danhcln/AIOT-BLACK-BOX/Hình ảnh minh họa.png

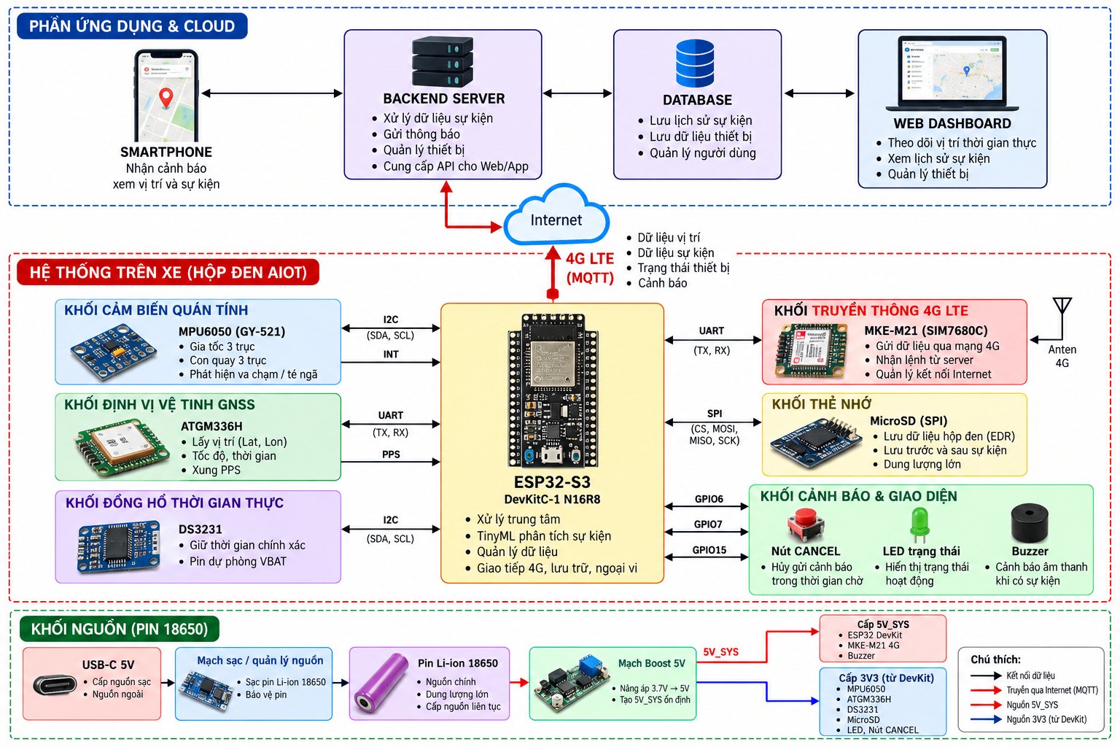
Hình ảnh minh họa.png
