danhcln/AIOT-BLACK-BOX/Hình ảnh linh kiện/Micro SD/1794204268884_198069978360956581_1780654779979847084_3c29c5070fa32b94e95acbb08c00777d.jpg

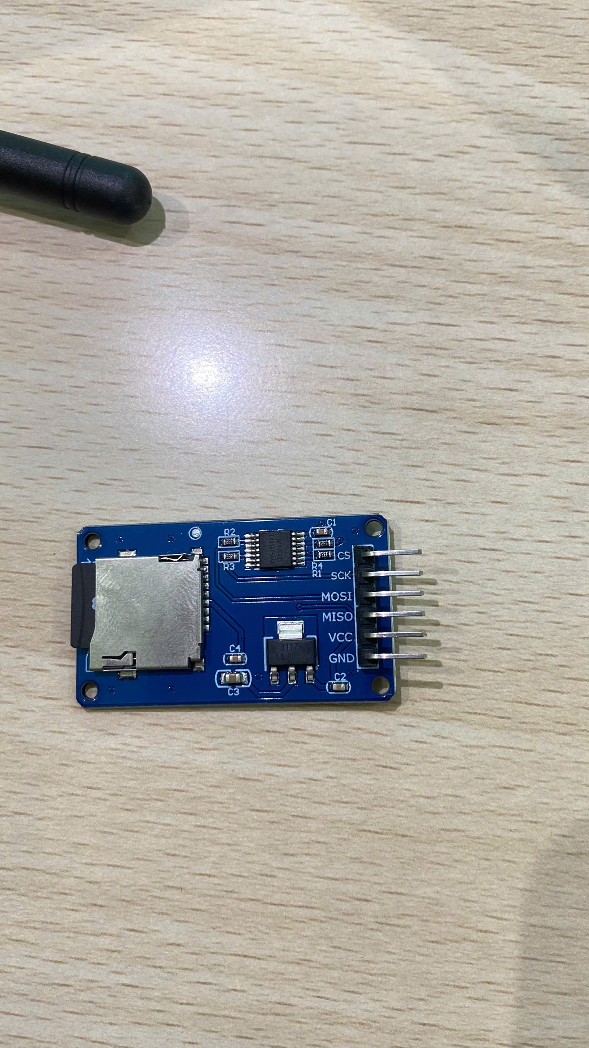
Hình ảnh linh kiện/Micro SD/1794204268884_198069978360956581_1780654779979847084_3c29c5070fa32b94e95acbb08c00777d.jpg
