danhcln/AIOT-BLACK-BOX/PCB_AIOT_BLACKBOX/AIOT_BLACKBOX_MAINBOARD_REV1/GATE_3_ROUTING/DRC_ROUTING_REPORT.txt

** Drc report for AIOT_BLACKBOX_MAINBOARD_REV1.kicad_pcb **
** Created on 2026-11-10T17:07:30 **
** Report includes: Errors, Warnings, Exclusions **

** Found 5 DRC violations **
[silk_overlap]: Silkscreen clearance
    Rule: board setup constraints silk; warning
    @(124.0000 mm, 48.4000 mm): Segment of JMP5 on F.Silkscreen
    @(124.0000 mm, 46.0000 mm): Reference field of JMP5
[silk_over_copper]: Silkscreen clipped by solder mask
    Local override; warning
    @(126.0000 mm, 102.2000 mm): Rectangle on F.Silkscreen
    @(151.0000 mm, 111.6700 mm): PTH pad 1 [Net-(J1-MOSI)] of JMP1
[silk_over_copper]: Silkscreen clipped by solder mask
    Local override; warning
    @(146.5000 mm, 63.0000 mm): Reference field of R5
    @(145.0000 mm, 61.7300 mm): PTH pad 1 [Net-(U1-GPIO6)] of JMP3
[silk_over_copper]: Silkscreen clipped by solder mask
    Local override; warning
    @(96.0000 mm, 88.5000 mm): PCB text '[ZONE 4: IMU CENTER (MPU6050) +X UP / +Y LEFT]' on F.Silkscreen
    @(112.0000 mm, 88.4200 mm): PTH pad 2 [/I2C_SDA_GPIO8] of JMP4
[silk_over_copper]: Silkscreen clipped by solder mask
    Local override; warning
    @(104.0000 mm, 42.0000 mm): PCB text 'AIOT SMART BLACKBOX - MAINBOARD REV1 (1-LAYER B.Cu)' on F.Silkscreen
    @(124.0000 mm, 42.1900 mm): PTH pad 2 [Net-(U1-GPIO6)] of JMP5

** Found 18 unconnected pads **
[unconnected_items]: Missing connection between items
    Local override; error
    @(50.0000 mm, 40.0000 mm): Zone 'GND_COPPER_POUR_BCU' [GND] on B.Cu, priority 0
    @(50.0000 mm, 40.0000 mm): Zone 'GND_COPPER_POUR_BCU' [GND] on B.Cu, priority 0
[unconnected_items]: Missing connection between items
    Local override; error
    @(144.3500 mm, 104.0000 mm): PTH pad 6 [GND] of J1
    @(50.0000 mm, 40.0000 mm): Zone 'GND_COPPER_POUR_BCU' [GND] on B.Cu, priority 0
[unconnected_items]: Missing connection between items
    Local override; error
    @(50.0000 mm, 40.0000 mm): Zone 'GND_COPPER_POUR_BCU' [GND] on B.Cu, priority 0
    @(50.0000 mm, 40.0000 mm): Zone 'GND_COPPER_POUR_BCU' [GND] on B.Cu, priority 0
[unconnected_items]: Missing connection between items
    Local override; error
    @(151.0000 mm, 98.9700 mm): Track [Net-(J1-MOSI)] on B.Cu, length 6.3000 mm
    @(136.7300 mm, 111.6700 mm): Track [Net-(J1-MOSI)] on B.Cu, length 14.2700 mm
[unconnected_items]: Missing connection between items
    Local override; error
    @(139.2700 mm, 104.0000 mm): PTH pad 4 [Net-(J1-MISO)] of J1
    @(157.3000 mm, 104.0500 mm): PTH pad 19 [Net-(J1-MISO)] of U1
[unconnected_items]: Missing connection between items
    Local override; error
    @(94.7300 mm, 96.0000 mm): PTH pad 4 [/I2C_SDA_GPIO8] of U2
    @(112.0000 mm, 98.5800 mm): PTH pad 1 [/I2C_SDA_GPIO8] of JMP4
[unconnected_items]: Missing connection between items
    Local override; error
    @(94.7300 mm, 96.0000 mm): PTH pad 4 [/I2C_SDA_GPIO8] of U2
    @(69.2700 mm, 100.0000 mm): PTH pad 4 [/I2C_SDA_GPIO8] of U3
[unconnected_items]: Missing connection between items
    Local override; error
    @(105.8100 mm, 116.5000 mm): PTH pad 4 [/I2C_SDA_GPIO8] of U7
    @(112.0000 mm, 98.5800 mm): PTH pad 1 [/I2C_SDA_GPIO8] of JMP4
[unconnected_items]: Missing connection between items
    Local override; error
    @(112.0000 mm, 88.5000 mm): Track [/I2C_SDA_GPIO8] on B.Cu, length 33.0800 mm
    @(112.0000 mm, 98.5800 mm): PTH pad 1 [/I2C_SDA_GPIO8] of JMP4
[unconnected_items]: Missing connection between items
    Local override; error
    @(75.4600 mm, 78.5000 mm): Track [3V3_SYS] on B.Cu, length 6.0000 mm
    @(71.8100 mm, 100.0000 mm): PTH pad 5 [3V3_SYS] of U3
[unconnected_items]: Missing connection between items
    Local override; error
    @(81.0000 mm, 70.0000 mm): Track [3V3_SYS] on B.Cu, length 8.1900 mm
    @(81.0000 mm, 54.1900 mm): Track [3V3_SYS] on B.Cu, length 6.6900 mm
[unconnected_items]: Missing connection between items
    Local override; error
    @(87.1100 mm, 96.0000 mm): PTH pad 1 [3V3_SYS] of U2
    @(102.3500 mm, 96.0000 mm): PTH pad 7 [3V3_SYS] of U2
[unconnected_items]: Missing connection between items
    Local override; error
    @(87.1100 mm, 96.0000 mm): PTH pad 1 [3V3_SYS] of U2
    @(71.8100 mm, 100.0000 mm): PTH pad 5 [3V3_SYS] of U3
[unconnected_items]: Missing connection between items
    Local override; error
    @(134.9200 mm, 93.5000 mm): PTH pad 1 [3V3_SYS] of R_PU2
    @(134.9200 mm, 84.5000 mm): Track [3V3_SYS] on B.Cu, length 2.0000 mm
[unconnected_items]: Missing connection between items
    Local override; error
    @(92.1900 mm, 96.0000 mm): Track [/I2C_SCL_GPIO9] on B.Cu, length 4.5000 mm
    @(66.7300 mm, 100.0000 mm): PTH pad 3 [/I2C_SCL_GPIO9] of U3
[unconnected_items]: Missing connection between items
    Local override; error
    @(103.2700 mm, 116.5000 mm): PTH pad 3 [/I2C_SCL_GPIO9] of U7
    @(92.1900 mm, 96.0000 mm): Track [/I2C_SCL_GPIO9] on B.Cu, length 4.5000 mm
[unconnected_items]: Missing connection between items
    Local override; error
    @(124.0000 mm, 42.1900 mm): Track [Net-(U1-GPIO6)] on B.Cu, length 21.0000 mm
    @(121.0800 mm, 49.8100 mm): Track [Net-(U1-GPIO6)] on B.Cu, length 2.9200 mm
[unconnected_items]: Missing connection between items
    Local override; error
    @(145.0000 mm, 42.1900 mm): Track [Net-(U1-GPIO6)] on B.Cu, length 11.9200 mm
    @(145.0000 mm, 61.7300 mm): Track [Net-(U1-GPIO6)] on B.Cu, length 9.3000 mm

** Found 0 Footprint errors **

** Ignored checks **
    - Footprint has no courtyard defined
    - Track endpoint not centered on via
    - Tuning profile track geometries
    - Footprint doesn't match symbol's footprint filters
    - Footprint component type doesn't match footprint pads

** End of Report **
