danhcln/AIOT-BLACK-BOX/.agents/skills/code-reviewer/SKILL.md

---
name: code-reviewer
description: Senior engineering review and regression specialist for KiCad schematics and hardware projects. Compares before vs after states, verifies blast radius containment, protects critical domains (GPIO mapping, power rails, I2C/SPI/UART buses, UI circuits), applies confidence-based filtering, and prevents regression defects.
metadata:
  origin: ECC
---

# code-reviewer — Schematic Engineering & Regression Review

Senior engineering review specialist adapted from ECC `agents/code-reviewer.md` and `rules/common/code-review.md` for KiCad schematic designs.

## Core Purpose
Ensure that any schematic change is clean, contained, electrically sound, and strictly free from regressions in protected circuit blocks.

## When to Use
- As the final review stage for **major revisions (e.g. REV8)**: `planner` → modification → `verification-loop` → `code-reviewer`
- Immediately after applying any complex refactoring or layout adjustment
- When reviewing a diff or commit involving hardware files

## Review Process

### 1. Gather Context
- Identify the baseline state (Git commit or pre-modification backup file).
- Inspect the diff between the baseline and the modified `.kicad_sch` or python builder script.

### 2. Verify Scope Containment
- Confirm that only the explicitly requested components, wires, or labels were touched.
- Ensure no accidental symbol movement occurred due to box drag or unintended mouse clicks in GUI.

### 3. Check Protected Domains (Zero-Regression Policy)
Strictly audit these 8 critical domains for unintended modifications:
1. **ESP32-S3 GPIO Mapping**: Confirm no pin reassignment occurred unless explicitly requested.
2. **Power Architecture**:
   - `VBAT`: 18650 Li-ion battery rail / PRIMARY POWER SOURCE
   - `VBUS`: External USB-C charging/input source (NOT primary operating power)
   - `5V_SYS`: Regulated 5V system rail (MUST NOT be renamed to `+5V`; MUST NOT be merged with `VBUS`)
   - `3V3_SYS`: Regulated 3.3V peripheral/logic rail (MUST NOT be powered from ESP32 DevKit onboard regulator; ESP32 is a load, not a distributor)
   - `GND`: Common ground return
3. **Battery ADC Sense**:
   - `GPIO1 = ADC_VBAT_SENSE`: Verify connection and divider network intact. Do NOT invent generic ADC channels.
4. **I2C Bus**: Ensure `SDA` and `SCL` lines and pull-up resistors are intact.
5. **SPI Bus**: Verify `MOSI`, `MISO`, `SCK`, and `CS` lines maintain correct routing and levels.
6. **UART Interface**: Confirm `TX`/`RX` directionality and connections.
7. **User Interface (UI)**: Confirm OLED display, pushbuttons, status LEDs, and buzzer circuits are unaffected.
8. **Drawing Layout**: Ensure A4 sheet frame, margins, and title block information remain intact and uncorrupted.

### 4. Confidence-Based Filtering
To keep reviews focused, actionable, and noise-free:
- **Cite exact locations**: Reference specific symbol designators (e.g. `U1`, `R12`, `J3`) or pin coordinates.
- **Describe concrete failure modes**: State what will happen electrically or visually.
- **Require proof for HIGH/CRITICAL issues**: Never speculate on hypothetical faults without evidence.
- **Clean reviews return zero findings**: If the change is minimal, correct, and non-regressive, report `APPROVE` with zero manufactured nitpicks.
