danhcln/AIOT-BLACK-BOX/PCB_AIOT_BLACKBOX/AIOT_BLACKBOX_MAINBOARD_REV1/GATE_0_AUDIT/GATE_0_SUMMARY.md

# TỔNG KẾT GATE 0: ĐỒNG BỘ FIRMWARE & SCHEMATIC (`GATE_0_SUMMARY.md`)

- **Trạng thái Gate 0:** **`PASS (0 Errors, 0 Warnings)`**
- **Schematic chính thức:** `AIOT_BLACKBOX_MAINBOARD_REV1.kicad_sch`
- **Firmware chuẩn:** `D:\ĐỒ ÁN 2
ilecodemain.cpp` (Giữ nguyên 100%)
- **Kết quả đạt được:**
  1. Đã giải quyết triệt để xung đột `GPIO10` (`SD_CS`) và `GPIO15` (`SIM_RX`).
  2. Đã đồng bộ tên module 4G thành **`A7680C`** và nối nguồn **`5V_SYS → SIM_PWR → VCC breakout A7680C`** kèm tụ lọc `C3 (470µF)` + `C4 (100nF)` và 4 điểm đo `TP_5V`, `TP_3V3`, `TP_SIM_PWR`, `TP_GND`.
  3. Đã chốt nguồn `MicroSD Breakout` (`J1` Pin 5 `VCC`) nối vào **`5V_SYS`**.
  4. Đã khóa phần cứng 3 mạch dự phòng: **`BUZZER_CTRL = GPIO5`** (có `R6 = 10kΩ R_BE`), **`CANCEL_BUTTON = GPIO6`**, **`LED_STATUS = GPIO7`**.
  5. Kiểm tra ERC bằng `kicad-cli`: **`0 Errors, 0 Warnings`**.
