danhcln/AIOT-BLACK-BOX/PCB_AIOT_BLACKBOX/AIOT_BLACKBOX_MAINBOARD_REV1/GATE_1_FOOTPRINT/GATE_1_FINAL_REVIEW.md

# BÁO CÁO TỔNG KẾT GATE 1 & GATE 1.5 SAU KHI CHỐT PHẦN CỨNG (`GATE_1_FINAL_REVIEW.md`)

**Trạng thái:** **`PASS 100% — ĐỦ ĐIỀU KIỆN BƯỚC SANG GATE 2 (PLACEMENT PCB 1 LỚP B.Cu)`**

---

## 1. KẾT QUẢ XÁC MINH & KHÓA TOÀN BỘ FOOTPRINT
1. **`ESP32-S3 N16R8` (`U1`):**
   - Đã khóa chính thức footprint **`AIOT_Blackbox_Local:ESP32_S3_N16R8_Socket_2x22_P2.54mm_Row25.40mm_SingleLayer`** với khoảng cách hai hàng chân **`25.40 mm` (`1000 mil`)**, pitch dọc **`2.54 mm`**, gồm `44` pad xuyên lỗ (`2.20 × 1.60 mm`, lỗ khoan `1.00 mm`).
   - Đánh số pad **Top-to-Bottom** (`1..22` hàng trái, `23..44` hàng phải) khớp tuyệt đối với Symbol `U1` và silkscreen bo thực tế.
   - Đã xóa bỏ hoàn toàn footprint `22.86 mm` khỏi thư viện `AIOT_Blackbox_Local.pretty`.
   - Đã cập nhật bản in thử tỷ lệ 1:1 tại `GATE_1_FOOTPRINT\ESP32_S3_FOOTPRINT_1TO1_CHECK.pdf`.
2. **Nguồn `MicroSD Breakout` (`J1`):**
   - Đã chốt cấp **`5V_SYS → Pin 5 (VCC)`**, `GND → Pin 6 (GND)`.
3. **Module 4G LTE `A7680C` (`U5`):**
   - Đã đồng bộ tên **`A7680C`** trên toàn bộ Schematic, Symbol, Footprint, BOM và báo cáo.
   - Đã chốt cấp nguồn **`5V_SYS → J3 (SIM_PWR_BRANCH) → SIM_PWR → U5 Pin 1 (VCC)`** kèm tụ bù dòng đỉnh **`C3 = 470µF` (Low-ESR)** + **`C4 = 100nF`** và điểm đo **`TP3 (TP_SIM_PWR)`**.
4. **Mạch dự phòng `BUZZER`, `CANCEL`, `LED_STATUS`:**
   - Đã khóa trên schematic và netlist: **`GPIO5 = BUZZER_CTRL`** (qua `R5 = 1kΩ`, `Q1 = 2SC1815`, bổ sung điện trở kéo xuống **`R6 = 10kΩ` (`R_BE`)** từ Base xuống `GND`), **`GPIO6 = CANCEL_BUTTON`**, **`GPIO7 = LED_STATUS`**.
   - Giữ nguyên `filecodemain.cpp` không sửa đổi.
5. **Kiểm tra ERC & Netlist (`kicad-cli`):**
   - **ERC:** **`0 Errors, 0 Warnings`**.
   - **Netlist:** **`Exit Code = 0, 0 Warnings`**, toàn bộ linh kiện đã gán đầy đủ footprint thuộc `AIOT_Blackbox_Local.pretty`.
