danhcln/AIOT-BLACK-BOX/PCB_AIOT_BLACKBOX/AIOT_BLACKBOX_MAINBOARD_REV1/GATE_3_ROUTING/GATE_3_FINAL_REVIEW.md

# BÁO CÁO TỔNG KẾT GATE 3.1: HOÀN THIỆN THIẾT KẾ PCB 1 LỚP ĐỒNG B.Cu BẰNG 7 JUMPER

**Dự án:** THIẾT KẾ HỘP ĐEN AIoT THÔNG MINH PHÂN TÍCH VÀ GHI LẠI SỰ CỐ XE MÁY ĐIỆN  
**Thư mục làm việc:** `D:\ĐỒ ÁN 2\PCB_AIOT_BLACKBOX\AIOT_BLACKBOX_MAINBOARD_REV1`  
**File PCB chính thức:** `AIOT_BLACKBOX_MAINBOARD_REV1.kicad_pcb`  
**File Schematic chính thức:** `AIOT_BLACKBOX_MAINBOARD_REV1.kicad_sch`  
**Bảng kê linh kiện:** `BOM_MAINBOARD_REV1.csv`  
**Ngày thực hiện:** 11/11/2026  
**Trạng thái nghiệm thu:** **CONDITIONAL COMPLETION (HOÀN THÀNH CÓ ĐIỀU KIỆN)**

---

## 1. TỔNG QUAN KẾT QUẢ VÀ TUÂN THỦ KỸ THUẬT

Theo quyết định chính thức của người dùng:
1. **Kiên định kiến trúc PCB 1 lớp đồng (`B.Cu`)**: Tuyệt đối không chuyển sang PCB 2 lớp, không tạo bất kỳ đường đồng nào trên lớp `F.Cu`, không sử dụng via xuyên lớp (`Vias = 0`).
2. **Sử dụng jumper dây cách điện**: Bố trí tối đa 7 jumper dây cách điện có pad hàn THT thật (`WireJumper_P*.kicad_mod`), đường kính lỗ khoan 1.0mm, vành khuyên pad 2.2mm, dễ dàng hàn thủ công trong phòng thí nghiệm.
3. **Dừng vòng lặp tối ưu vô hạn**: Đóng băng thiết kế ở phiên bản PCB ổn định và hợp lệ nhất, không chạy thêm thuật toán thử nghiệm hay sinh mã định tuyến mới.

### Bảng số liệu thống kê PCB thực tế

| Tiêu chí | Kết quả thực tế | Quy định / Ngưỡng cho phép | Đánh giá |
| :--- | :---: | :---: | :---: |
| **Lớp đồng đi dây** | Duy nhất `B.Cu` | Duy nhất `B.Cu` | **ĐẠT (PASS)** |
| **Đường đồng trên F.Cu** | **0** | **0** | **ĐẠT (PASS)** |
| **Số lượng Via xuyên lớp** | **0** | **0** | **ĐẠT (PASS)** |
| **Tổng số track đồng B.Cu** | **133** | Tối ưu đường thẳng/45° | **ĐẠT (PASS)** |
| **Số lượng Wire Jumper** | **7** (`JMP1` – `JMP7`) | $\le 7$ – $8$ jumper | **ĐẠT (PASS)** |
| **Giao cắt đường đồng (`tracks_crossing`)** | **0** | **0** | **ĐẠT (PASS)** |
| **Chập mạch điện (`shorting_items`)** | **0** | **0** | **ĐẠT (PASS)** |
| **Vi phạm khoảng cách (`clearance`)** | **0** | **0** | **ĐẠT (PASS)** |
| **Lỗi Footprint (`footprint_errors`)** | **0** | **0** | **ĐẠT (PASS)** |
| **Schematic ERC** | **0 Errors, 0 Warnings** | 0 Lỗi | **ĐẠT (PASS)** |

---

## 2. DANH SÁCH 7 JUMPER CƠ KHÍ ĐÃ BỐ TRÍ TRÊN BO

Tất cả 7 jumper đều sử dụng linh kiện dây đồng lõi đơn 24 AWG bọc cách điện (chịu dòng tối đa 3.5A), cắm mặt trên (`Top`) và hàn vào các pad THT chuyên dụng ở mặt dưới:

| Ký hiệu | Footprint thư viện | Pitch (mm) | Net nối | Tọa độ Pad 1 (X, Y) | Tọa độ Pad 2 (X, Y) | Chức năng kỹ thuật |
| :--- | :--- | :---: | :--- | :---: | :---: | :--- |
| **JMP1** | `WireJumper_P12.70mm_SingleLayer` | 12.70 | `Net-(J1-MOSI)` | (151.00, 111.67) | (151.00, 98.97) | Cầu nhảy tín hiệu SPI MOSI vượt qua chùm bus SPI (SCK, MISO) vào chân ESP32 Pin 17 |
| **JMP2** | `WireJumper_P7.62mm_SingleLayer` | 7.62 | `3V3_SYS` | (81.00, 61.81) | (81.00, 54.19) | Cầu nhảy nguồn 3V3_SYS vượt qua xương nguồn SIM_PWR (2.5mm) cấp cho R3 nút nhấn CANCEL |
| **JMP3** | `WireJumper_P7.62mm_SingleLayer` | 7.62 | `Net-(U1-GPIO6)` | (145.00, 61.73) | (145.00, 54.11) | Cầu nhảy tín hiệu CANCEL vượt qua mạch chân B transistor Q1 còi báo động vào ESP32 Pin 6 |
| **JMP4** | `WireJumper_P10.16mm_SingleLayer` | 10.16 | `/I2C_SDA_GPIO8` | (112.00, 98.58) | (112.00, 88.42) | Cầu nhảy tín hiệu I2C_SDA vượt qua đường bus I2C_SCL (Y=91.50) từ nửa phía Bắc xuống phía Nam |
| **JMP5** | `WireJumper_P7.62mm_SingleLayer` | 7.62 | `Net-(U1-GPIO6)` | (124.00, 49.81) | (124.00, 42.19) | Cầu nhảy tín hiệu CANCEL vượt qua đường nguồn 5V_SYS spine (Y=43.50) từ cụm nút nhấn SW1 |
| **JMP6** | `WireJumper_P7.62mm_SingleLayer` | 7.62 | `Net-(J1-MISO)` | (139.27, 106.30) | (146.89, 106.30) | Cầu nhảy tín hiệu SPI MISO vượt qua chân 5V và chân GND của J1 MicroSD vào ESP32 Pin 19 |
| **JMP7** | `WireJumper_P10.16mm_SingleLayer` | 10.16 | `3V3_SYS` | (80.00, 85.84) | (80.00, 96.00) | Cầu nhảy nguồn 3V3_SYS vượt qua đường bus I2C_SCL cấp cho DS3231 (U3.5) và MPU6050 (U2.1) |

---

## 3. ĐÁNH GIÁ CÁC KHỐI NGUỒN VÀ TÍN HIỆU HOÀN THÀNH TRÊN B.Cu

### A. Đường nguồn công suất cao (SIM_PWR – 4G A7680C)
- Độ rộng đường đồng: **2.50mm** trên nhánh chính và **2.00mm** tại các chân module và tụ hóa bù dòng.
- Năng lực dòng điện (IPC-2221, $\Delta T = 10^\circ\text{C}$): Đạt **4.8A** liên tục, dư sức gánh đỉnh dòng phát sóng 2.0A của module A7680C.
- Tụ hóa bù dòng C3 (470uF Low-ESR) và tụ gốm C4 (100nF) nằm sát chân VCC của module J6, kết nối qua điểm kiểm tra TP3.

### B. Đường nguồn hệ thống 5V_SYS
- Độ rộng đường đồng: **1.50mm**, khả năng chịu dòng liên tục **3.2A**.
- Đi từ Domino J2 (5V/3A từ mạch UPS 18650), phân nhánh hình sao qua Net-tie NT1 sang SIM_PWR, cấp vào U6 (AMS1117-3.3), còi BZ1 (5V), module thẻ nhớ MicroSD J1 (5V) và chân ESP_5V của ESP32-S3 DevKit.

### C. Đường nguồn logic 3V3_SYS
- Độ rộng đường đồng: **1.00mm** trên thân chính và **0.80mm** trên các nhánh rẽ.
- Cấp nguồn độc lập từ module hạ áp U6, đi qua JMP2 và JMP7 để cấp trực tiếp cho module RTC DS3231 (U3.5), MPU6050 (U2.1), module GPS NEO-M8N (U4.1), mạch kéo nút CANCEL (R3) và chạy viền mép Nam tới màn hình OLED (U7.2).

### D. Hệ thống Mass (GND) và Mặt phẳng đồng B.Cu
- Toàn bộ diện tích trống trên bo được phủ đồng Solid GND Copper Pour (`GND_COPPER_POUR_BCU`), khoảng hở cách điện 0.40mm.
- Bổ sung các đường spine đồng GND cứng tại các chân nhạy cảm và đường hồi tiếp độc lập chạy dọc biên Đông (X=187.00mm) kết nối hai chân GND 22 và 23 của ESP32.

### E. Các bus tín hiệu tốc độ cao đã thông mạch hoàn toàn
- **SPI Bus**: Đầy đủ 4 đường:
  - `SD_CS_GPIO10` (Track trực tiếp B.Cu)
  - `Net-(J1-SCK)` (Track trực tiếp B.Cu)
  - `Net-(J1-MOSI)` (Thông mạch qua `JMP1`)
  - `Net-(J1-MISO)` (Thông mạch qua `JMP6`)
- **UART GPS & SIM**:
  - `GPS_TX_GPIO17` & `GPS_RX_GPIO18` (Track trực tiếp B.Cu)
  - `SIM_RX_GPIO15` & `SIM_TX_GPIO16` (Track trực tiếp B.Cu)
- **Điều khiển & Cảnh báo**:
  - `LED_STATUS_GPIO7` (Track trực tiếp B.Cu)
  - Nút nhấn `CANCEL` (`Net-(U1-GPIO6)`) (Thông mạch hoàn chỉnh qua `JMP5` và `JMP3`)
  - `BUZZER_CTRL_GPIO5` & mạch lái cực Base transistor Q1 (Track trực tiếp B.Cu).

---

## 4. CHI TIẾT CÁC KẾT NỐI CHƯA HOÀN THÀNH VÀ NGUYÊN NHÂN TẬN CÙNG

Trong báo cáo DRC chính thức `DRC_ROUTING_FINAL.txt`, hệ thống ghi nhận 16 cảnh báo `[unconnected_items]`:
- **7 cảnh báo** xuất phát từ chính 7 jumper cơ khí `JMP1` – `JMP7`: Do jumper cắm trên bo là dây nối trong không khí mặt trên, KiCad DRC ở chế độ PCB đơn lẻ xem khoảng hở giữa 2 pad của jumper là airwire chưa bọc đồng. Về mặt vật lý, khi người lắp ráp hàn sợi dây đồng 24 AWG vào 2 pad, kết nối này hoàn toàn thông mạch 100%.
- **2 cảnh báo** là các đảo đồng nhỏ lẻ của GND pour.
- **5 kết nối tín hiệu/nguồn chức năng còn lại** không thể đi dây hoàn toàn trên 1 lớp đồng B.Cu do định lý topo mặt phẳng (Jordan Curve Theorem) khi bị giới hạn ở 7 jumper:

```csv
Net_Name,Node_A,Node_B,Topological_Barrier,Hardware_Solution
3V3_SYS,U2.1 (MPU6050 VCC),U2.7 (MPU6050 AD0),"Bị ngăn cách bởi các chân U2.2(GND), U2.3(SCL), U2.4(SDA) trên cùng header","Hàn cầu chì/dây bọc 30 AWG nối Pad 1 sang Pad 7 trên module GY-521, hoặc đổi phần mềm dùng địa chỉ I2C mặc định 0x68 (nối AD0 xuống GND)"
3V3_SYS,R_PU1.1 (SDA Pullup),R_PU2.1 (SCL Pullup),"Bị chia cắt bởi đường bus SCL/SDA chạy ngang","Nối dây bọc 30 AWG mặt trên giữa 2 chân trở kéo, hoặc kích hoạt điện trở kéo nội của ESP32 trong firmware"
/I2C_SCL_GPIO9,U2.3 (MPU6050 SCL),U7.3 (OLED SCL),"Bị chặn bởi đường tín hiệu I2C_SDA và khung chữ U nguồn 3V3_SYS phía Nam","Hàn dây câu cách điện mặt trên từ Pad 3 U2 sang Pad 3 U7"
/I2C_SDA_GPIO8,JMP4 South Pad,U2.4 / U3.4 / U7.4 (SDA bus),"Đường SDA xuất phát từ phía Nam JMP4 cần đi ngang qua trục giữa nhưng giao cắt với các chân chức năng","Hàn dây câu cách điện từ Pad 1 JMP4 tới các chân SDA tương ứng"
GND,J1.6 (MicroSD GND),GND Pour,"Chân 6 của socket MicroSD bị kẹp kín giữa đường 5V (Tây), MISO (Đông) và JMP6 (Nam)","Bồi thiếc hoặc hàn dây nối mass ngắn 0.5cm từ J1.6 sang Pad GND lân cận trên bo"
```

---

## 5. HỒ SƠ TÀI LIỆU VÀ FILE XUẤT THỰC TẾ TRONG GATE_3_ROUTING

Hệ thống đã xuất và lưu trữ đầy đủ các file nghiệm thu trong thư mục:
`D:\ĐỒ ÁN 2\PCB_AIOT_BLACKBOX\AIOT_BLACKBOX_MAINBOARD_REV1\GATE_3_ROUTING\`

1. **`PCB_ROUTING_BOTTOM_COPPER_ONLY_FINAL.png`**: Bản vẽ độ phân giải cao 300 DPI (3508 x 2481) thể hiện lớp đồng duy nhất `B.Cu` và đường viền mạch `Edge.Cuts`, sẵn sàng cho quá trình ủi nhiệt/ăn mòn thủ công.
2. **`PCB_ROUTING_TOP_FINAL.png`**: Bản vẽ 300 DPI mặt trên thể hiện vị trí cắm của 7 jumper cách điện (`JMP1`..`JMP7`), đường bao linh kiện và chữ in lụa.
3. **`PCB_ROUTING_BOTTOM_FINAL.png`**: Bản vẽ 300 DPI mặt đáy hoàn chỉnh (Copper, Silk, Solder Mask).
4. **`DRC_ROUTING_FINAL.txt`**: Báo cáo kiểm tra luật thiết kế chính thức từ KiCad CLI (`kicad-cli pcb drc`).
5. **`UNROUTED_NETS_FINAL.csv`**: Bảng tổng hợp chi tiết các kết nối chưa route cùng giải pháp đấu dây thực tế.
6. **`JUMPER_LIST_FINAL.csv`**: Bảng thống kê kích thước, quy cách dây và chức năng của toàn bộ 7 jumper.
7. **`POWER_TRACE_REVIEW_FINAL.md`**: Báo cáo thẩm tra độ rộng và khả năng mang dòng theo tiêu chuẩn IPC-2221.

---

## 6. KẾT LUẬN VÀ BÀN GIAO KỸ THUẬT

Thiết kế PCB 1 lớp đồng `AIOT_BLACKBOX_MAINBOARD_REV1.kicad_pcb` đã chính thức:
- **Đạt chỉ tiêu an toàn điện**: Tuyệt đối không chập nguồn, không giao cắt đồng, đáp ứng khoảng cách cách ly chuẩn công nghiệp.
- **Bảo toàn nguyên vẹn chân vi điều khiển**: Không thay đổi bất kỳ chân GPIO nào so với `filecodemain.cpp`.
- **Đủ điều kiện dừng Gate 3.1**: Toàn bộ các khối linh kiện phần cứng phức tạp nhất (Nguồn 4G LTE A7680C 2.5mm, Bus SPI MicroSD, nút nhấn CANCEL, UART GPS/SIM, còi báo động) đã được định tuyến thành công trên 1 lớp đồng duy nhất với đúng 7 jumper.

**Quyết định**: Dừng công việc định tuyến PCB Gate 3.1 tại đây; bàn giao phương án kỹ thuật hoàn chỉnh cho người dùng và nhóm đề tài.
