danhcln/AIOT-BLACK-BOX/Dinh_Huong_Nghien_Cuu.docx

BÁO CÁO ĐỊNH HƯỚNG NGHIÊN CỨU & ĐỀ XUẤT ĐỀ TÀI ĐỒ ÁN 2
THIẾT KẾ HỘP ĐEN AIoT THÔNG MINH PHÂN TÍCH VÀ TÁI HIỆN HIỆN TRƯỜNG TAI NẠN XE MÁY (EVENT DATA RECORDER)
AIoT Smart Black Box for Motorcycle Accident Analysis and Event Data Recording

Ngành đào tạo: | Công nghệ Kỹ thuật Máy tính / Điện tử - Viễn thông
Học phần: | Đồ án 2
Đơn vị: | Bộ môn Kỹ thuật Máy tính - Viễn thông, Khoa Điện - Điện tử
Định hướng công nghệ: | AIoT / TinyML / Edge AI & Internet of Things (Smart Mobility)

# 1. Bối cảnh và Tính cấp thiết của Đề tài

Hiện nay tại Việt Nam, xe máy là phương tiện giao thông cá nhân chủ đạo. Tuy nhiên, sau mỗi vụ tai nạn giao thông liên quan đến xe máy, công tác điều tra nguyên nhân, phân định trách nhiệm bảo hiểm cũng như truy xét các trường hợp va chạm rồi bỏ trốn (Hit-and-Run) gặp nhiều thách thức. Hiện trường tai nạn xe máy thường bị xáo trộn ngay lập tức, vết phanh mờ nhạt nhanh chóng và lời khai của các bên thường thiếu tính khách quan.

Các giải pháp cảnh báo tai nạn IoT truyền thống thường gặp hai hạn chế lớn:
• Phụ thuộc vào ngưỡng cơ học đơn thuần (if a > threshold): Dễ dẫn đến hàng ngàn báo động giả do rung lắc mặt đường, phanh gấp hoặc dừng đỗ xe.
• Không có khả năng lưu trữ viễn trắc trước va chạm: Không cung cấp được bằng chứng pháp y về hành vi người lái (tốc độ, lực phanh, góc nghiêng) trong khoảng thời gian then chốt ngay trước khi vụ tai nạn xảy ra.

Mục tiêu Đề tài: Chế tạo thiết bị Hộp đen AIoT thông minh (Event Data Recorder - EDR) cho xe máy, tuân thủ tiêu chuẩn IEEE 1616. Hệ thống duy trì bộ đệm tròn 30 giây dữ liệu viễn trắc (10s Trước, 5s Trong, 15s Sau va chạm), tính toán mã băm SHA-256 bảo vệ dữ liệu pháp lý và gửi cảnh báo khẩn cấp qua 4G LTE.

# 2. Mục tiêu và Phạm vi Nghiên cứu

## 2.1. Mục tiêu Tổng quát

Xây dựng thành công hệ thống Hộp đen EDR nhỏ gọn lắp đặt trên xe máy, có khả năng thu thập dữ liệu quán tính 6 trục (200Hz) và GPS (10Hz), thực thi thuật toán phát hiện va chạm thông minh tại biên (TinyML Trigger), tự động đóng băng bộ nhớ đệm PSRAM, lưu file log chống chỉnh sửa xuống thẻ MicroSD và phục dựng hiện trường trên Web App.

## 2.2. Phạm vi Thực hiện Đồ án 2

Hạng mục Nội dung | Yêu cầu Mức độ Hoàn thành
Thu thập Dữ liệu & PSRAM | Thiết lập thành công bộ đệm tròn (Circular FIFO) 30s trong 8MB PSRAM của ESP32-S3, thu thập IMU 200Hz, GPS 10Hz, RTC DS3231.
Thuật toán Kích hoạt (Trigger) | Xây dựng cơ chế phát hiện bất thường / va chạm (TinyML/G-Force Interrupt) để đóng băng bộ đệm (10s Pre, 5s Crash, 15s Post).
Lưu trữ & Bảo mật Chứng cứ | Ghi dữ liệu ra thẻ MicroSD (CSV/BIN), tính mã băm SHA-256 Checksum gắn vào file để bảo đảm tính toàn vẹn chứng cứ số.
Truyền tin Viễn thông 4G | Tích hợp module SIM7680C 4G LTE, phát tin nhắn SMS SOS chứa tọa độ GPS và vận tốc tức thời trong vòng 3 giây; upload file log lên Cloud.
Phần mềm Phục dựng Hiện trường | Xây dựng Web Dashboard tiếp nhận file log, vẽ biểu đồ viễn trắc (vận tốc, phanh, góc lật) và mô phỏng 3D hiện trường vụ tai nạn (WebGL/Three.js).

# 3. Kiến trúc Hệ thống và Giải pháp Kỹ thuật

## 3.1. Sơ đồ Luồng Dữ liệu (Data Flow Pipeline)

Cảm biến IMU 6-axis (200Hz) + GPS NEO-M8N (10Hz) + RTC DS3231
↓ (I2C / UART / SPI)
Bộ quản lý Bộ đệm tròn (Circular FIFO Buffer 30s trong 8MB PSRAM)
↓ (Cơ chế Đánh giá Rủi ro / Edge Inference)
Phân hệ Kích hoạt Sự kiện (TinyML Anomaly Trigger / Impact Interrupt)
↓ (Khóa Dữ liệu & Đóng băng 10s Trước - 5s Trong - 15s Sau)
Ghi File Pháp y xuống Thẻ MicroSD + Mã hóa SHA-256 Checksum
↓ (UART AT-Commands)
Module 4G LTE SIM7680C (Gửi SMS SOS khẩn cấp + Upload Cloud)
↓ (REST API / MQTT / WebGL)
Web App Phục dựng Hiện trường (Hiển thị Đồ thị Viễn trắc & Mô phỏng 3D)

## 3.2. Linh kiện Phần cứng Cốt lõi

Khối Chức năng | Linh kiện Đề xuất | Vai trò Kỹ thuật
Vi xử lý Biên | ESP32-S3-WROOM-1 (8MB PSRAM) | Quản trị mảng bộ đệm tròn, chạy AIoT Trigger, tính mã băm SHA-256.
Cảm biến Quán tính | ICM-42688-P / ADXL375 | Đo gia tốc & vận tốc góc tần số cao 200Hz, dải đo rộng ±16g/±30g.
Định vị Vệ tinh | NEO-M8N GPS | Đo vị trí (kinh/vĩ độ), tốc độ di chuyển thực tế với tần số 10Hz.
Thời gian Thực | DS3231 RTC | Đảm bảo mốc thời gian (Timestamp) chính xác mili-giây cho dữ liệu pháp y.
Lưu trữ Bền vững | MicroSD (SD_MMC / SPI) | Lưu trữ file log sự kiện tai nạn (.CSV/.BIN) lâu dài.
Truyền thông 4G | SIM7680C 4G LTE Cat-1 | Phát tín hiệu cảnh báo khẩn cấp SMS và đẩy file log lên Cloud.
Nguồn Dự phòng | Mạch Siêu tụ / Pin LiPo Backup | Cấp nguồn duy trì 5s cuối để hoàn tất đóng file khi xe mất điện chính.

# 4. Kế hoạch và Lộ trình Triển khai Đồ án 2

Giai đoạn | Thời gian | Nhiệm vụ Cụ thể & Sản phẩm Đạt được
Giai đoạn 1 | Tuần 1 - 3 | Nghiên cứu tổng quan, mua sắm linh kiện, thiết kế sơ đồ nguyên lý và vẽ PCB phần cứng.
Giai đoạn 2 | Tuần 4 - 6 | Lập trình driver đọc IMU (200Hz), GPS (10Hz), thiết lập bộ đệm tròn Circular Buffer trong PSRAM.
Giai đoạn 3 | Tuần 7 - 8 | Phát triển thuật toán TinyML Anomaly Trigger, đóng băng bộ đệm và ghi file mã hóa SHA-256.
Giai đoạn 4 | Tuần 9 - 10 | Tích hợp module 4G SIM7680C, lập trình gửi SMS SOS và upload file log lên Server Firebase/Cloud.
Giai đoạn 5 | Tuần 11 - 12 | Xây dựng Web App phục dựng 3D, thử nghiệm thực tế trên phương tiện, hoàn thiện báo cáo Đồ án 2.

# 5. Định hướng Mở rộng cho Khóa luận Tốt nghiệp

Sau khi hoàn thiện phiên bản Hộp đen EDR cơ bản trong Đồ án 2, đề tài được định hướng phát triển chuyên sâu thành Khóa luận Tốt nghiệp với 02 phân hệ nâng cao:

1. Tích hợp Ghi hình Video Đồng bộ (Video Black Box): Gắn camera kép OV2640/OV5640 trước và sau xe, ghi đè luồng video H.264 đồng bộ chính xác từng khung hình với chuỗi dữ liệu quán tính IMU và vị trí GPS.

2. Kết nối Cổng Chẩn đoán Xe máy OBD-II: Giao tiếp trực tiếp với bộ điều khiển động cơ (ECU) của xe máy để trích xuất các thông số vận hành chuyên sâu như vị trí bướm ga (TPS), tốc độ vòng tua máy (RPM), áp suất phanh dầu ABS và trạng thái đèn xi-nhan.

Báo cáo Định hướng Nghiên cứu - Đồ án 2 | Trang 1
