danhcln/AIOT-BLACK-BOX/THIET_KE_KHOI_NGUON/BAO_CAO_THIET_KE_KHOI_NGUON_AIOT.docx

BÁO CÁO PHƯƠNG ÁN THIẾT KẾ KHỐI NGUỒN CHO HỆ THỐNG HỘP ĐEN AIOT XE MÁY ĐIỆN

ĐỀ TÀI: THIẾT KẾ HỘP ĐEN AIOT THÔNG MINH PHÂN TÍCH VÀ GHI LẠI SỰ CỐ XE MÁY ĐIỆN

Sinh viên thực hiện: 1. NGUYỄN LÊ CÔNG DANH – 23161240 2. PHẠM TRẦN HUY – 21161131 | Giảng viên hướng dẫn: THS. NGUYỄN NGÔ LÂM

Dự án phần cứng KiCad: AIOT_BLACKBOX_POWER_SUPPLY | Ngày lập: 19/10/2026

1. YÊU CẦU THIẾT KẾ KHỐI NGUỒN

Hệ thống Hộp đen AIoT trên xe máy điện là thiết bị an toàn chủ động, đảm nhiệm chức năng thu thập dữ liệu cảm biến đa chiều (quán tính 6-DoF, tọa độ GPS, thời gian thực RTC), ghi liên tục vào thẻ nhớ MicroSD và gửi cảnh báo khẩn cấp kèm vị trí qua mạng di động 4G LTE khi xảy ra sự cố va chạm hoặc đổ ngã xe. Hệ thống bao gồm nhiều khối phần cứng có nhu cầu điện áp và đặc tính dòng điện rất khác nhau: vi điều khiển ESP32-S3 DevKitC-1 N16R8 (nguồn 5V, dòng đỉnh 500mA khi kích hoạt Wi-Fi/BLE), module 4G LTE A7682S (tải xung dòng cực đại 2.0A khi phát sóng RF), module GPS NEO-M8N (3.3V, 65mA), cảm biến quán tính MPU6050 (3.3V, 5mA), mạch thời gian thực DS3231 (3.3V, 1.5mA), màn hình OLED 0.96 inch (3.3V, 30mA), thẻ nhớ MicroSD SPI (3.3V/5V, dòng đỉnh 100mA khi ghi flash) và còi báo buzzer 5V (40mA).

Để đảm bảo hộp đen ghi lại trọn vẹn dữ liệu sự cố ngay cả khi tai nạn làm đứt dây hoặc mất nguồn điện chính từ xe, khối nguồn bắt buộc phải đáp ứng 4 yêu cầu cốt lõi: (1) Duy trì nguồn không gián đoạn (UPS): Tự động kích hoạt pin Li-ion 18650 dự phòng khi mất điện xe, ngăn sụt áp gây Brownout reset vi điều khiển hoặc lỗi file thẻ nhớ; (2) Đa nguồn đầu vào linh hoạt: Nhận nguồn sơ cấp từ ắc quy xe (48V-72V DC qua bộ hạ áp 5V) và hỗ trợ cổng sạc USB-C 5V; (3) Quản lý sạc & bảo vệ pin an toàn: Tích hợp thuật toán sạc CC/CV, quản lý Power-Path/NVDC và bảo vệ quá sạc, quá xả, ngắn mạch; (4) Đáp ứng tải xung dòng 4G: Cung cấp đủ năng lượng cho xung phát RF 2.0A mà không làm sụt áp lan truyền sang ESP32 và cảm biến.

Bảng 1. Nhu cầu điện áp, dòng điện và đường nguồn của các tải trong hệ thống

STT | Thiết bị / Module tải | Điện áp cấp | Dòng điện ước tính | Đường nguồn | Tình trạng dữ liệu
1 | ESP32-S3 DevKitC-1 N16R8 | 5.0V (chân 5V) | 500mA (Peak Wi-Fi/RF) | 5V_SYS | Đã xác minh datasheet
2 | Module 4G LTE A7682S | Chờ đo chân VCC | 2.0A (Pulse burst 577µs) | SIM_PWR | Chưa xác minh áp VCC
3 | GPS NEO-M8N Breakout | 3.3V (chân VCC) | 65mA (Tracking liên tục) | 3V3_SYS | Đã xác minh datasheet
4 | Cảm biến 6-DoF MPU6050 | 3.3V (chân VCC) | 5mA (Đo gia tốc & góc) | 3V3_SYS | Đã xác minh datasheet
5 | Mạch thời gian thực DS3231 | 3.3V (chân VCC) | 1.5mA (Giao tiếp I2C) | 3V3_SYS | Đã xác minh datasheet
6 | Màn hình OLED 0.96 inch | 3.3V (chân VCC) | 30mA (Hiển thị pixel) | 3V3_SYS | Đã xác minh thực tế
7 | Module thẻ nhớ MicroSD SPI | 3.3V hoặc 5.0V | 100mA (Flash write surge) | 5V_SYS / 3V3_SYS | Ước tính dòng ghi thẻ
8 | Còi Buzzer 5V & LED báo | 5.0V (chân VCC) | 40mA (Báo động sự cố) | 5V_SYS | Đã xác minh thực tế

2. PHƯƠNG ÁN THIẾT KẾ VÀ SƠ ĐỒ KHỐI NGUỒN

2.1. Kiến trúc cấp nguồn hệ thống

Khối nguồn được phân tầng mạch lạc thành 5 miền nguồn độc lập: VBUS_MUX (sau mạch chọn nguồn tự động), VBAT (3.0V - 4.2V cell pin 18650), SYS (3.5V - 4.4V sau quản lý NVDC), 5V_SYS (5.00V / 3.5A cấp cho vi điều khiển và tải động lực) và 3V3_SYS (3.30V / 1.0A cấp cho cảm biến nhạy cảm). Tuyệt đối không nhập chung các đường nguồn này.

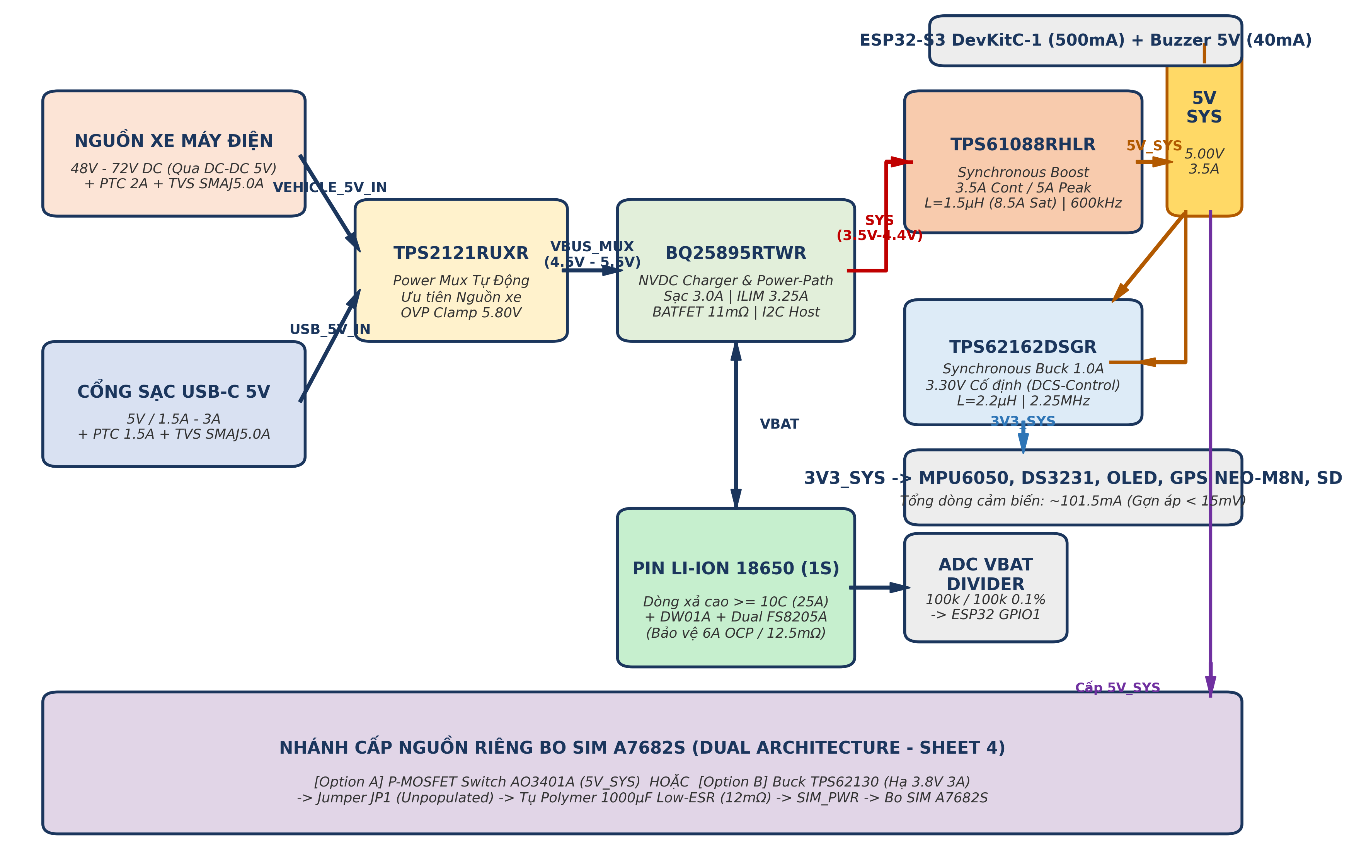
[picture p87: figure]

Hình 1. Sơ đồ khối kiến trúc phân phối nguồn toàn hệ thống AIoT Black Box

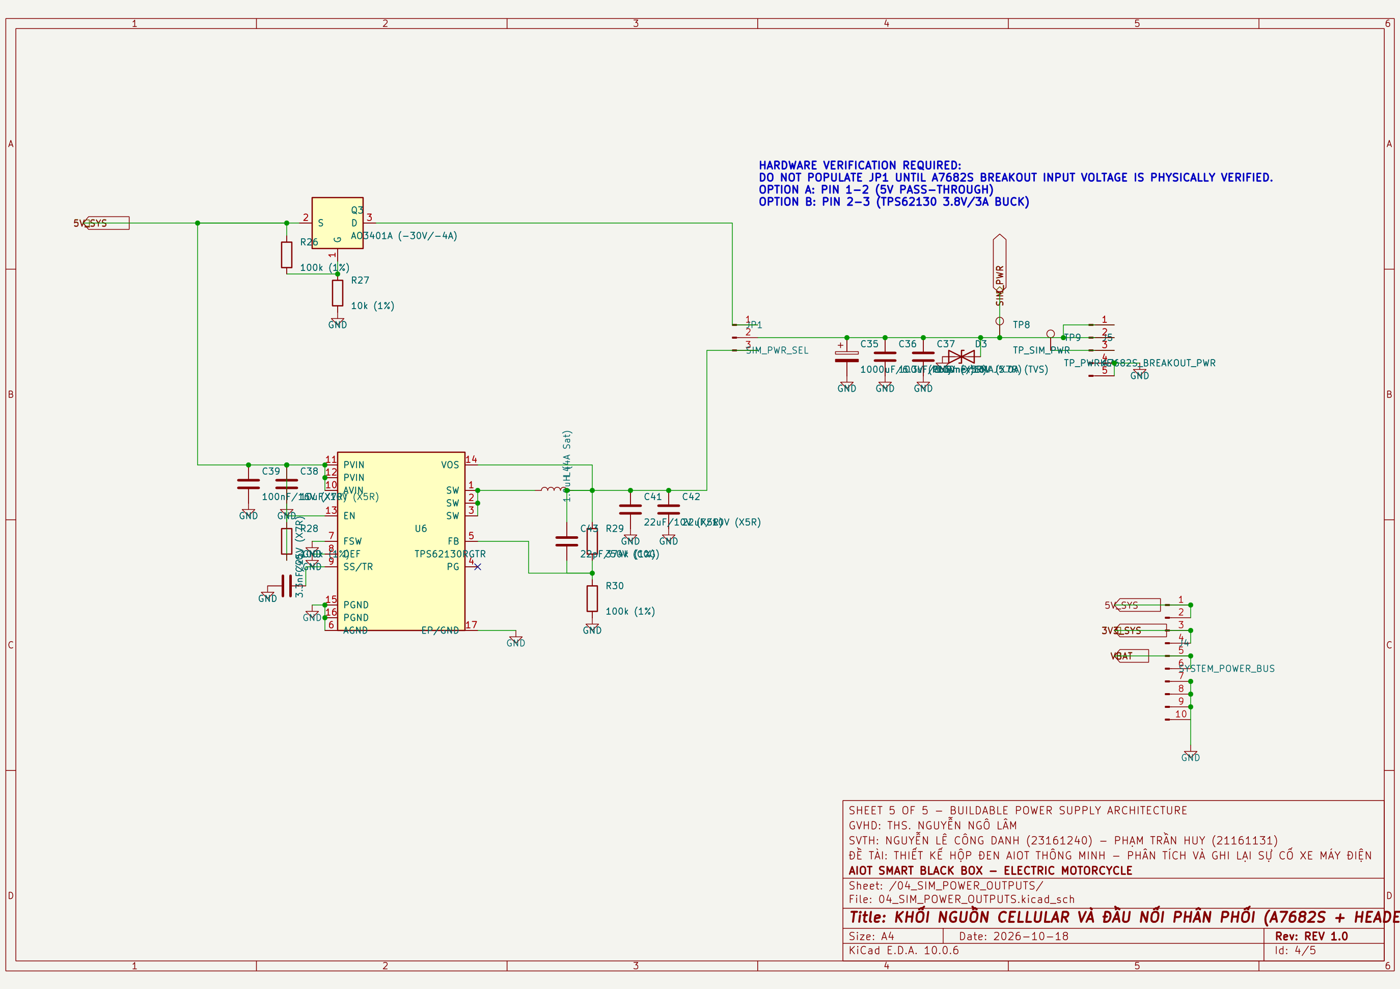
[picture p88: figure]

Hình 2. Sơ đồ nguyên lý mạch tạo nguồn 5V_SYS (TPS61088) và 3V3_SYS (TPS62162) trong KiCad

2.2. Chức năng các bộ phận chính

Bảng 2. Chức năng kỹ thuật và lý do lựa chọn các linh kiện nguồn chính

Thành phần / IC | Thông số điện áp & dòng | Chức năng trong khối nguồn | Lý do lựa chọn kỹ thuật
TPS2121RUXR (TI) | VIN: 2.7V - 22V IOUT: 4.5A continuous RDS(on): 56mΩ | Power Mux 2 ngõ vào: Ưu tiên nguồn xe (VEHICLE_5V_IN) so với USB_5V_IN. | Chuyển mạch <5µs chống sụt áp; chống dẫn ngược và bảo vệ OVP 5.80V.
BQ25895RTWR (TI) | VIN: 3.9V - 14V (22V max) Isạc: 3.0A | ILIM: 3.25A BATFET: 11mΩ | Sạc 1S Li-ion và quản lý NVDC Power-Path; cấp nguồn ra đường SYS nuôi hệ thống. | Cấu trúc NVDC ưu tiên tải SYS trước sạc; tự xả pin bù tải khi quá dòng; chạy tự chủ.
Pin 18650 & BMS (DW01A + Dual FS8205A) | Cell 1S: 3.7V, ≥2500mAh Xả liên tục: ≥10C (25A) OCP: 6.0A cont / 12A peak | Lưu trữ dự phòng khi mất điện xe; bảo vệ quá sạc (4.3V), quá xả (2.4V), quá dòng. | Mắc song song 2 IC FS8205A giảm trở dẫn còn 12.5mΩ, sụt áp <63mV ở tải đỉnh 5.04A.
TPS61088RHLR (TI) | VIN: 2.7V - 12V VOUT: 5.00V / 3.5A cont Khóa FET: 19mΩ / 12mΩ | Tăng áp đồng bộ từ đường SYS (3.0V - 4.2V) lên 5V_SYS cấp ESP32 và tải 5V. | Dòng công tắc cực đại 11.9A; hiệu suất >91%, đủ tải 2.74A khi pin cạn 3.0V.
TPS62162DSGR (TI) | VIN: 3.0V - 17V VOUT: 3.30V cố định IOUT: 1.0A continuous | Hạ áp đồng bộ từ 5V_SYS xuống 3V3_SYS cấp cho toàn bộ logic cảm biến. | Ngõ ra 3.3V cố định triệt tiêu sai số trở; DCS-Control giảm gợn áp (<15mV).
Nhánh nguồn SIM (Option A / B) | Opt A: 5V (AO3401A) Opt B: 3.8V (TPS62130) IOUT: 3.0A | Tụ: 1000µF | Cấp nguồn riêng module 4G A7682S; đệm năng lượng hấp thụ xung phát RF 2.0A. | Thiết kế lưỡng phân qua Jumper JP1: Chưa hàn nối khi chưa đo kiểm VCC bo SIM.
Bảo vệ & Lọc nguồn (PTC, TVS, Tụ) | PTC: 2.0A & 1.5A TVS: SMAJ5.0A (400W) Tụ: 1000µF/6.3V (12mΩ) | Triệt tiêu xung điện xe máy; chống quá dòng ngõ vào và đệm xung RF bo SIM. | Bảo vệ đa tầng: Cầu chì tự phục hồi PTC ngắt chập; TVS kẹp cao áp; tụ polymer đệm xung.

2.3. Nguyên lý hoạt động và chuyển mạch nguồn

Khối nguồn vận hành linh hoạt theo ba trạng thái cấp nguồn chính: (1) Nguồn xe: Điện áp xe qua DC-DC hạ xuống 5V cấp vào VEHICLE_5V_IN, TPS2121 tự động ưu tiên đóng mạch vào VBUS_MUX. BQ25895 sạc pin 18650 đồng thời cấp đường SYS (4.4V). TPS61088 tạo 5V_SYS và TPS62162 tạo 3V3_SYS nuôi hệ thống; (2) Nguồn USB-C: Khi cắm cáp USB-C, TPS2121 chọn ngõ USB_5V_IN, BQ25895 giới hạn dòng vào nạp pin và nuôi mạch; (3) Mất nguồn xe đột ngột: Khóa BATFET (11mΩ) trong BQ25895 tự động dẫn, pin 18650 cấp trực tiếp lên SYS. TPS61088 tiếp tục giữ ổn định 5.00V để ESP32 ghi dữ liệu tai nạn và phát cảnh báo 4G liên tục 30-60 phút.

Lưu ý kỹ thuật: Thời gian trễ chuyển mạch thực tế và độ sụt áp tại thời điểm mất nguồn xe bắt buộc phải được đo đạc, kiểm chứng bằng máy hiện sóng trên phần cứng thực nghiệm để xác nhận ESP32 không bị brownout reset trước khi đóng gói sản phẩm.

3. TÍNH TOÁN VÀ LỰA CHỌN LINH KIỆN NGUỒN

3.1. Phân bổ công suất hệ thống

Công suất tiêu thụ được tính toán theo định luật bảo toàn $P = U \times I$, có xét đến hiệu suất chuyển đổi DC-DC. Tuyệt đối không cộng gộp trực tiếp dòng điện của tải 3.3V hoặc tải 3.8V vào dòng điện đường 5V.

Bảng 3. Phân bổ điện áp, dòng tải ước tính và công suất trên các đường nguồn

Đường nguồn | Điện áp | Dòng liên tục | Dòng đỉnh (Peak) | Công suất đỉnh | Thiết bị và khối tải phục vụ
5V_SYS | 5.00V | 0.713 A | 2.713 A (≈ 2.74 A) | 13.70 W | ESP32-S3 (0.5A), Còi buzzer & LED (0.04A), MicroSD (0.1A), Cấp đầu vào cho Buck 3.3V và Nhánh SIM 4G.
3V3_SYS | 3.30V | 0.102 A | 0.102 A (≈ 102 mA) | 0.337 W | MPU6050 (5mA), DS3231 (1.5mA), OLED (30mA), GPS NEO-M8N (65mA). (Dòng kéo từ 5V: 72.8 mA @ η=92.4%).
SIM_PWR | 3.8V / 5V | 0.050 A | 2.000 A (Burst RF) | 7.60 W (ở 3.8V) 10.0 W (ở 5.0V) | Module 4G LTE A7682S. Tải xung dòng xuất hiện gián đoạn trong các khe thời gian truyền dữ liệu lên trạm BTS.

3.2. Tính toán thiết kế bộ tăng áp 5V_SYS (TPS61088)

Trường hợp tải nặng nhất xảy ra khi pin cạn chạm ngưỡng cắt ($V_{\text{IN(min)}} = 3.00\text{ V}$) đồng thời module SIM 4G phát sóng đỉnh dẫn đến dòng tải cực đại $I_{\text{OUT(peak)}} = 2.74\text{ A}$ ($P_{\text{OUT}} = 13.70\text{ W}$). Với hiệu suất tăng áp $\eta = 90.5\%$, dòng điện trung bình kéo từ pin qua cuộn cảm:

I_IN(avg) = (V_OUT × I_OUT) / (η × V_IN(min)) = (5.00 V × 2.74 A) / (0.905 × 3.00 V) = 5.044 A

Chọn $f_{\text{SW}} = 600\text{ kHz}$ ($R_{\text{FREQ}} = 130\text{ k}\Omega$), độ rộng xung $D = 1 - (3.00 \times 0.905 / 5.00) = 0.457$. Với cuộn cảm bọc kim $L = 1.5\mu\text{H}$ (Coilcraft XAL5030-152MEB, $R_{\text{DC}} = 8.5\text{ m}\Omega$, $I_{\text{SAT}} = 8.5\text{ A}$), độ gợn dòng cuộn cảm là:

ΔI_L = (V_IN × D) / (L × f_SW) = (3.00 V × 0.457) / (1.5 µH × 600 kHz) = 1.523 A

Dòng đỉnh qua van khóa MOSFET bên trong chip TPS61088:

I_SW(peak) = I_IN(avg) + (ΔI_L / 2) = 5.044 A + (1.523 A / 2) = 5.805 A

Đánh giá an toàn: Dòng đỉnh tính toán $5.805\text{ A}$ hoàn toàn nằm trong giới hạn an toàn của TPS61088 (ngưỡng ngắt dòng công tắc tối thiểu của chip là $11.9\text{ A}$, hệ số an toàn $SF = 11.9 / 5.805 = 2.05$). Dòng bão hòa cuộn cảm $I_{\text{SAT}} = 8.5\text{ A} > 5.805\text{ A}$ đảm bảo an toàn tuyệt đối không bị bão hòa từ tính.

3.3. Tính toán thiết kế bộ hạ áp 3V3_SYS (TPS62162)

Tổng dòng điện tải 3.3V: $I_{\text{3V3}} = 5\text{mA (MPU)} + 1.5\text{mA (DS3231)} + 30\text{mA (OLED)} + 65\text{mA (GPS)} = \mathbf{101.5\text{ mA}}$ ($P_{\text{3V3}} = 0.335\text{ W}$). Dòng kéo từ 5V_SYS qua bộ hạ áp xung TPS62162 ($\eta = 92.4\%$): $I_{\text{IN\_5V}} = 0.335\text{ W} / (0.924 \times 5.00\text{ V}) = \mathbf{72.5\text{ mA}}$. IC TPS62162 cấp tối đa 1.0A (dư tải gần 10 lần), tần số $2.25\text{ MHz}$ kết hợp cuộn cảm $2.2\mu\text{H}$ và tụ $44\mu\text{F}$ duy trì độ gợn áp ngõ ra $<15\text{ mV}$.

3.4. Tính toán lựa chọn pin 18650 và mạch bảo vệ
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
