danhcln/AIOT-BLACK-BOX/THIET_KE_KHOI_NGUON/BAO_CAO_THIET_KE_KHOI_NGUON_AIOT_CHINH_SUA.docx

BÁO CÁO PHƯƠNG ÁN THIẾT KẾ KHỐI NGUỒN CHO HỆ THỐNG HỘP ĐEN AIOT XE MÁY ĐIỆN

ĐỀ TÀI: THIẾT KẾ HỘP ĐEN AIOT THÔNG MINH PHÂN TÍCH VÀ GHI LẠI SỰ CỐ XE MÁY ĐIỆN

Sinh viên thực hiện: 1. NGUYỄN LÊ CÔNG DANH – MSSV: 23161240 2. PHẠM TRẦN HUY – MSSV: 21161131 | Giảng viên hướng dẫn: THS. NGUYỄN NGÔ LÂM
Tài liệu thiết kế: Báo cáo kỹ thuật phương án cấp nguồn (Phiên bản hiệu chỉnh) | Trạng thái: Đã chuẩn hóa công thức Unicode & Sơ đồ khối B&W chuẩn kỹ thuật
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
