danhcln/AIOT-BLACK-BOX/Bao_Cao/preview_pages/page_1.png

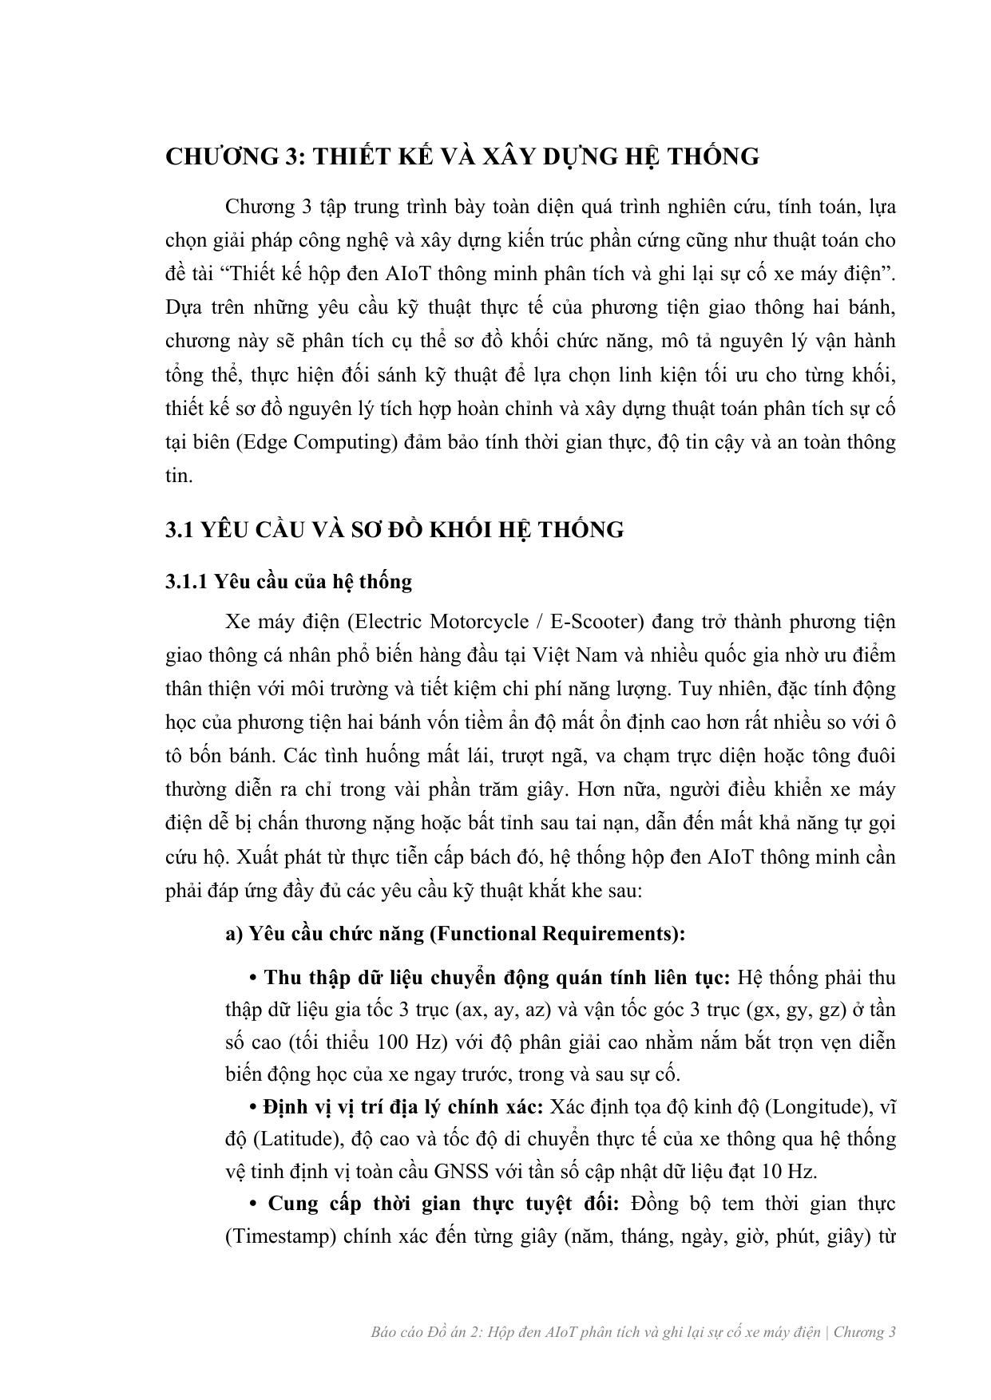
Bao_Cao/preview_pages/page_1.png
