danhcln/AIOT-BLACK-BOX/Bao_Cao/preview_pages/page_3.png

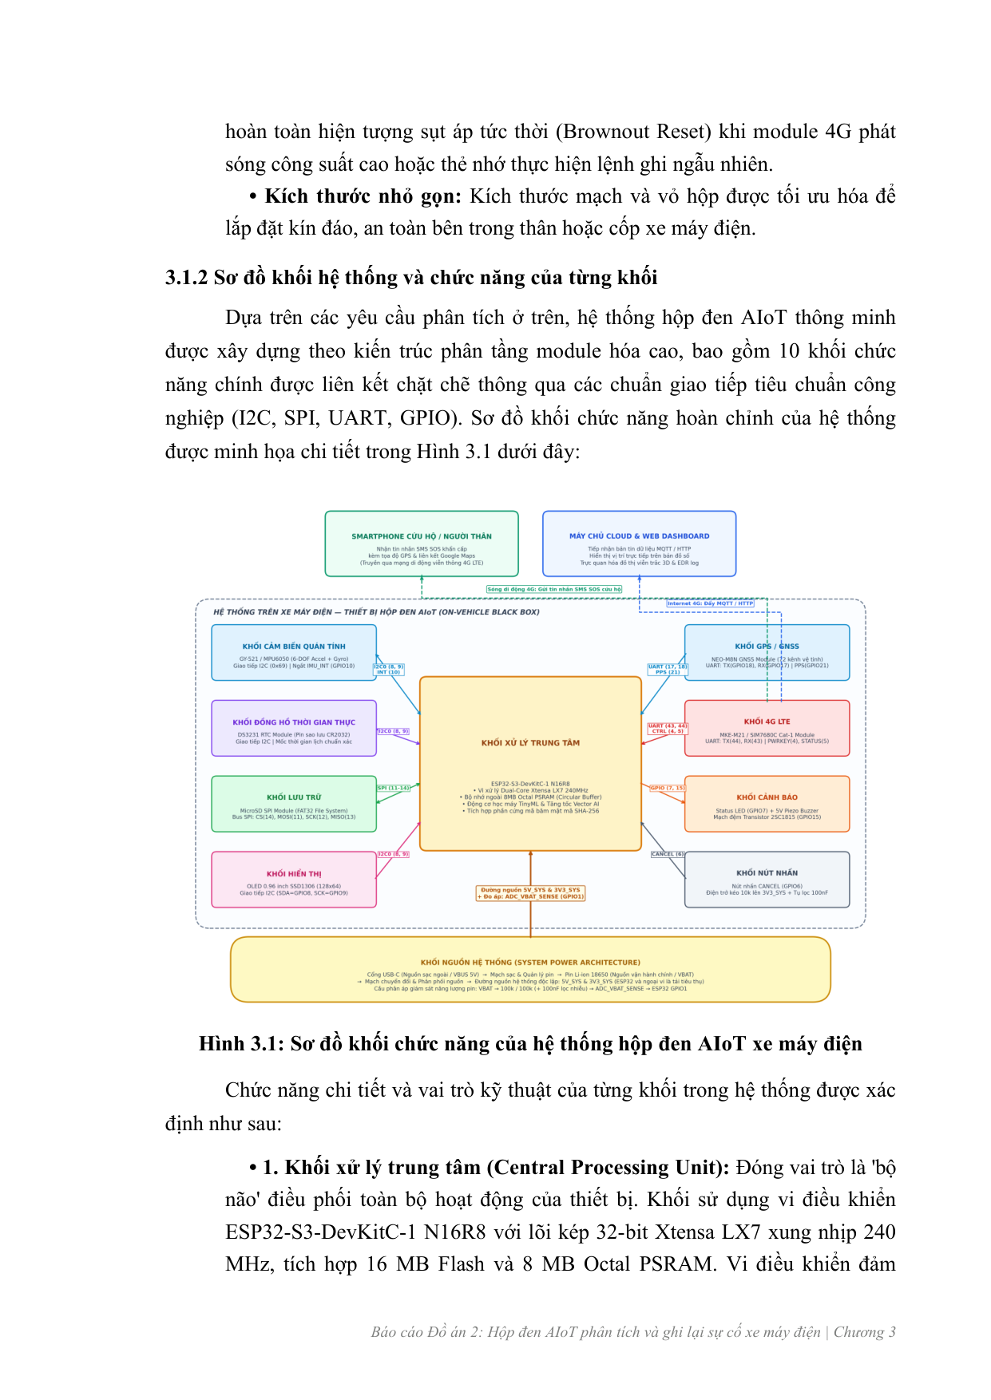
Bao_Cao/preview_pages/page_3.png
