danhcln/AIOT-BLACK-BOX/Bao_Cao/preview_pages/page_10.png

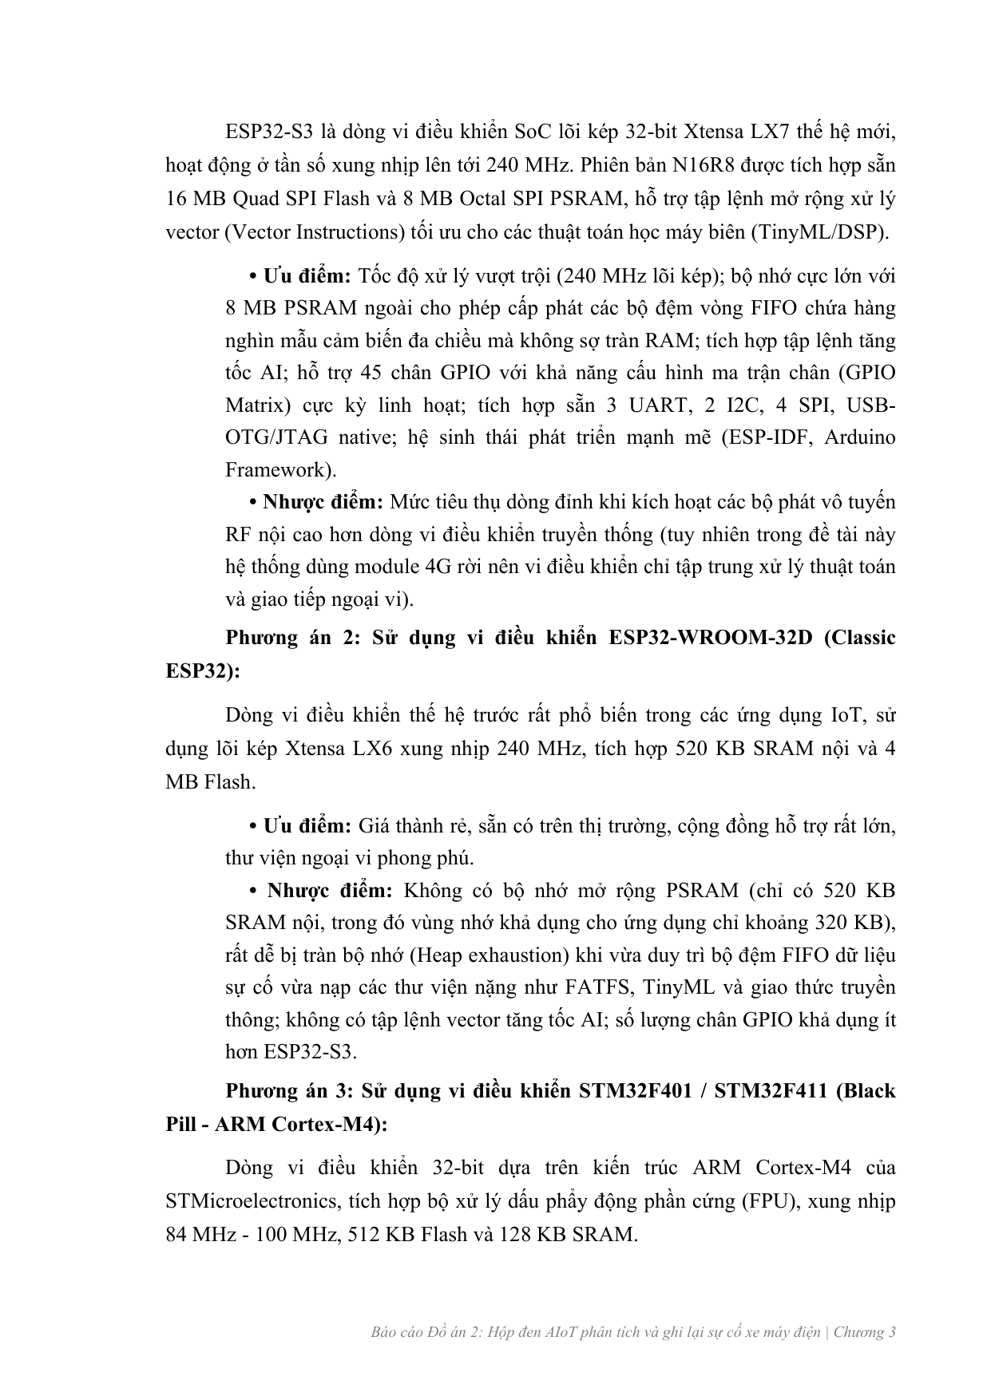
Bao_Cao/preview_pages/page_10.png
