danhcln/AIOT-BLACK-BOX/Bao_Cao/preview_pages/page_25.png

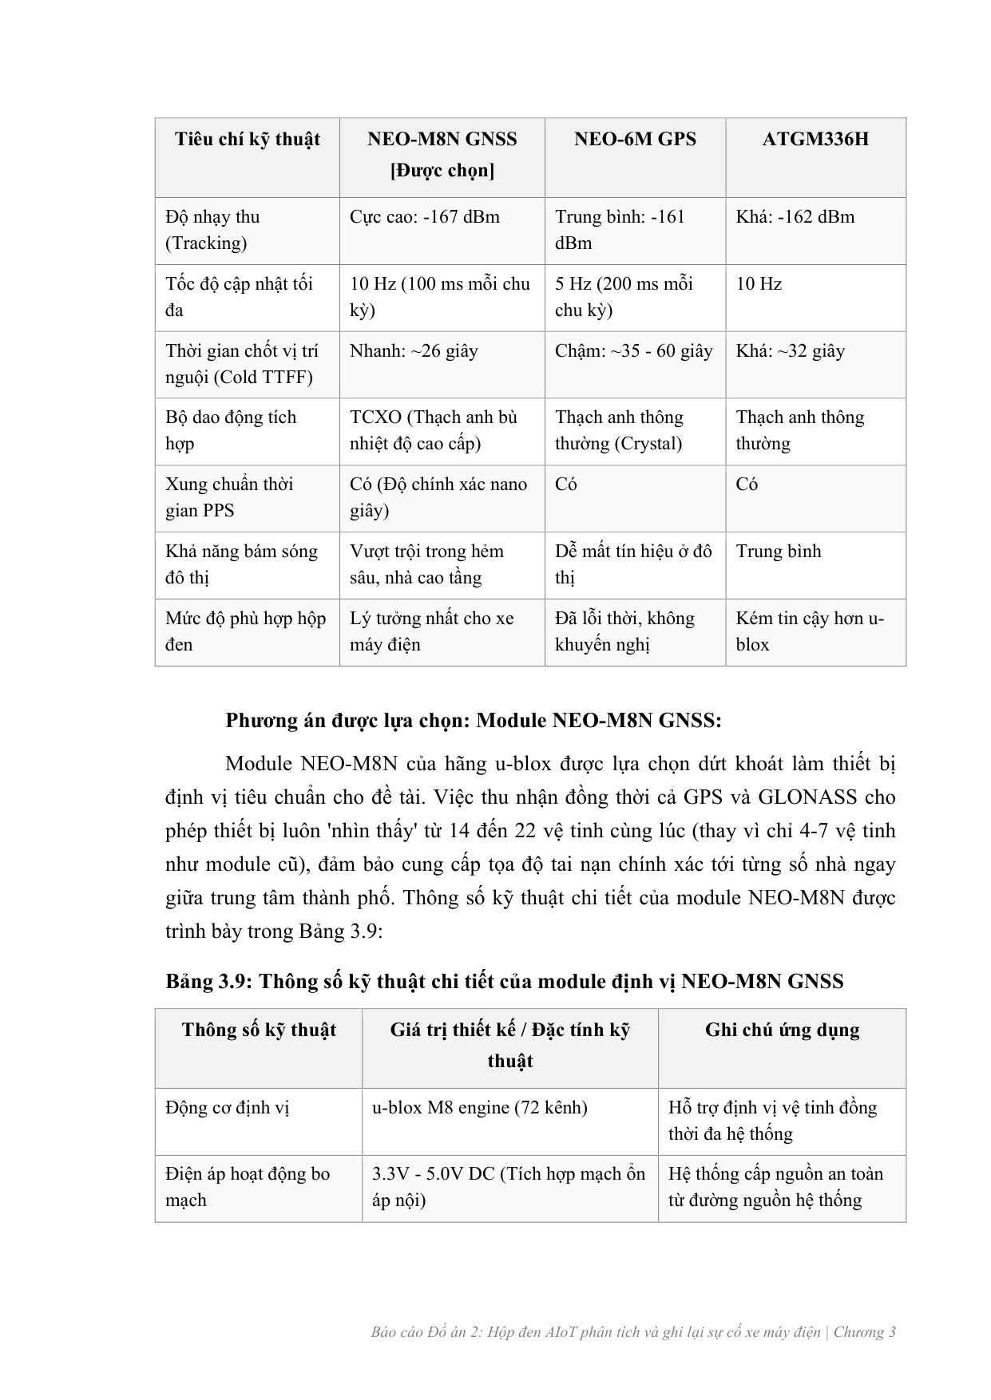
Bao_Cao/preview_pages/page_25.png
