danhcln/AIOT-BLACK-BOX/Bao_Cao/preview_pages/page_47.png

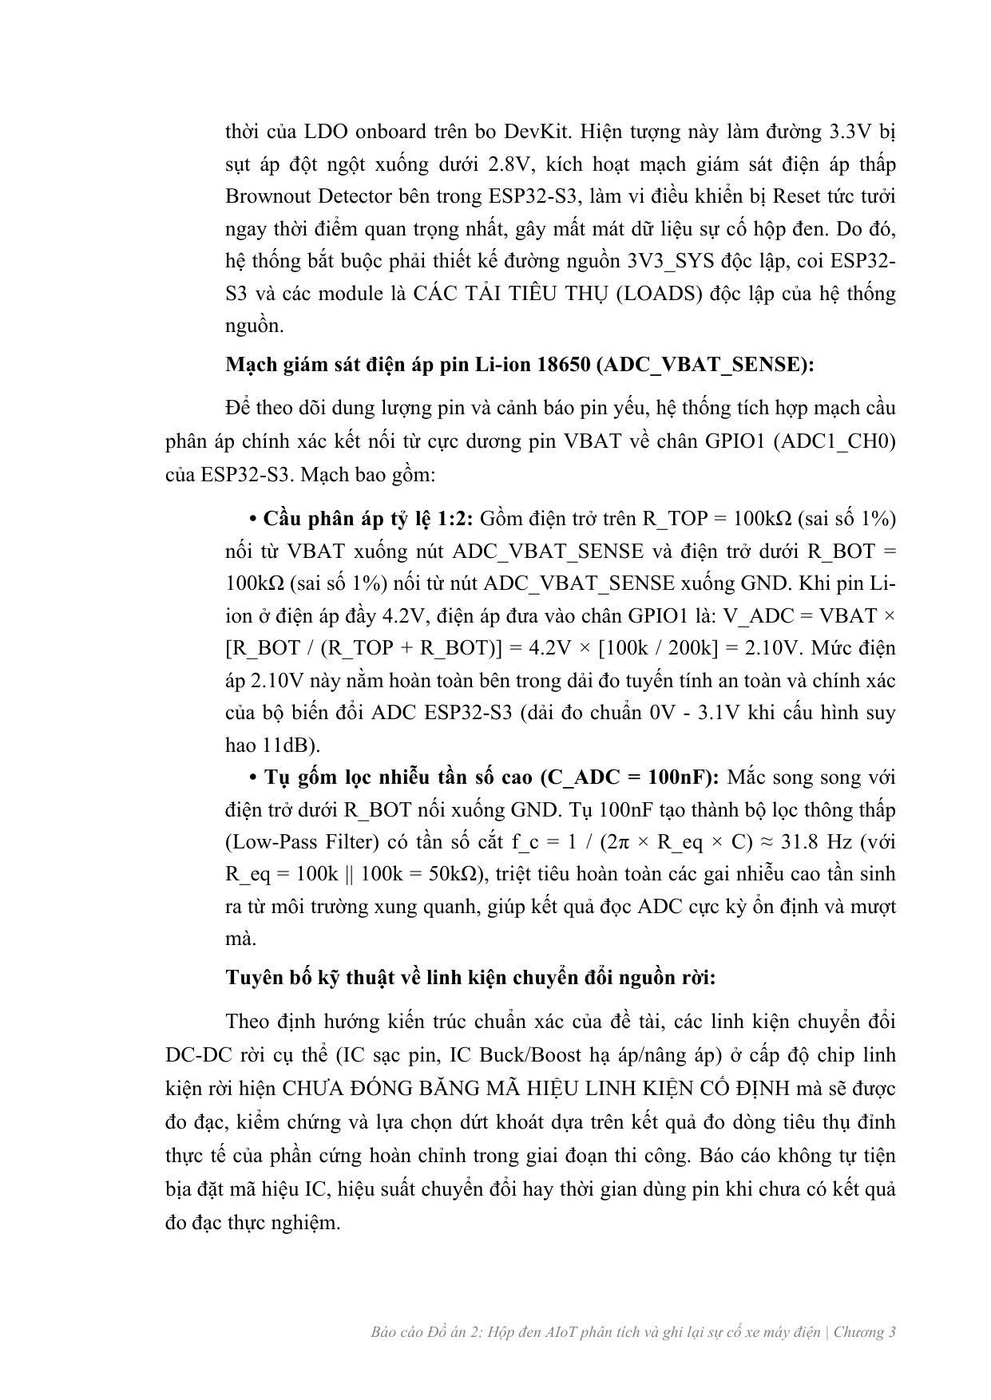
Bao_Cao/preview_pages/page_47.png
