danhcln/AIOT-BLACK-BOX/Bao_Cao/preview_pages/page_50.png

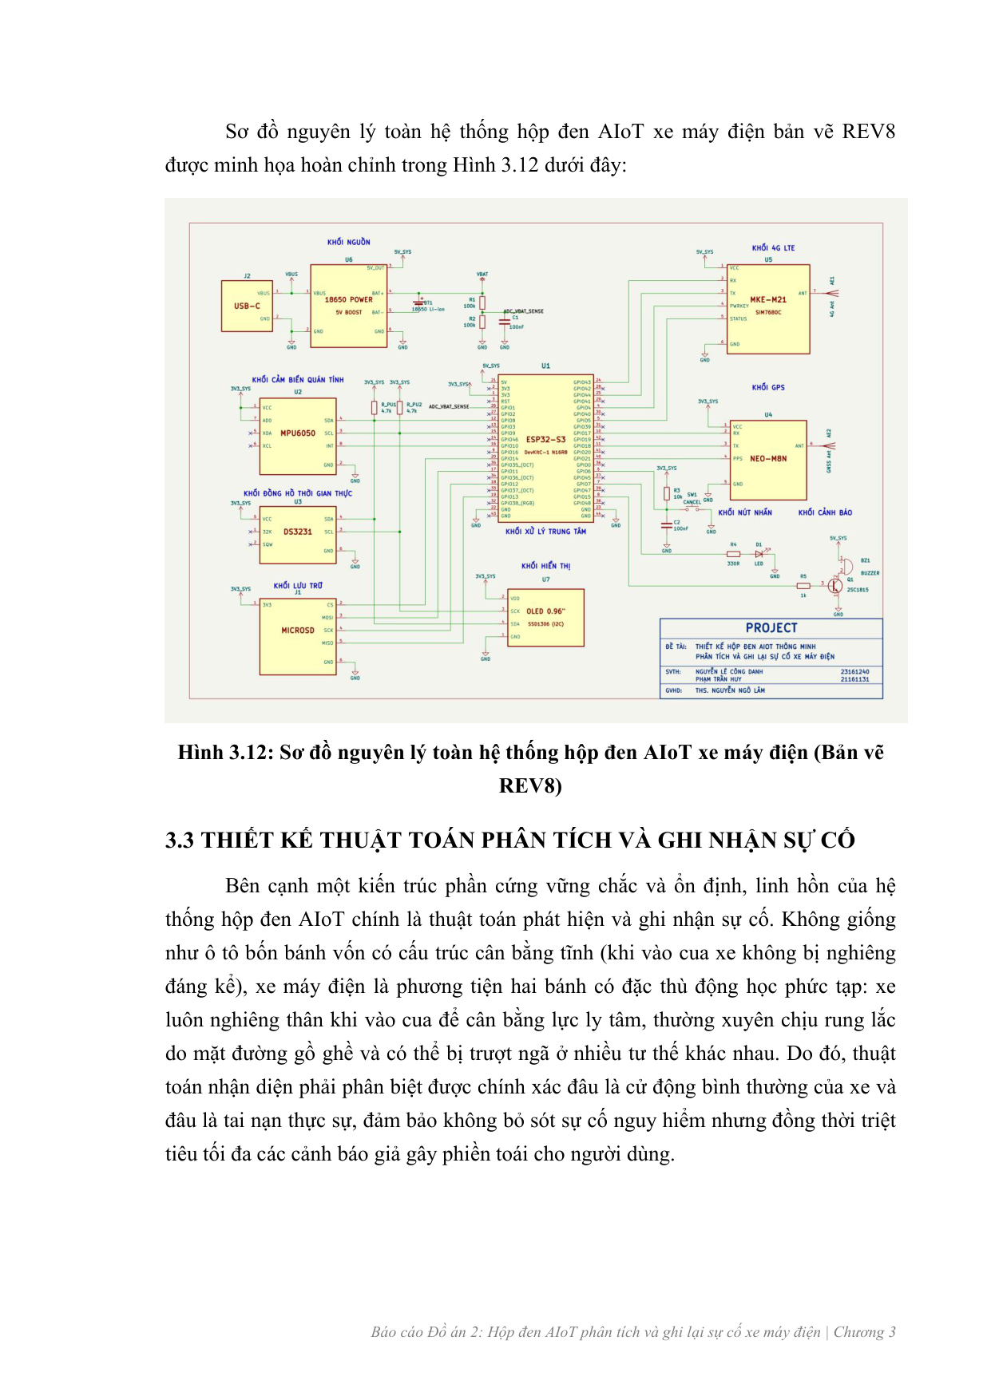
Bao_Cao/preview_pages/page_50.png
