danhcln/AIOT-BLACK-BOX/Bao_Cao/preview_pages/page_57.png

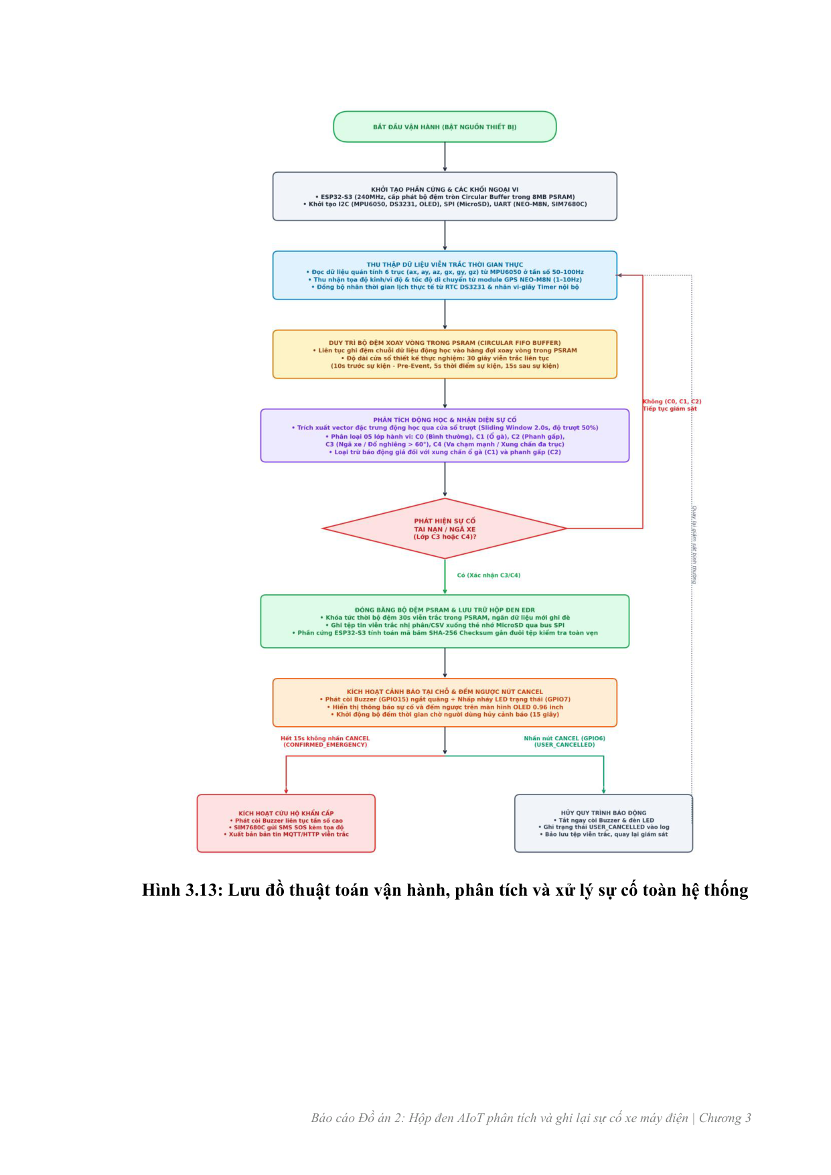
Bao_Cao/preview_pages/page_57.png
