danhcln/AIOT-BLACK-BOX/Hình ảnh linh kiện/ESP32 N16R8/1794204039475_198069978360956581_1780654779979847084_84491fa379081b485b62d44112a8bbd7.jpg

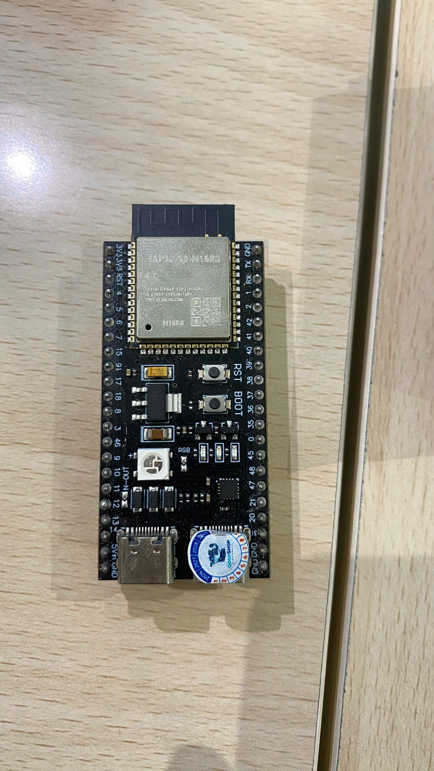
Hình ảnh linh kiện/ESP32 N16R8/1794204039475_198069978360956581_1780654779979847084_84491fa379081b485b62d44112a8bbd7.jpg
