danhcln/AIOT-BLACK-BOX/Hình ảnh linh kiện/ESP32 N16R8/1794204039506_198069978360956581_1780654779979847084_2dad8255752d7c0230db6d0f5b913e92.jpg

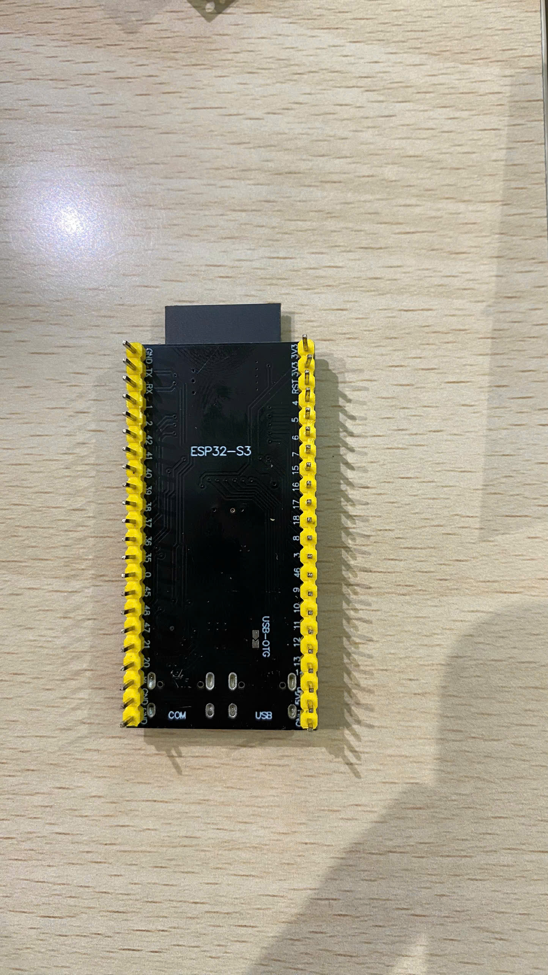
Hình ảnh linh kiện/ESP32 N16R8/1794204039506_198069978360956581_1780654779979847084_2dad8255752d7c0230db6d0f5b913e92.jpg
