danhcln/AIOT-BLACK-BOX/Hình ảnh linh kiện/GPS NEO M8N/1794204268827_198069978360956581_1780654779979847084_13499ca1a093d5e4344c19664af661a5.jpg

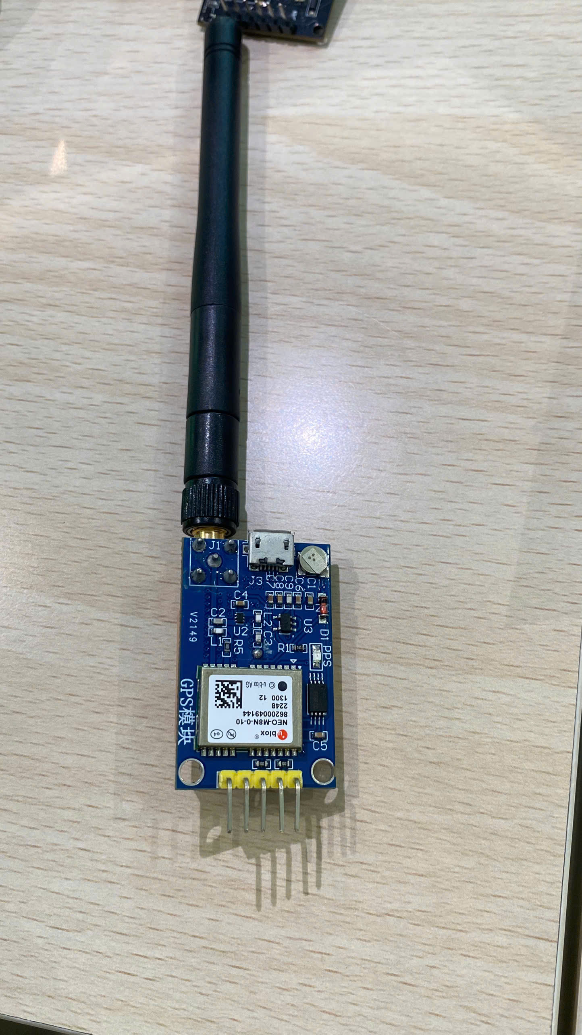
Hình ảnh linh kiện/GPS NEO M8N/1794204268827_198069978360956581_1780654779979847084_13499ca1a093d5e4344c19664af661a5.jpg
