danhcln/AIOT-BLACK-BOX/Hình ảnh linh kiện/GPS NEO M8N/1794204268849_198069978360956581_1780654779979847084_8fe2db746e8583bb0eceebefd6db6e5f.jpg

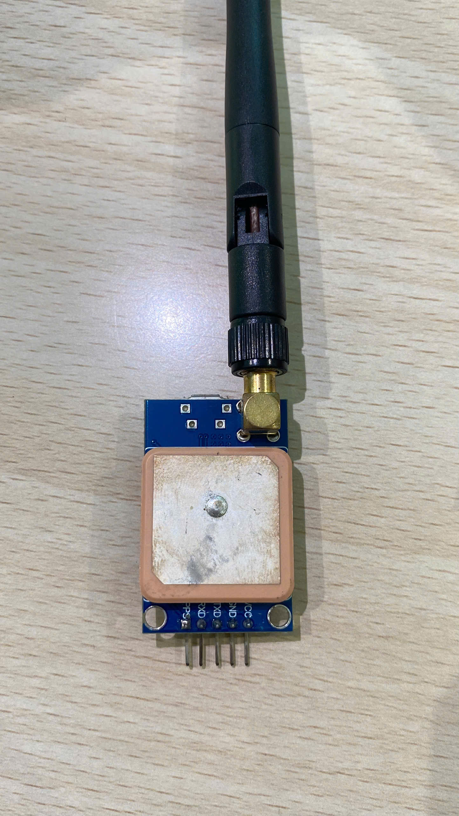
Hình ảnh linh kiện/GPS NEO M8N/1794204268849_198069978360956581_1780654779979847084_8fe2db746e8583bb0eceebefd6db6e5f.jpg
