danhcln/AIOT-BLACK-BOX/Hình ảnh linh kiện/Micro SD/1794204268869_198069978360956581_1780654779979847084_d16ec021c362c70c68833202e3bf4670.jpg

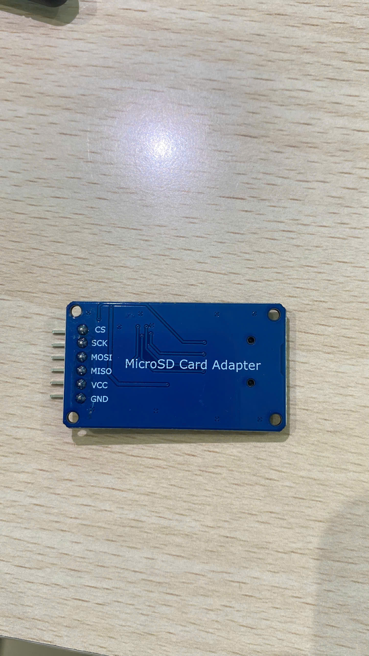
Hình ảnh linh kiện/Micro SD/1794204268869_198069978360956581_1780654779979847084_d16ec021c362c70c68833202e3bf4670.jpg
