danhcln/AIOT-BLACK-BOX/Hình ảnh linh kiện/Module Sim A7680C/1794204134409_198069978360956581_1780654779979847084_e48892d98332388c5f711227cc6e4e73.jpg

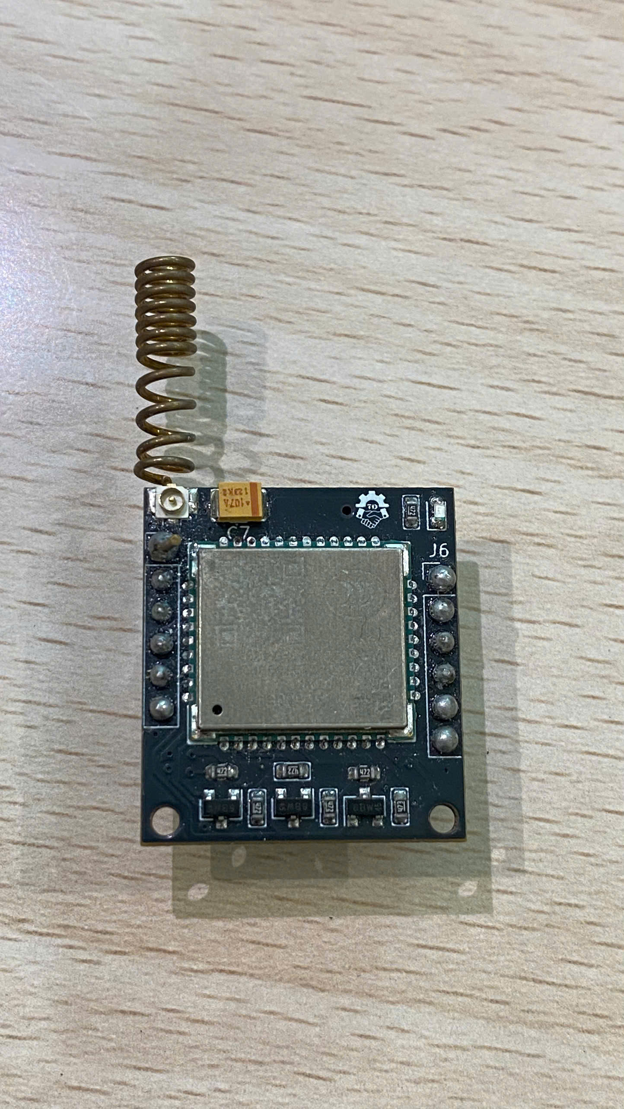
Hình ảnh linh kiện/Module Sim A7680C/1794204134409_198069978360956581_1780654779979847084_e48892d98332388c5f711227cc6e4e73.jpg
