danhcln/AIOT-BLACK-BOX/Hình ảnh linh kiện/Module Sim A7680C/1794204134494_198069978360956581_1780654779979847084_fdb304df868a2ad6c707d7a224855f0c.jpg

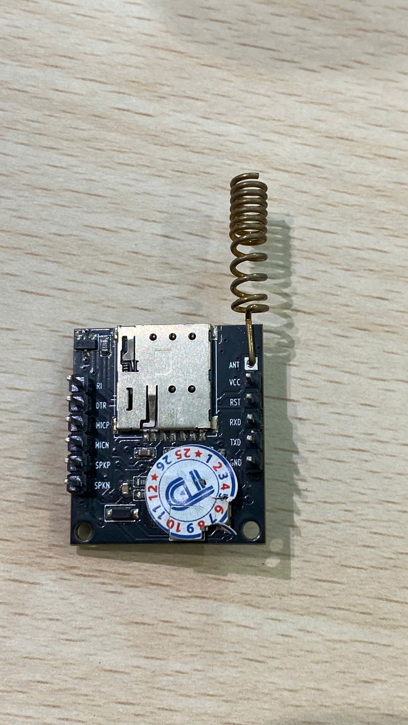
Hình ảnh linh kiện/Module Sim A7680C/1794204134494_198069978360956581_1780654779979847084_fdb304df868a2ad6c707d7a224855f0c.jpg
