danhcln/AIOT-BLACK-BOX/Hình ảnh linh kiện/MPU6050/1794204268975_198069978360956581_1780654779979847084_6830228556ea5344f5f55aee9fc06483.jpg

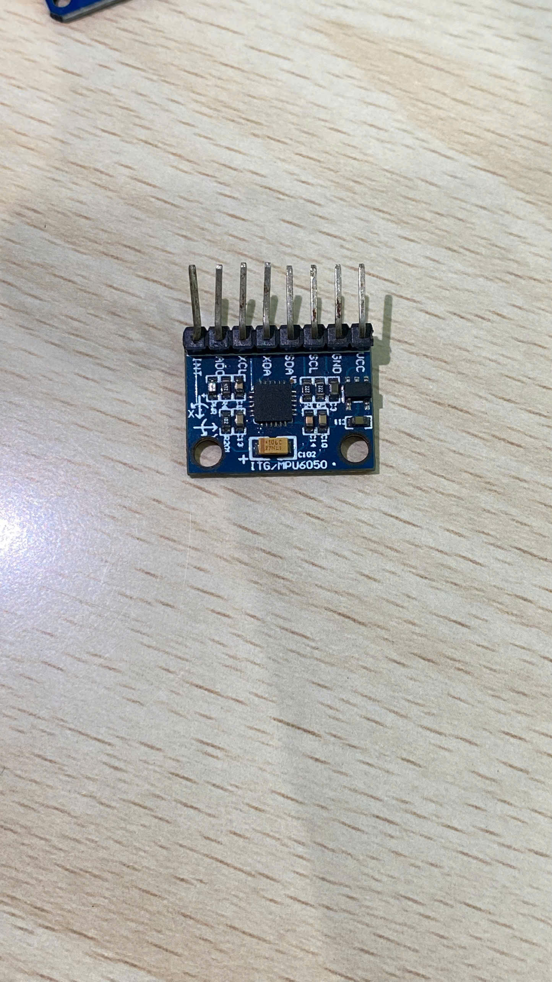
Hình ảnh linh kiện/MPU6050/1794204268975_198069978360956581_1780654779979847084_6830228556ea5344f5f55aee9fc06483.jpg
