danhcln/AIOT-BLACK-BOX/Hình ảnh linh kiện/MPU6050/1794204268990_198069978360956581_1780654779979847084_6488ca57a043a4d16110cabf69387bfb.jpg

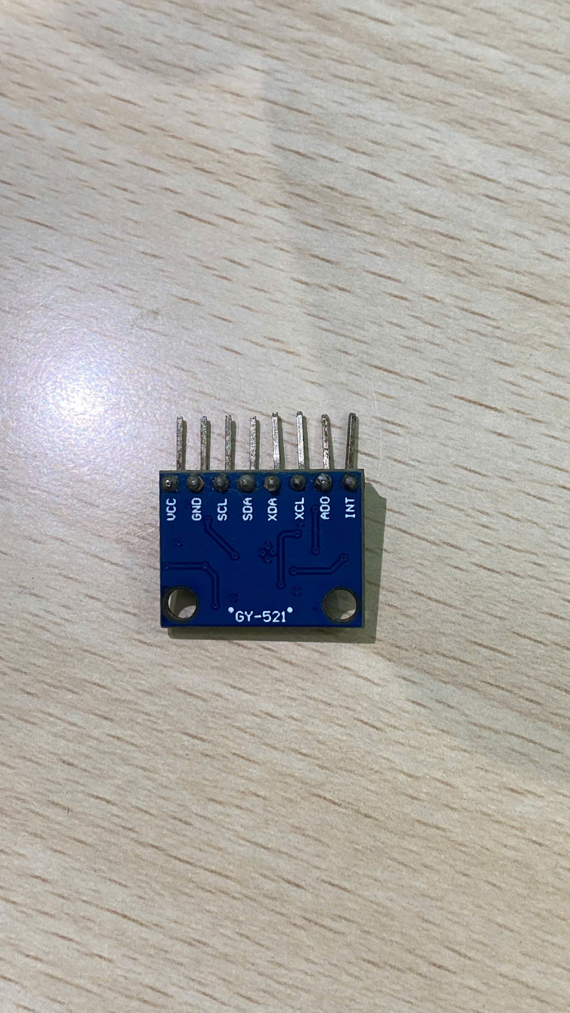
Hình ảnh linh kiện/MPU6050/1794204268990_198069978360956581_1780654779979847084_6488ca57a043a4d16110cabf69387bfb.jpg
