danhcln/AIOT-BLACK-BOX/Hình ảnh linh kiện/OLED 0.96'inch/1794204268899_198069978360956581_1780654779979847084_a4cbb1a4889d772097392fc372944adc.jpg

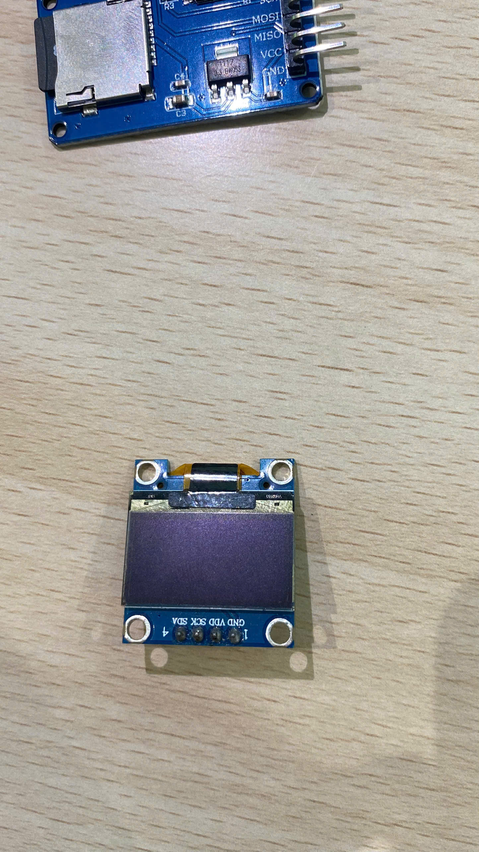
Hình ảnh linh kiện/OLED 0.96'inch/1794204268899_198069978360956581_1780654779979847084_a4cbb1a4889d772097392fc372944adc.jpg
