danhcln/AIOT-BLACK-BOX/Hình ảnh linh kiện/OLED 0.96'inch/1794204268914_198069978360956581_1780654779979847084_6ea5164c1a8d3554c625e8bc03efef54.jpg

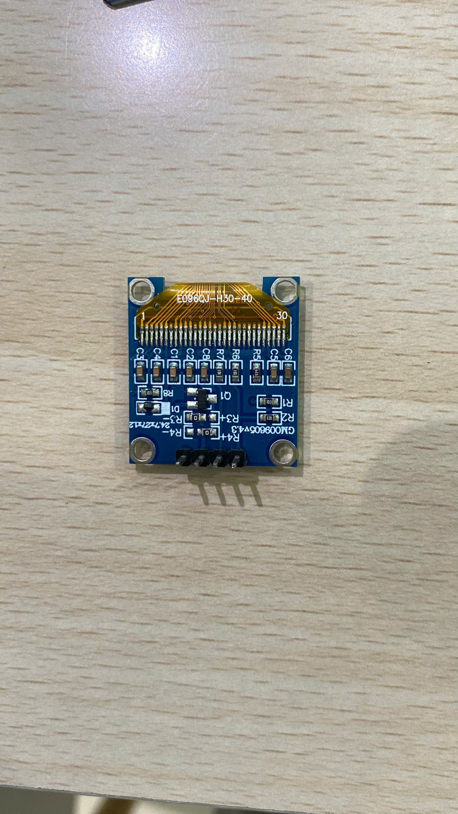
Hình ảnh linh kiện/OLED 0.96'inch/1794204268914_198069978360956581_1780654779979847084_6ea5164c1a8d3554c625e8bc03efef54.jpg
