danhcln/AIOT-BLACK-BOX/Hình ảnh linh kiện/OLED 0.96'inch/1794204268929_198069978360956581_1780654779979847084_ea720cbb8a783cfe2d809b200c19561e.jpg

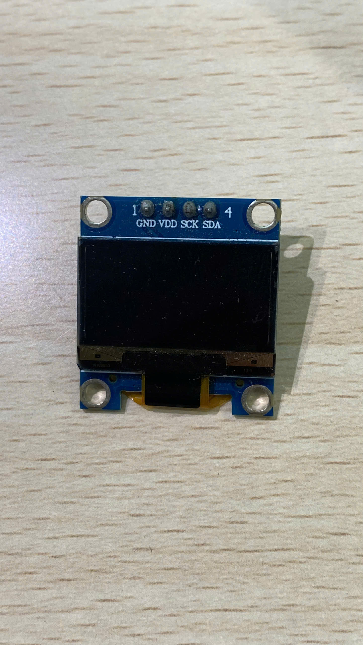
Hình ảnh linh kiện/OLED 0.96'inch/1794204268929_198069978360956581_1780654779979847084_ea720cbb8a783cfe2d809b200c19561e.jpg
