danhcln/AIOT-BLACK-BOX/Hình ảnh linh kiện/RTC DS3231/1794204268944_198069978360956581_1780654779979847084_1146cfef14d6c6eac4ae8ccd0c8b5d56.jpg

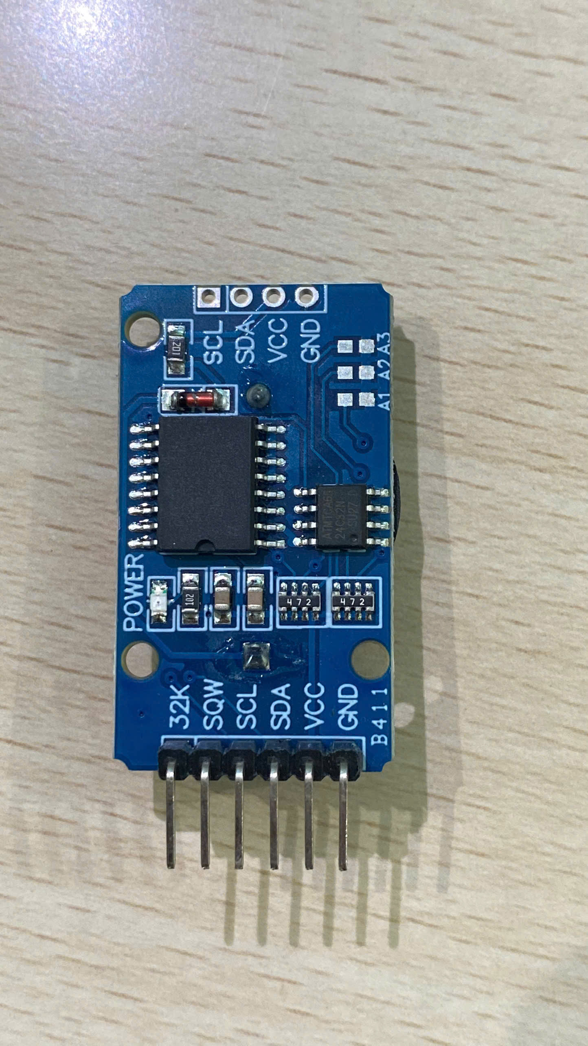
Hình ảnh linh kiện/RTC DS3231/1794204268944_198069978360956581_1780654779979847084_1146cfef14d6c6eac4ae8ccd0c8b5d56.jpg
