danhcln/AIOT-BLACK-BOX/Hình ảnh linh kiện/RTC DS3231/1794204268960_198069978360956581_1780654779979847084_a6eada72e50465773b889ff922c9d38f.jpg

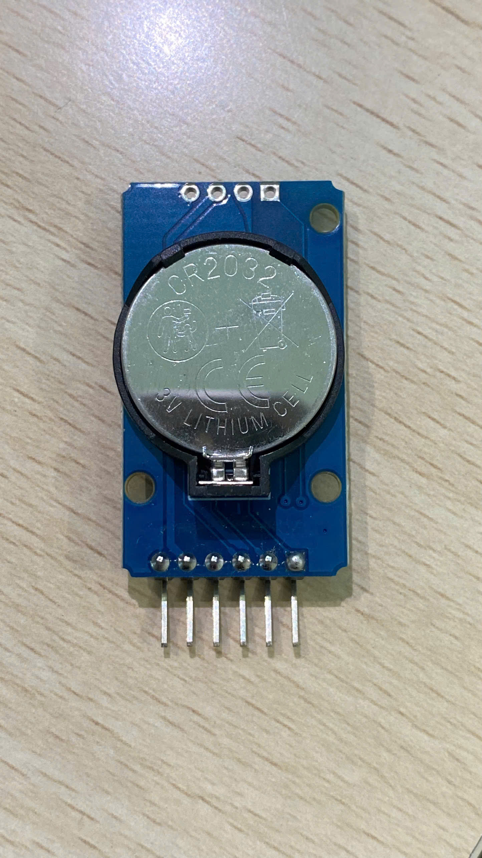
Hình ảnh linh kiện/RTC DS3231/1794204268960_198069978360956581_1780654779979847084_a6eada72e50465773b889ff922c9d38f.jpg
