danhcln/AIOT-BLACK-BOX/PCB_AIOT_BLACKBOX/AIOT_BLACKBOX_MAINBOARD_REV1/GATE_1_FOOTPRINT/ESP32_S3_FOOTPRINT_1TO1_CHECK.png

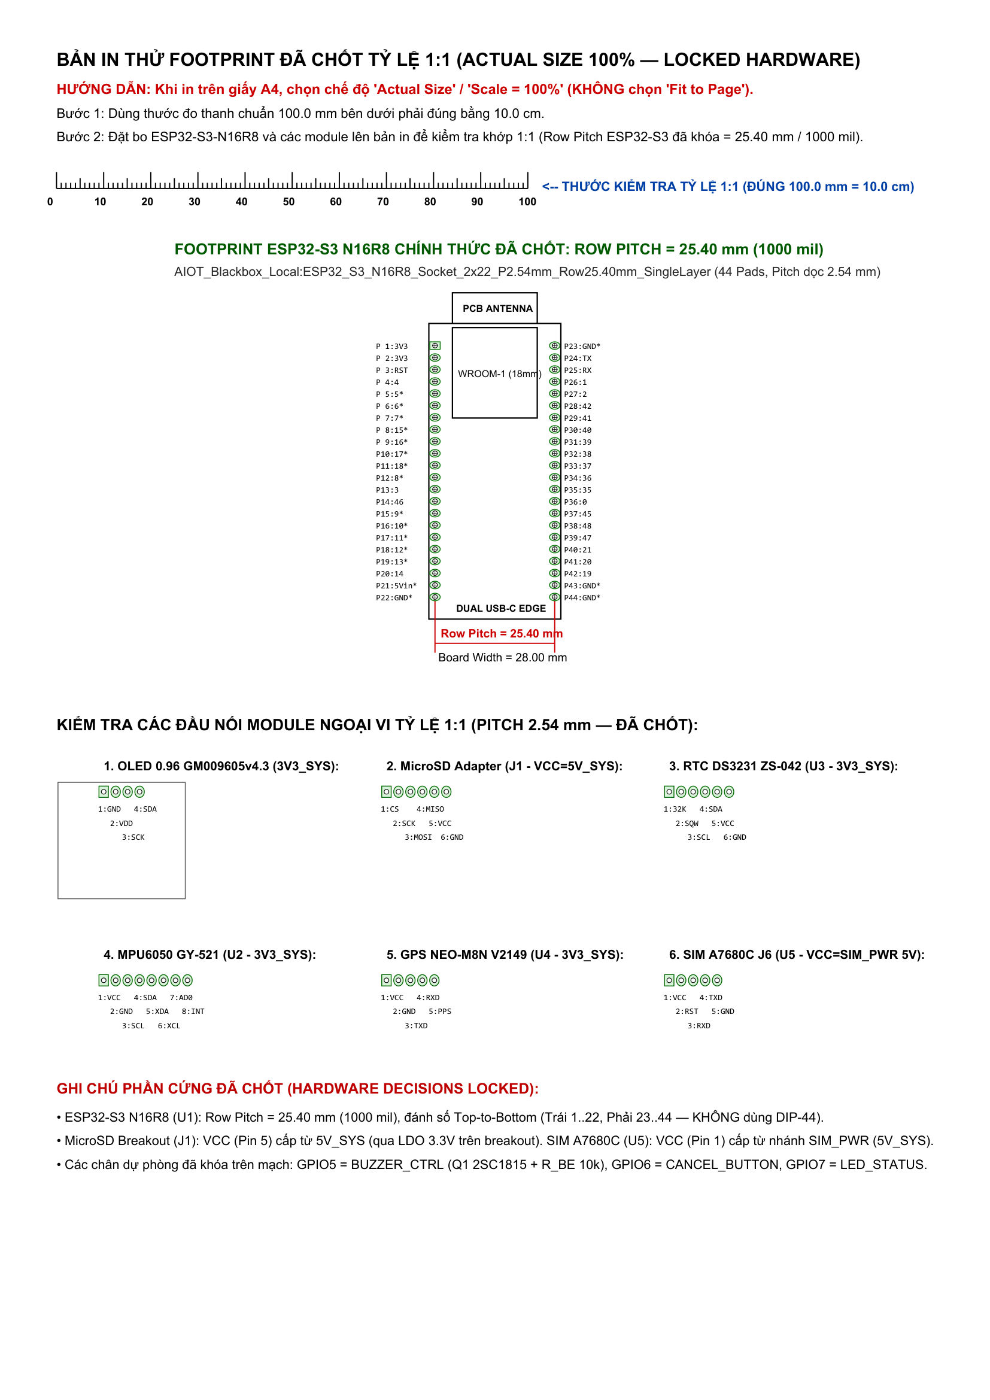
PCB_AIOT_BLACKBOX/AIOT_BLACKBOX_MAINBOARD_REV1/GATE_1_FOOTPRINT/ESP32_S3_FOOTPRINT_1TO1_CHECK.png
