danhcln/AIOT-BLACK-BOX/PCB_AIOT_BLACKBOX/AIOT_BLACKBOX_MAINBOARD_REV1/GATE_3_ROUTING/PCB_ROUTING_BOTTOM_COPPER_ONLY_REV3.png

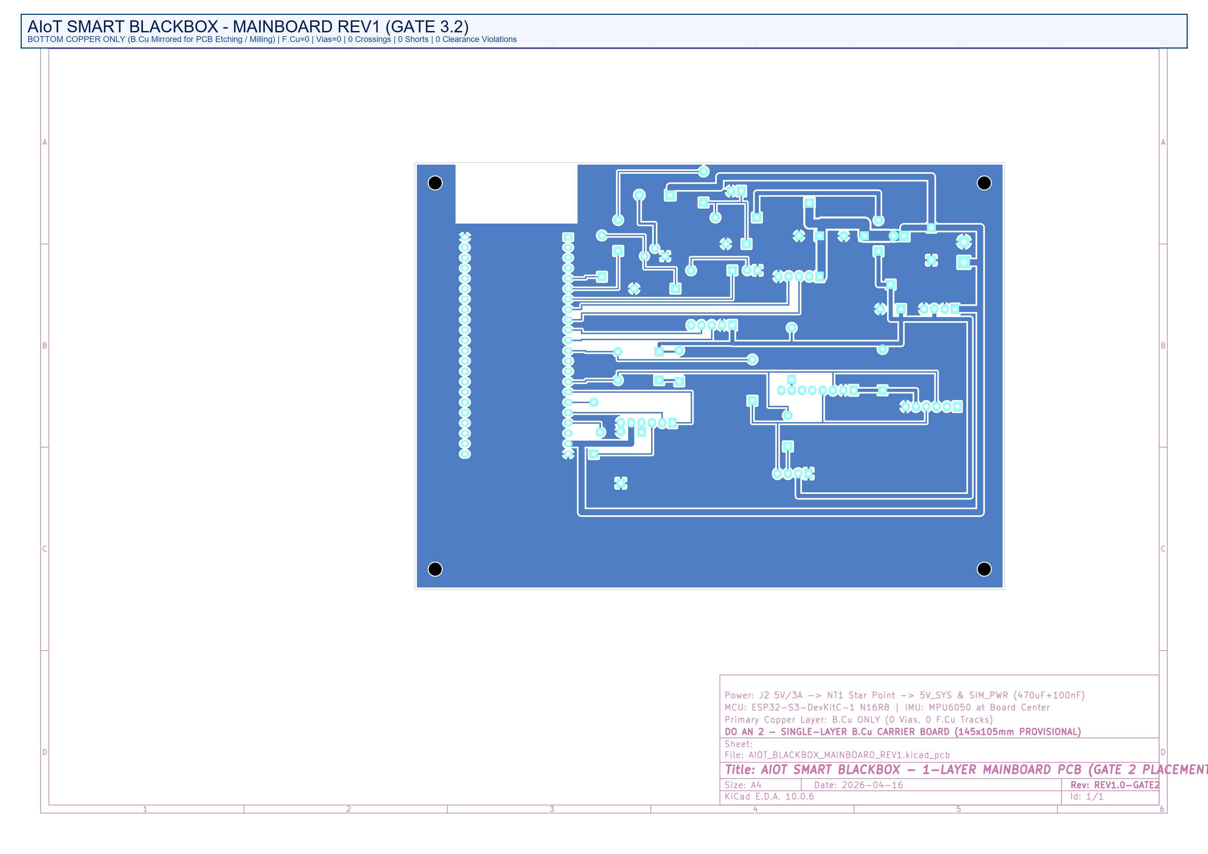
PCB_AIOT_BLACKBOX/AIOT_BLACKBOX_MAINBOARD_REV1/GATE_3_ROUTING/PCB_ROUTING_BOTTOM_COPPER_ONLY_REV3.png
