danhcln/AIOT-BLACK-BOX/report_crops/4g_lte_block.png

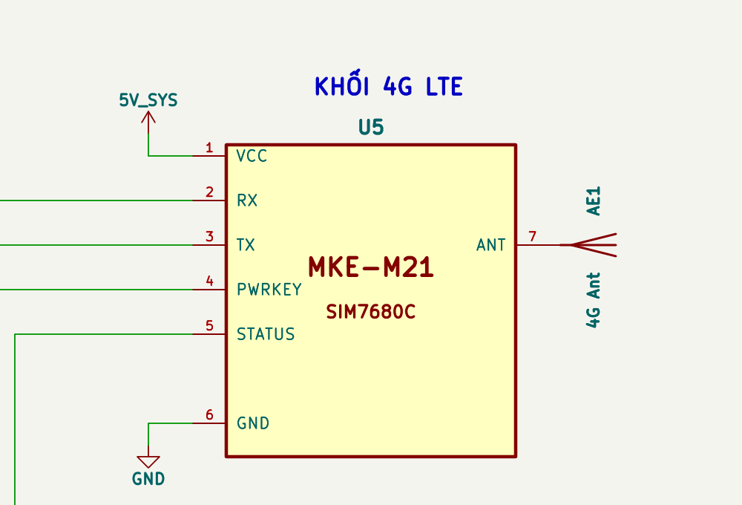
report_crops/4g_lte_block.png
