danhcln/AIOT-BLACK-BOX/report_crops/cancel_button_block.png

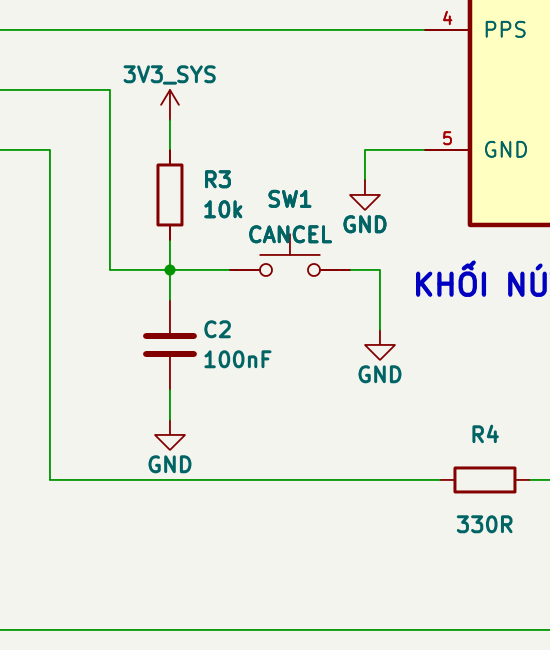
report_crops/cancel_button_block.png
