danhcln/AIOT-BLACK-BOX/report_crops/check_btn_text.png

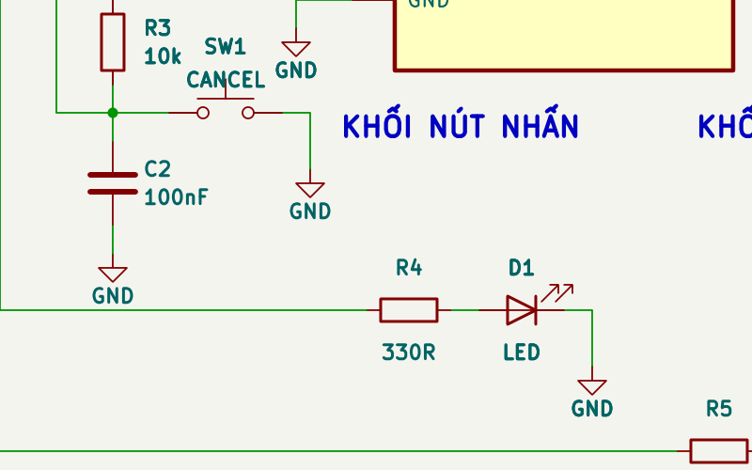
report_crops/check_btn_text.png
