danhcln/AIOT-BLACK-BOX/report_crops/check_full_ui.png

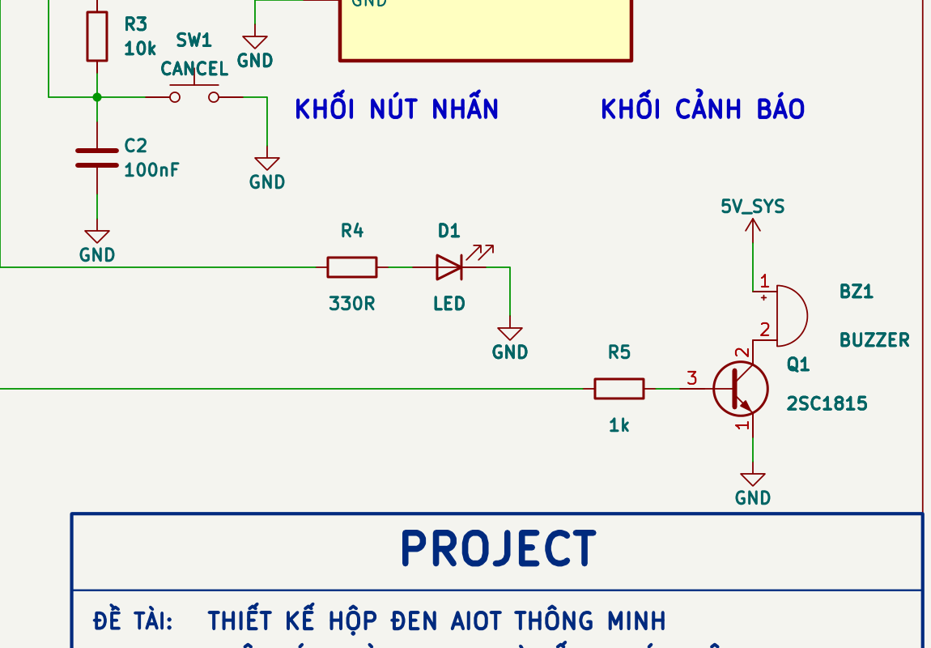
report_crops/check_full_ui.png
