danhcln/AIOT-BLACK-BOX/report_crops/crop_4g_lte.png

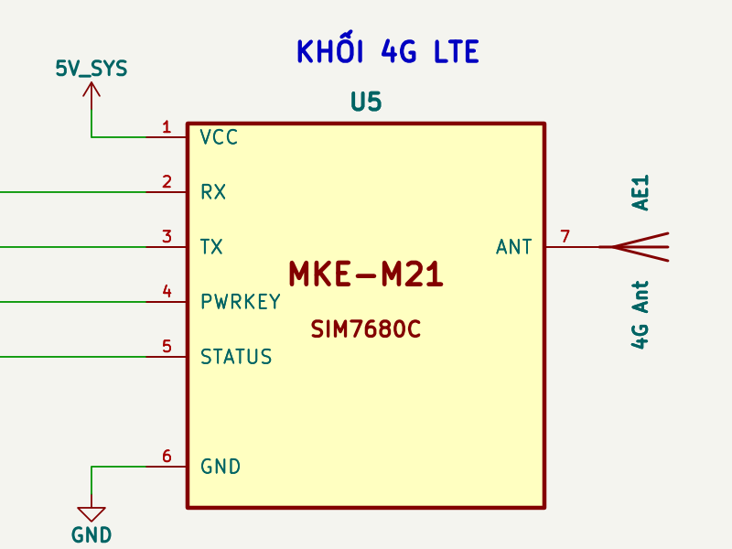
report_crops/crop_4g_lte.png
