danhcln/AIOT-BLACK-BOX/report_crops/crop_cancel_button.png

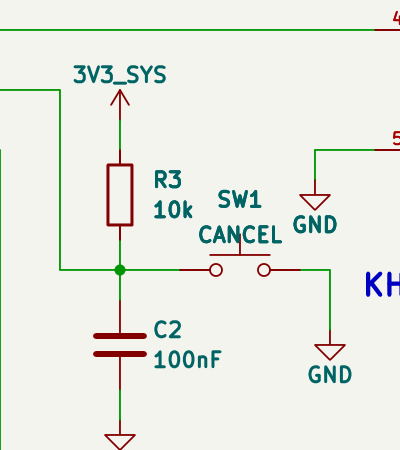
report_crops/crop_cancel_button.png
