danhcln/AIOT-BLACK-BOX/report_crops/crop_microsd.png

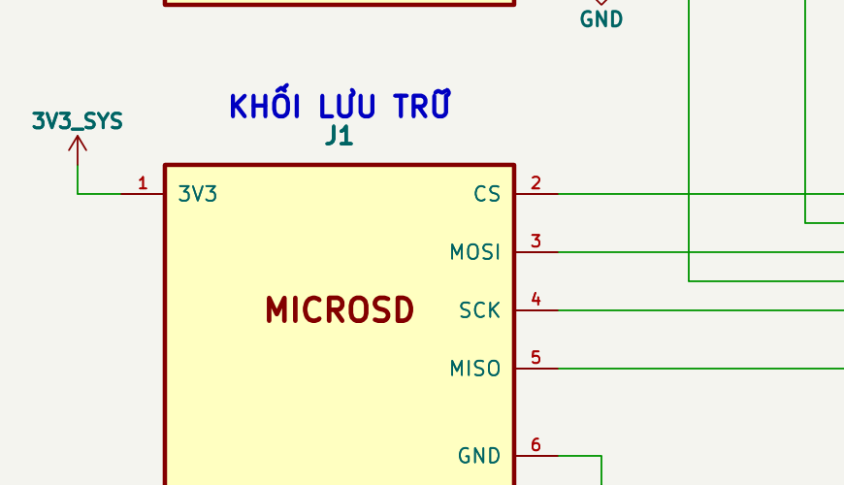
report_crops/crop_microsd.png
