danhcln/AIOT-BLACK-BOX/report_crops/crop_mpu6050.png

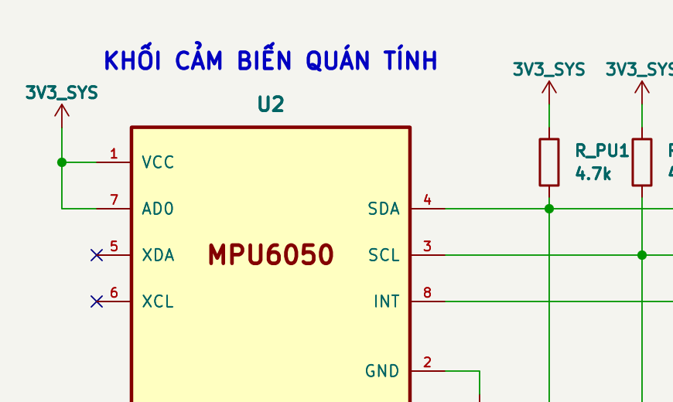
report_crops/crop_mpu6050.png
