danhcln/AIOT-BLACK-BOX/report_crops/crop_warning_block.png

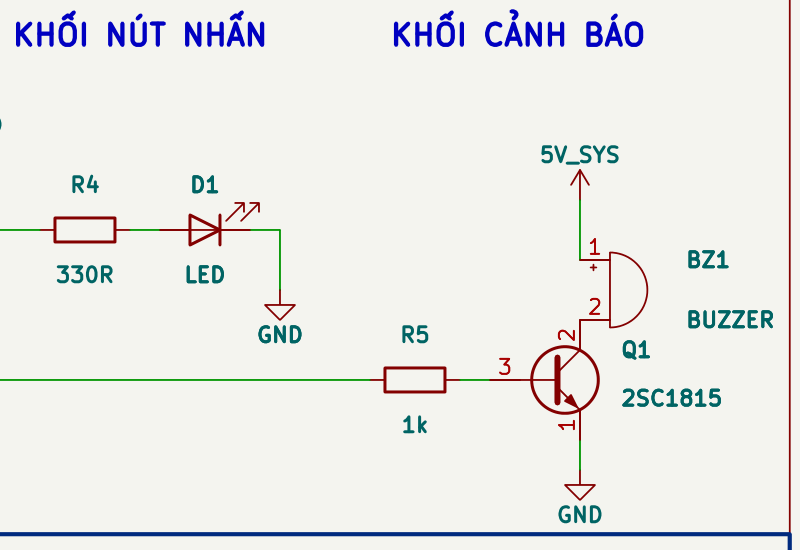
report_crops/crop_warning_block.png
