danhcln/AIOT-BLACK-BOX/report_crops/ds3231_block.png

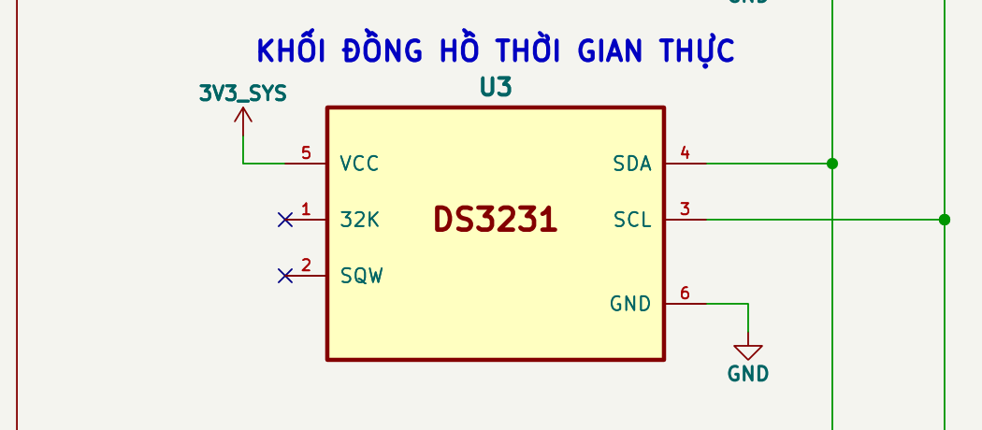
report_crops/ds3231_block.png
