danhcln/AIOT-BLACK-BOX/report_crops/gnss_block.png

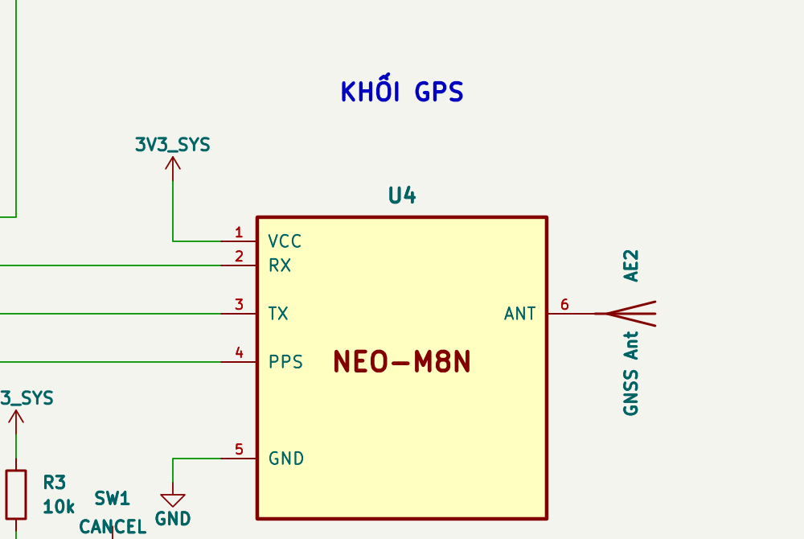
report_crops/gnss_block.png
