danhcln/AIOT-BLACK-BOX/report_crops/microsd_block.png

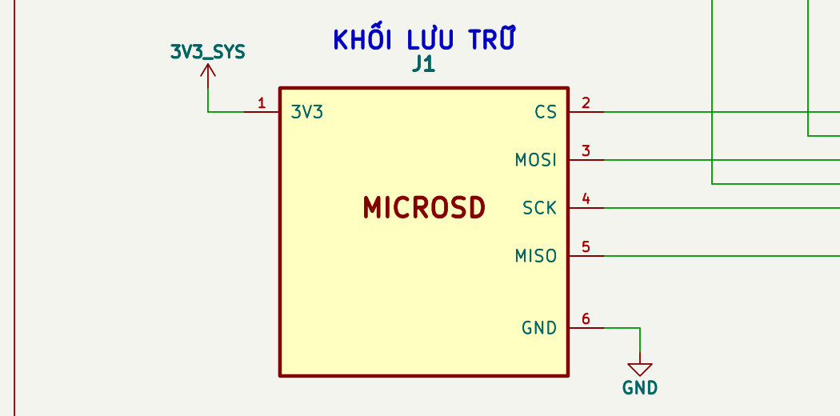
report_crops/microsd_block.png
