danhcln/AIOT-BLACK-BOX/report_crops/mpu6050_block.png

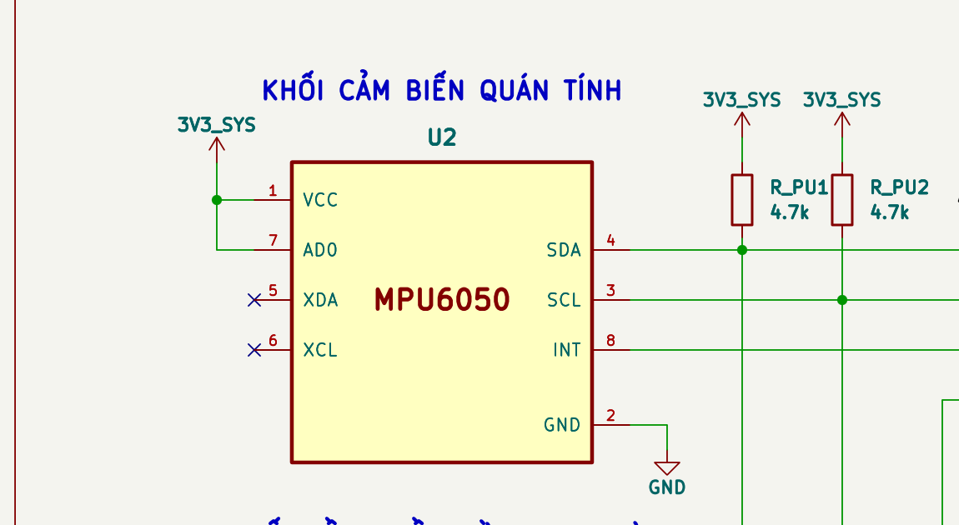
report_crops/mpu6050_block.png
