danhcln/AIOT-BLACK-BOX/report_crops/oled_block.png

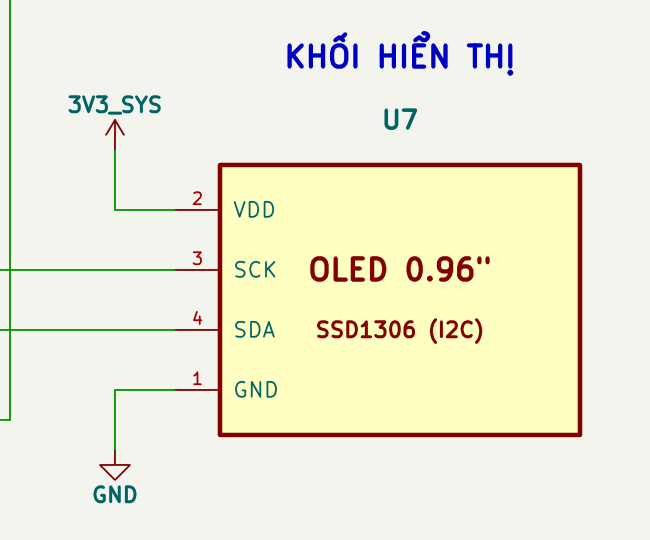
report_crops/oled_block.png
