danhcln/AIOT-BLACK-BOX/report_crops/power_block.png

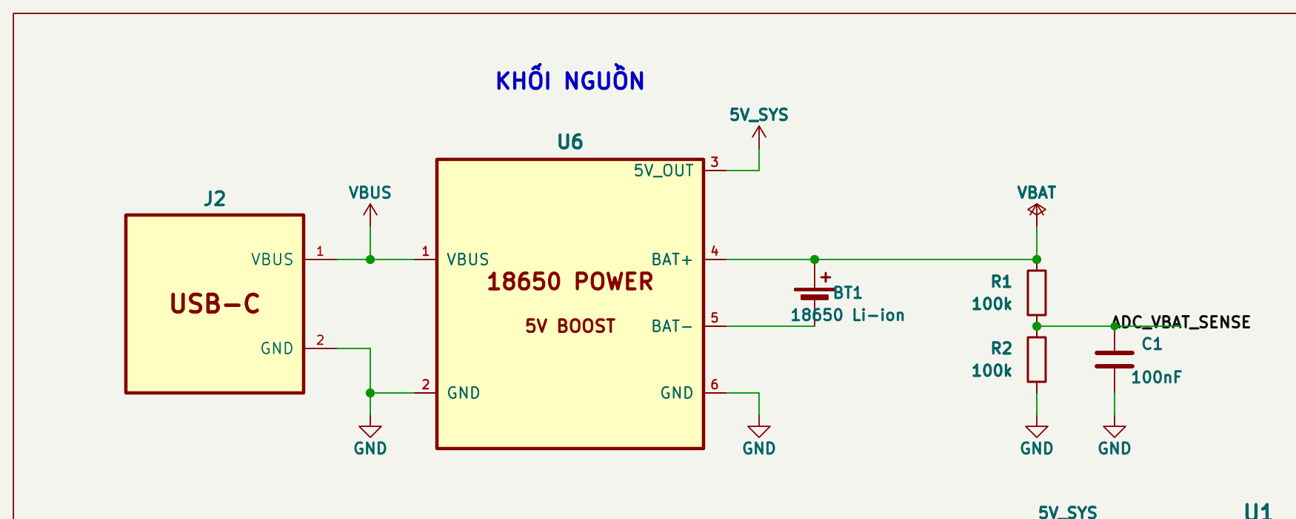
report_crops/power_block.png
