danhcln/AIOT-BLACK-BOX/report_crops/warning_block.png

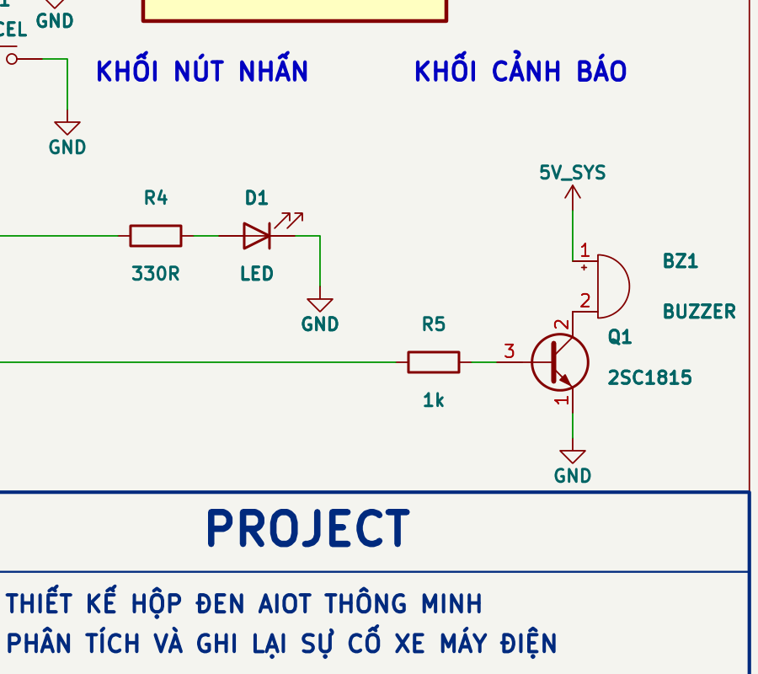
report_crops/warning_block.png
