danhcln/AIOT-BLACK-BOX/Schematic_Thay/AIOT_BLACKBOX_PRESENTATION/AIOT_BLACKBOX_PRESENTATION_A4.png

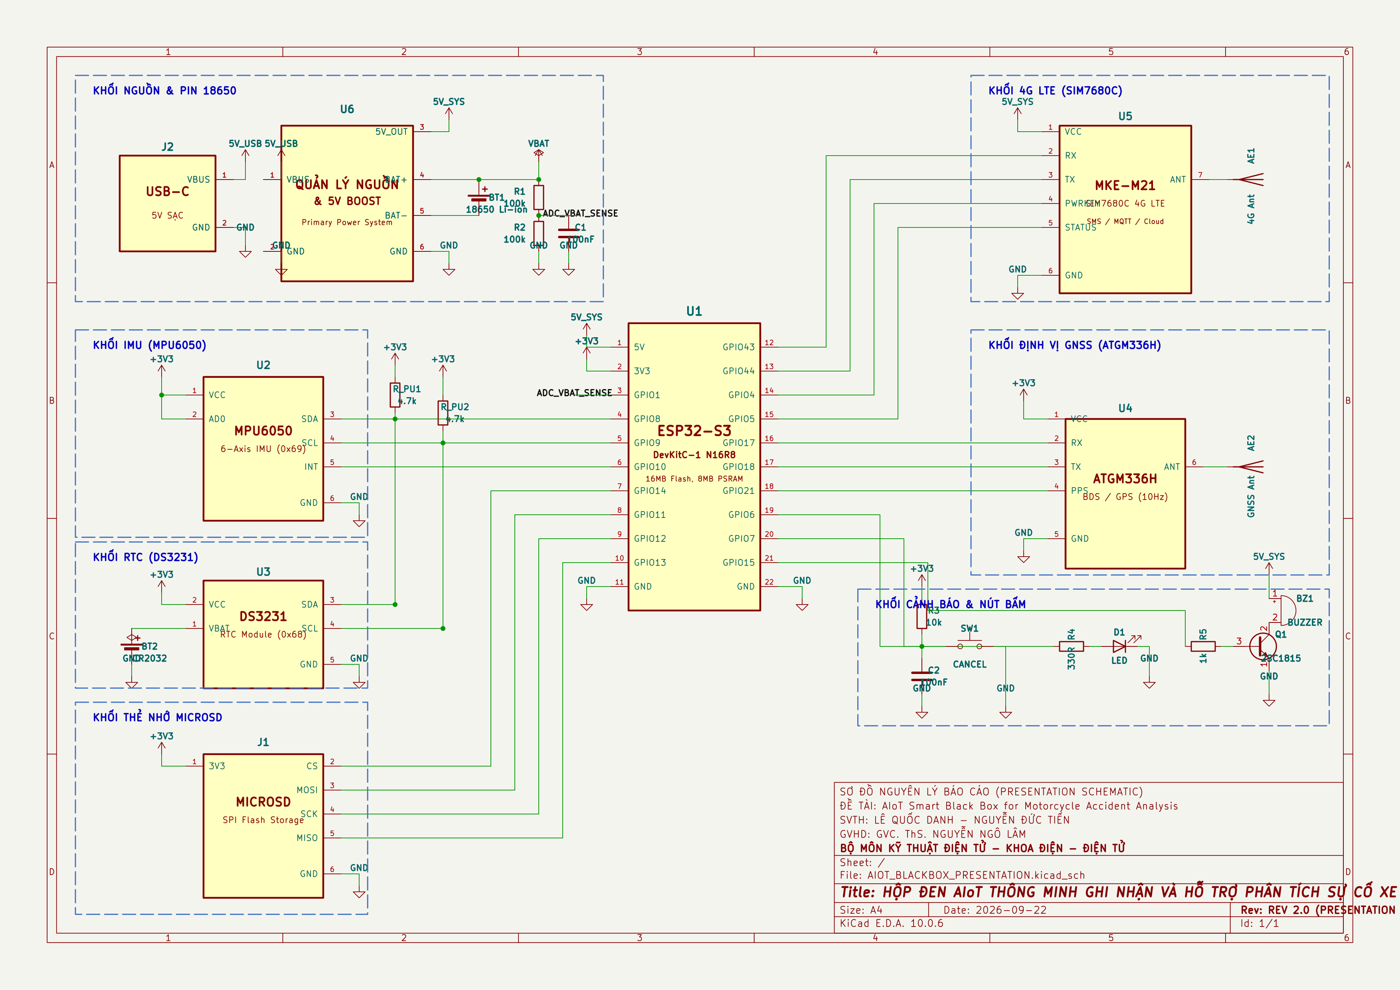
Schematic_Thay/AIOT_BLACKBOX_PRESENTATION/AIOT_BLACKBOX_PRESENTATION_A4.png
