danhcln/AIOT-BLACK-BOX/Schematic_Thay/AIOT_BLACKBOX_PRESENTATION/lecturer_sample.png

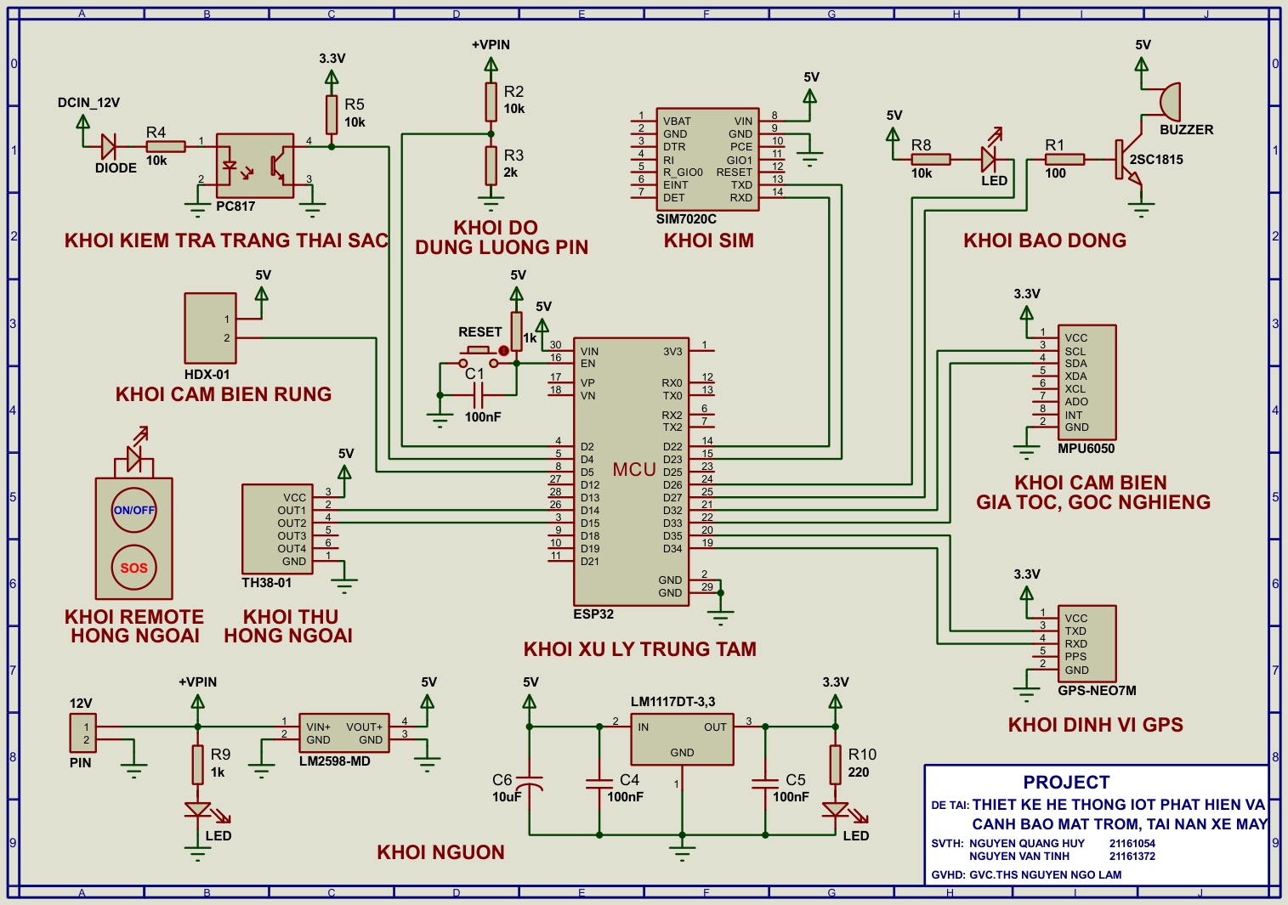
Schematic_Thay/AIOT_BLACKBOX_PRESENTATION/lecturer_sample.png
