danhcln/AIOT-BLACK-BOX/Schematic_Thay/AIOT_BLACKBOX_PRESENTATION/rev5_main_full.png

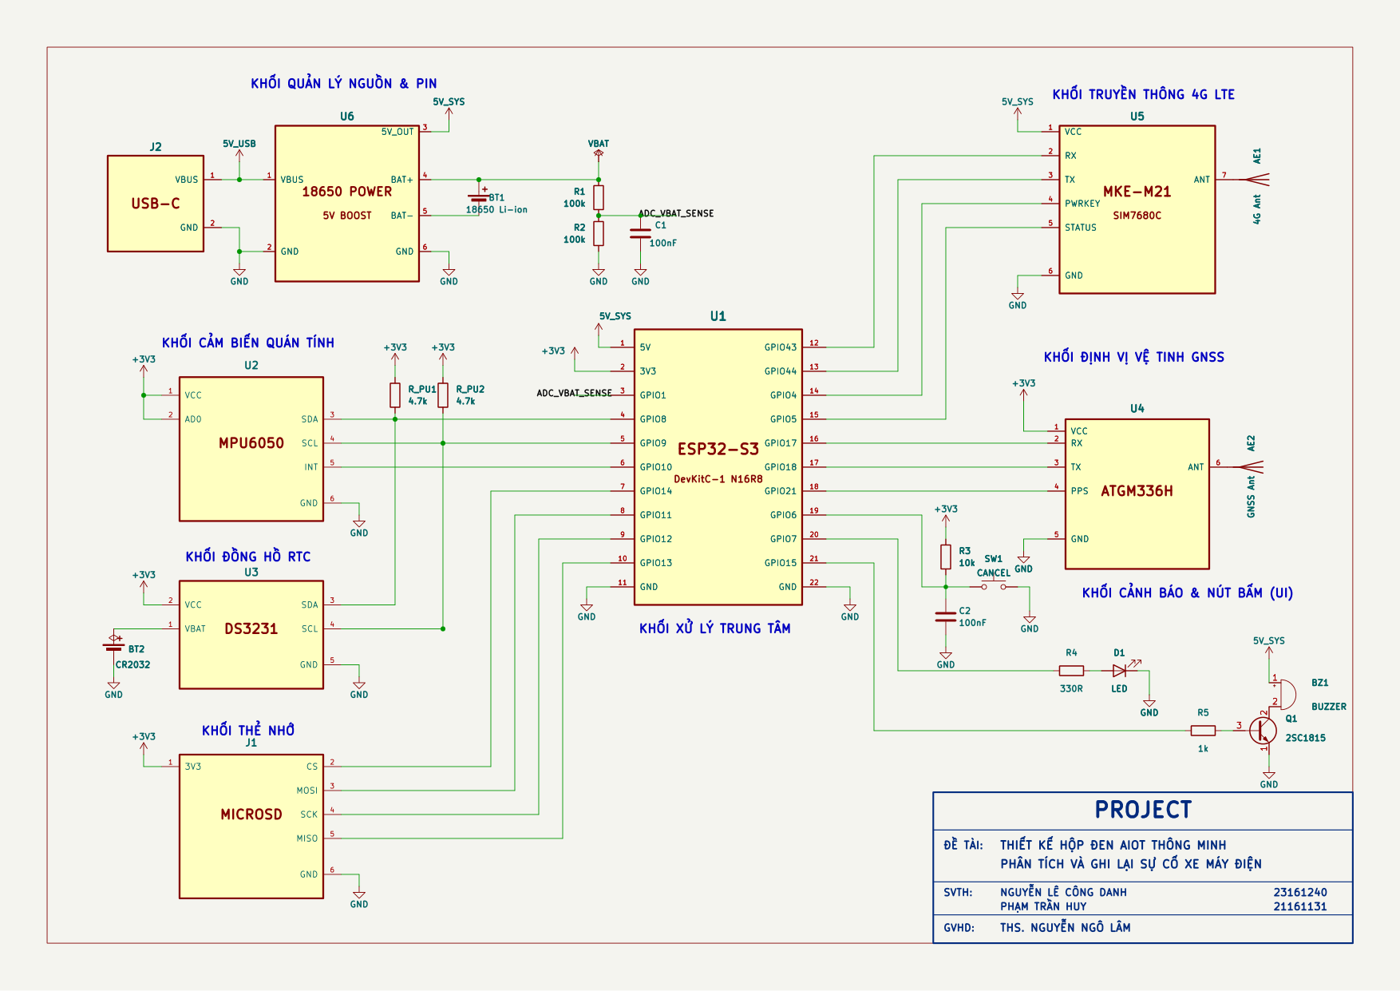
Schematic_Thay/AIOT_BLACKBOX_PRESENTATION/rev5_main_full.png
