danhcln/AIOT-BLACK-BOX/Schematic_Thay/AIOT_BLACKBOX_PRESENTATION/rev5_main_ui_crop.png

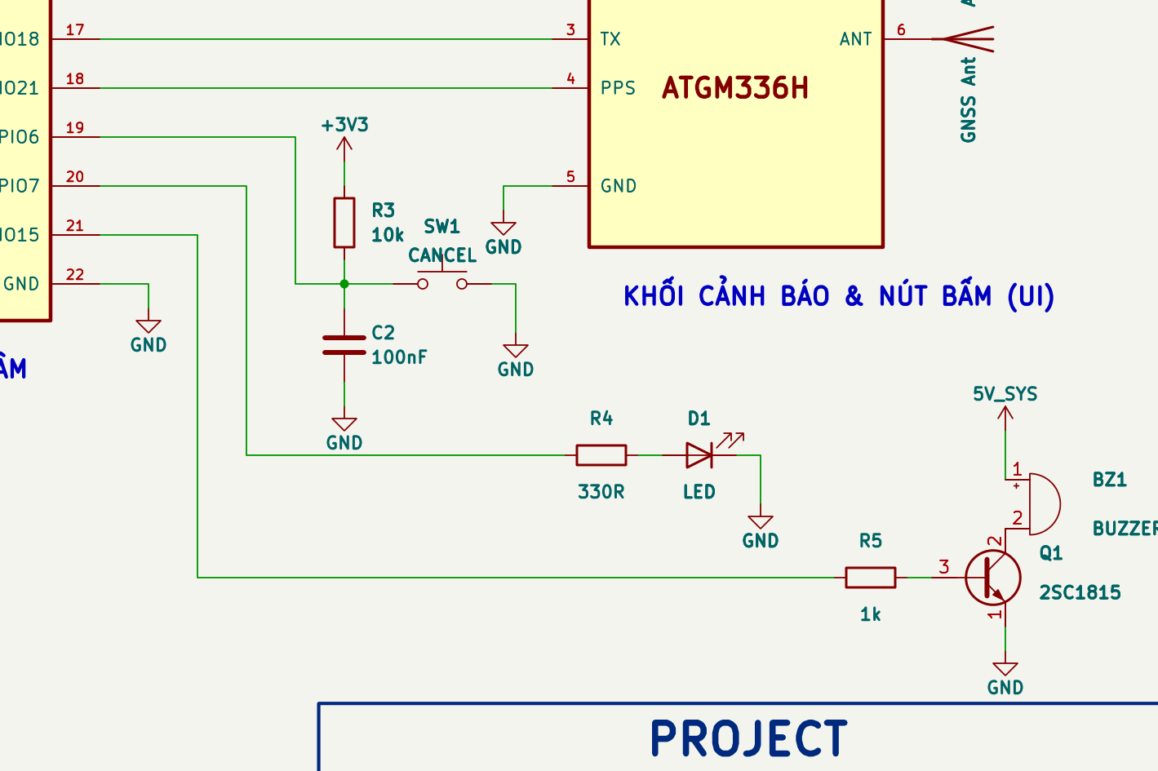
Schematic_Thay/AIOT_BLACKBOX_PRESENTATION/rev5_main_ui_crop.png
