danhcln/AIOT-BLACK-BOX/THIET_KE_KHOI_NGUON/fig1_power_architecture_bw.png

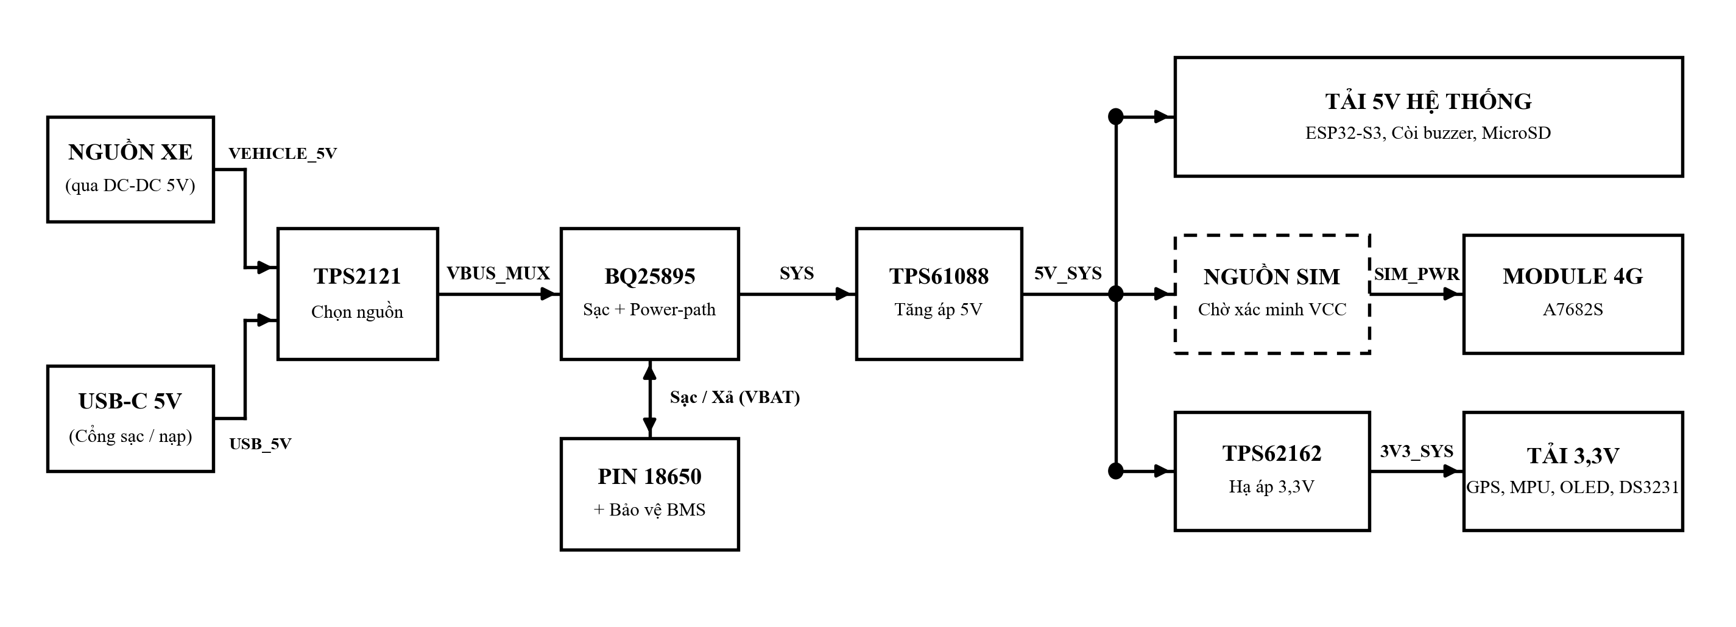
THIET_KE_KHOI_NGUON/fig1_power_architecture_bw.png
