danhcln/AIOT-BLACK-BOX/THIET_KE_KHOI_NGUON/fig_kicad_rails.png

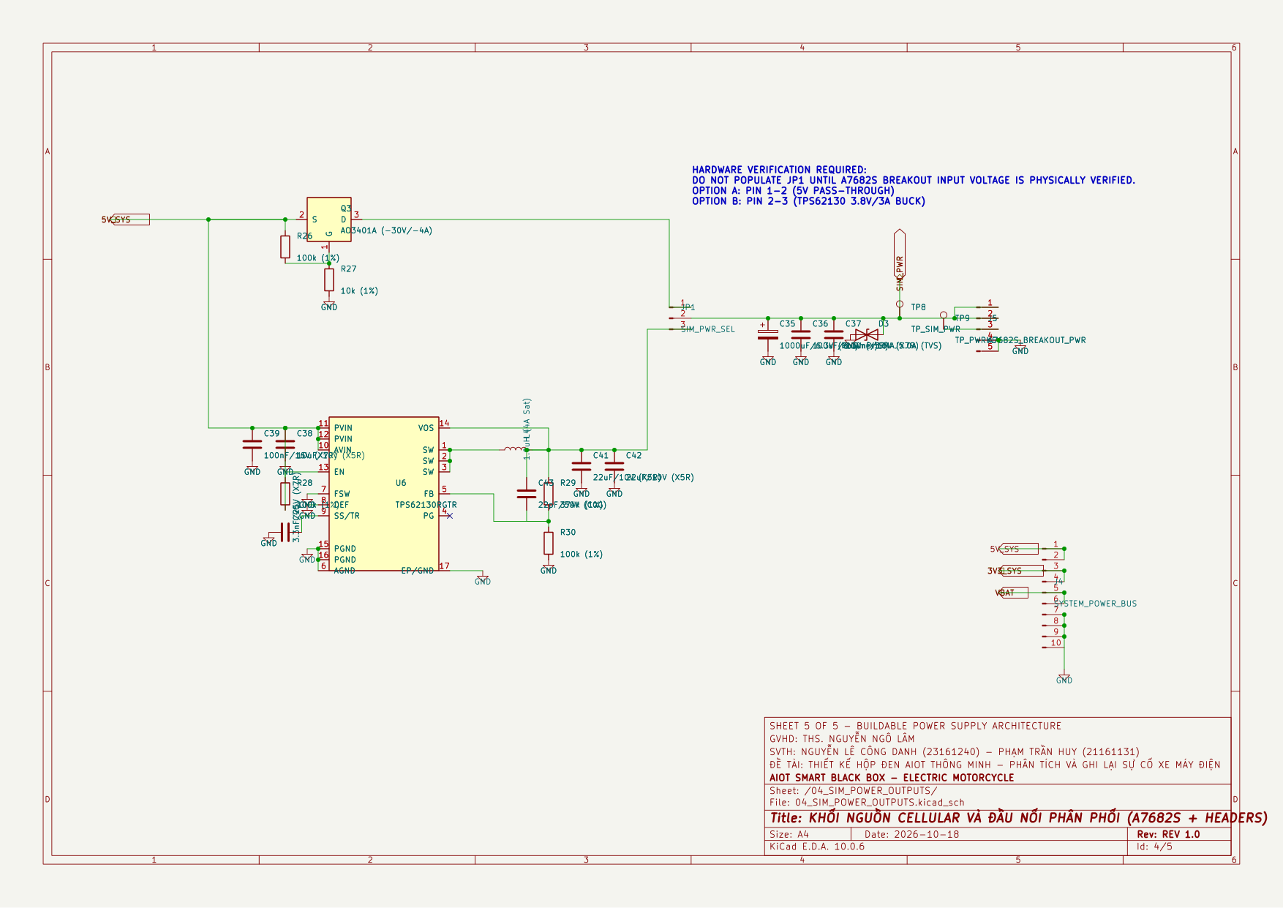
THIET_KE_KHOI_NGUON/fig_kicad_rails.png
