danhcln/AIOT-BLACK-BOX/THIET_KE_KHOI_NGUON/fig_kicad_root.png

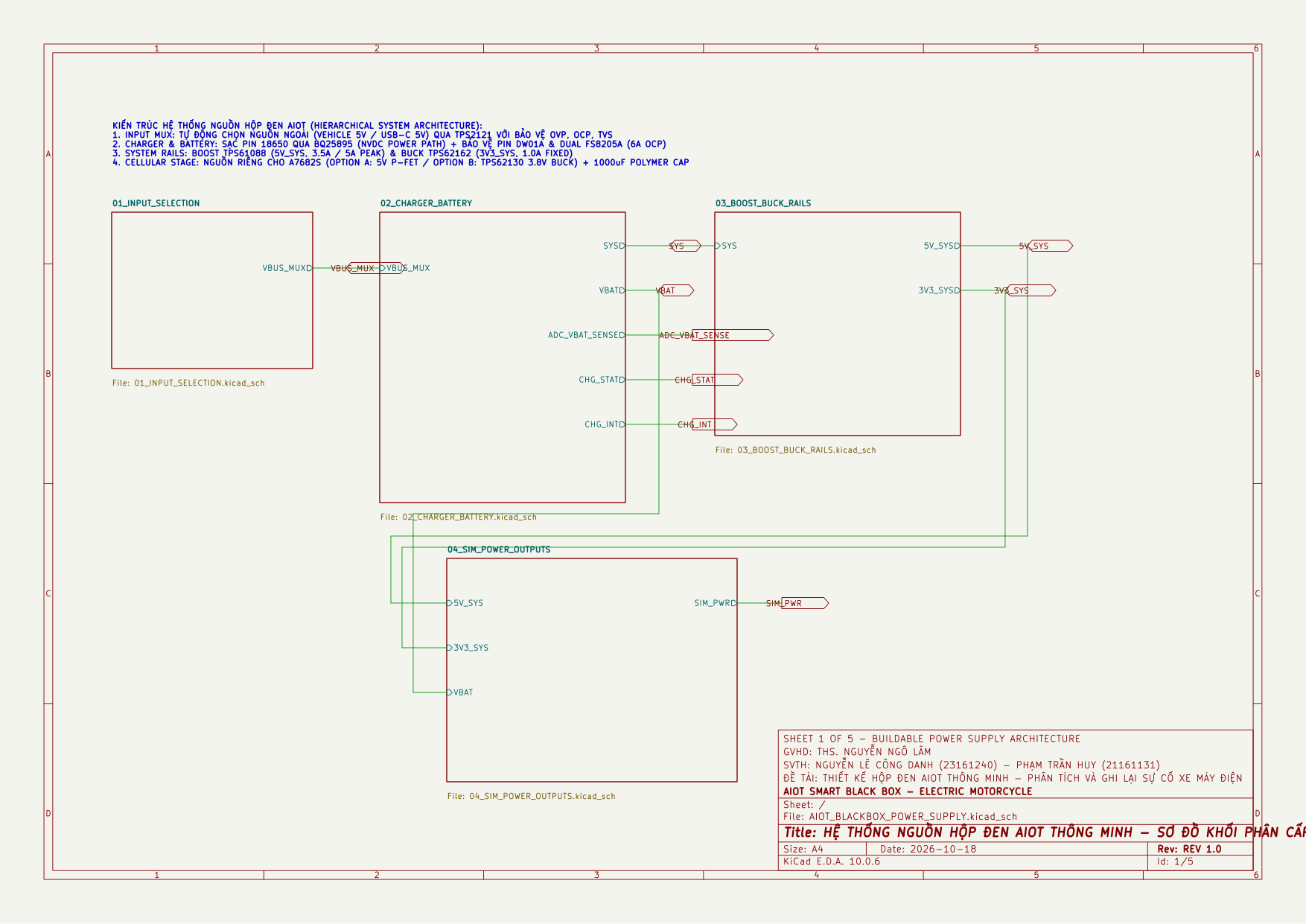
THIET_KE_KHOI_NGUON/fig_kicad_root.png
