danhcln/AIOT-BLACK-BOX/THIET_KE_KHOI_NGUON/fig_power_architecture.png

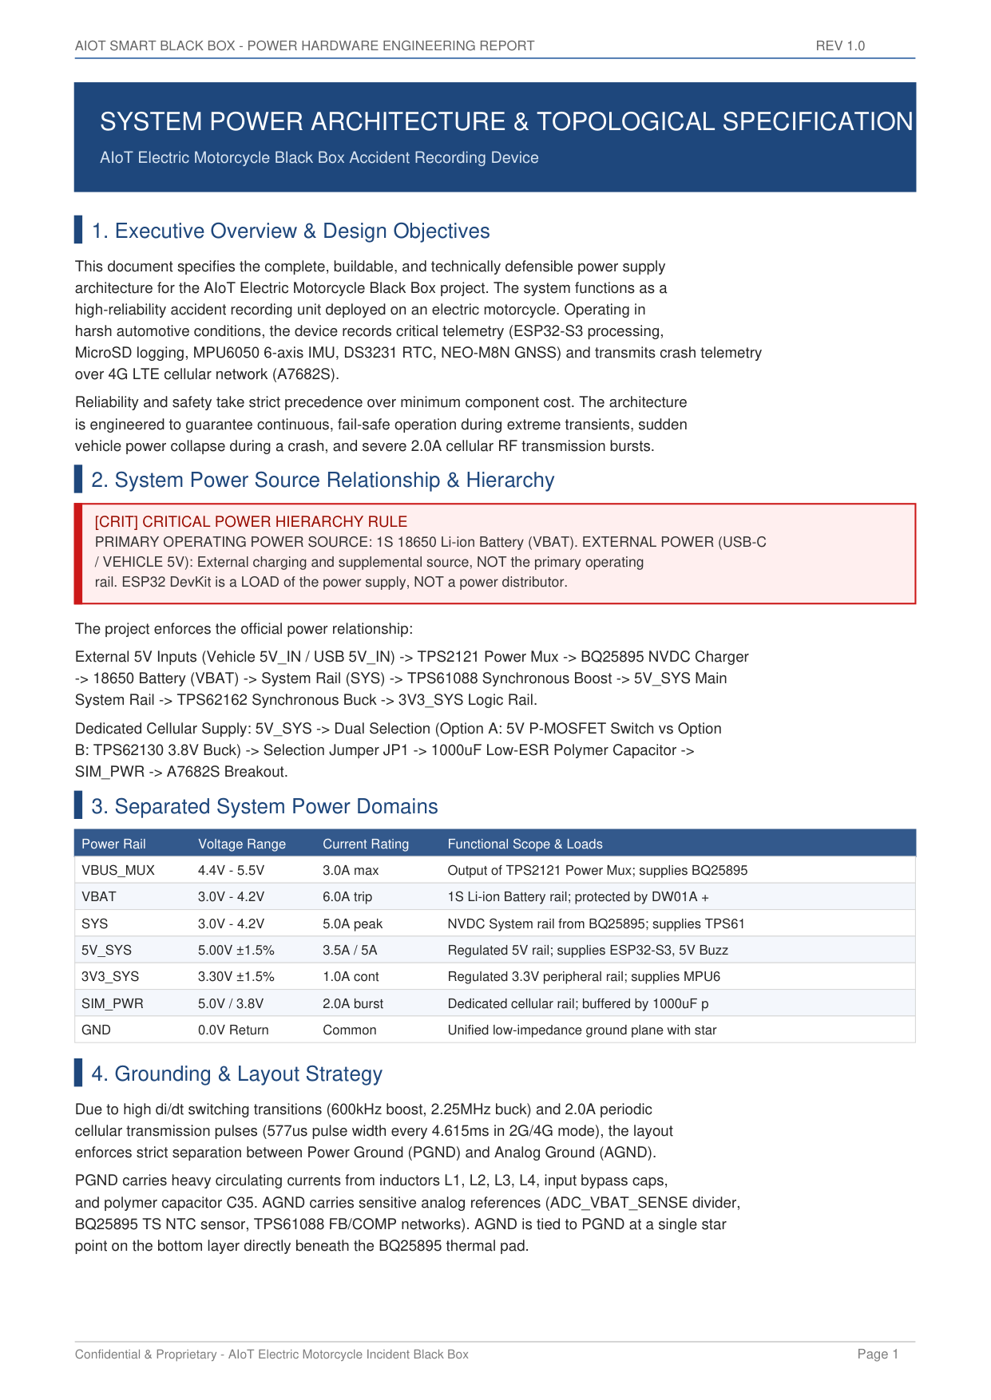
THIET_KE_KHOI_NGUON/fig_power_architecture.png
