danhcln/AIOT-BLACK-BOX/PCB_AIOT_BLACKBOX/AIOT_BLACKBOX_MAINBOARD_REV1/GATE_0_AUDIT/FOOTPRINT_VERIFICATION.csv

Module_Name | Actual_Pinout | Module_Dimensions | Pin_And_Row_Pitch | Recommended_Mounting_Style | KiCad_Footprint | Verification_Source | Status | Required_User_Measurement_Or_Photo
1. ESP32-S3-DevKitC-1 N16R8 | 44 chân (2x22): Trái [3V3(1,2), RST(3), GPIO4..7,15..18,8,3,46,9..14,21,47,48,45,0,35..38,39..42,44,43,2,1,5V(21),GND(22,23,43,44)] | PENDING (Chiều dàixRộng board thực tế chưa đo; thường ~63mm x 25.4mm hoặc ~69mm x 28mm tùy hãng clone) | Pitch chân: 2.54mm (100mil); Khoảng cách tâm 2 hàng chân (Row Pitch): PENDING (22.86mm / 900mil hoặc 25.40mm / 1000mil) | Cắm trên 2 dãy Female Pin Header 1x22 (2.54mm) hàn xuyên lỗ (THT) trên mặt F.Cu, hàn ở B.Cu | PENDING (Chờ chốt Row Pitch 22.86mm hay 25.40mm từ 2x Connector_PinSocket_2.54mm:PinSocket_1x22_P2.54mm_Vertical) | Datasheet Espressif ESP32-S3-DevKitC-1 & Đo thực tế bằng thước kẹp | PENDING | Đo khoảng cách tâm-đến-tâm giữa 2 hàng chân 22-pin (22.86mm hay 25.40mm), chiều dài x rộng phủ bì của board, và chụp ảnh rõ mặt chữ in tên 44 chân bên cạnh header
2. OLED SSD1306 0.96 inch (4 chân) | 4 chân I2C: PENDING thứ tự chân nguồn (Chuẩn A: GND-VCC-SCL-SDA hoặc Chuẩn B: VCC-GND-SCL-SDA); Địa chỉ I2C = 0x3C | PENDING (Thường ~27.0mm x 27.0mm hoặc ~27.3mm x 27.8mm; chưa đo lỗ vít định vị) | Pitch chân: 2.54mm (1x4 pins) | Cắm trên Female Header 1x04 (2.54mm) trên PCB hoặc dùng cáp 4 sợi nối từ Connector 1x04 lên nắp hộp đen | Connector_PinSocket_2.54mm:PinSocket_1x04_P2.54mm_Vertical (Cần khóa thứ tự chân 1-2-3-4 theo ảnh thật) | Kiểm tra chữ in lụa (Silkscreen) mặt trước module OLED thực tế | PENDING | Chụp ảnh mặt trước module OLED 0.96 inch thấy rõ thứ tự 4 chữ in trên chân (GND-VCC-SCL-SDA hay VCC-GND-SCL-SDA) và đo khoảng cách tâm các lỗ vít nếu gắn cố định trên PCB
3. MPU6050 GY-521 (8 chân) | 8 chân: VCC - GND - SCL - SDA - XDA - XCL - AD0 - INT (Trong đó AD0 nối 3V3_SYS -> 0x69; XDA, XCL, INT = NC) | PENDING (Thường ~21.0mm x 16.0mm; cần đo vị trí chính xác 2 lỗ bắt vít M2.5/M3) | Pitch chân: 2.54mm (1x8 pins); Khoảng cách tâm 2 lỗ vít: PENDING | Hàn/cắm trên Header 1x08 (2.54mm) KẾT HỢP bắt vít trụ đồng cứng xuống PCB (bắt buộc chống rung cơ học cho cảm biến gia tốc theo RULE 14) | Connector_PinSocket_2.54mm:PinSocket_1x08_P2.54mm_Vertical + 2x MountingHole | Kiểm tra module GY-521 thực tế đang chạy trên breadboard | PENDING | Chụp ảnh mặt trên/dưới module GY-521, đo kích thước DàixRộng và khoảng cách tâm 2 lỗ bắt vít định vị so với hàng chân 8-pin
4. DS3231 RTC (6 chân) | 6 chân: 32K - SQW - SCL - SDA - VCC - GND (32K, SQW = NC; Địa chỉ I2C = 0x68) | PENDING (Module ZS-042 có khay pin CR2032 thường ~38.0mm x 22.0mm x cao 14mm; hoặc bản mini) | Pitch chân: 2.54mm (1x6 pins) | Cắm trên Female Header 1x06 (2.54mm) hoặc Header góc vuông 90 độ tùy chiều cao hộp | Connector_PinSocket_2.54mm:PinSocket_1x06_P2.54mm_Vertical | Kiểm tra module DS3231 thực tế đang chạy với filecodemain.cpp | PENDING | Chụp ảnh module DS3231 thực tế (xác nhận là bản ZS-042 6 chân có pin CR2032 hay bản khác), đo kích thước bao phủ để chừa vùng trống trên PCB không cấn module khác
5. GPS NEO-M8N Breakout | PENDING số chân: 5 chân (VCC - RX - TX - TIMEPULSE/PPS - GND) hoặc 4 chân (VCC - RX - TX - GND); PPS = NC | PENDING (Kích thước PCB module + kích thước anten gốm patch rời hay liền board) | Pitch chân: 2.54mm (1x5 hoặc 1x4 pins) | Cắm trên Female Header 2.54mm hoặc nối qua cáp JST/Dupont để đặt anten gốm hướng lên mặt trên hộp đen | Connector_PinSocket_2.54mm:PinSocket_1x05_P2.54mm_Vertical (hoặc 1x04 tùy module thực tế) | Kiểm tra module NEO-M8N thực tế | PENDING | Chụp ảnh module GPS NEO-M8N (cả phần board và anten), xác nhận header có 4 chân hay 5 chân (có chân PPS không), thứ tự chân và điện áp VCC đang cấp trên breadboard (3.3V hay 5V)
6. MicroSD Breakout (6 chân) | 6 chân SPI: PENDING thứ tự chân & tên chân nguồn (Loại 1: GND-VCC(5V)-MISO-MOSI-SCK-CS có LDO AMS1117; Loại 2: 3V3-CS-MOSI-SCK-MISO-GND) | PENDING (Thường ~42.0mm x 24.0mm đối với bản Catalex có LDO, hoặc ~18mm x 18mm bản mini) | Pitch chân: 2.54mm (1x6 pins) | Cắm trên Female Header 1x06 (2.54mm) đặt gần mép bo để dễ rút/cắm thẻ nhớ MicroSD (RULE 16) | Connector_PinSocket_2.54mm:PinSocket_1x06_P2.54mm_Vertical | Kiểm tra module MicroSD thực tế đang chạy với filecodemain.cpp | PENDING | Chụp ảnh 2 mặt module MicroSD (xác nhận có IC LDO AMS1117-3.3 + LVC125A trên module hay không, chân nguồn ghi là VCC hay 3V3, và thứ tự 6 chân từ 1 đến 6)
7. SIM A7682S Breakout | PENDING (Cần xác minh số chân header, thứ tự chân VCC/VIN/VBAT, GND, TXD, RXD, PWRKEY, STATUS, RST) | PENDING (Chưa có kích thước bao phủ, vị trí khe SIM và vị trí đầu cắm anten u.FL/SMA) | Pitch chân: PENDING (Thường 2.54mm) | Cắm trên Female Header 2.54mm gần mép bo (thuận tiện tháo lắp SIM và đi dây anten 4G ra ngoài vỏ) | PENDING / CONNECTOR_ONLY (Chưa gán footprint cố định cho đến khi xác minh pinout & điện áp VCC) | Kiểm tra trực tiếp module breakout A7682S thực tế | PENDING | BẮT BUỘC chụp ảnh rõ mặt trước + mặt sau module A7682S breakout: đọc rõ tên từng chân, kiểm tra có mạch nguồn hạ áp/diode trên module không, và điện áp đang cấp cho chân VCC khi test thực tế là bao nhiêu Volt
8. Module Regulator 3.3V (U6) | 4 chân/pad: IN+ (5V_SYS), IN- (GND), OUT+ (3V3_SYS), OUT- (GND) | PENDING (Chưa quyết định mã module: Mini-360, MP1584, AMS1117-3.3 module, hay DD4012SA) | PENDING (Tùy thuộc module thực tế hoặc dùng Header 4 chân chờ) | Hàn qua Pin Header 2.54mm hoặc Connector 4 chân chờ (CONNECTOR_ONLY cho đến khi chốt mã module) | CONNECTOR_ONLY (Tạm thời mô hình hóa 4 chân IN+, IN-, 3V3, GND; chưa gán footprint cố định) | Kiểm tra module hạ áp 3.3V thực tế của nhóm | PENDING | Chụp ảnh hoặc cho biết mã module nguồn 3.3V đang dùng thực tế (đo kích thước và khoảng cách giữa các chân IN+/IN-/OUT+/OUT-)
9. Connector nguồn, Buzzer, LED, Nút CANCEL | - J2 (UPS_IN): 2 chân (UPS+ -> 5V_SYS, UPS- -> GND)\n- J3 (SIM_PWR): 2 chân (V_SIM, GND)\n- Buzzer (BZ1+Q1+R5), LED (D1+R4), CANCEL (SW1+R3+C2): Trạng thái dự phòng (UNASSIGNED) | Linh kiện rời xuyên lỗ (THT) tiêu chuẩn: Domino 5.08mm, Buzzer D12mm, LED 5mm, Nút nhấn 6x6mm hoặc Header 2-pin | J2/J3: Pitch 5.08mm (Domino) hoặc 2.54mm; Buzzer: Pitch 7.62mm; LED/Header: Pitch 2.54mm; R/C/Q1: THT tiêu chuẩn | Hàn xuyên lỗ (Through-Hole) mặt F.Cu, đường đồng mặt B.Cu; Các chân điều khiển Buzzer/LED/CANCEL đưa ra Pad/Header chờ độc lập (không nối giả vào ESP32) | - J2, J3: TerminalBlock_Phoenix:TerminalBlock_Phoenix_MKDS-1,5-2-5.08 (hoặc PinHeader_1x02_P2.54mm)\n- Dự phòng UI: THT / PinHeader_1x02_P2.54mm_Vertical | Quy chuẩn linh kiện THT phổ thông & RULE 06, RULE 08 | CONNECTOR_ONLY | Xác nhận loại cổng nguồn muốn dùng cho dây từ LX-2BUPS vào PCB (Domino vặn vít 5.08mm hay giắc cắm JST-XH / KF2510) và xác nhận nút CANCEL/LED gắn trên PCB hay kéo dây lên vỏ hộp
