danhcln/AIOT-BLACK-BOX/PCB_AIOT_BLACKBOX/AIOT_BLACKBOX_MAINBOARD_REV1/GATE_1_FOOTPRINT/FOOTPRINT_VERIFICATION_FINAL.csv

Ref | Component_Name | Mounting_Style | Pin_Count | Pitch_mm | Row_Spacing_mm | Pad_Size_mm | Drill_mm | Pin_1_to_N_Order_Verified | Assigned_Footprint_in_AIOT_Blackbox_Local | Verification_Status
U1 | ESP32-S3-DevKitC-1 N16R8 | PLUGGABLE_SOCKET_2x22 | 44 (2x22) | 2.54 | 25.40 (1000 mil) | 2.20x1.60 | 1.00 | Left 1..22 (3V3..GND), Right 23..44 (GND..GND) [Non-DIP-44 Top-to-Bottom] | ESP32_S3_N16R8_Socket_2x22_P2.54mm_Row25.40mm_SingleLayer | LOCKED_VERIFIED
U7 | OLED 0.96 GM009605v4.3 | PLUGGABLE_MODULE_1x04 | 4 | 2.54 | N/A | 2.00x2.40 | 1.00 | 1:GND, 2:VDD(3V3_SYS), 3:SCK(GPIO9), 4:SDA(GPIO8) | OLED_0.96_GM009605v4.3_1x04_P2.54mm_SingleLayer | LOCKED_VERIFIED
U2 | MPU6050 GY-521 | PLUGGABLE_MODULE_1x08 | 8 | 2.54 | N/A | 2.00x2.40 | 1.00 | 1:VCC(3V3_SYS), 2:GND, 3:SCL, 4:SDA, 5:XDA(NC), 6:XCL(NC), 7:AD0(3V3_SYS), 8:INT(NC) | Module_GY-521_MPU6050_1x08_P2.54mm_SingleLayer | LOCKED_VERIFIED
U3 | RTC DS3231 ZS-042 | PLUGGABLE_MODULE_1x06 | 6 | 2.54 | N/A | 2.00x2.40 | 1.00 | 1:32K(NC), 2:SQW(NC), 3:SCL, 4:SDA, 5:VCC(3V3_SYS), 6:GND | Module_DS3231_ZS042_1x06_P2.54mm_SingleLayer | LOCKED_VERIFIED
J1 | MicroSD Card Adapter | PLUGGABLE_MODULE_1x06 | 6 | 2.54 | N/A | 2.00x2.40 | 1.00 | 1:CS(GPIO10), 2:SCK(GPIO12), 3:MOSI(GPIO11), 4:MISO(GPIO13), 5:VCC(5V_SYS), 6:GND | Module_MicroSD_Adapter_1x06_P2.54mm_SingleLayer | LOCKED_VERIFIED
U4 | GPS NEO-M8N V2149 | CONNECTOR_ONLY_1x05 | 5 | 2.54 | N/A | 2.00x2.40 | 1.00 | 1:VCC(3V3_SYS), 2:GND, 3:TXD(GPIO18), 4:RXD(GPIO17), 5:PPS(NC) | Conn_GPS_NEO-M8N_V2149_1x05_P2.54mm_SingleLayer | LOCKED_VERIFIED
U5 | SIM 4G A7680C Breakout (J6) | CONNECTOR_ONLY_1x05 | 5 | 2.54 | N/A | 2.00x2.40 | 1.00 | 1:VCC(SIM_PWR 5V), 2:RST(NC), 3:RXD(GPIO16), 4:TXD(GPIO15), 5:GND | Conn_SIM_Breakout_J6_1x05_P2.54mm_SingleLayer | LOCKED_VERIFIED
U6 | Regulator 3.3V Module | PLUGGABLE_OR_CONN_1x04 | 4 | 2.54 | N/A | 2.00x2.40 | 1.00 | 1:IN+(5V_SYS), 2:IN-(GND), 3:3V3(3V3_SYS), 4:GND | Conn_Regulator_3V3_1x04_P2.54mm_SingleLayer | LOCKED_VERIFIED
J2 | LX-2BUPS 5V/3A Input | DIRECT_SOLDER_THT_1x02 | 2 | 5.08 | N/A | 3.00x3.00 | 1.30 | 1:UPS+(5V_SYS), 2:UPS-(GND) | TermBlock_1x02_P5.08mm_SingleLayer | LOCKED_VERIFIED
J3 | SIM_PWR Star Branch | DIRECT_SOLDER_THT_1x02 | 2 | 2.54 | N/A | 2.10x2.40 | 1.00 | 1:5V_IN(5V_SYS), 2:V_SIM(SIM_PWR) | PinHeader_1x02_P2.54mm_SingleLayer | LOCKED_VERIFIED
R_PU1..R6 | Axial Resistors (6 pcs) | DIRECT_SOLDER_THT_AXIAL | 2 | 10.16 | N/A | 2.20x2.20 | 0.90 | 1:Pad 1, 2:Pad 2 | R_Axial_DIN0207_P10.16mm_SingleLayer | LOCKED_VERIFIED
C1 | C2 | C4 | Ceramic Disc Caps 100nF (3 pcs) | DIRECT_SOLDER_THT_DISC | 2 | 5.08 | N/A | 2.20x2.20 | 0.90 | 1:Pad 1, 2:Pad 2 | C_Disc_D5.0mm_P5.08mm_SingleLayer | LOCKED_VERIFIED
C3 | Electrolytic Cap 470uF Low-ESR | DIRECT_SOLDER_THT_RADIAL | 2 | 5.08 | N/A | 2.20x2.20 | 0.90 | 1:+(SIM_PWR), 2:-(GND) | CP_Radial_D8.0mm_P5.08mm_SingleLayer | LOCKED_VERIFIED
Q1 | 2SC1815 NPN Transistor | DIRECT_SOLDER_THT_TO92 | 3 | 2.54 | 1.905 staggered | 2.00x2.00 | 0.90 | 1:Emitter(GND), 2:Collector(BZ1-), 3:Base(R5/R6) | TO-92_2SC1815_ECB_Staggered_SingleLayer | LOCKED_VERIFIED
BZ1 | 5V Active Buzzer 12mm | DIRECT_SOLDER_THT_BUZZER | 2 | 7.62 | N/A | 2.40x2.40 | 1.00 | 1:+(5V_SYS), 2:-(Q1 Collector) | Buzzer_D12.0mm_P7.62mm_SingleLayer | LOCKED_VERIFIED
D1 | LED Status 5mm | DIRECT_SOLDER_THT_LED | 2 | 2.54 | N/A | 2.00x2.20 | 0.90 | 1:Kathode(GND), 2:Anode(R4) | LED_D5.0mm_P2.54mm_SingleLayer | LOCKED_VERIFIED
SW1 | CANCEL Button Header | CONNECTOR_ONLY_1x02 | 2 | 2.54 | N/A | 2.10x2.40 | 1.00 | 1:CANCEL(GPIO6), 2:GND | PinHeader_1x02_P2.54mm_SingleLayer | LOCKED_VERIFIED
TP1..TP4 | Test Points (5V | 3V3 | SIM | GND) | DIRECT_SOLDER_THT_PAD | 1 | N/A | N/A | 2.20x2.20 | 1.00 | 1:Test Point Pad | TestPoint_THTPad_D2.2mm_Drill1.0mm_SingleLayer | LOCKED_VERIFIED
