danhcln/AIOT-BLACK-BOX/DATASHEET_LINH_KIEN/DATASHEET_INDEX.csv

STT | Project Component | Exact Project Part | Board / Module | Document Number | Document Title | Document Type | Manufacturer / Publisher | Official Source URL | Local Filename | Relation To Actual Project Component | Verification Status | Notes
1 | ESP32-S3 | ESP32-S3 / ESP32-S3-DevKitC-1 N16R8 | ESP32-S3-DevKitC-1 Development Board | 01 | ESP32-S3 Series Datasheet | Datasheet / Product Specification | Espressif Systems | https://www.espressif.com/sites/default/files/documentation/esp32-s3_datasheet_en.pdf | 01_ESP32_S3\01_DATASHEET_ESP32-S3_SERIES_DATASHEET.pdf | Direct SoC chip datasheet for ESP32-S3 | VERIFIED | Official Espressif SoC specifications, pinout, power consumption, RF characteristics.
2 | ESP32-S3 | ESP32-S3 / ESP32-S3-DevKitC-1 N16R8 | ESP32-S3-DevKitC-1 Development Board | 02 | ESP32-S3 Technical Reference Manual | Technical Reference Manual / Register Architecture | Espressif Systems | https://www.espressif.com/sites/default/files/documentation/esp32-s3_technical_reference_manual_en.pdf | 01_ESP32_S3\02_TECHNICAL_ESP32-S3_TECHNICAL_REFERENCE_MANUAL.pdf | Complete hardware register map and peripheral architecture manual for ESP32-S3 | VERIFIED | Official Espressif 1500+ page reference manual covering internal architecture, DMA, I2C, SPI, UART, ADC.
3 | ESP32-S3 | ESP32-S3 / ESP32-S3-DevKitC-1 N16R8 | ESP32-S3-DevKitC-1 Development Board | 03 | ESP32-S3-WROOM-1 / WROOM-1U Module Datasheet | Module Datasheet / Hardware Reference | Espressif Systems | https://www.espressif.com/sites/default/files/documentation/esp32-s3-wroom-1_wroom-1u_datasheet_en.pdf | 01_ESP32_S3\03_REFERENCE_ESP32-S3-WROOM-1_MODULE_DATASHEET.pdf | Direct module datasheet for the exact WROOM-1 module integrated on DevKitC-1 N16R8 | VERIFIED | Official Espressif module hardware document detailing flash/PSRAM configuration (N16R8), RF layout, dimensions.
4 | MPU-6050 | MPU-6050 / GY-521 Breakout Board | GY-521 6-DOF IMU Module | 01 | MPU-6000 and MPU-6050 Product Specification Revision 3.4 | Datasheet / Product Specification | InvenSense / TDK | https://invensense.tdk.com/wp-content/uploads/2015/02/MPU-6000-Datasheet1.pdf | 02_MPU6050_GY521\01_DATASHEET_MPU-6000_MPU-6050_PRODUCT_SPECIFICATION.pdf | Direct sensor chip specification for MPU-6050 | VERIFIED | Official InvenSense PS-MPU-6000A-00 document covering 3-axis gyro + 3-axis accelerometer electrical parameters.
5 | MPU-6050 | MPU-6050 / GY-521 Breakout Board | GY-521 6-DOF IMU Module | 02 | MPU-6000 and MPU-6050 Register Map and Descriptions Revision 4.0 | Technical Register Map & Programming Guide | InvenSense / TDK | https://cdn.sparkfun.com/datasheets/Sensors/Accelerometers/RM-MPU-6000A.pdf | 02_MPU6050_GY521\02_TECHNICAL_MPU-6000_MPU-6050_REGISTER_MAP.pdf | Direct register programming reference for MPU-6050 | VERIFIED | Official InvenSense RM-MPU-6000A-00 document defining all I2C registers, FIFO, interrupts, DMP configuration.
6 | MPU-6050 | MPU-6050 / GY-521 Breakout Board | GY-521 6-DOF IMU Module | 03 | MPU-6000/MPU-6050 EV Board User Guide (AN-MPU-6000EVB-00) | Hardware User Guide / Reference Design | InvenSense / TDK | https://mm.digikey.com/Volume0/opasdata/d220001/medias/docus/3984/MPU-6000_6050_EvalBrd_UG.pdf | 02_MPU6050_GY521\03_REFERENCE_MPU-6000_MPU-6050_EVALUATION_BOARD_USER_GUIDE.pdf | Evaluation board hardware schematic and circuit implementation guide for MPU-6050 | VERIFIED | Official InvenSense reference design showing external decoupling capacitors, I2C pull-up circuitry, BOM.
7 | DS3231 | DS3231 Real-Time Clock | ZS-042 / Generic DS3231 RTC Module | 01 | DS3231 Extremely Accurate I2C-Integrated RTC/TCXO/Crystal Datasheet | Datasheet / Product Specification | Maxim Integrated / Analog Devices | https://www.analog.com/media/en/technical-documentation/data-sheets/ds3231.pdf | 03_DS3231\01_DATASHEET_DS3231_EXTREMELY_ACCURATE_RTC.pdf | Direct RTC IC datasheet for DS3231 | VERIFIED | Official Maxim/ADI datasheet detailing TCXO oscillator, ±2ppm accuracy, VBAT battery backup, registers.
8 | DS3231 | DS3231 Real-Time Clock | ZS-042 / Generic DS3231 RTC Module | 02 | Adafruit DS3231 Precision RTC Breakout Hardware & Programming Guide | Hardware Technical Guide / Application Note | Adafruit Industries | https://cdn-learn.adafruit.com/downloads/pdf/adafruit-ds3231-precision-rtc-breakout.pdf | 03_DS3231\02_TECHNICAL_ADAFRUIT_DS3231_PRECISION_RTC_BREAKOUT_GUIDE.pdf | Practical breakout board hardware design, schematic, and I2C wiring guide for DS3231 | VERIFIED | Comprehensive 24-page guide detailing circuit schematic, pinouts, level shifting, battery backup, Arduino/Python code.
9 | DS3231 | DS3231 Real-Time Clock | ZS-042 / Generic DS3231 RTC Module | 03 | Waveshare Pico-RTC-DS3231 Board Circuit Schematic Reference | Module Schematic Reference | Waveshare Electronics | https://files.waveshare.com/upload/0/08/Pico-RTC-DS3231_Sch.pdf | 03_DS3231\03_REFERENCE_WAVESHARE_PICO_RTC_DS3231_SCHEMATIC.pdf | Direct hardware schematic for DS3231 RTC breakout module implementation | VERIFIED | Official Waveshare schematic showing DS3231 connection to I2C bus, coin battery holder, decoupling capacitors, address 0x68.
10 | NEO-M8N | u-blox NEO-M8N GNSS Module | NEO-M8N Breakout Board with Patch Antenna | 01 | NEO-M8 series u-blox M8 concurrent GNSS modules Data Sheet (UBX-15031086) | Datasheet / Product Specification | u-blox AG | https://content.u-blox.com/sites/default/files/NEO-M8-FW3_DataSheet_UBX-15031086.pdf | 04_NEO_M8N\01_DATASHEET_NEO-M8_CONCURRENT_GNSS_MODULES.pdf | Direct GNSS module datasheet for u-blox NEO-M8N | VERIFIED | Official u-blox datasheet detailing 72-channel concurrent GNSS engine (GPS, GLONASS, BeiDou, Galileo), pinouts, power.
11 | NEO-M8N | u-blox NEO-M8N GNSS Module | NEO-M8N Breakout Board with Patch Antenna | 02 | u-blox 8 / u-blox M8 Receiver Description Including Protocol Specification (UBX-13003221) | Technical Protocol Specification & User Manual | u-blox AG | https://content.u-blox.com/sites/default/files/products/documents/u-blox8-M8_ReceiverDescrProtSpec_UBX-13003221.pdf | 04_NEO_M8N\02_TECHNICAL_UBLOX_M8_RECEIVER_DESCRIPTION_PROTOCOL_SPEC.pdf | Complete protocol manual covering NMEA, UBX, and RTCM messages for NEO-M8N | VERIFIED | Official u-blox 475-page manual detailing binary UBX messages, NMEA sentence formats, navigation configuration.
12 | NEO-M8N | u-blox NEO-M8N GNSS Module | NEO-M8N Breakout Board with Patch Antenna | 03 | NEO-8Q / NEO-M8 u-blox 8 / M8 GNSS modules Hardware Integration Manual (UBX-15029985) | Hardware Design & Integration Guide | u-blox AG | https://content.u-blox.com/sites/default/files/NEO-8Q-NEO-M8-FW3_HIM_UBX-15029985.pdf | 04_NEO_M8N\03_REFERENCE_NEO-M8_HARDWARE_INTEGRATION_MANUAL.pdf | Hardware integration, RF antenna design, layout and supply guidelines for NEO-M8N | VERIFIED | Official u-blox guide for active/passive antenna design, RF matching 50 Ohm, power supply decoupling, backup battery.
13 | MKE-M21 4G | MKE-M21 / Marketed as SIM7680C 4G Module | MKE-M21 4G SMS/CALL Development Board | 01 | Mạch MKE-M21 SIM7680C 4G SMS/CALL Module Official Hardware Technical Manual | Module User Manual & Hardware Specification | MakerEdu Vietnam / Hshop.vn | https://github.com/makereduvn/MKE-M21-SIM7680C-4G-MODULE | 05_MKE_M21_4G\01_DATASHEET_MKE-M21_SIM7680C_MODULE_USER_MANUAL.pdf | Direct breakout module technical manual, pinouts, and electrical ratings for MKE-M21 board | UNDERLYING CELLULAR MODULE = NOT VERIFIED | Official MakerEdu documentation: pin definitions, power supply (3.7-4V / 5-24V), UART 3.3V/5V logic, VoLTE requirements.
14 | MKE-M21 4G | MKE-M21 / Marketed as SIM7680C 4G Module | MKE-M21 4G SMS/CALL Development Board | 02 | SIMCom A7680C Series Hardware Design Manual V1.06 | Hardware Design Manual / Technical Specification | SIMCom Wireless Solutions | https://www.simcom.com/ | 05_MKE_M21_4G\02_TECHNICAL_SIMCOM_A7680C_HARDWARE_DESIGN_MANUAL.pdf | Hardware design manual for underlying SIMCom Cat-1 cellular architecture | UNDERLYING CELLULAR MODULE = NOT VERIFIED | Official SIMCom 76-page hardware design manual: power management, RF burst handling, UART, antenna circuit.
15 | MKE-M21 4G | MKE-M21 / Marketed as SIM7680C 4G Module | MKE-M21 4G SMS/CALL Development Board | 03 | SIMCom A7600 Series AT Command Manual V1.01 | AT Command Technical Manual | SIMCom Wireless Solutions | https://files.waveshare.com/upload/d/dd/A7600_Series_AT_Command_Manual_V1.01.pdf | 05_MKE_M21_4G\03_REFERENCE_SIMCOM_A7600_SERIES_AT_COMMAND_MANUAL.pdf | AT command protocol reference manual directly applicable to A7680C / A7600 family modules | UNDERLYING CELLULAR MODULE = NOT VERIFIED | Official SIMCom 403-page AT command reference for SMS, Voice Calls, TCP/IP, HTTP, MQTT, network registration.
16 | MicroSD SPI | MicroSD Storage Breakout Module | Generic MicroSD Card SPI Breakout Board | 01 | SD Specifications Part 1 Physical Layer Simplified Specification Version 6.00 | Standard Technical Specification | SD Association (SDA) | https://academy.cba.mit.edu/classes/networking_communications/SD/SD.pdf | 06_MICROSD_SPI\01_DATASHEET_SD_CARD_PHYSICAL_LAYER_SIMPLIFIED_SPECIFICATION.pdf | Official industry standard specification for SD/microSD physical interface and SPI protocol | MICROSD BREAKOUT MODEL = NOT VERIFIED | Official SD Card Association 263-page specification detailing SPI bus protocol, commands (CMD0-CMD59), responses, registers.
17 | MicroSD SPI | MicroSD Storage Breakout Module | Generic MicroSD Card SPI Breakout Board | 02 | Adafruit MicroSD SPI or SDIO Card Breakout Board User & Hardware Guide | Hardware Design Guide / Application Note | Adafruit Industries | https://cdn-learn.adafruit.com/downloads/pdf/adafruit-microsd-spi-sdio.pdf | 06_MICROSD_SPI\02_TECHNICAL_ADAFRUIT_MICROSD_SPI_BREAKOUT_HARDWARE_GUIDE.pdf | Technical design guide for level-shifting MicroSD breakout boards in SPI mode | MICROSD BREAKOUT MODEL = NOT VERIFIED | Comprehensive 46-page guide covering level shifter circuits (74LVC125), 3.3V power regulator, SPI wiring, FatFs usage.
18 | MicroSD SPI | MicroSD Storage Breakout Module | Generic MicroSD Card SPI Breakout Board | 03 | Waveshare Micro SD Storage Board Circuit Schematic Reference | Module Schematic Reference | Waveshare Electronics | https://files.waveshare.com/upload/8/83/Micro-SD-Storage-Board-Schematic.pdf | 06_MICROSD_SPI\03_REFERENCE_WAVESHARE_MICROSD_SPI_MODULE_SCHEMATIC.pdf | Direct circuit schematic for standard MicroSD SPI storage module | MICROSD BREAKOUT MODEL = NOT VERIFIED | Official Waveshare schematic showing MicroSD socket pinouts, level shifting circuitry, bypass capacitors, SPI headers.
19 | OLED SSD1306 | 0.96-inch 128x64 I2C OLED Display (SSD1306) | 0.96 inch 4-Pin I2C OLED Module (GND, VDD, SCK, SDA) | 01 | SSD1306 128 x 64 Dot Matrix OLED/PLED Segment/Common Driver with Controller | Datasheet / Product Specification | Solomon Systech Limited | https://files.waveshare.com/upload/e/ec/SDD1306-30pin.pdf | 07_OLED_SSD1306\01_DATASHEET_SOLOMONSYSTECH_SSD1306_DOT_MATRIX_OLED_CONTROLLER.pdf | Direct display driver IC datasheet for SSD1306 | VERIFIED | Official Solomon Systech 66-page datasheet: internal charge pump, GDDRAM, I2C bus timing, command descriptions.
20 | OLED SSD1306 | 0.96-inch 128x64 I2C OLED Display (SSD1306) | 0.96 inch 4-Pin I2C OLED Module (GND, VDD, SCK, SDA) | 02 | Waveshare 0.96-inch OLED Module User Manual Revision 2.4.1 | Module User Manual / Technical Guide | Waveshare Electronics | https://files.waveshare.com/upload/7/71/0.96inch-OLED-UserManual.pdf | 07_OLED_SSD1306\02_TECHNICAL_WAVESHARE_0.96_INCH_OLED_USER_MANUAL.pdf | Technical user manual for 0.96-inch 128x64 SSD1306 OLED module | VERIFIED | Official Waveshare manual: key parameters, display initialization sequence, I2C address selection, driving instructions.
21 | OLED SSD1306 | 0.96-inch 128x64 I2C OLED Display (SSD1306) | 0.96 inch 4-Pin I2C OLED Module (GND, VDD, SCK, SDA) | 03 | Waveshare 0.96-inch OLED Module Circuit Schematic Reference | Module Schematic Reference | Waveshare Electronics | https://files.waveshare.com/upload/d/dc/0.96inch-OLED-Schematic.pdf | 07_OLED_SSD1306\03_REFERENCE_WAVESHARE_0.96_INCH_OLED_MODULE_SCHEMATIC.pdf | Circuit schematic showing charge pump capacitors, I2C pull-ups, and panel interface for 0.96" OLED | VERIFIED | Official Waveshare schematic: charge pump circuit (C1P/C1N, C2P/C2N), VCOMH, I2C pull-up resistors, 4-pin interface.
22 | 5V Piezo Buzzer | 5V Continuous Tone Piezoelectric Audio Indicator | 5V Active Piezo Buzzer (Unverified Manufacturer) | 01 | Same Sky (formerly CUI Devices) CPE-163 5V Piezo Audio Indicator Specification | Datasheet / Product Specification | Same Sky / CUI Devices | https://www.sameskydevices.com/product/resource/cpe-163.pdf | 08_PIEZO_BUZZER_5V\01_DATASHEET_5V_PIEZO_AUDIO_INDICATOR_SPECIFICATION.pdf | Technical specification for 5V continuous tone piezoelectric audio indicator | EXACT PROJECT BUZZER MODEL = NOT VERIFIED | Representative specification for 5V active piezo indicator: operating voltage 4-14V, rated voltage 5V, resonant freq 3.4kHz, SPL.
23 | 5V Piezo Buzzer | 5V Continuous Tone Piezoelectric Audio Indicator | 5V Active Piezo Buzzer (Unverified Manufacturer) | 02 | Murata Piezoelectric Sound Components Application Manual (Cat.No.P15E-8) | Application Manual / Circuit Design Guide | Murata Manufacturing Co., Ltd. | https://www.murata.com/~/media/webrenewal/support/library/catalog/products/sound/p15e.ashx | 08_PIEZO_BUZZER_5V\02_TECHNICAL_MURATA_PIEZOELECTRIC_SOUND_APPLICATION_MANUAL.pdf | Technical design guide for piezoelectric sounder drive circuits, resonant characteristics, and flyback protection | EXACT PROJECT BUZZER MODEL = NOT VERIFIED | Official Murata manual: transistor drive circuits, flyback diode protection against inductive/piezo spikes, acoustic frequency curves.
24 | 5V Piezo Buzzer | 5V Continuous Tone Piezoelectric Audio Indicator | 5V Active Piezo Buzzer (Unverified Manufacturer) | 03 | Sonitron Standard Piezo Audio Indicator Engineering Manual (SMB Series) | Engineering Manual / Technical Reference | Sonitron N.V. | https://www.sonitron.be/wp-content/uploads/2019/07/SMB-series.pdf | 08_PIEZO_BUZZER_5V\03_REFERENCE_SONITRON_PIEZO_BUZZER_STANDARD_APPLICATION_MANUAL.pdf | Engineering reference for industrial piezoelectric buzzers, mounting, and driving waveforms | EXACT PROJECT BUZZER MODEL = NOT VERIFIED | Technical engineering manual: continuous tone driving, current consumption vs voltage, acoustic attenuation in enclosures.
25 | 2SC1815 | 2SC1815 NPN Silicon Bipolar Transistor | Discrete TO-92 Transistor Buzzer Driver Circuit | 01 | Toshiba 2SC1815 NPN Silicon Epitaxial Transistor Datasheet | Datasheet / Product Specification | Toshiba Corporation | https://akizukidenshi.com/goodsaffix/2sc1815.pdf | 09_2SC1815\01_DATASHEET_TOSHIBA_2SC1815_BIPOLAR_TRANSISTOR.pdf | Original manufacturer datasheet for 2SC1815 transistor | VERIFIED | Original Toshiba datasheet: VCEO=50V, IC=150mA, hFE classifications (O, Y, GR, BL), switching characteristics, TO-92 pinout (ECB).
26 | 2SC1815 | 2SC1815 NPN Silicon Bipolar Transistor | Discrete TO-92 Transistor Buzzer Driver Circuit | 02 | Central Semiconductor 2SC1815 Series Silicon NPN Transistor Datasheet | Technical Specification & Characteristic Curves | Central Semiconductor Corp. | https://my.centralsemi.com/datasheets/2SC1815.PDF | 09_2SC1815\02_TECHNICAL_CENTRAL_SEMICONDUCTOR_2SC1815_SPECIFICATION.pdf | Direct manufacturer specification and electrical performance curves for 2SC1815 | VERIFIED | Official Central Semi datasheet: saturation voltage curves VCE(sat) vs IC, base-emitter saturation VBE(sat), transient response.
27 | 2SC1815 | 2SC1815 NPN Silicon Bipolar Transistor | Discrete TO-92 Transistor Buzzer Driver Circuit | 03 | Guangdong Youfeng Microelectronics 2SC1815 TO-92 Technical Specification | Package & Technical Reference Document | Guangdong Youfeng Microelectronics / LCSC | https://datasheet.lcsc.com/datasheet/pdf/5472637d014a36df83e77b0ea431f59e.pdf?productCode=C22459218 | 09_2SC1815\03_REFERENCE_YOUFENG_2SC1815_PLASTIC_ENCAPSULATE_TRANSISTOR.pdf | Direct technical specification and TO-92 package outline dimensions for 2SC1815 | VERIFIED | Modern production specification: thermal resistance, power derating curves, mechanical package drawings for TO-92.
28 | 18650 Li-ion Battery | 18650 Cylindrical Lithium-ion Battery Cell | 18650 Single-Cell Battery Holder (Primary System Power Source) | 01 | Sony / Murata US18650VTC6 3.7V 3000mAh Cylindrical Li-ion Cell Technical Specification | Datasheet / Product Specification | Sony / Murata Manufacturing Co., Ltd. | https://enerpower.de/wp-content/uploads/2016/10/Specification-US18650VTC6.pdf | 10_18650_LIION\01_DATASHEET_18650_CYLINDRICAL_LI-ION_CELL_SPECIFICATION.pdf | Technical specification for industry-standard high-capacity 18650 cylindrical lithium-ion cell | EXACT PROJECT 18650 CELL = NOT VERIFIED | Detailed 20-page specification: nominal voltage 3.6V-3.7V, charging voltage 4.2V, cut-off voltage 2.5V, CC-CV charging profile.
29 | 18650 Li-ion Battery | 18650 Cylindrical Lithium-ion Battery Cell | 18650 Single-Cell Battery Holder (Primary System Power Source) | 02 | Panasonic Industrial Batteries for Professionals Lithium Handbook (Technical Handbook) | Technical Handbook / Safety & Application Guidelines | Panasonic Energy Co., Ltd. | https://energy.panasonic.com/dam/master/pdf/eu/material/Panasonic_Lithium_Handbook.pdf | 10_18650_LIION\02_TECHNICAL_PANASONIC_LITHIUM_BATTERY_TECHNICAL_HANDBOOK.pdf | Comprehensive technical handbook on lithium battery chemistry, charging profiles, and safety guidelines | EXACT PROJECT 18650 CELL = NOT VERIFIED | Official Panasonic 52-page handbook: CC-CV charging profile, overcharge/overdischarge protection, cycle life, thermal management.
30 | 18650 Li-ion Battery | 18650 Cylindrical Lithium-ion Battery Cell | 18650 Single-Cell Battery Holder (Primary System Power Source) | 03 | Samsung SDI INR18650-25R Li-ion Cell Technical Specification & Discharge Curves | Technical Specification & Discharge Reference | Samsung SDI Co., Ltd. | https://docs.telitpower.com/pdf/li-ion/INR18650-25R.pdf | 10_18650_LIION\03_REFERENCE_SAMSUNG_SDI_18650_CELL_SPECIFICATION.pdf | Technical discharge curves and performance specification for high-reliability 18650 cells | EXACT PROJECT 18650 CELL = NOT VERIFIED | Technical specification: discharge rate characteristics (0.2C to 5C), voltage recovery, temperature coefficient, storage.
