danhcln/AIOT-BLACK-BOX/THIET_KE_KHOI_NGUON/BANG_DU_TOAN_MUA_HANG_KHOI_NGUON.xlsx

Sheet: TONG_QUAN
DỰ TOÁN NGÂN SÁCH MUA SẮM LINH KIỆN KHỐI NGUỒN
ĐỒ ÁN: HỘP ĐEN AIOT THÔNG MINH PHÂN TÍCH VÀ GHI LẠI SỰ CỐ XE MÁY ĐIỆN
Phạm vi: Chỉ khối nguồn (18650, UPS 5V 3A, 3.3V, Phụ kiện) | Ngày lập: 18/10/2026 | Phiên bản: REV 1.0
LƯU Ý QUAN TRỌNG VỀ PHẠM VI DỰ TOÁN:
• Danh mục này TUYỆT ĐỐI CHỈ BAO GỒM LINH KIỆN KHỐI NGUỒN. Không bao gồm chi phí mua mới ESP32-S3, MPU6050, DS3231, GPS NEO-M8N, OLED, MicroSD, Buzzer, LED (chỉ dùng làm tải tính công suất).
• Người dùng ĐÃ CÓ sẵn bo SIM 4G A7682S; không mua lại module SIM. Nguồn cho SIM chỉ quyết định sau khi đo kiểm thực tế chân VCC.
• Nguồn vào từ xe máy điện (DC-DC 48V-72V xuống 5V) xếp vào nhóm CHỜ XÁC MINH (P0), chưa giải ngân mua trước khi đo điện áp bình xe.
SỐ MÓN CẦN MUA NGAY (P1) |  | SỐ MÓN CHỜ XÁC MINH (P0) |  | CHI PHÍ MUA NGAY ĐỢT 1 | TỔNG TIỀN CẦN CHUẨN BỊ
Hạng mục đã xác minh |  | Cần đo kiểm trước khi mua |  | Phương án module làm sẵn | Bao gồm 10% dự phòng phát sinh
BẢNG TỔNG HỢP CHI PHÍ DỰ TOÁN KHỐI NGUỒN
HẠNG MỤC DỰ TOÁN | GIÁ TRỊ (VNĐ) | TỶ TRỌNG | GHI CHÚ KỸ THUẬT & QUY TẮC GIẢI NGÂN
1. Chi phí mua ngay Đợt 1 (Nhóm P1 - Bắt buộc) |  |  | Pin 18650 xả cao, Module UPS 5V 3A, Hạ áp 3.3V, Phụ kiện dây/cọc/tụ
- Trong đó: Module tạo nguồn & Pin (Nhóm A & B) |  |  | Pin 18650 (45k), Khay pin đồng (10k), UPS 5V 3A (65k), AMS1117-3.3 (5k)
- Trong đó: Phụ kiện khối nguồn (Nhóm D) |  |  | Tụ 1000uF đệm 4G, cọc domino KF301, dây silicon 20AWG, công tắc, bo test
2. Dự phòng phát sinh rủi ro (10% Đợt 1) |  |  | Chi phí vận chuyển (Ship Shopee/Hshop) và phụ kiện tiêu hao phát sinh
TỔNG TIỀN CẦN CHUẨN BỊ ĐỢT 1 (ĐÃ CÓ DỰ PHÒNG) |  | 100.0% | Số tiền thực tế sinh viên cần chuẩn bị để mua vật tư lắp ráp đợt 1
3. Chi phí dự kiến Đợt 2 (Nhóm P0 - Chờ xác minh) |  | - | Hạ áp xe điện (65k), Nguồn riêng SIM LM2596 (42k), Cầu chì xe (12k), Giắc (15k)
4. Chi phí tùy chọn / Dụng cụ đo kiểm (Nhóm P3) |  | - | USB Tester (75k), Tải giả điện tử 35W (65k) - Chỉ mua nếu phòng lab chưa có
TỔNG DỰ TOÁN TOÀN BỘ DỰ ÁN (NẾU MUA TẤT CẢ P0+P1) |  | - | Ngân sách tối đa của khối nguồn nếu sau đo kiểm phải mua thêm toàn bộ P0
THỐNG KÊ CHI TIẾT THEO MỨC ƯU TIÊN & TRẠNG THÁI
MỨC ƯU TIÊN | ĐỊNH NGHĨA KỸ THUẬT | SỐ MÓN | TỔNG TIỀN (VNĐ) | HÀNH ĐỘNG KHUYẾN NGHỊ
P0 — CẦN KIỂM TRA TRƯỚC | Linh kiện phụ thuộc thông số chưa xác minh (Điện áp xe, VCC bo SIM) |  |  | TUYỆT ĐỐI CHƯA MUA. Chỉ mua sau khi đo kiểm thực tế.
P1 — BẮT BUỘC MUA NGAY | Linh kiện cốt lõi của phương án module nguồn đã xác minh |  |  | MUA NGAY ĐỢT 1 để lắp ráp khối nguồn và kiểm thử hệ thống.
P2 — MUA SAU THỬ NGHIỆM | Linh kiện bổ sung nếu thử nghiệm thực tế phát sinh lỗi hoặc thiếu dòng |  |  | Chỉ mua khi module UPS không đủ bảo vệ hoặc cần bảo vệ kép.
P3 — TÙY CHỌN / DỰ PHÒNG | Dụng cụ đo kiểm, phương án dự phòng hiệu suất cao, cảm biến nhiệt |  |  | Tùy chọn trang bị thêm nếu phòng thí nghiệm chưa có thiết bị đo.

Sheet: DANH_SACH_MUA_NGUON
DANH SÁCH CHI TIẾT MUA SẮM LINH KIỆN KHỐI NGUỒN
Phân loại chi tiết theo nhóm nguồn, ưu tiên kỹ thuật, nơi mua có kiểm chứng và link truy cập trực tiếp
STT | Nhóm nguồn | Tên sản phẩm | Mã sản phẩm / Model | Thông số kỹ thuật chính | Chức năng trong khối nguồn | Số lượng | Ưu tiên | Trạng thái | Đơn giá VNĐ | Thành tiền VNĐ | Cửa hàng | Link mua trực tiếp | Ngày tra giá | Lý do chọn kỹ thuật | Ghi chú & Điều kiện mua
1 | A. Pin và quản lý pin | Pin Sạc 18650 Li-Ion Sunpower 2500mAh 10C | 18650-2500-10C-SP | 3.7V - 4.2V, 2500mAh, Dòng xả liên tục 10C (25A), Nội trở thấp | Nguồn điện sơ cấp lưu trữ cho hộp đen khi xe mất điện | 1 | P1 | CẦN MUA | 45000 VNĐ |  | Hshop.vn | Xem tại Hshop.vn (https://hshop.vn/products/pin-sac-18650-li-ion-rechargeable-battery-3-7v-2500mah-10c-sunpower) | 18/10/2026 | Hàng chính hãng Hshop, dòng xả 10C (25A) gánh tốt xung 2A của 4G và 5A của Boost mà không bị sụt áp | Bắt buộc mua pin xả cao >= 10C. Không dùng cell pin laptop cũ hoặc pin giá rẻ 10k-20k dòng xả kém.
2 | A. Pin và quản lý pin | Hộp pin ghép nối DIY Solderless 18650 (Tiếp điểm đồng) | HOLDER-18650-SOLDERLESS | Khay gắn 1 cell 18650, tiếp điểm đồng nguyên chất, nắp đậy trong suốt | Gá giữ pin 18650, dẫn dòng xả cao từ pin sang mạch UPS | 1 | P1 | CẦN MUA | 10000 VNĐ |  | Hshop.vn | Xem tại Hshop.vn (https://hshop.vn/products/hop-pin-ghep-noi-diy-solderless-18650-battery-holder) | 18/10/2026 | Tiếp điểm đồng nguyên chất tiếp xúc lớn, khắc phục hoàn toàn nhược điểm sụt áp của khay lò xo sắt rẻ tiền | Đảm bảo mối nối dây từ khay pin sang module bằng dây đồng nhiều sợi 20AWG ngắn nhất có thể (<5cm).
3 | A. Pin và quản lý pin | Mạch bảo vệ pin 1S 3.7V 12A có IC DW01A + 8205A | BMS-1S-12A-DW01 | Bảo vệ 1S 3.7V, Quá sạc 4.28V, Quá xả 2.4V, Quá dòng 12A peak / 6A cont | Bảo vệ thứ cấp độc lập chống quá xả/ngắn mạch cho cell pin | 1 | P2 | MUA SAU THỬ NGHIỆM | 15000 VNĐ |  | icdayroi.com | Xem tại icdayroi.com (https://icdayroi.com/mach-sac-pin-18650-1s-3-7v-12a-co-ic-bao-ve) | 18/10/2026 | Dùng dự phòng gắn trực tiếp ở cực pin nếu module UPS tích hợp bảo vệ dòng quá thấp (<3A) | Chỉ cần mua nếu module UPS 15W thử nghiệm không tự ngắt khi xả cạn hoặc không chịu được dòng xả 5A.
4 | A. Pin và quản lý pin | Cảm biến nhiệt độ NTC 10K B3950 bọc kim loại chống nước | NTC-10K-B3950-1M | R25=10K, B=3950, Dải đo -30°C đến 125°C, Vỏ bọc inox 1m | Giám sát nhiệt độ vỏ pin 18650 kết nối về ADC ESP32 để ngắt sạc khi quá nhiệt | 1 | P3 | TÙY CHỌN | 5000 VNĐ |  | icdayroi.com | Xem tại icdayroi.com (https://icdayroi.com/cam-bien-nhiet-do-10k-chong-nuoc) | 18/10/2026 | Tăng tính an toàn chống cháy nổ khi sạc pin trên cốp xe máy điện nhiệt độ cao | Tùy chọn trang bị thêm cho đồ án để tăng điểm sáng tạo an toàn nhiệt trong báo cáo.
5 | B. Tạo và phân phối nguồn | Mạch sạc và tăng áp UPS 15W Type-C 5V 3A dùng pin 18650 | UPS-15W-5V-3A-TYPEC | VIN: 5V Type-C; VOUT: 5V / 3A (15W); Hỗ trợ sạc xả đồng thời, chuyển mạch 0 delay | Bộ nguồn trung tâm: Sạc pin 18650, Boost 5V_SYS, chuyển nguồn tự động khi mất điện | 1 | P1 | CẦN MUA | 65000 VNĐ |  | icdayroi.com | Xem tại icdayroi.com (https://icdayroi.com/mach-sac-18650-15w-tang-ap-cho-nguon-du-phong-ups-5v3a) | 18/10/2026 | Tích hợp all-in-one sạc pin + boost 5V 3A + chuyển mạch UPS không độ trễ, giảm độ phức tạp hàn mạch | Trọng tâm của Phương án A. Cần thử nghiệm rút nguồn ngoài xem ESP32 có khởi động lại không.
6 | B. Tạo và phân phối nguồn | Module nguồn hạ áp LDO AMS1117-3.3V 800mA có đèn báo | MOD-AMS1117-3.3V | VIN: 4.5V - 7V; VOUT: 3.3V ±1.5%; IOUT: 800mA; Tích hợp tụ lọc & LED | Hạ áp từ 5V_SYS xuống 3V3_SYS cấp cho cảm biến MPU6050, DS3231, OLED, GPS | 1 | P1 | CẦN MUA | 5000 VNĐ |  | icdayroi.com | Xem tại icdayroi.com (https://icdayroi.com/module-nguon-ams1117-3-3v) | 18/10/2026 | Dòng 800mA dư tải cho toàn bộ cảm biến 3.3V (tổng tải cảm biến chỉ ~102mA). Giá siêu rẻ, chân cắm tiện lợi | Không cấp nguồn 3.3V này cho ESP32 (ESP32 đã dùng 5V từ chân 5V của DevKit).
7 | B. Tạo và phân phối nguồn | Mạch giảm áp DC-DC Buck Mini 5VDC 3A (Hiệu suất cao) | BUCK-MINI-3A | VIN: 4.5V - 28V; VOUT: Cố định 5V hoặc chỉnh 3.3V; IOUT: 3A peak / 1.8A cont; Fsw=1.5MHz | Phương án hạ áp 3.3V xung thay thế cho AMS1117 nếu cần hiệu suất cao không tỏa nhiệt | 1 | P3 | THAY THẾ | 15000 VNĐ |  | Hshop.vn | Xem tại Hshop.vn (https://hshop.vn/products/mach-giam-ap-dc-dc-buck-mini-5vdc-3a) | 18/10/2026 | Dùng công nghệ Buck xung hiệu suất 96%, mát hơn LDO AMS1117 khi chạy liên tục | Chỉ mua thay thế nếu AMS1117 bị nóng quá 60°C trong môi trường hộp kín.
8 | B. Tạo và phân phối nguồn | Mạch giảm áp Buck DC-DC LM2596 có chỉnh áp/dòng (Cấp riêng SIM 3.8V) | LM2596-ADJ-3A | VIN: 4V - 35V; VOUT: 1.25V - 30V chỉnh được; IOUT: 3A max (2A liên tục); Tích hợp biến trở | Cấp nguồn riêng 3.8V cho A7682S (Option B) nếu chân VCC bo SIM không hỗ trợ 5V | 1 | P0 | CHỜ XÁC MINH | 42000 VNĐ |  | icdayroi.com | Xem tại icdayroi.com (https://icdayroi.com/mach-sac-pin-giam-ap-buck-dc-dc-lm2596-co-chinh-dong) | 18/10/2026 | Hạ áp từ 5V xuống chính xác 3.80V theo chuẩn SIMCom, chỉnh được giới hạn dòng chống cháy nổ | CHƯA MUA NGAY. Chỉ mua khi đã dùng đồng hồ đo bo A7682S xác nhận VCC không nhận trực tiếp 5V.
9 | B. Tạo và phân phối nguồn | Cổng cái USB Type-C 16 Pin chân cắm PCB (Kèm trở 5.1k CC) | TYPEC-FEMALE-16P | Chuẩn Type-C 2.0, chân cắm 2.54mm, tích hợp trở CC nhận nguồn từ củ sạc PD/QC 5V | Đầu vào 5V sạc phụ dự phòng kết nối ngoài vỏ hộp đen | 1 | P3 | TÙY CHỌN | 5000 VNĐ |  | icdayroi.com | Xem tại icdayroi.com (https://icdayroi.com/cong-usb-type-c-16-chan) | 18/10/2026 | Module UPS đã có sẵn cổng Type-C trên bo. Cổng này chỉ dùng nếu muốn kéo giắc Type-C ra ngoài vỏ hộp | Tùy chọn mua thêm để làm thẩm mỹ vỏ hộp đen.
10 | C. Nguồn điện xe | Mạch giảm áp DC-DC Buck TPS54560 60VDC 5A 600kHz | TPS54560-60V-5A | VIN: 7V - 60VDC; VOUT: 5V cố định / chỉnh được; IOUT: 5A liên tục; Hiệu suất 91% | Hạ áp từ ắc quy/pin xe máy điện (48V / 60V) xuống 5V cấp cho hệ thống hộp đen | 1 | P0 | CHỜ XÁC MINH | 65000 VNĐ |  | Hshop.vn | Xem tại Hshop.vn (https://hshop.vn/products/mach-giam-ap-dc-dc-buck-tps54560-60vdc-5a-600khz) | 18/10/2026 | IC TI chính hãng chịu áp tới 60VDC, dòng 5A cực khỏe, chống xung ngược xe điện tốt | CHƯA MUA NGAY. Phải dùng đồng hồ vạn năng đo điện áp thực tế bình xe (Nếu xe 72V thì module 60V này sẽ cháy, phải mua loại 80V-100V!).
11 | C. Nguồn điện xe | Hộp cầu chì ô tô mini có dây chống nước + Cầu chì 3A | FUSE-HOLDER-INLINE-MINI | Dây 16AWG bọc cao su chống nước, kèm cầu chì lá mini 3A 32V/58V | Bảo vệ chống chập cháy trên đường dây nguồn từ ắc quy xe điện vào mạch | 1 | P0 | CHỜ XÁC MINH | 12000 VNĐ |  | icdayroi.com | Xem tại icdayroi.com (https://icdayroi.com/hop-cau-chi-o-to-mini-co-day) | 18/10/2026 | Bảo vệ an toàn bắt buộc khi câu dây trực tiếp từ nguồn xe máy điện, chống chập cháy xe khi dây bị cọ xát | Mua đồng thời cùng với module hạ áp xe điện ở Đợt 2.
12 | C. Nguồn điện xe | Cặp đầu nối chống nước 2-Pin đực cái có dây (Chuẩn IP67) | CONNECTOR-WATERPROOF-2P | 2 Pin, dòng tải 5A, có gioăng cao su chống nước, ren siết an toàn | Giắc cắm nguồn tháo lắp nhanh giữa hộp đen và hệ thống điện xe máy | 1 | P0 | CHỜ XÁC MINH | 15000 VNĐ |  | icdayroi.com | Xem tại icdayroi.com (https://icdayroi.com/dau-noi-chong-nuoc-2-pin) | 18/10/2026 | Chống nước và chống rung giật cực tốt khi xe máy điện vận hành dưới trời mưa và đường dằn xóc | Mua đồng thời cùng vật tư nguồn xe ở Đợt 2.
13 | D. Phụ kiện khối nguồn | Tụ điện hóa Low-ESR 1000uF 10V (Gói 5 cái) | CAP-1000UF-10V-LOWESR | 1000µF, 10V, Dải nhiệt 105°C, Nội trở ESR thấp (~0.05Ω) | Đệm năng lượng cho đường nguồn SIM 4G, hấp thụ sụt áp xung 2A (577µs) khi phát RF | 1 | P1 | CẦN MUA | 3500 VNĐ |  | icdayroi.com | Xem tại icdayroi.com (https://icdayroi.com/tu-hoa-1000uf10v) | 18/10/2026 | Gói 5 cái giá chỉ 3.5k. Đặt ngay sát chân VCC của bo SIM để triệt tiêu sụt áp, ngăn ESP32 và SIM bị reset | Bắt buộc gắn song song ngay sát chân nguồn của bo A7682S.
14 | D. Phụ kiện khối nguồn | Cọc đấu dây Domino 2 chân KF301-2P bước 5.0mm | DOMINO-KF301-2P | 2 Pin, Khoảng cách chân 5.0mm, bắt vít siết dây, tải 300V / 16A | Điểm đấu dây nguồn vào (VIN/GND) và nguồn ra (5V/GND) dễ dàng tháo lắp bằng tuốc-nơ-vít | 5 | P1 | CẦN MUA | 1000 VNĐ |  | icdayroi.com | Xem tại icdayroi.com (https://icdayroi.com/kf301-2p-5-0mm) | 18/10/2026 | Đấu nối module chắc chắn, không lo gãy chân hay lỏng dây khi xe rung lắc | Mua 5 cái để bố trí cho: Đầu vào nguồn xe, đầu vào pin, đầu ra 5V, đầu ra 3.3V, đầu ra SIM.
15 | D. Phụ kiện khối nguồn | Cọc đấu dây Domino 3 chân KF301-3P bước 5.0mm | DOMINO-KF301-3P | 3 Pin, Khoảng cách chân 5.0mm, bắt vít siết dây, tải 300V / 16A | Đấu nối chia nguồn 5V_SYS, 3V3_SYS và GND sang bo xử lý trung tâm | 3 | P1 | CẦN MUA | 1200 VNĐ |  | icdayroi.com | Xem tại icdayroi.com (https://icdayroi.com/kf301-3p-5-0mm) | 18/10/2026 | Tiện lợi cho việc phân phối nhiều đường nguồn chung mass GND mà không cần xoắn dây | Mua 3 cái làm trạm phân phối nguồn.
16 | D. Phụ kiện khối nguồn | Dây điện silicon 20AWG chịu nhiệt (1m Đỏ + 1m Đen) | WIRE-SILICON-20AWG | Lõi đồng mạ thiếc nhiều sợi siêu mềm, vỏ silicon chịu nhiệt 200°C, dòng tải 5A liên tục | Đấu nối các đường nguồn động lực chính (Pin, UPS, 5V_SYS) giảm thiểu tối đa sụt áp | 2 | P1 | CẦN MUA | 8000 VNĐ |  | icdayroi.com | Xem tại icdayroi.com (https://icdayroi.com/day-silicon-20awg-chiu-nhiet) | 18/10/2026 | Dây đồng mềm mạ thiếc dẫn dòng xung 5A không bị suy hao; vỏ silicon chống cháy an toàn trên xe | 1 mét đỏ dùng cho cực dương (+), 1 mét đen dùng cho mass GND.
17 | D. Phụ kiện khối nguồn | Công tắc bập bênh KCD1-11 2 chân On/Off | SWITCH-KCD1-11 | 2 Pin, 250VAC 3A / 125VAC 6A, cơ cấu bập bênh nảy tốt, kích thước 15x10mm | Công tắc bật/tắt nguồn tổng của hộp đen khi bảo dưỡng hoặc ngắt nguồn pin dài ngày | 2 | P1 | CẦN MUA | 2000 VNĐ |  | icdayroi.com | Xem tại icdayroi.com (https://icdayroi.com/cong-tac-kcd1-11) | 18/10/2026 | Kích thước nhỏ gọn, độ bền đóng ngắt cao, chịu rung lắc tốt trên xe | Mua 2 cái (1 cái lắp chính, 1 cái dự phòng).
18 | D. Phụ kiện khối nguồn | Combo cầu chì ống 5x20mm 3A + Hộp đựng cầu chì có nắp | FUSE-GLASS-5X20-3A | Cầu chì thủy tinh 5x20mm 3A 250V kèm đế giữ chân hàn PCB có nắp bảo vệ | Bảo vệ quá tải và ngắn mạch đường 5V_SYS ngăn ngừa cháy nổ thiết bị tải | 1 | P1 | CẦN MUA | 6000 VNĐ |  | icdayroi.com | Xem tại icdayroi.com (https://icdayroi.com/combo-cau-chi-0-2a-20a-5x20mm) | 18/10/2026 | Cắt điện ngay lập tức khi đường 5V bị chập, bảo vệ an toàn cho cell pin và module UPS | Bắt buộc gắn trên đường 5V_SYS trước khi cấp sang ESP32 và các module.
19 | D. Phụ kiện khối nguồn | Bo mạch đồng đục lỗ sợi thủy tinh FR4 hai mặt 9x15cm | PERFBOARD-FR4-9X15 | Chất liệu sợi thủy tinh FR4 dày 1.6mm, mạ thiếc 2 mặt, bước lỗ chuẩn 2.54mm | Bo mạch đế để gắn cố định module UPS, LDO 3.3V, khay pin và cọc đấu dây thành khối nguồn hoàn chỉnh | 1 | P1 | CẦN MUA | 14000 VNĐ |  | icdayroi.com | Xem tại icdayroi.com (https://icdayroi.com/board-dong-duc-lo-pcb-12x18cm) | 18/10/2026 | Chất liệu FR4 cứng cáp, chịu lực và chống ẩm tốt hơn nhiều so với phíp giấy Bakelite màu vàng | Dùng gá lắp và hàn nối khối nguồn thành module độc lập trước khi gắn vào hộp đen.
20 | D. Phụ kiện khối nguồn | Thanh rào đực/cái 2.54mm 40 chân mạ vàng (Bộ 2 thanh) | HEADER-2.54MM-40P | Bước 2.54mm, mạ vàng dẫn điện tốt, gồm 1 thanh rào đực và 1 thanh rào cái | Làm chân cắm rút cho module AMS1117 và kết nối tín hiệu ADC đo pin | 2 | P1 | CẦN MUA | 3000 VNĐ |  | icdayroi.com | Xem tại icdayroi.com (https://icdayroi.com/hang-rao-duc-2-54mm-40-chan) | 18/10/2026 | Giúp tháo lắp module dễ dàng khi cần thay thế hoặc đo kiểm thông số mà không cần hút chì hàn | Tiện lợi cho việc kiểm thử và bảo trì sau này.
21 | E. Thiết bị kiểm tra | Thiết bị đo dòng áp USB Type-C Tester KWS hiển thị màu | TESTER-KWS-TYPEC | Dải đo 4V - 30V, 0 - 5.1A, hiển thị V, A, W, mAh, mWh, thời gian sạc | Kiểm tra dòng sạc pin thực tế và phát hiện sụt áp đường nguồn Type-C của module UPS | 1 | P3 | TÙY CHỌN | 75000 VNĐ |  | icdayroi.com | Xem tại icdayroi.com (https://icdayroi.com/dong-ho-do-dong-dien-ap-usb-tester-kws) | 18/10/2026 | Công cụ trực quan giúp sinh viên biết chính xác pin đang sạc với dòng bao nhiêu và khi nào đầy | Hạng mục tùy chọn. Nếu phòng thực hành trường đã có máy hiện sóng và đồng hồ VOM thì không cần mua.
22 | E. Thiết bị kiểm tra | Mạch tải giả điện tử USB 35W có quạt tản nhiệt và biến trở | ELECTRONIC-LOAD-35W | Công suất tải 35W, dòng tải 0.2A - 5A chỉnh biến trở, có màn hình LED báo dòng áp | Stress test khả năng cấp dòng 3A liên tục của module UPS 15W xem có bị sập nguồn hay nóng không | 1 | P3 | TÙY CHỌN | 65000 VNĐ |  | icdayroi.com | Xem tại icdayroi.com (https://icdayroi.com/mach-tai-gia-dien-tu-35w) | 18/10/2026 | Giúp giải quyết triệt để nghi vấn 'Module UPS quảng cáo 3A nhưng thực tế chỉ được 1.5A' | Hạng mục tùy chọn phục vụ kiểm chứng thực nghiệm chuyên sâu.
TỔNG TIỀN LINH KIỆN BẮT BUỘC MUA NGAY (ƯU TIÊN P1 - CẦN MUA)
TỔNG TIỀN CÁC MỤC CHỜ XÁC MINH KỸ THUẬT (ƯU TIÊN P0 - CHƯA MUA NGAY)
TỔNG TOÀN BỘ DANH SÁCH (NẾU MUA TẤT CẢ CÁC HẠNG MỤC P0, P1, P2, P3)

Sheet: SO_SANH_GIA
BẢNG SO SÁNH GIÁ VÀ ĐỐI CHIẾU NƠI MUA LINH KIỆN QUAN TRỌNG
Khảo sát đối chiếu giá giữa các cửa hàng uy tín tại Việt Nam (icdayroi.com, thegioimodule.com, Hshop.vn, Shopee) để chọn giải pháp tối ưu
STT | Tên linh kiện / Module nguồn | Thông số yêu cầu | Shop A | Giá Shop A (VNĐ) | Link Shop A | Shop B | Giá Shop B (VNĐ) | Link Shop B | Shop C (Tham khảo) | Giá Shop C (VNĐ) | Link Shop C | Giá khuyến nghị (VNĐ) | Cửa hàng chọn | Lý do kỹ thuật & kinh tế chọn mua
1 | Module UPS 15W Type-C 5V 3A (Dùng pin 18650) | 5V / 3A (15W), Sạc xả đồng thời, UPS không trễ | icdayroi.com | 65000 VNĐ | Link A (https://icdayroi.com/mach-sac-18650-15w-tang-ap-cho-nguon-du-phong-ups-5v3a) | thegioimodule.com | 70000 VNĐ | Link B (https://thegioimodule.com/mach-sac-18650-cong-type-c-15w-tang-ap-cho-nguon-du-phong-ups-5v3a) | thegioiic.com (Mã IC44611) | 70000 VNĐ | Link C (https://www.thegioiic.com/tim-kiem?q=ups) | 65000 VNĐ | icdayroi.com | Giá rẻ hơn 5k, có sẵn hàng tại TPHCM, shop đã kiểm chứng module phiên bản cổng Type-C mới nhất.
2 | Pin sạc 18650 dòng xả cao (>=10C / 20A) | 3.7V, >=2000mAh, Dòng xả liên tục >=10C | Hshop.vn (Sunpower 2500mAh 10C) | 45000 VNĐ | Link A (https://hshop.vn/products/pin-sac-18650-li-ion-rechargeable-battery-3-7v-2500mah-10c-sunpower) | icdayroi.com (Panasonic 2600mAh) | 28000 VNĐ | Link B (https://icdayroi.com/pin-cell-panasonic-18650) | Shopee (Samsung 25R 20A chính hãng) | 65000 VNĐ | Link C (https://shopee.vn/search?keyword=samsung%2025r%20chinh%20hang) | 45000 VNĐ | Hshop.vn | Chọn Hshop vì cam kết đúng dòng xả 10C (25A). Pin 28k ở shop khác là pin thường xả thấp (1-2C), sẽ sập nguồn khi 4G phát.
3 | Khay / Đế giữ pin 18650 tiếp xúc dòng cao | 1 cell 18650, tiếp điểm đồng nguyên chất | Hshop.vn (Solderless tiếp điểm đồng) | 10000 VNĐ | Link A (https://hshop.vn/products/hop-pin-ghep-noi-diy-solderless-18650-battery-holder) | icdayroi.com (Khay đế lò xo thường) | 6000 VNĐ | Link B (https://icdayroi.com/khung-de-pin-18650-1-cell) | thegioimodule.com (Đế pin dây) | 8000 VNĐ | Link C (https://thegioimodule.com/search?q=de+pin+18650) | 10000 VNĐ | Hshop.vn | Khay của Hshop có lá đồng tiếp xúc lớn, nội trở cực nhỏ (<10mΩ). Khay lò xo sắt rẻ tiền gây sụt áp >0.5V khi dòng xả 5A.
4 | Module hạ áp 3.3V cho cảm biến | VIN: 5V; VOUT: 3.3V; IOUT: >=500mA | icdayroi.com (AMS1117-3.3V 800mA) | 5000 VNĐ | Link A (https://icdayroi.com/module-nguon-ams1117-3-3v) | Hshop.vn (Buck Mini 5V/3.3V 3A) | 15000 VNĐ | Link B (https://hshop.vn/products/mach-giam-ap-dc-dc-buck-mini-5vdc-3a) | thegioimodule.com (AMS1117-3.3) | 6000 VNĐ | Link C (https://thegioimodule.com/search?q=ams1117+3.3) | 5000 VNĐ | icdayroi.com | Tổng dòng cảm biến chỉ ~102mA, AMS1117 800mA đáp ứng hoàn hảo với chi phí chỉ 5.000₫. Mua kèm cùng đơn icdayroi để tiết kiệm ship.
5 | Module hạ áp nguồn xe điện (Dải áp cao) | Hạ áp từ 48V-60VDC xuống 5V / >=3A | Hshop.vn (TPS54560 60V 5A TI) | 65000 VNĐ | Link A (https://hshop.vn/products/mach-giam-ap-dc-dc-buck-tps54560-60vdc-5a-600khz) | icdayroi.com (XL7015 80V 0.8A) | 25000 VNĐ | Link B (https://icdayroi.com/mach-giam-ap-dc-xl7015-0-8a-5-80v) | Shopee (Hạ áp xe điện 36-72V sang 5V 3A) | 55000 VNĐ | Link C (https://shopee.vn/search?keyword=ha%20ap%20xe%20dien%2072v%20sang%205v) | 65000 VNĐ | Hshop.vn | Module TPS54560 của Hshop dùng chip TI công nghiệp chịu áp cao, dòng tải 5A cực khỏe cho cả hệ thống. Tuy nhiên đang CHỜ XÁC MINH áp bình.
6 | Module hạ áp riêng 3.8V cho SIM A7682S (Option B) | VIN: 5V; VOUT: 3.8V; IOUT: 3A peak | icdayroi.com (LM2596 có chỉnh áp/dòng) | 42000 VNĐ | Link A (https://icdayroi.com/mach-sac-pin-giam-ap-buck-dc-dc-lm2596-co-chinh-dong) | thegioimodule.com (LM2596S 3A thường) | 22000 VNĐ | Link B (https://thegioimodule.com/search?q=lm2596) | Hshop.vn (LM2596S 3A) | 20000 VNĐ | Link C (https://hshop.vn/products/mach-giam-ap-dc-dc-buck-lm2596s-3a) | 42000 VNĐ | icdayroi.com | Bản có chỉnh dòng của icdayroi an toàn hơn cho module SIM, chống quá dòng khi RF phát. Chỉ mua nếu đo bo SIM không nhận 5V.

Sheet: PHUONG_AN_NGUON
SO SÁNH HAI PHƯƠNG ÁN TRIỂN KHAI KHỐI NGUỒN
Phân tích đối sánh kỹ thuật và tài chính giữa Phương án A (Module làm sẵn - Ưu tiên) và Phương án B (Mạch IC rời KiCad Antigravity)
TIÊU CHÍ SO SÁNH | PHƯƠNG ÁN A: MODULE NGUỒN LÀM SẴN (KHUYẾN NGHỊ TRIỂN KHAI) | PHƯƠNG ÁN B: MẠCH IC RỜI TPS/BQ (THIẾT KẾ KICAD CHUYÊN SÂU)
1. Triết lý thiết kế | Sử dụng các module chức năng bán sẵn trên thị trường, kết nối dây trên bo lỗ FR4 | Thiết kế mạch in 4 lớp nguyên khối, tích hợp IC nguồn Texas Instruments chuyên dụng
2. Danh sách linh kiện chính | Module UPS 15W 5V 3A Type-C, Pin 18650 10C, LDO AMS1117-3.3, Khay pin đồng, Tụ 1000uF | TPS2121 (Power Mux), BQ25895 (Charger 5A), TPS61088 (Boost 10A), TPS62162 (Buck 3.3V), DW01A+FS8205
3. Tổng chi phí linh kiện |  | Khoảng 420.000₫ - 550.000₫ (Chưa tính chi phí đặt gia công PCB 4 lớp ~400k)
4. Độ khó triển khai thực tế | THẤP (3/10) — Rất phù hợp với đồ án sinh viên và thời gian làm đồ án gấp | RẤT CAO (9/10) — Yêu cầu trình độ layout cao tần và hàn linh kiện dán SMD/QFN
5. Yêu cầu kỹ năng hàn | Chỉ hàn chân cọc domino, rào cắm và dây nối xuyên lỗ (THT). Dùng mỏ hàn 60W thông thường | Phải hàn chân pad nhiệt dưới đáy chip QFN-24, VQFN-20. Bắt buộc có máy khò nhiệt hoặc lò reflow
6. Khả năng sửa chữa / Thay thế | CỰC KỲ DỄ DÀNG — Hỏng module nào tháo ốc domino thay module đó trong 5 phút | KHÓ KHĂN — Chập cháy 1 IC có thể làm hỏng bo 4 lớp, tháo thay QFN rất dễ tróc mạch in
7. Kích thước & Trọng lượng | Lớn hơn (~100 x 70 x 25 mm do xếp nhiều module và cọc nối) | Siêu nhỏ gọn (~65 x 45 x 12 mm, tích hợp toàn bộ trên 1 bo mạch duy nhất)
8. Hiệu suất chuyển đổi & Độ gợn | Khá (85% - 90%), độ gợn ~30-50mV (khắc phục bằng tụ đệm 1000uF) | Rất cao (92% - 95%), độ gợn siêu thấp (<15mV), đáp ứng quá độ tức thời xuất sắc
9. Giám sát từ xa (Telemetry) | Đo điện áp pin qua cầu phân áp vào ADC ESP32 (GPIO1), không đo được dòng | Giao tiếp I2C đọc trực tiếp thanh ghi BQ25895: Điện áp, dòng sạc, nhiệt độ, mã lỗi
10. Rủi ro kỹ thuật chính | Module UPS giá rẻ có thể công bố dòng ảo (cần test tải 3A); sụt áp khi SIM phát | Hàn lỗi chân bụng QFN gây đoản mạch; layout sai vòng lặp dòng xung boost gây nhiễu RF
11. KẾT LUẬN & KHUYẾN NGHỊ | CHỌN LÀM PHƯƠNG ÁN THỰC NGHIỆM CHÍNH CHO ĐỒ ÁN ĐỂ ĐẢM BẢO TIẾN ĐỘ VÀ AN TOÀN | GIỮ LÀM HỒ SƠ THIẾT KẾ KỸ THUẬT NÂNG CAO ĐỂ ĐƯA VÀO BÁO CÁO THUYẾT MINH ĐỒ ÁN
CHI TIẾT DANH MỤC VÀ DỰ TOÁN PHƯƠNG ÁN A (MODULE NGUỒN LẮP SẴN)
STT | Tên Module / Vật tư | Mã sản phẩm | Số lượng | Đơn giá (VNĐ) | Thành tiền (VNĐ) | Cửa hàng | Ghi chú
1 | Module UPS 15W Type-C 5V 3A dùng pin 18650 | UPS-15W-5V-3A | 1 | 65000 VNĐ |  | icdayroi.com | Bộ nguồn trung tâm 3 trong 1
2 | Pin Sạc 18650 Li-Ion Sunpower 2500mAh 10C | 18650-2500-10C | 1 | 45000 VNĐ |  | Hshop.vn | Dòng xả 25A không sụt áp
3 | Hộp pin ghép nối DIY Solderless (Tiếp điểm đồng) | HOLDER-18650-COPPER | 1 | 10000 VNĐ |  | Hshop.vn | Tiếp xúc đồng nội trở thấp
4 | Module nguồn hạ áp AMS1117-3.3V 800mA | MOD-AMS1117-3.3 | 1 | 5000 VNĐ |  | icdayroi.com | Cấp cho cảm biến 3.3V
5 | Tụ hóa Low-ESR 1000uF 10V (Gói 5 cái) | CAP-1000UF-10V | 1 | 3500 VNĐ |  | icdayroi.com | Đệm xung phát 2A SIM 4G
6 | Cọc đấu dây Domino KF301-2P + KF301-3P | KF301-2P/3P | 8 | 1100 VNĐ | 8600 VNĐ | icdayroi.com | 5 cọc 2P (5k) + 3 cọc 3P (3.6k) = 8.6k
7 | Dây silicon 20AWG (Đỏ + Đen) | WIRE-20AWG-SILICON | 2 | 8000 VNĐ |  | icdayroi.com | Dây đồng mạ thiếc chịu dòng 5A
8 | Công tắc nguồn KCD1-11 + Cầu chì 3A | SWITCH-FUSE-3A | 2 | 5000 VNĐ |  | icdayroi.com | Bảo vệ và ngắt nguồn hộp đen
9 | Bo mạch đồng đục lỗ FR4 9x15cm gá module | PERFBOARD-FR4 | 1 | 14000 VNĐ |  | icdayroi.com | Đế cố định toàn bộ khối nguồn
TỔNG CHI PHÍ PHƯƠNG ÁN A (MUA NGAY ĐỢT 1 - MODULE LẮP SẴN)

Sheet: CHO_XAC_MINH
DANH MỤC HẠNG MỤC KỸ THUẬT CHỜ XÁC MINH & CẢNH BÁO MUA SẮM
Phân tích 8 vấn đề kỹ thuật chưa có dữ liệu thực tế — Quy định nghiêm ngặt những linh kiện TUYỆT ĐỐI CHƯA NÊN MUA để tránh lãng phí ngân sách
STT | Hạng mục kỹ thuật cần xác minh | Hiện trạng thiết kế | Rủi ro kỹ thuật nếu mua sớm | Phương pháp đo kiểm & Thử nghiệm bắt buộc | Linh kiện liên quan | QUYẾT ĐỊNH MUA SẮM HIỆN TẠI | Điều kiện được phép giải ngân mua
1 | Điện áp chân VCC của bo SIM A7682S | Bo SIM có cuộn cảm 4R7 và linh kiện nguồn onboard, nhưng chưa xác định là mạch Buck hạ 5V->3.8V hay chỉ là cuộn lọc nguồn. | Nếu cắm 5V vào bo SIM chỉ hỗ trợ 3.8V -> CHÁY CHIP SIM A7682S NGAY LẬP TỨC. Nếu mua module hạ áp 3.8V trong khi bo SIM đã có sẵn mạch hạ áp 5V -> LÃNG PHÍ TIỀN. | Cấp nguồn 3.8V từ bộ nguồn lab đa năng vào chân VCC bo SIM qua đồng hồ đo dòng. Dò mạch in xem chân VCC nối vào đâu. | Module hạ áp LM2596 (Option B 3.8V - 42.000₫) | TUYỆT ĐỐI CHƯA MUA | Chỉ mua khi đo kiểm thực tế xác nhận bo SIM yêu cầu cấp 3.8V trực tiếp.
2 | Dòng cấp thực tế khi SIM 4G phát dữ liệu | Lý thuyết thiết kế tính dòng đỉnh 2.0A xung 577µs. Cần kiểm chứng bo SIM thực tế ăn dòng đỉnh bao nhiêu. | Nếu dòng đỉnh vượt quá 2.5A mà nguồn không gánh nổi -> Sụt áp làm ESP32 reset liên tục, mất dữ liệu tai nạn. | Dùng máy hiện sóng (Oscilloscope) bắt dạng sóng sụt áp tại chân VCC SIM khi truyền dữ liệu 4G LTE. | Tụ hóa Low-ESR 1000uF (3.500₫) | ĐÃ DUYỆT MUA (P1) | Tụ 1000uF giá rất rẻ (3.5k) và bắt buộc phải có để đệm xung, duyệt mua ngay.
3 | Điện áp bình ắc quy / pin xe máy điện | Xe máy điện thực tế có thể là hệ 48V (4 bình), 60V (5 bình) hoặc 72V (6 bình / Pin LFP). Hiện chưa có thông số xe người dùng. | Nếu mua module hạ áp 60V (TPS54560) nhưng xe thực tế là 72V (sạc đầy lên tới 84V) -> NỔ TỤ VÀ CHÁY MODULE HẠ ÁP. | Dùng đồng hồ vạn năng DMM thang đo DC 200V đo trực tiếp tại giắc sạc hoặc 2 cọc bình ắc quy của xe máy điện khi sạc đầy. | Module hạ áp TPS54560 (65.000₫), Hộp cầu chì xe (12.000₫), Giắc chống nước (15.000₫) | TUYỆT ĐỐI CHƯA MUA | Chỉ mua sau khi có số đo VDC bình xe chính xác từ người dùng.
4 | Mã pin 18650 và dòng xả liên tục thực tế | Hệ thống yêu cầu dòng xả pin đỉnh lên tới 5.04A khi pin yếu (3.0V). Pin thông thường không thể đáp ứng. | Pin nhái/pin dung lượng ảo giá rẻ 10k-20k nội trở cao (>80mΩ) sẽ bị sụt áp tức thì >0.5V khi có xung, gây ngắt nguồn sớm. | Dùng máy đo nội trở pin chuyên dụng (YR1035+) hoặc đo sụt áp khi kéo tải 3A trên bàn test. | Pin 18650 xả cao 10C Sunpower (45.000₫) | ĐÃ DUYỆT MUA (P1) | Đã chọn mã pin 10C (25A) chính hãng tại Hshop có kiểm định, duyệt mua ngay.
5 | Công suất liên tục thực tế của module UPS 15W | Nhà sản xuất công bố 5V 3A (15W), nhưng nhiều module giá rẻ bị quá nhiệt hạ dòng xuống dưới 1.5A sau 10 phút. | Hộp đen hoạt động liên tục nhiều giờ trong cốp xe nóng; nếu module UPS quá nhiệt tự ngắt -> MẤT NGUỒN TOÀN BỘ. | Cắm tải giả điện tử kéo dòng liên tục 2.0A trong 30 phút, dùng súng đo nhiệt hồng ngoại kiểm tra cuộn cảm và chip boost. | Module UPS 15W 5V 3A Type-C (65.000₫) | ĐÃ DUYỆT MUA ĐỂ TEST | Bắt buộc mua để kiểm chứng năng lực thực tế. Nếu không đạt sẽ chuyển sang Module Boost rời.
6 | Khả năng chuyển nguồn tự động không trễ (Zero-delay) | Module UPS cần chuyển đổi giữa nguồn ngoài (Type-C / Xe) và pin 18650 mà không làm sụt áp quá 200mV. | Nếu thời gian chuyển mạch trễ >10ms -> ESP32-S3 bị reset (Brownout), MicroSD bị lỗi file hệ thống FAT32. | Nối ESP32 đang chạy chương trình ghi thẻ nhớ liên tục, đột ngột rút giắc nguồn sạc Type-C xem ESP32 có bị reset không. | Phần cứng chuyển mạch trên bo UPS | ĐÃ TÍCH HỢP TRÊN UPS | Kiểm tra ngay sau khi nhận module UPS ở Đợt 1.
7 | Khả năng vừa sạc pin vừa cấp tải (Power-path) | Dòng vào từ củ sạc 5V phải đủ nuôi tải hệ thống (~0.7A cont) VÀ sạc cho pin 18650 (~1A sạc). | Nếu củ sạc yếu hoặc mạch không có power-path chuẩn, pin sẽ không bao giờ được sạc đầy khi thiết bị đang chạy. | Dùng USB Tester KWS đo dòng đầu vào Type-C khi pin đang cạn và hệ thống đang hoạt động đầy tải. | Củ sạc 5V/2A - 5V/3A chuẩn | TẬN DỤNG CỦ SẠC CÓ SẴN | Yêu cầu người dùng dùng củ sạc Type-C tối thiểu 5V 2.4A hoặc 5V 3A cấp nguồn.
8 | Phụ kiện chống rung và chống nước vỏ hộp | Hộp đen lắp trên xe máy điện chịu rung xóc mạnh và bụi ẩm môi trường. | Dây nối lỏng, nước lọt vào gây chập điện 48V-72V có thể phá hủy toàn bộ thiết bị và gây nguy cơ cháy nổ. | Thiết kế hộp kín có gioăng cao su, cố định các module bằng keo silicon hoặc ốc đệm cách điện. | Hộp nhựa ABS chống nước, keo silicon, ốc đồng | MUA SAU KHI TEST XONG | Mua sau khi mạch nguồn đã hoạt động ổn định trên bàn test.
BẢNG TỔNG KẾT: DANH SÁCH LINH KIỆN TUYỆT ĐỐI CHƯA NÊN MUA NGAY
STT | Tên linh kiện khuyến cáo CHƯA MUA | Đơn giá dự kiến | Lý do chưa mua | Rủi ro nếu tự ý mua trước
1 | Module hạ áp nguồn xe điện (TPS54560 60V / LM2596HVS) | 65.000 VNĐ | Chưa xác minh điện áp bình xe máy điện (48V, 60V hay 72V) | Mua nhầm module chịu áp 60V lắp vào xe 72V sẽ bị nổ tụ và cháy IC
2 | Module giảm áp riêng 3.8V cho SIM A7682S (LM2596 Buck) | 42.000 VNĐ | Chưa kiểm tra chân VCC bo SIM A7682S có hỗ trợ 5V hay không | Nếu bo SIM đã có sẵn mạch buck 5V mà mua thêm sẽ lãng phí tiền
3 | Hộp cầu chì xe và giắc cắm chống nước ngoài xe | 27.000 VNĐ | Chưa chốt phương án đi dây và vị trí lấy nguồn trên xe máy | Mua sai chuẩn giắc không cắm vừa hệ thống điện của xe
4 | Mạch bảo vệ pin 1S rời (DW01A + 8205A) | 15.000 VNĐ | Chờ test xem mạch bảo vệ tích hợp trên module UPS có đủ tải không | Nếu module UPS bảo vệ tốt thì không cần mua thêm mạch 1S này
