danhcln/AIOT-BLACK-BOX/report_crops/test_btn.png

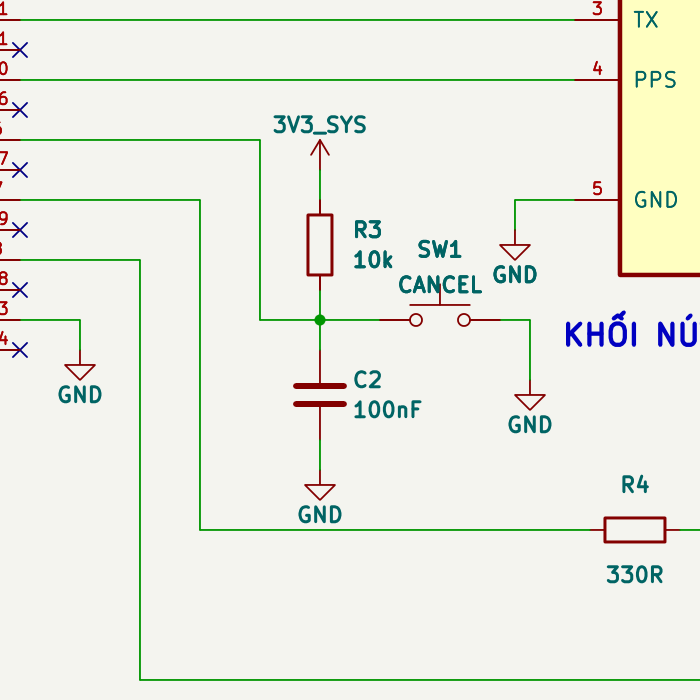
report_crops/test_btn.png
