danhcln/AIOT-BLACK-BOX/report_crops/test_warn.png

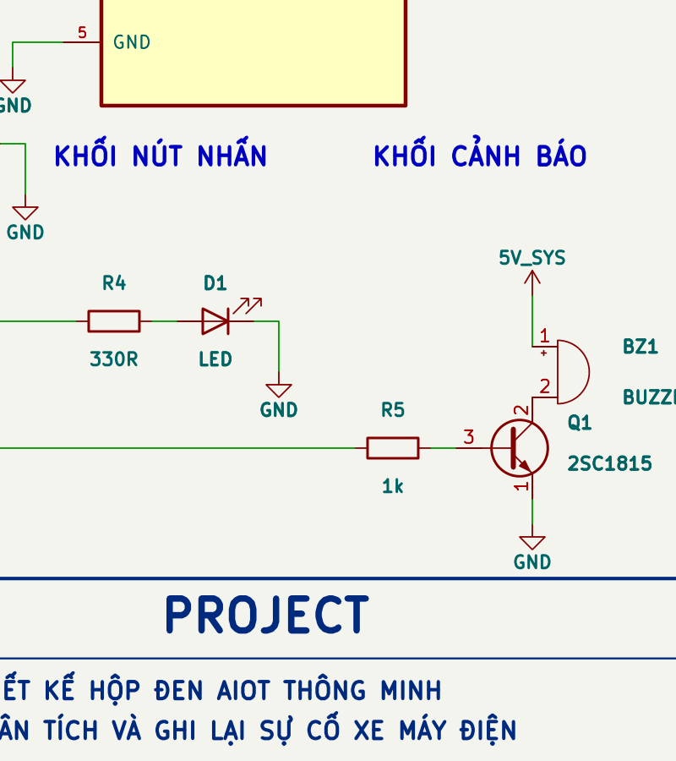
report_crops/test_warn.png
