danhcln/AIOT-BLACK-BOX/THIET_KE_KHOI_NGUON/test_plot.png

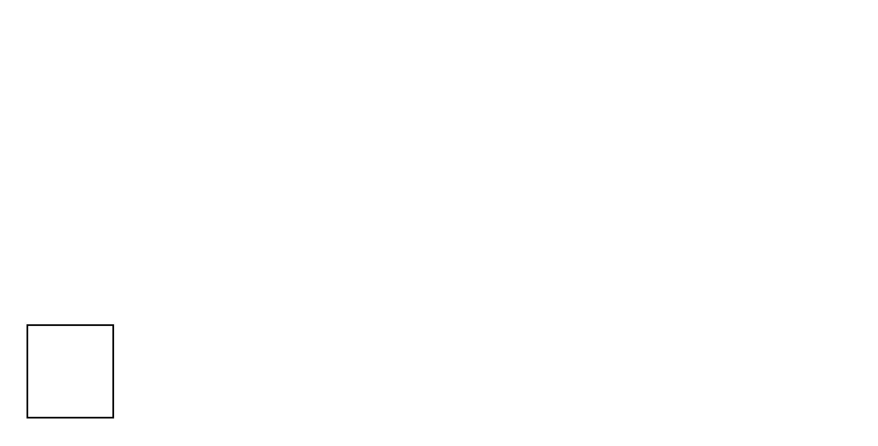
THIET_KE_KHOI_NGUON/test_plot.png
