danhcln/AIOT-BLACK-BOX/PCB_AIOT_BLACKBOX/AIOT_BLACKBOX_MAINBOARD_REV1/GATE_0_AUDIT/SCHEMATIC_CHANGELOG.md

# NHẬT KÝ THAY ĐỔI SCHEMATIC (SCHEMATIC CHANGELOG) — GATE 0

- **Dự án**: THIẾT KẾ HỘP ĐEN AIoT THÔNG MINH PHÂN TÍCH VÀ GHI LẠI SỰ CỐ XE MÁY ĐIỆN
- **Schematic gốc (chỉ đọc, giữ nguyên 100%)**: `D:\ĐỒ ÁN 2\Schematic_Thay\AIOT_BLACKBOX_PRESENTATION\AIOT_BLACKBOX_PRESENTATION.kicad_sch`
- **Schematic mới (đồng bộ theo firmware)**: `D:\ĐỒ ÁN 2\PCB_AIOT_BLACKBOX\AIOT_BLACKBOX_MAINBOARD_REV1\AIOT_BLACKBOX_MAINBOARD_REV1.kicad_sch`
- **Nguồn chuẩn đối chiếu GPIO**: `D:\ĐỒ ÁN 2\filecodemain.cpp`
- **Bộ luật áp dụng**: `D:\ĐỒ ÁN 2\.agents\rules\PCB_DESIGN_RULES_AIOT.md` (21 RULE & 7 GATE)

---

## 1. Tóm tắt nguyên tắc thực hiện

1. **Bảo toàn tuyệt đối project gốc**: Không chỉnh sửa bất kỳ file nào trong `D:\ĐỒ ÁN 2\Schematic_Thay\AIOT_BLACKBOX_PRESENTATION\`.
2. **Bảo toàn tuyệt đối firmware**: Không chỉnh sửa `D:\ĐỒ ÁN 2\filecodemain.cpp`.
3. **Thao tác đúng cấu trúc S-expression KiCad**: Loại bỏ 72 phần tử cũ (symbol nguồn cũ, dây nối lệch GPIO, nhãn cũ) bằng bộ phân tích cú pháp S-expression bảo toàn ngoặc đơn, UUID, thuộc tính linh kiện và bảng thư viện local `Presentation.kicad_sym` (18 symbols) + `sym-lib-table`.
4. **Không sửa electrical pin type để che giấu lỗi ERC**: Giữ nguyên electrical type của các chân trên symbol gốc theo Mục 10.7 và giải trình minh bạch trong `ERC_REPORT.txt`.

---

## 2. Bảng chi tiết các thay đổi trên `AIOT_BLACKBOX_MAINBOARD_REV1.kicad_sch`

| STT | Khối chức năng | Trạng thái ở Schematic gốc (`REV8`) | Thay đổi trong `AIOT_BLACKBOX_MAINBOARD_REV1` | Căn cứ (`filecodemain.cpp` / Luật PCB) |
|---|---|---|---|---|
| 1 | **MicroSD (`J1`) & Xung đột #1 (`GPIO10` / `GPIO14`)** | - `J1.CS` nối vào `U1.GPIO14`<br>- `U1.GPIO10` nối vào `U2.INT` (`MPU6050`) | - Ngắt `J1.CS` khỏi `U1.GPIO14`.<br>- Nối `J1.CS` (Pin 2) trực tiếp vào `U1.GPIO10` (Pin 16) với nhãn mạng `SD_CS_GPIO10`.<br>- Giữ nguyên `GPIO11` (`MOSI`), `GPIO12` (`SCK`), `GPIO13` (`MISO`).<br>- Ngắt `U2.INT` khỏi `GPIO10` và đặt cờ `no_connect` tại `U2.INT` và `U1.GPIO14`. | `#define SD_CS_PIN 10`, `SPI.begin(12, 13, 11, 10)` (`filecodemain.cpp` dòng 19–22, 412). RULE 02 & Mục 5. |
| 2 | **Module SIM 4G (`U5`) & Xung đột #2 (`GPIO15`, `GPIO16`, `GPIO43`, `GPIO44`)** | - Tên linh kiện `U5`: `MKE-M21`<br>- `U5.RX` nối `U1.GPIO43`<br>- `U5.TX` nối `U1.GPIO44`<br>- `U5.PWRKEY` nối `U1.GPIO4`<br>- `U5.STATUS` nối `U1.GPIO5`<br>- `U1.GPIO15` nối `BUZZER_CTRL`<br>- `U1.GPIO16` đặt `no_connect` | - Đổi Value hiển thị của `U5` thành `A7682S` (`4G BREAKOUT`).<br>- Ngắt toàn bộ `GPIO43`, `GPIO44`, `GPIO4`, `GPIO5` khỏi `U5` và gắn `no_connect` (trả lại `GPIO43/44` cho `Serial.begin(115200)`).<br>- Nối `U1.GPIO16` (`SIM_TX_PIN`) → `U5.RX` (Pin 2) qua mạng `SIM_TX_GPIO16`.<br>- Nối `U1.GPIO15` (`SIM_RX_PIN`) ← `U5.TX` (Pin 3) qua mạng `SIM_RX_GPIO15`.<br>- Gắn `no_connect` vào `U5.PWRKEY` (Pin 4) và `U5.STATUS` (Pin 5). | `#define SIM_RX_PIN 15`, `#define SIM_TX_PIN 16`, `simSerial.begin(115200, SERIAL_8N1, 15, 16)` (`filecodemain.cpp` dòng 24–25, 444). RULE 02 & Mục 5. |
| 3 | **Nguồn cấp SIM (`SIM_PWR`)** | - `U5.VCC` (Pin 1) nối trực tiếp vào `5V_SYS` | - Tách `U5.VCC` khỏi `5V_SYS`.<br>- Tạo nhánh nguồn riêng `SIM_PWR` cấp từ connector `J3` (`SIM_PWR_CONN` — ghi chú `VERIFY V_IN` / `NEEDS_VERIFICATION`). | RULE 06 & Mục 5, Mục 7 (*"Không tự cấp 5V vào VCC SIM khi chưa xác minh điện áp đầu vào đúng của breakout"*). |
| 4 | **Khối Nguồn Hệ Thống (`J2`, `U6`, `C1`)** | - Dùng `J2` (`USB-C VBUS`), `U6` (`18650 POWER`), pin `BT1`, cầu phân áp `R1/R2` (`100k/100k`) tạo `ADC_VBAT_SENSE` vào `U1.GPIO1`.<br>- Chân `U1.3V3` (Pin 1) nối trực tiếp vào `3V3_SYS` (khiến ESP32 cấp nguồn 3.3V cho toàn bộ ngoại vi). | - Thay khối nguồn cũ bằng kiến trúc carrier board thực tế:<br>  + `J2` (`LX-2BUPS_IN`): nhận `UPS+` → `5V_SYS` và `UPS-` → `GND` từ module UPS `LX-2BUPS 5V/3A (2x18650)` nằm ngoài PCB.<br>  + `U6` (`REG 3.3V MODULE`): nhận `5V_SYS` (`IN+`) và `GND` (`IN-`), tạo đường nguồn độc lập `3V3_SYS` (`3V3`) đi kèm tụ lọc `C1` (`100nF`).<br>- **Tách hoàn toàn chân `U1.3V3` (Pin 1) khỏi đường `3V3_SYS`** và gắn `no_connect` cho cả hai chân `3V3` (Pin 1, Pin 2) của `U1`.<br>- Ngắt `ADC_VBAT_SENSE` khỏi `U1.GPIO1` và gắn `no_connect` tại `U1.GPIO1`. | RULE 06 & Mục 7 (*"Tách rõ 5V_SYS, 3V3_SYS, SIM_PWR, GND; không dùng chân 3V3 của ESP32 làm nguồn chính cho toàn mạch"*). |
| 5 | **Khối GPS (`U4` - `NEO-M8N`)** | - `U4.RX` (Pin 2) nối `U1.GPIO17`<br>- `U4.TX` (Pin 3) nối `U1.GPIO18`<br>- `U4.PPS` (Pin 4) nối `U1.GPIO21`<br>- `U4.VCC` nối `3V3_SYS`, `U4.GND` nối `GND` | - Giữ nguyên kết nối UART1 đã đúng với code và gắn nhãn rõ ràng:<br>  + `GPS_TX_GPIO17`: `U1.GPIO17` (ESP TX) → `U4.RX`<br>  + `GPS_RX_GPIO18`: `U1.GPIO18` (ESP RX) ← `U4.TX`<br>- Ngắt dây `GNSS_PPS` giữa `U4.PPS` và `U1.GPIO21`; đặt `no_connect` tại `U4.PPS` (Pin 4) và `U1.GPIO21` (Pin 31). | `#define GPS_RX_PIN 18`, `#define GPS_TX_PIN 17`, `gpsSerial.begin(9600, SERIAL_8N1, 18, 17)` (`filecodemain.cpp` dòng 27–28, 398). RULE 02 & Mục 5. |
| 6 | **Bus I2C (`U2` MPU6050, `U3` DS3231, `U7` OLED SSD1306)** | - `SDA` nối `U1.GPIO8`, `SCL` nối `U1.GPIO9` có điện trở kéo lên `R_PU1 = 4.7k`, `R_PU2 = 4.7k` lên `3V3_SYS`.<br>- `U2.AD0` (Pin 7) nối lên `3V3_SYS` (`HIGH` → `0x69`). | - Giữ nguyên kết nối `SDA = GPIO8`, `SCL = GPIO9` và cấu hình `U2.AD0 = 3V3_SYS` (`0x69`, không trùng `0x68` của `DS3231`).<br>- Bổ sung nhãn mạng tường minh `I2C_SDA_GPIO8` và `I2C_SCL_GPIO9`. | `#define I2C_SDA_PIN 8`, `#define I2C_SCL_PIN 9`, `Wire.begin(8, 9)` (`filecodemain.cpp` dòng 16–17, 369); `OLED 0x3C`, `DS3231 0x68`, `MPU6050 0x69`. |
| 7 | **Khối Nút nhấn `CANCEL` (`SW1`), `LED` (`D1`), `Buzzer` (`BZ1`/`Q1`)** | - `SW1` nối `U1.GPIO6`<br>- `D1/R4` nối `U1.GPIO7`<br>- `Q1/R5/BZ1` nối `U1.GPIO15` | - Ngắt kết nối khỏi `GPIO6`, `GPIO7`, `GPIO15`.<br>- Giữ lại các cụm linh kiện dự phòng trên bản vẽ, gắn `no_connect` tại đầu vào điều khiển và ghi chú văn bản rõ ràng: `UNASSIGNED_CANCEL`, `UNASSIGNED_LED`, `UNASSIGNED_BUZZER`.<br>- Đặt `no_connect` tại `U1.GPIO6` và `U1.GPIO7`. | RULE 02 & Mục 6 (*"Không tự chọn GPIO mới; giữ ở dạng connector/test pad dự phòng hoặc đánh dấu rõ UNASSIGNED"*). |
| 8 | **Thư viện Symbol Local (`Presentation.kicad_sym` & `sym-lib-table`)** | - Các symbol `Presentation:*` chỉ nằm nhúng trong `.kicad_sch`; `3V3_SYS` và `5V_SYS` trỏ về thư viện `power:*` gây cảnh báo thiếu symbol trong thư viện chuẩn KiCad. | - Trích xuất toàn bộ 18 symbol `Presentation:*` (bao gồm `3V3_SYS`, `5V_SYS`, `SIM_PWR`, `UPS_Input_Conn`, `Regulator_3V3_Module`, `SIM_PWR_Conn`, `ESP32-S3-DevKitC-1`, v.v.) ra thư viện local `Presentation.kicad_sym` kèm `sym-lib-table`.<br>- Kết quả: Mở project bằng KiCad không thiếu bất kỳ symbol nào (`0 lib_symbol_issues`). | Mục 4 (*"Bảo đảm project mở được bằng KiCad mà không thiếu symbol hoặc liên kết thư viện"*). |
