danhcln/AIOT-BLACK-BOX/THIET_KE_KHOI_NGUON/04_POWER_SCHEMATIC.pdf

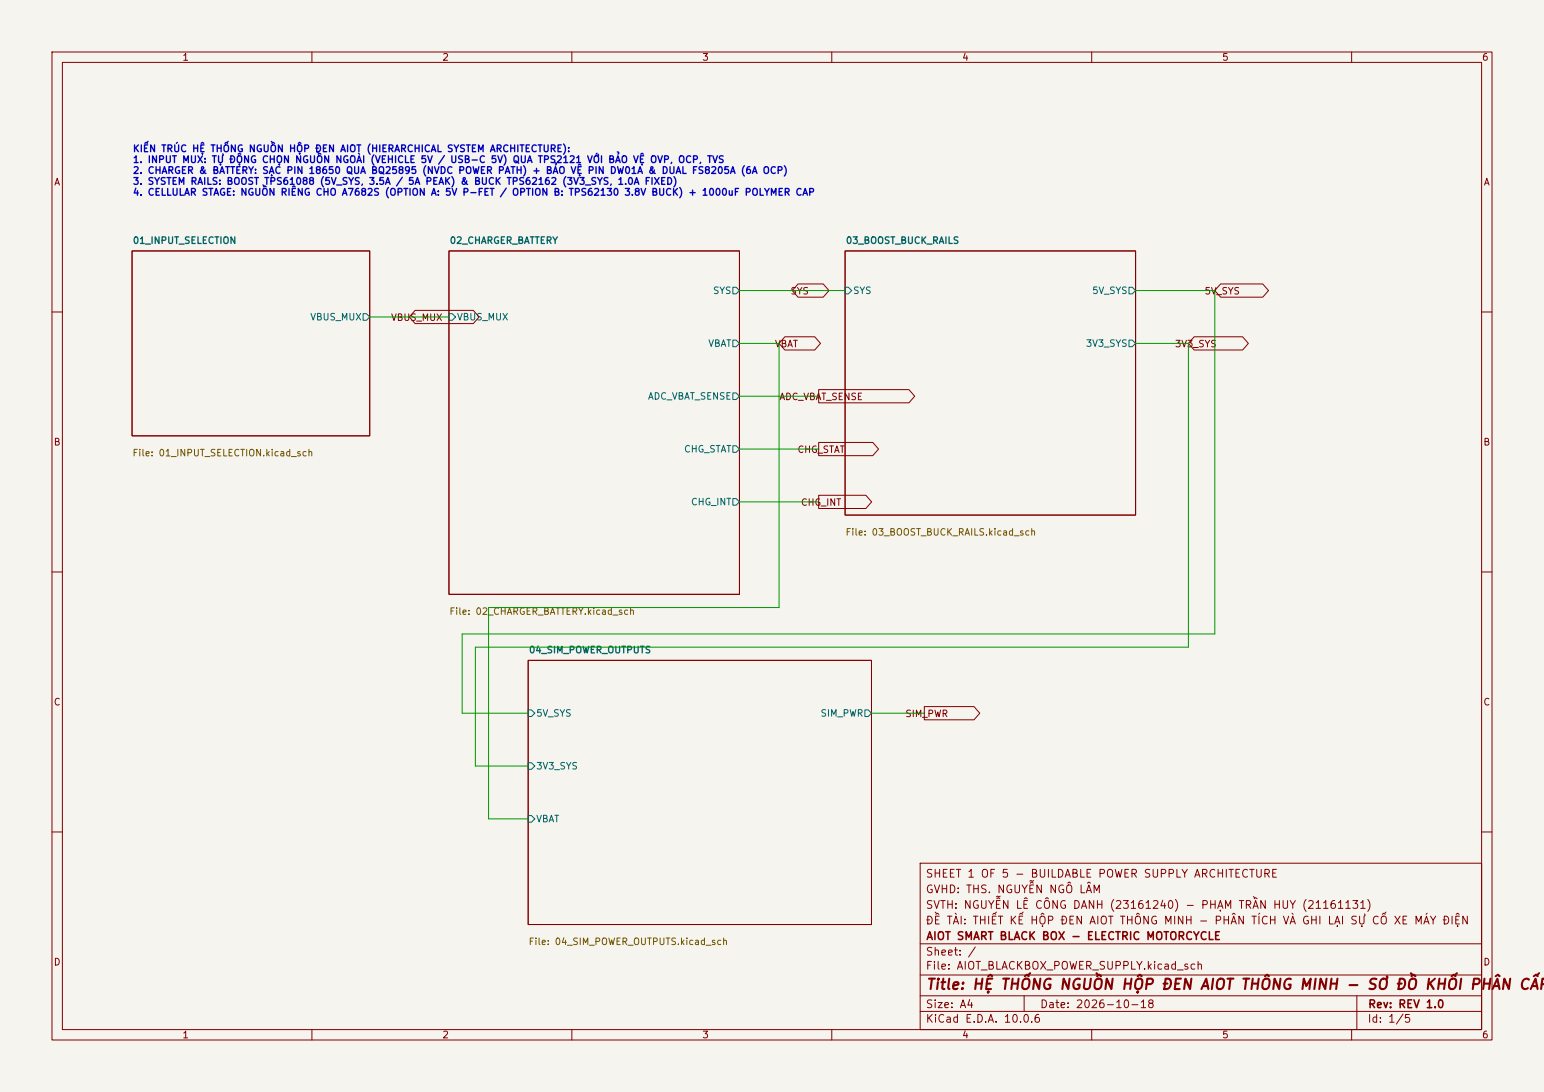
[picture p148: page 1]

2. CHARGER & BATTERY: SẠC PIN 18650 QUA BQ25895 (NVDC POWER PATH) + BẢO VỆ PIN DW01A & DUAL FS8205A (6A OCP) 3. SYSTEM RAILS: BOOST TPS61088 (5V_SYS, 3.5A / 5A PEAK) & BUCK TPS62162 (3V3_SYS, 1.0A FIXED) 4. CELLULAR STAGE: NGUỒN RIÊNG CHO A7682S (OPTION A: 5V P-FET / OPTION B: TPS62130 3.8V BUCK) + 1000uF POLYMER CAP

SHEET 1 OF 5 - BUILDABLE POWER SUPPLY ARCHITECTURE
GVHD: THS. NGUYỄN NGÔ LÂM
SVTH: NGUYỄN LÊ CÔNG DANH (23161240) - PHẠM TRẦN HUY (21161131)
ĐỀ TÀI: THIẾT KẾ HỘP ĐEN AIOT THÔNG MINH - PHÂN TÍCH VÀ GHI LẠI SỰ CỐ XE MÁY ĐIỆN
AIOT SMART BLACK BOX - ELECTRIC MOTORCYCLE
Sheet: /
File: AIOT_BLACKBOX_POWER_SUPPLY.kicad_sch
Title: HỆ THỐNG NGUỒN HỘP ĐEN AIOT THÔNG MINH - SƠ ĐỒ KHỐI PHÂN CẤP TỔNG THỂ

Size: A4 | Rev: REV 1.0
KiCad E.D.A. 10.0.6 | Id: 1/5

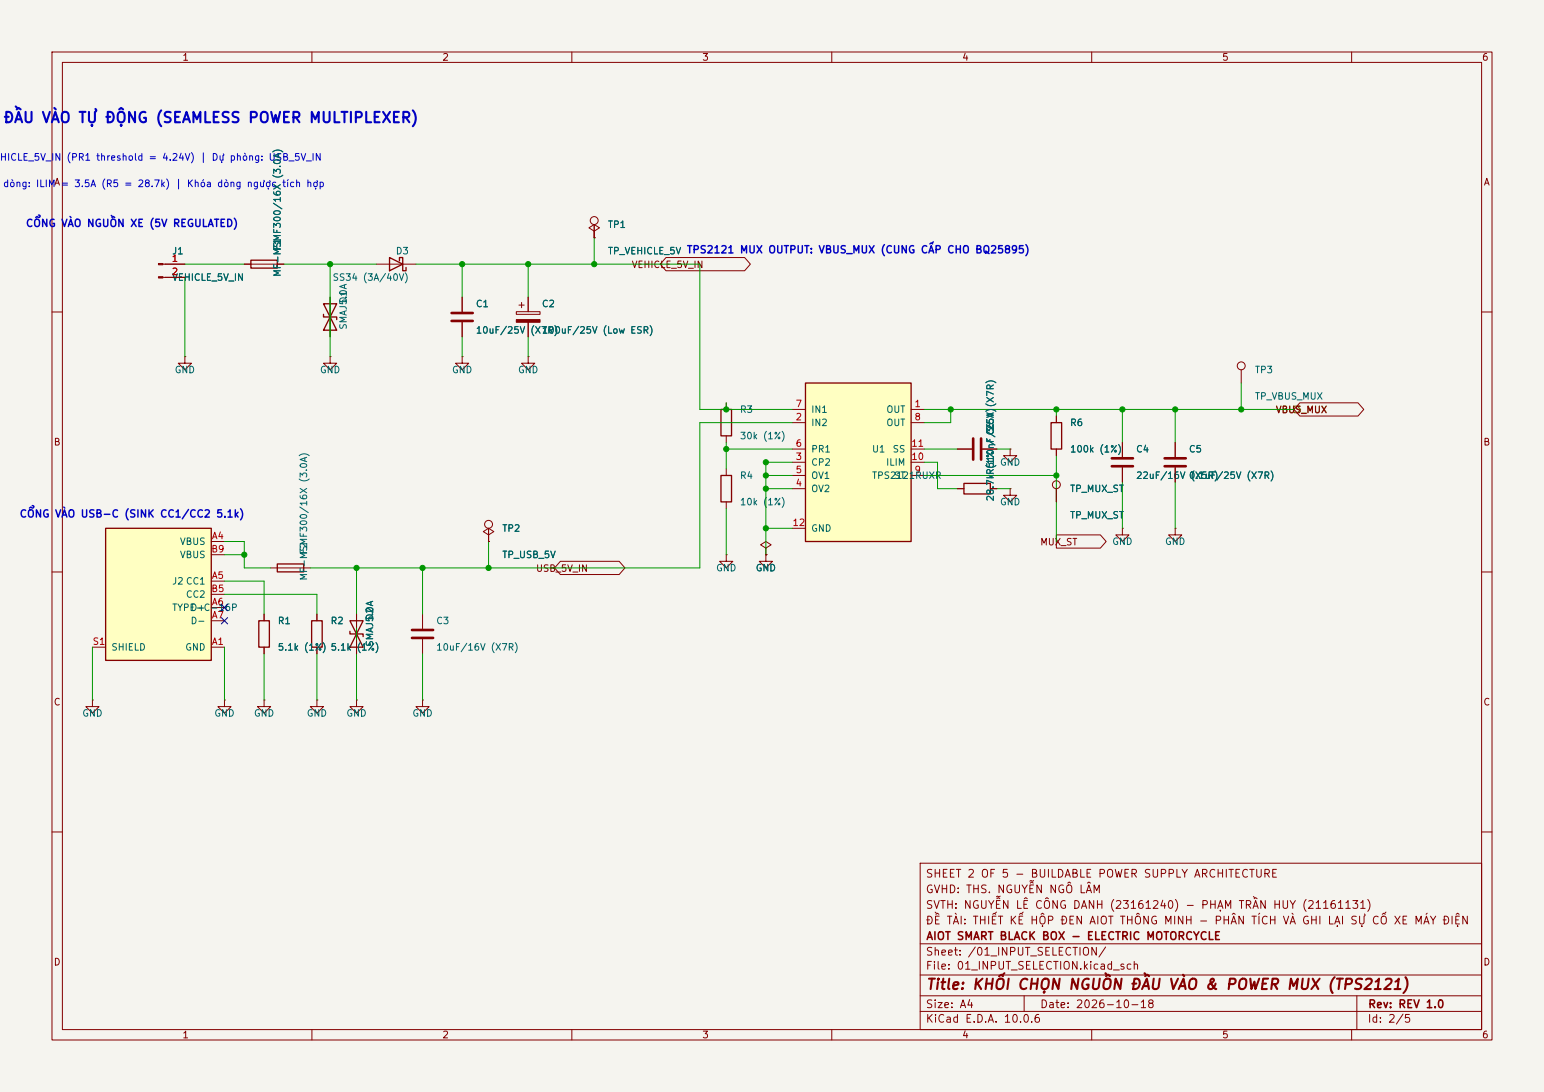
[picture p149: page 2]

Ưu tiên: VEHICLE_5V_IN (PR1 threshold = 4.24V) | Dự phòng: USB_5V_IN

Bảo vệ quá dòng: ILIM = 3.5A (R5 = 28.7k) | Khóa dòng ngược tích hợp

CỔNG VÀO NGUỒN XE (5V REGULATED)

TPS2121 MUX OUTPUT: VBUS_MUX (CUNG CẤP CHO BQ25895)

SHEET 2 OF 5 - BUILDABLE POWER SUPPLY ARCHITECTURE
GVHD: THS. NGUYỄN NGÔ LÂM
SVTH: NGUYỄN LÊ CÔNG DANH (23161240) - PHẠM TRẦN HUY (21161131)
ĐỀ TÀI: THIẾT KẾ HỘP ĐEN AIOT THÔNG MINH - PHÂN TÍCH VÀ GHI LẠI SỰ CỐ XE MÁY ĐIỆN
AIOT SMART BLACK BOX - ELECTRIC MOTORCYCLE
Sheet: /01_INPUT_SELECTION/
File: 01_INPUT_SELECTION.kicad_sch
Title: KHỐI CHỌN NGUỒN ĐẦU VÀO & POWER MUX (TPS2121)

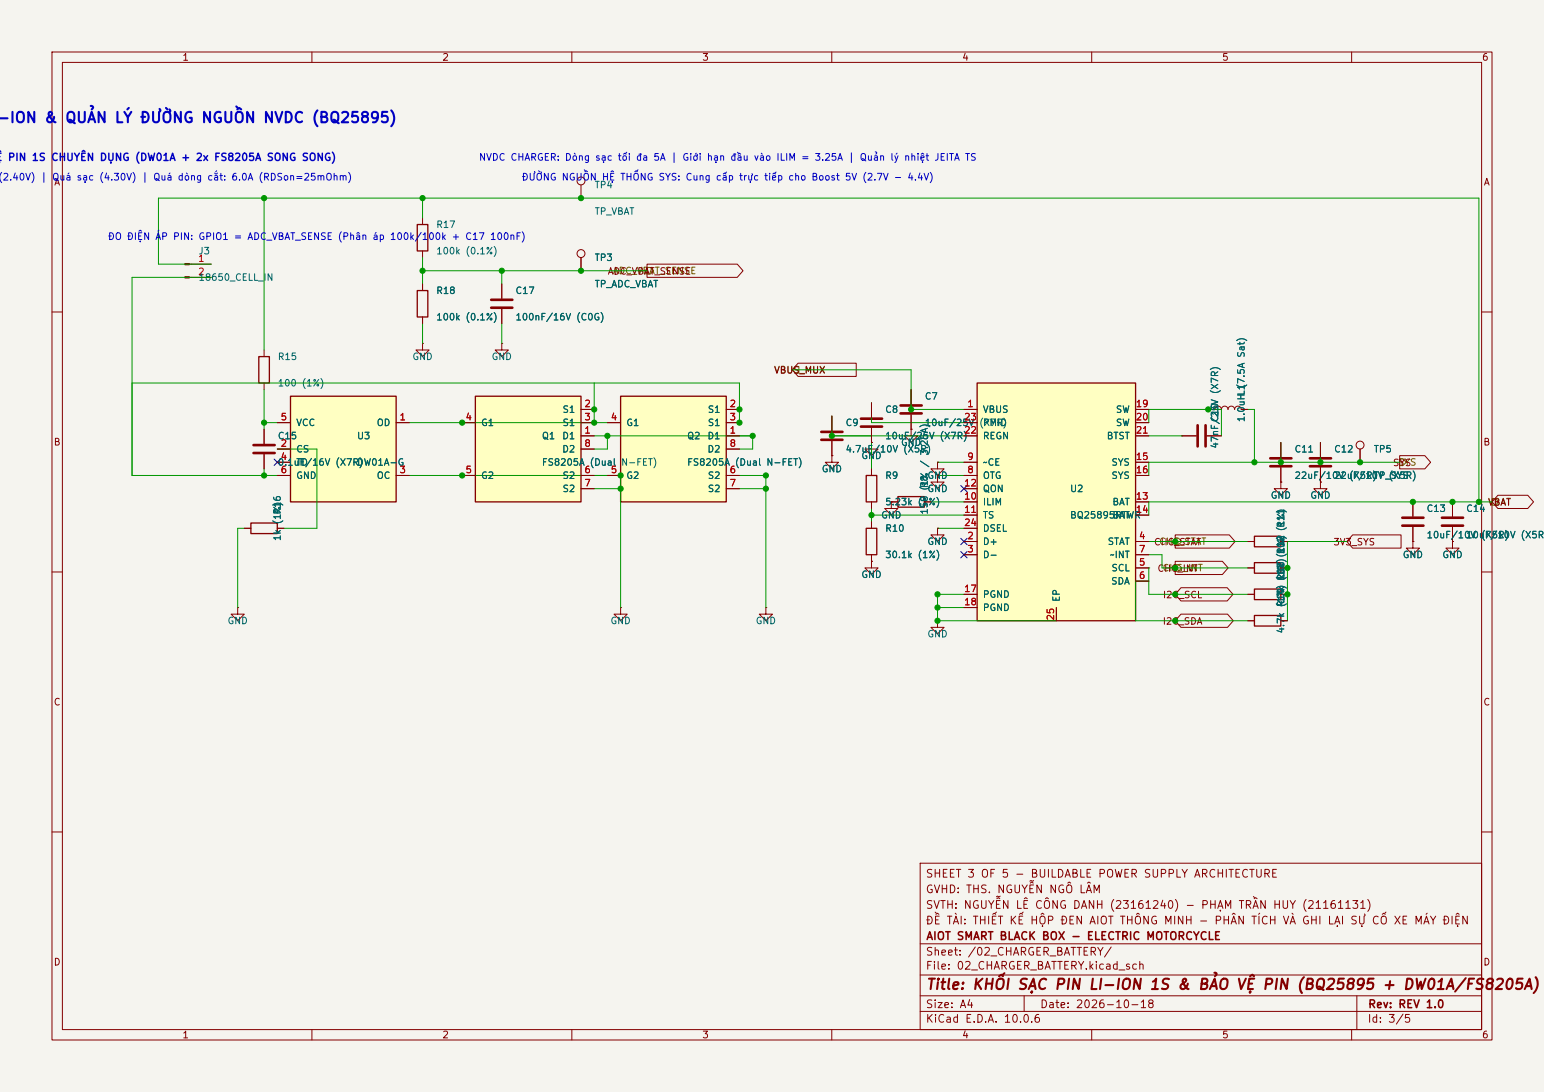
[picture p150: page 3]

KHỐI SẠC PIN LI-ION & QUẢN LÝ ĐƯỜNG NGUỒN NVDC (BQ25895)

VBAT VBUS_MUX BẢO VỆ: Quá xả (2.40V) | Quá sạc (4.30V) | Quá dòng cắt: 6.0A (RDSon=25mOhm)

ĐƯỜNG NGUỒN HỆ THỐNG SYS: Cung cấp trực tiếp cho Boost 5V (2.7V - 4.4V)

SHEET 3 OF 5 - BUILDABLE POWER SUPPLY ARCHITECTURE
GVHD: THS. NGUYỄN NGÔ LÂM
SVTH: NGUYỄN LÊ CÔNG DANH (23161240) - PHẠM TRẦN HUY (21161131)
ĐỀ TÀI: THIẾT KẾ HỘP ĐEN AIOT THÔNG MINH - PHÂN TÍCH VÀ GHI LẠI SỰ CỐ XE MÁY ĐIỆN
AIOT SMART BLACK BOX - ELECTRIC MOTORCYCLE
Sheet: /02_CHARGER_BATTERY/
File: 02_CHARGER_BATTERY.kicad_sch
Title: KHỐI SẠC PIN LI-ION 1S & BẢO VỆ PIN (BQ25895 + DW01A/FS8205A)

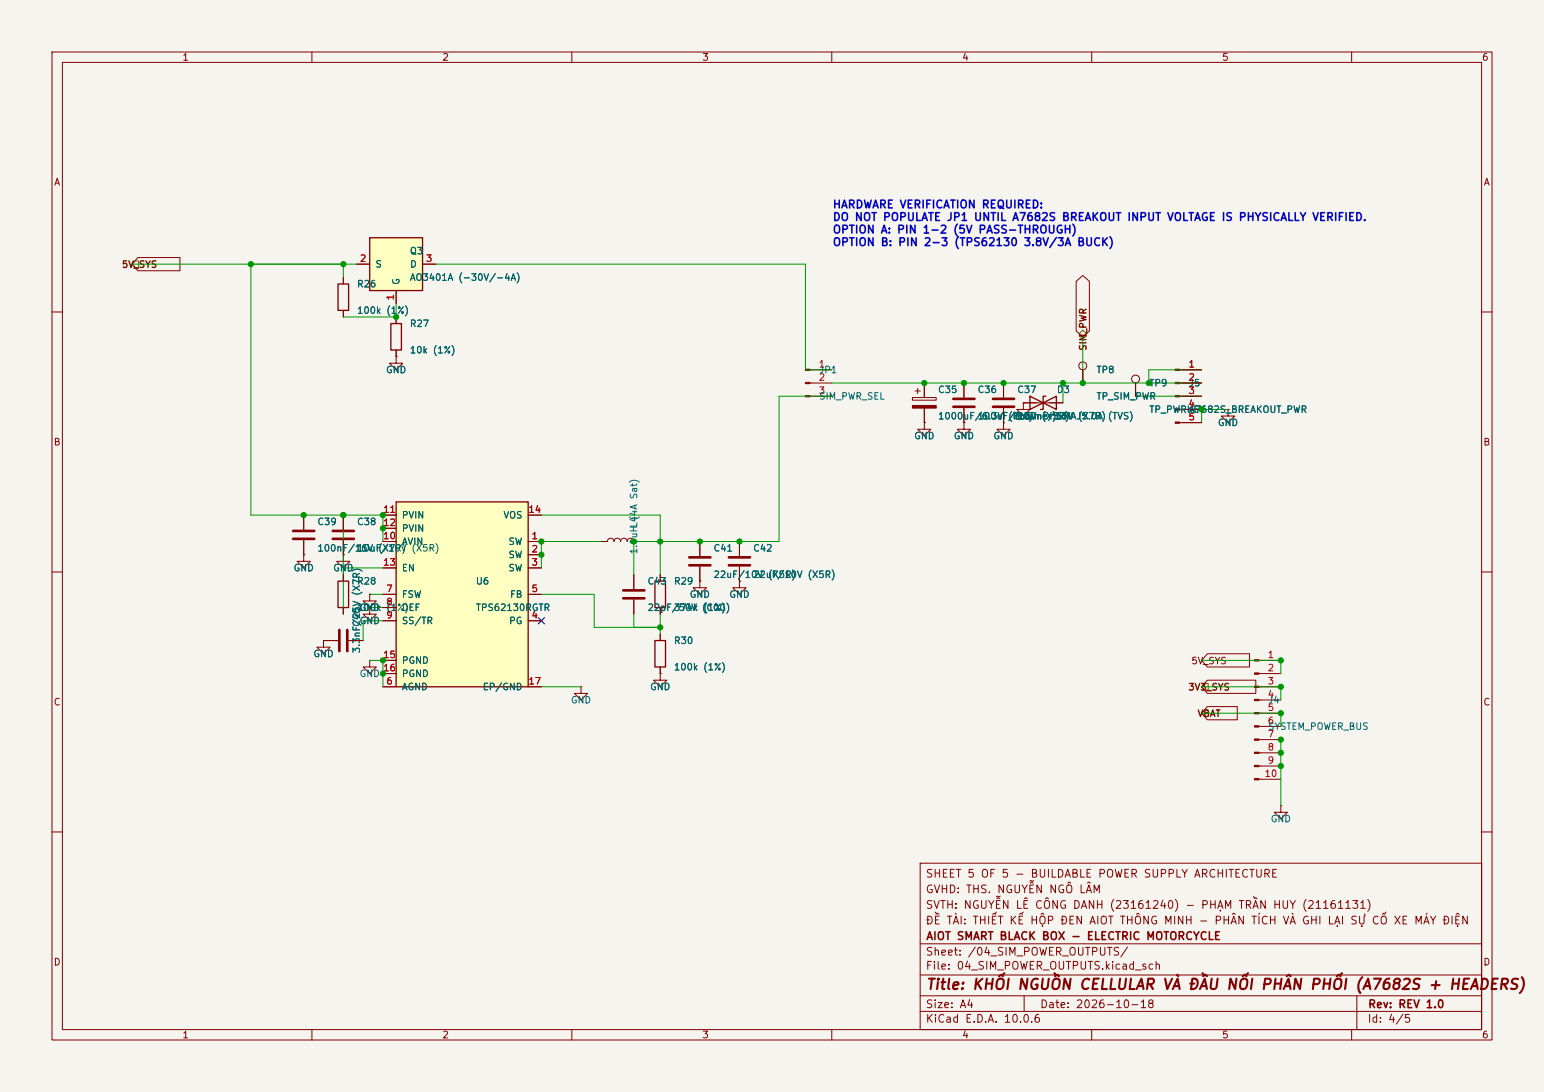
[picture p151: page 4]

VBAT 5V_SYS HARDWARE VERIFICATION REQUIRED:
DO NOT POPULATE JP1 UNTIL A7682S BREAKOUT INPUT VOLTAGE IS PHYSICALLY VERIFIED.
OPTION A: PIN 1-2 (5V PASS-THROUGH)
OPTION B: PIN 2-3 (TPS62130 3.8V/3A BUCK) D3

SHEET 5 OF 5 - BUILDABLE POWER SUPPLY ARCHITECTURE
GVHD: THS. NGUYỄN NGÔ LÂM
SVTH: NGUYỄN LÊ CÔNG DANH (23161240) - PHẠM TRẦN HUY (21161131)
ĐỀ TÀI: THIẾT KẾ HỘP ĐEN AIOT THÔNG MINH - PHÂN TÍCH VÀ GHI LẠI SỰ CỐ XE MÁY ĐIỆN
AIOT SMART BLACK BOX - ELECTRIC MOTORCYCLE
Sheet: /04_SIM_POWER_OUTPUTS/
File: 04_SIM_POWER_OUTPUTS.kicad_sch
Title: KHỐI NGUỒN CELLULAR VÀ ĐẦU NỐI PHÂN PHỐI (A7682S + HEADERS)

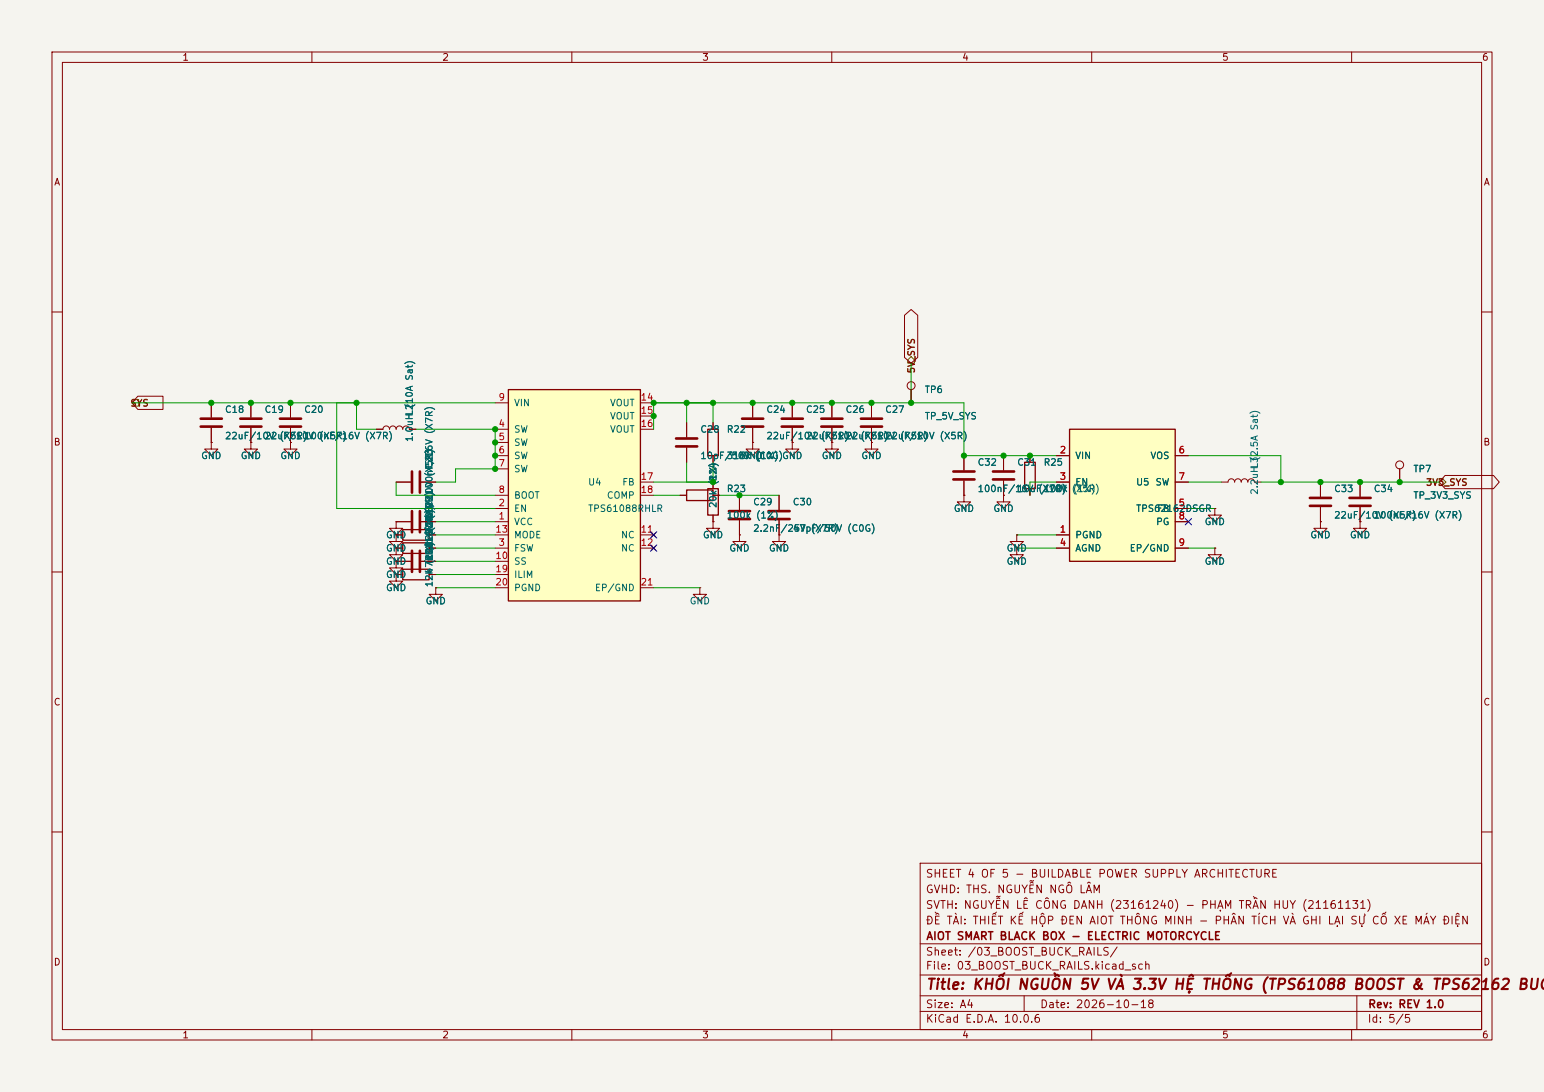
[picture p152: page 5]

SHEET 4 OF 5 - BUILDABLE POWER SUPPLY ARCHITECTURE
GVHD: THS. NGUYỄN NGÔ LÂM
SVTH: NGUYỄN LÊ CÔNG DANH (23161240) - PHẠM TRẦN HUY (21161131)
ĐỀ TÀI: THIẾT KẾ HỘP ĐEN AIOT THÔNG MINH - PHÂN TÍCH VÀ GHI LẠI SỰ CỐ XE MÁY ĐIỆN
AIOT SMART BLACK BOX - ELECTRIC MOTORCYCLE
Sheet: /03_BOOST_BUCK_RAILS/
File: 03_BOOST_BUCK_RAILS.kicad_sch
Title: KHỐI NGUỒN 5V VÀ 3.3V HỆ THỐNG (TPS61088 BOOST & TPS62162 BUCK)
