danhcln/AIOT-BLACK-BOX/THIET_KE_KHOI_NGUON/test_sym.pdf

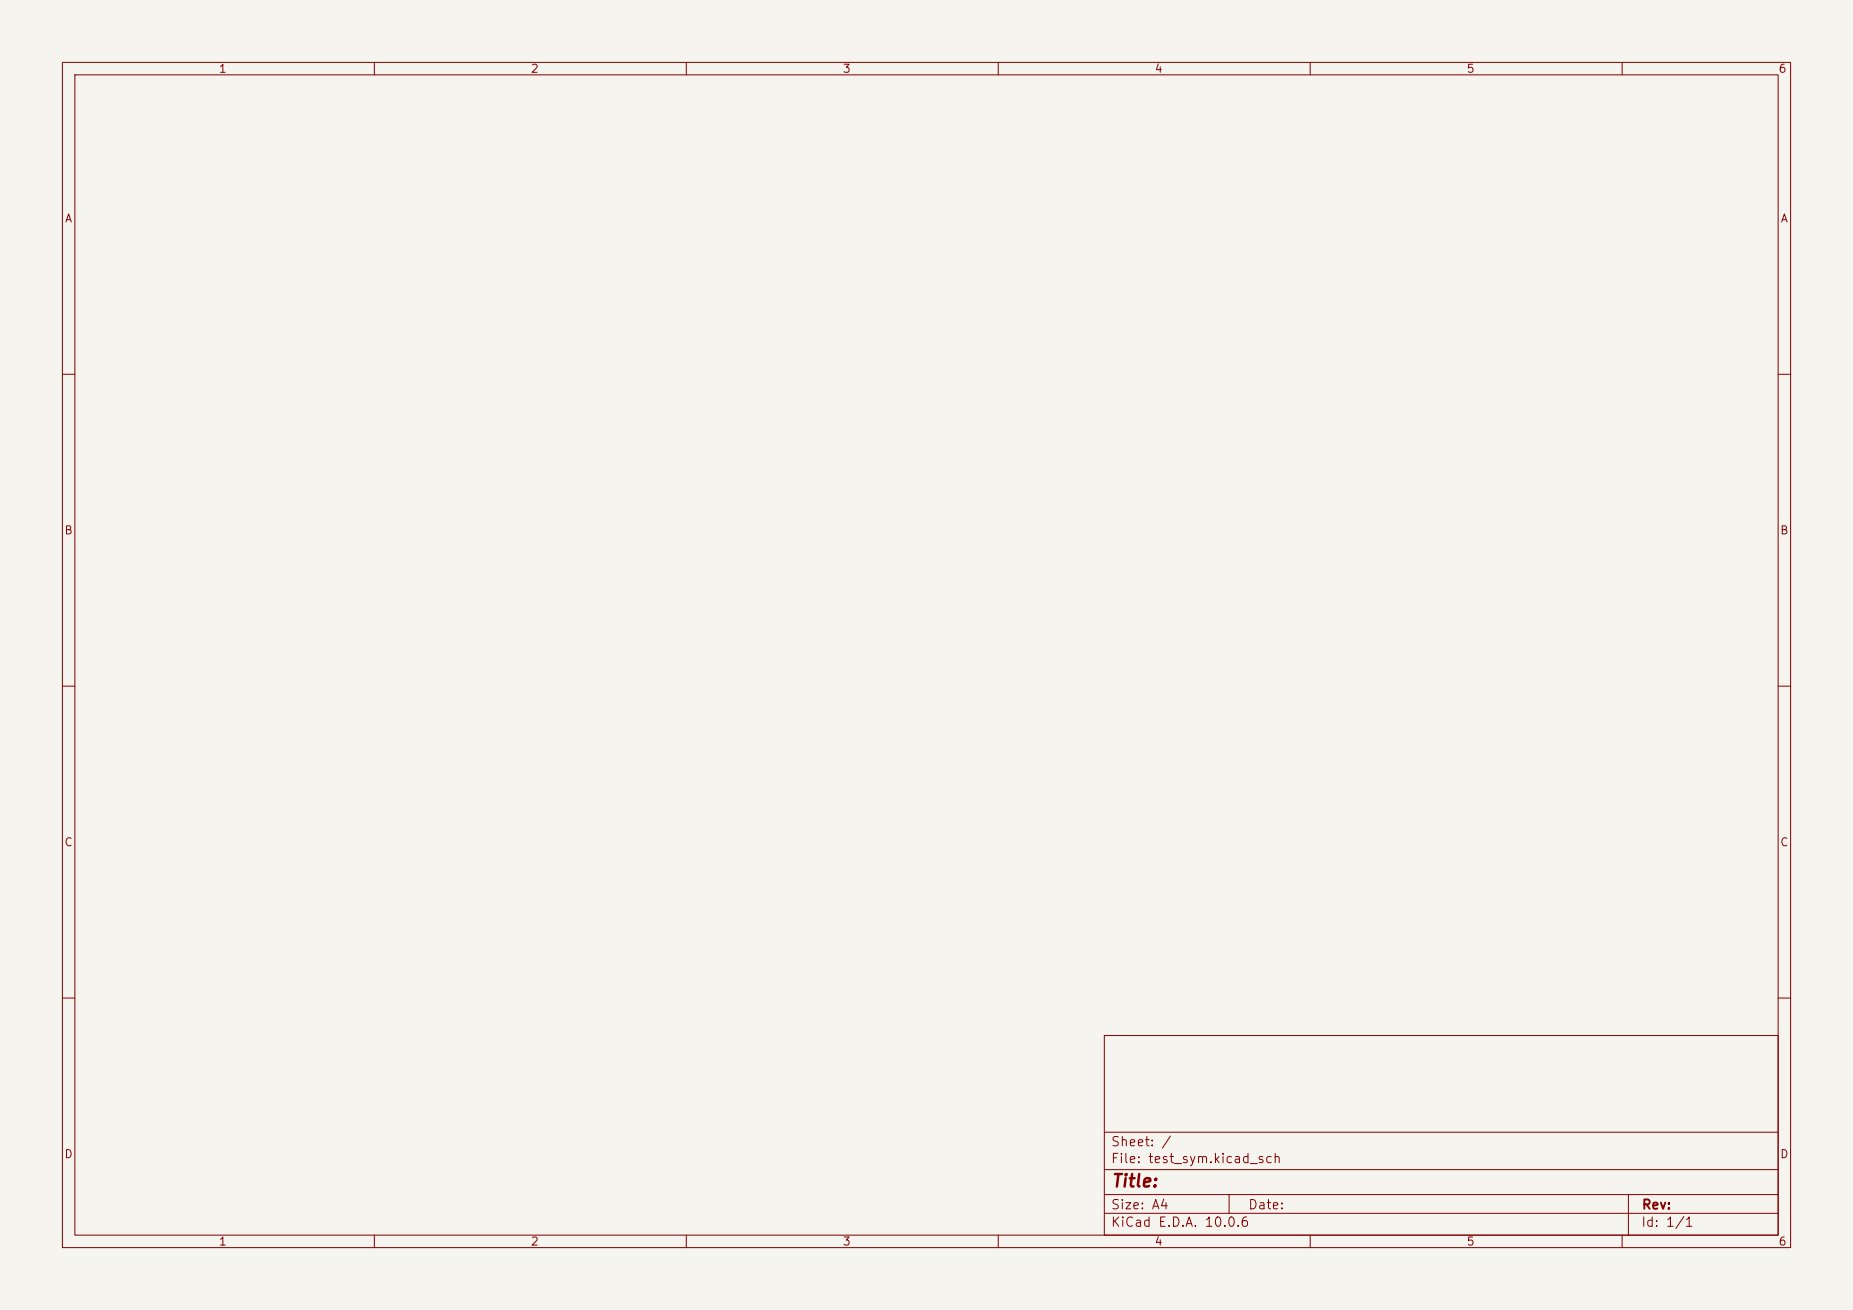
[picture p153: page 1]

Size: A4 | Rev:
KiCad E.D.A. 10.0.6 | Id: 1/1
