danhcln/AIOT-BLACK-BOX/Schematic/AIOT_BLACKBOX/AIOT_BLACKBOX_TEST.pdf

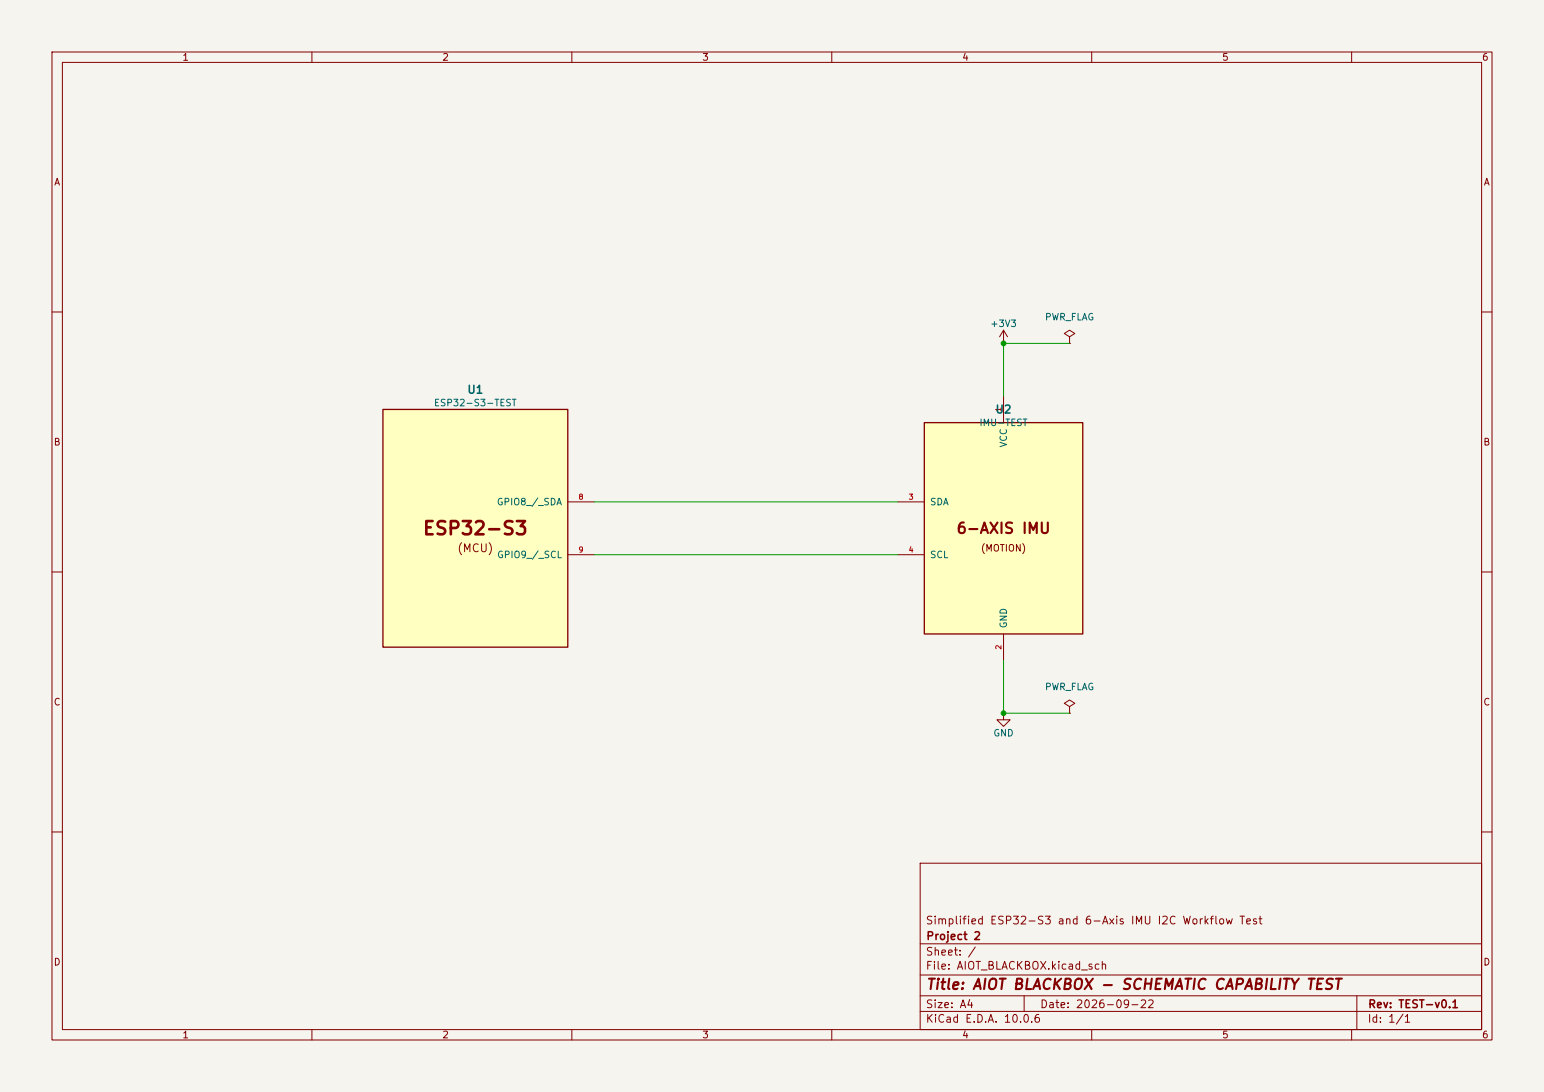
[picture p154: page 1]

Simplified ESP32-S3 and 6-Axis IMU I2C Workflow Test GND

Project 2
Sheet: /
File: AIOT_BLACKBOX.kicad_sch
Title: AIOT BLACKBOX - SCHEMATIC CAPABILITY TEST

Size: A4 | Rev: TEST-v0.1
KiCad E.D.A. 10.0.6 | Id: 1/1
