danhcln/AIOT-BLACK-BOX/Schematic_Thay/AIOT_BLACKBOX_PRESENTATION/AIOT_BLACKBOX_PRESENTATION.pdf

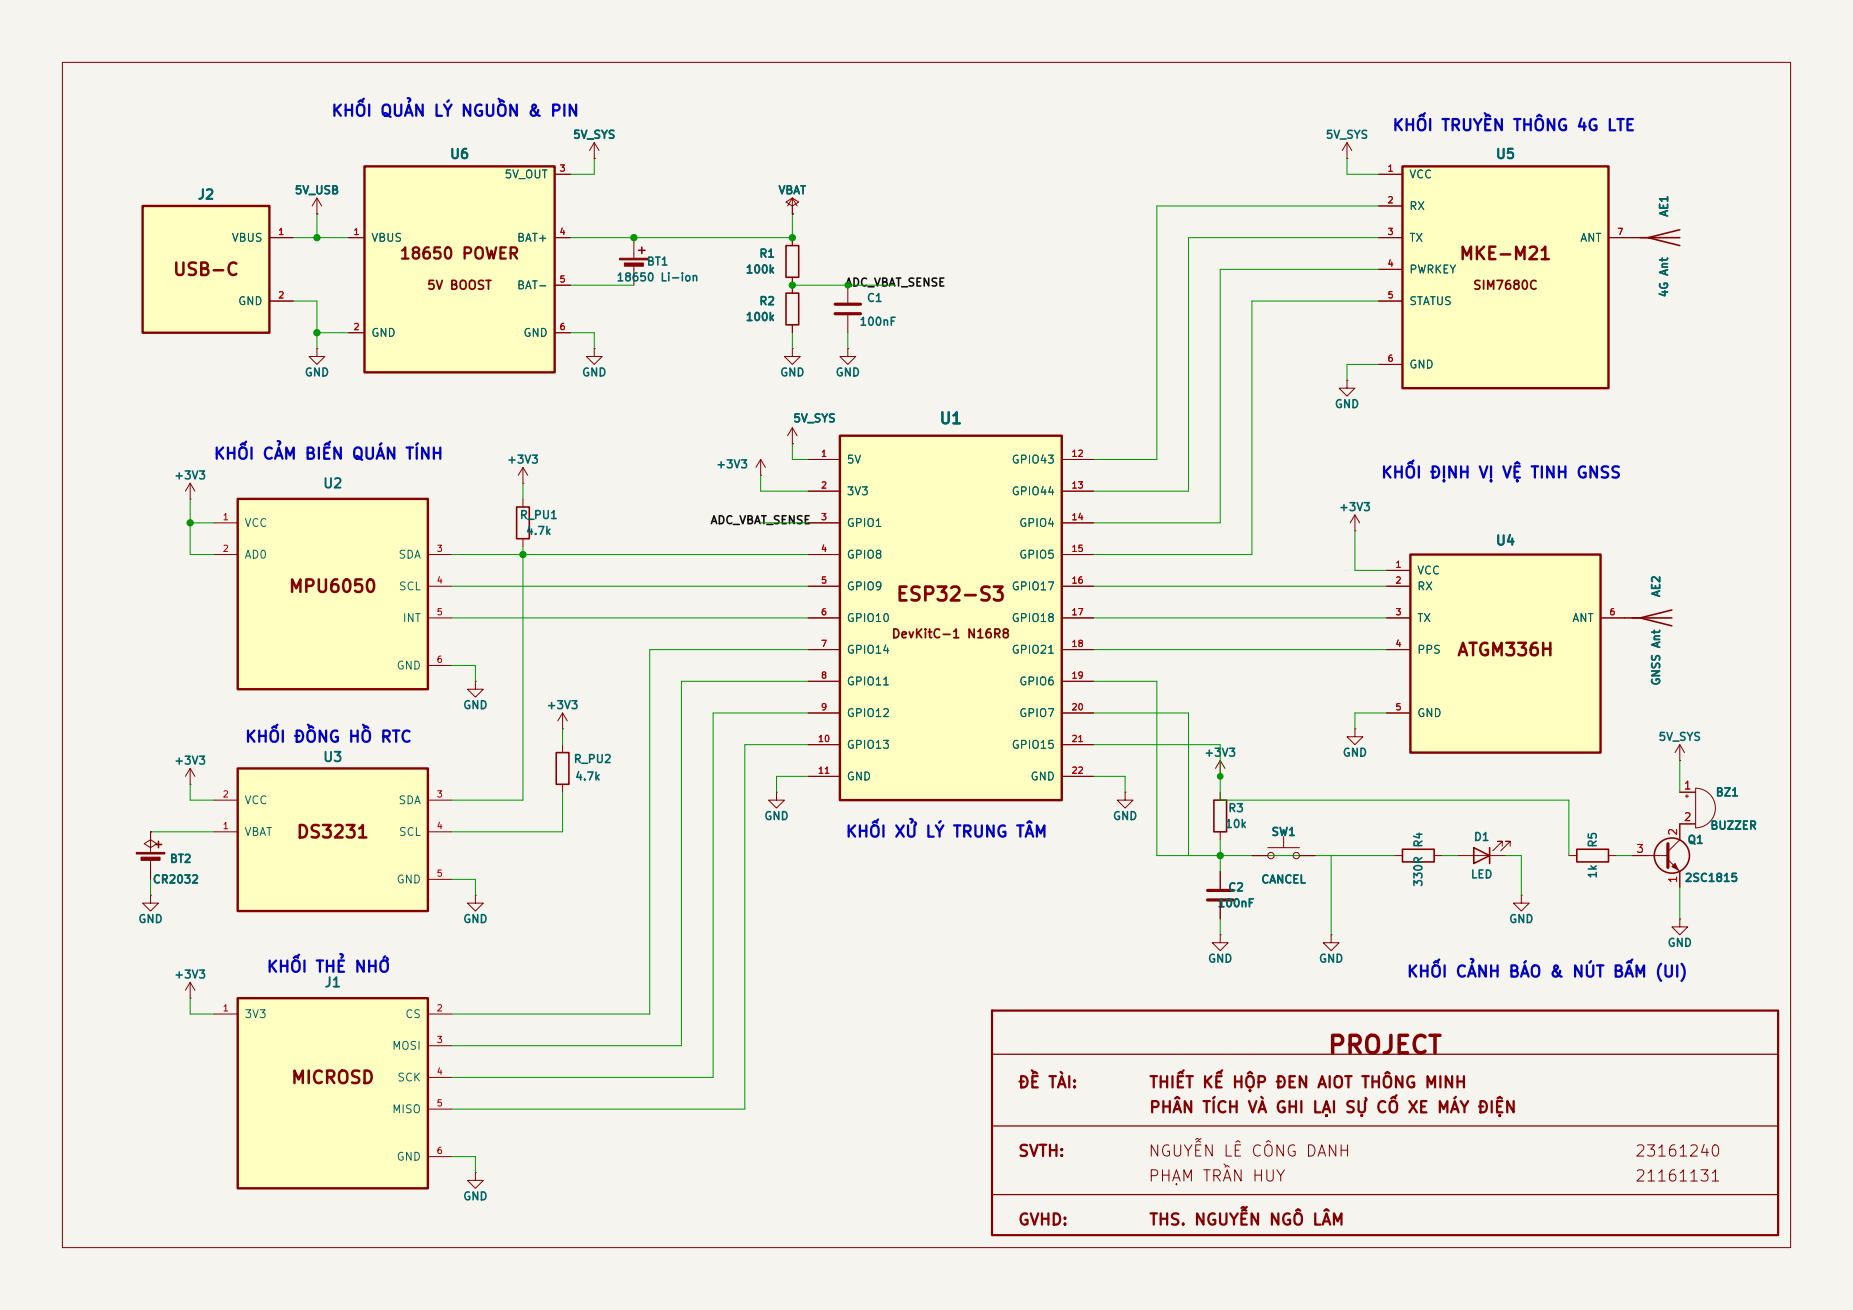
[picture p155: page 1]

KHỐI QUẢN LÝ NGUỒN & PIN

KHỐI TRUYỀN THÔNG 4G LTE

KHỐI CẢM BIẾN QUÁN TÍNH

KHỐI ĐỊNH VỊ VỆ TINH GNSS

KHỐI ĐỒNG HỒ RTC

KHỐI XỬ LÝ TRUNG TÂM

KHỐI CẢNH BÁO & NÚT BẤM (UI)

PHÂN TÍCH VÀ GHI LẠI SỰ CỐ XE MÁY ĐIỆN
