danhcln/AIOT-BLACK-BOX/Schematic_Thay/AIOT_BLACKBOX_PRESENTATION/AIOT_BLACKBOX_PRESENTATION_A4_REV7.pdf

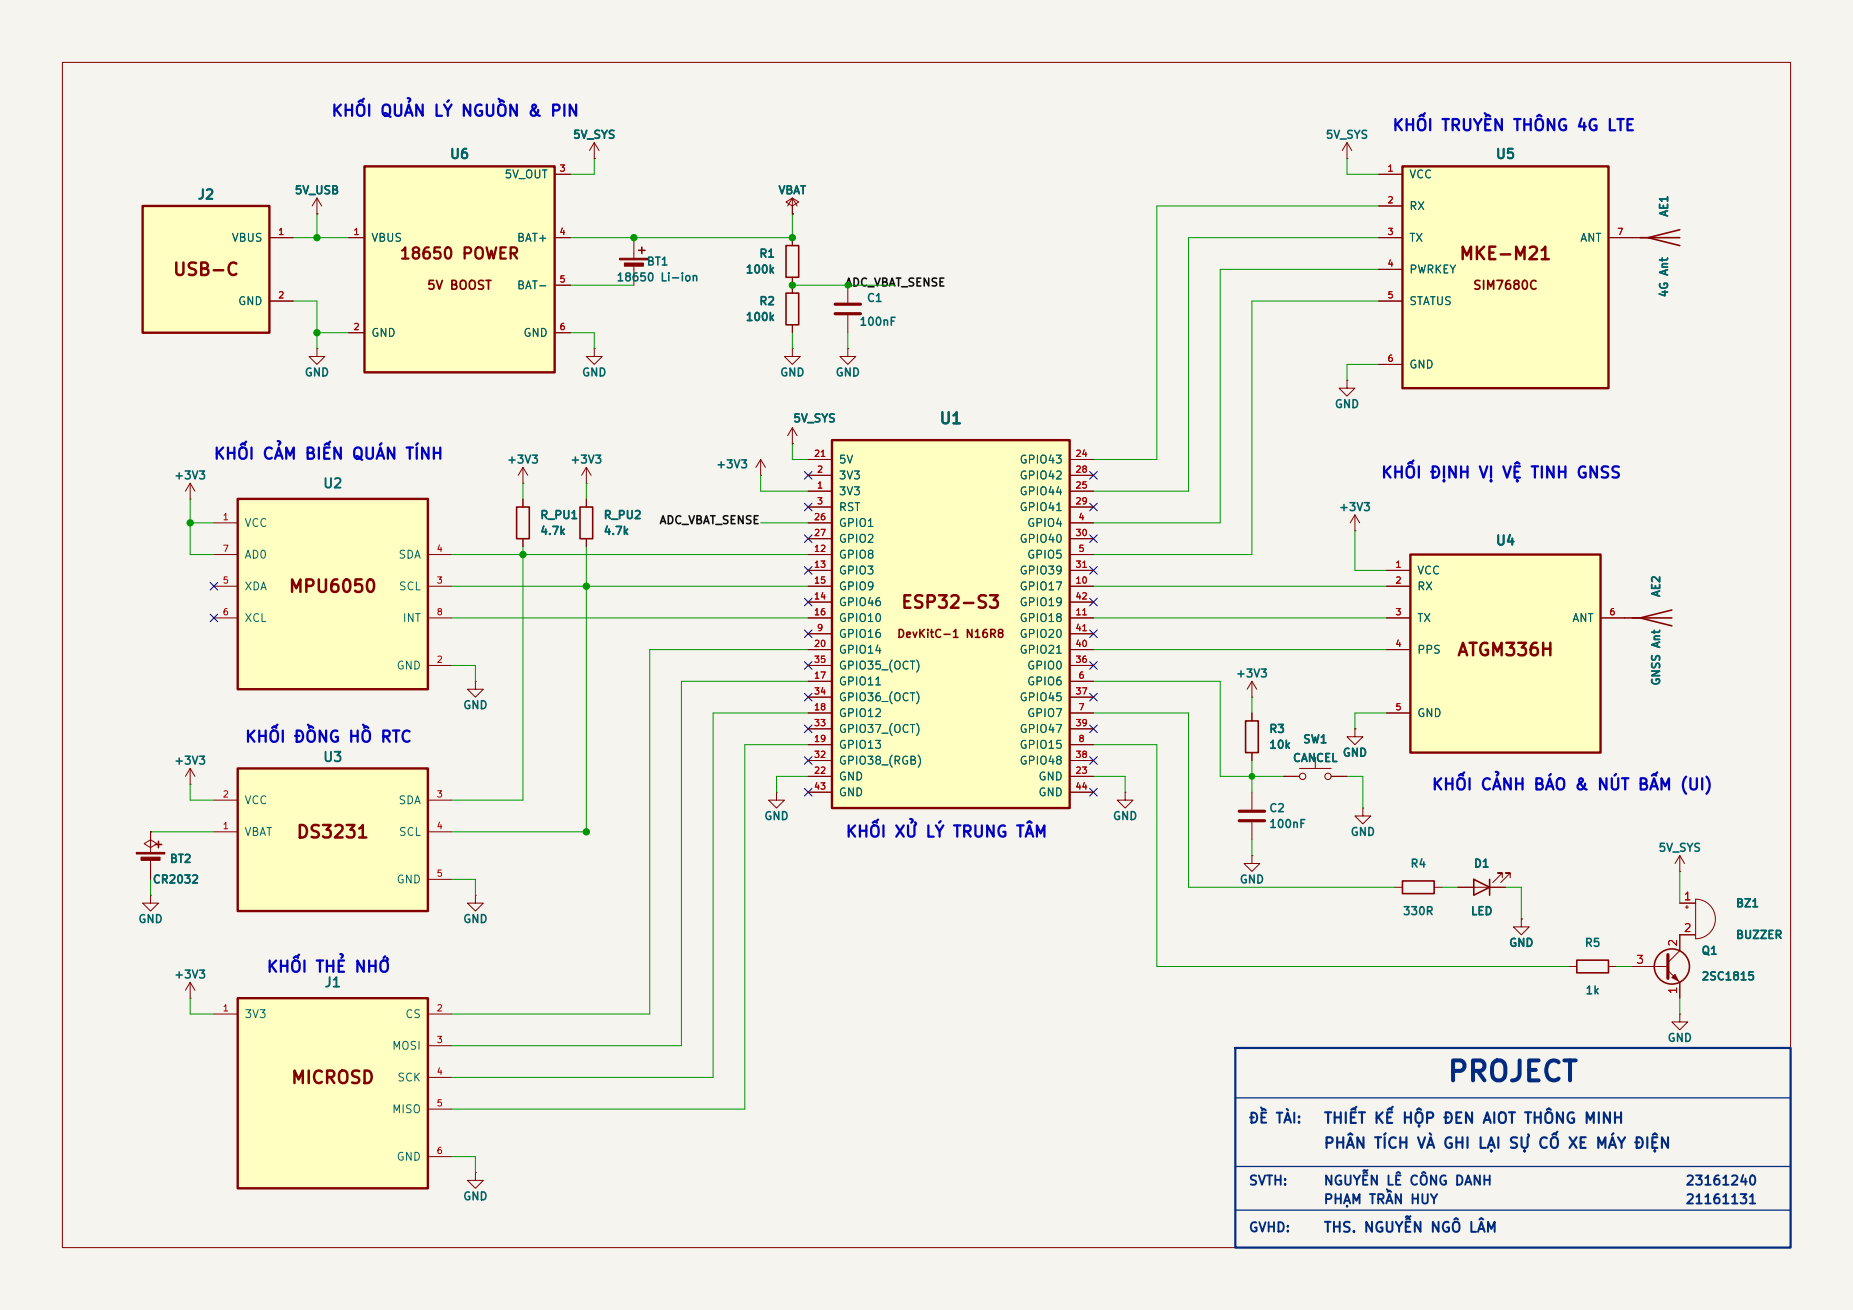
[picture p156: page 1]

KHỐI QUẢN LÝ NGUỒN & PIN

KHỐI TRUYỀN THÔNG 4G LTE
23161240 AE1 4G Ant

KHỐI ĐỒNG HỒ RTC

KHỐI CẢNH BÁO & NÚT BẤM (UI)

KHỐI XỬ LÝ TRUNG TÂM

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

PHẠM TRẦN HUY
THS. NGUYỄN NGÔ LÂM
