danhcln/AIOT-BLACK-BOX/Mẫu của thầy/So do khoi he thong.pdf

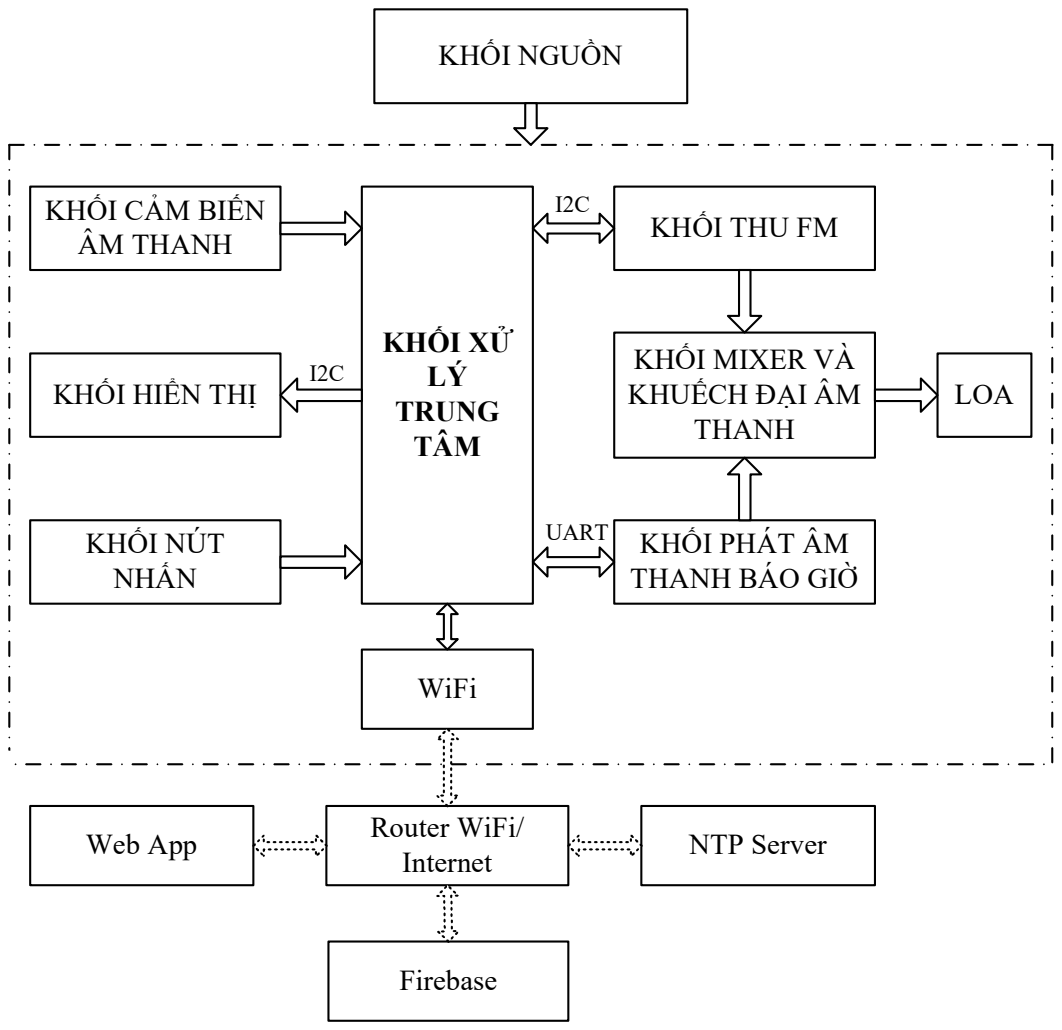
[picture p157: page 1]
KHỐI NGUỒN; KHỐI XỬ LÝ TRUNG TÂM; KHỐI NÚT NHẤN; LOA; WiFi; Router WiFi/; Internet Web App; NTP Server; Firebase

KHỐI CẢM BIẾN
ÂM THANH

KHỐI THU FM

KHỐI MIXER VÀ
KHUẾCH ĐẠI ÂM
THANH

KHỐI HIỂN THỊ

UART
KHỐI PHÁT ÂM
THANH BÁO GIỜ
