danhcln/AIOT-BLACK-BOX/THIET_KE_KHOI_NGUON/02_CHARGER_BATTERY.pdf

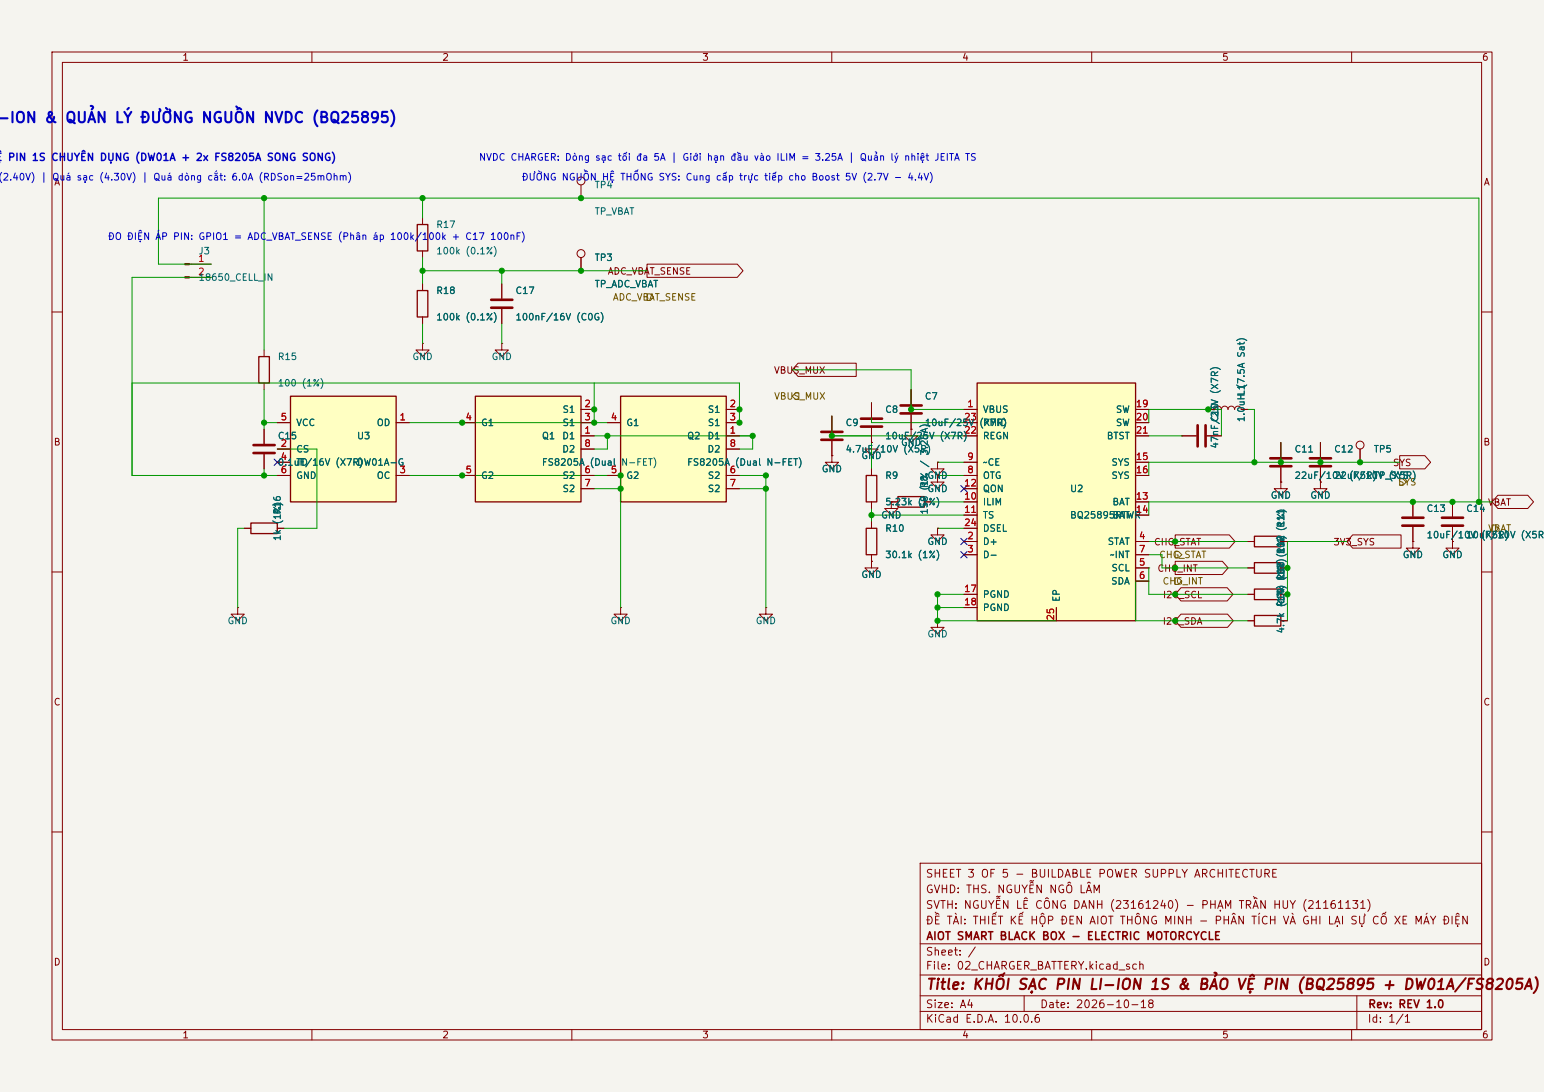
[picture p158: page 1]

MẠCH BẢO VỆ PIN 1S CHUYÊN DỤNG (DW01A + 2x FS8205A SONG SONG)
BẢO VỆ: Quá xả (2.40V) | Quá sạc (4.30V) | Quá dòng cắt: 6.0A (RDSon=25mOhm) ĐO ĐIỆN ÁP PIN: GPIO1 = ADC_VBAT_SENSE (Phân áp 100k/100k + C17 100nF)

ĐƯỜNG NGUỒN HỆ THỐNG SYS: Cung cấp trực tiếp cho Boost 5V (2.7V - 4.4V) NVDC CHARGER: Dòng sạc tối đa 5A | Giới hạn đầu vào ILIM = 3.25A | Quản lý nhiệt JEITA TS Q1

SHEET 3 OF 5 - BUILDABLE POWER SUPPLY ARCHITECTURE
GVHD: THS. NGUYỄN NGÔ LÂM
SVTH: NGUYỄN LÊ CÔNG DANH (23161240) - PHẠM TRẦN HUY (21161131)
ĐỀ TÀI: THIẾT KẾ HỘP ĐEN AIOT THÔNG MINH - PHÂN TÍCH VÀ GHI LẠI SỰ CỐ XE MÁY ĐIỆN
AIOT SMART BLACK BOX - ELECTRIC MOTORCYCLE
Sheet: /
File: 02_CHARGER_BATTERY.kicad_sch
Title: KHỐI SẠC PIN LI-ION 1S & BẢO VỆ PIN (BQ25895 + DW01A/FS8205A)

Size: A4 | Rev: REV 1.0
KiCad E.D.A. 10.0.6 | Id: 1/1
