danhcln/AIOT-BLACK-BOX/PCB_AIOT_BLACKBOX/AIOT_BLACKBOX_MAINBOARD_REV1/GATE_1_FOOTPRINT/ESP32_S3_FOOTPRINT_1TO1_CHECK.pdf

## BẢN IN THỬ FOOTPRINT ĐÃ CHỐT TỶ LỆ 1:1 (ACTUAL SIZE 100% — LOCKED HARDWARE)

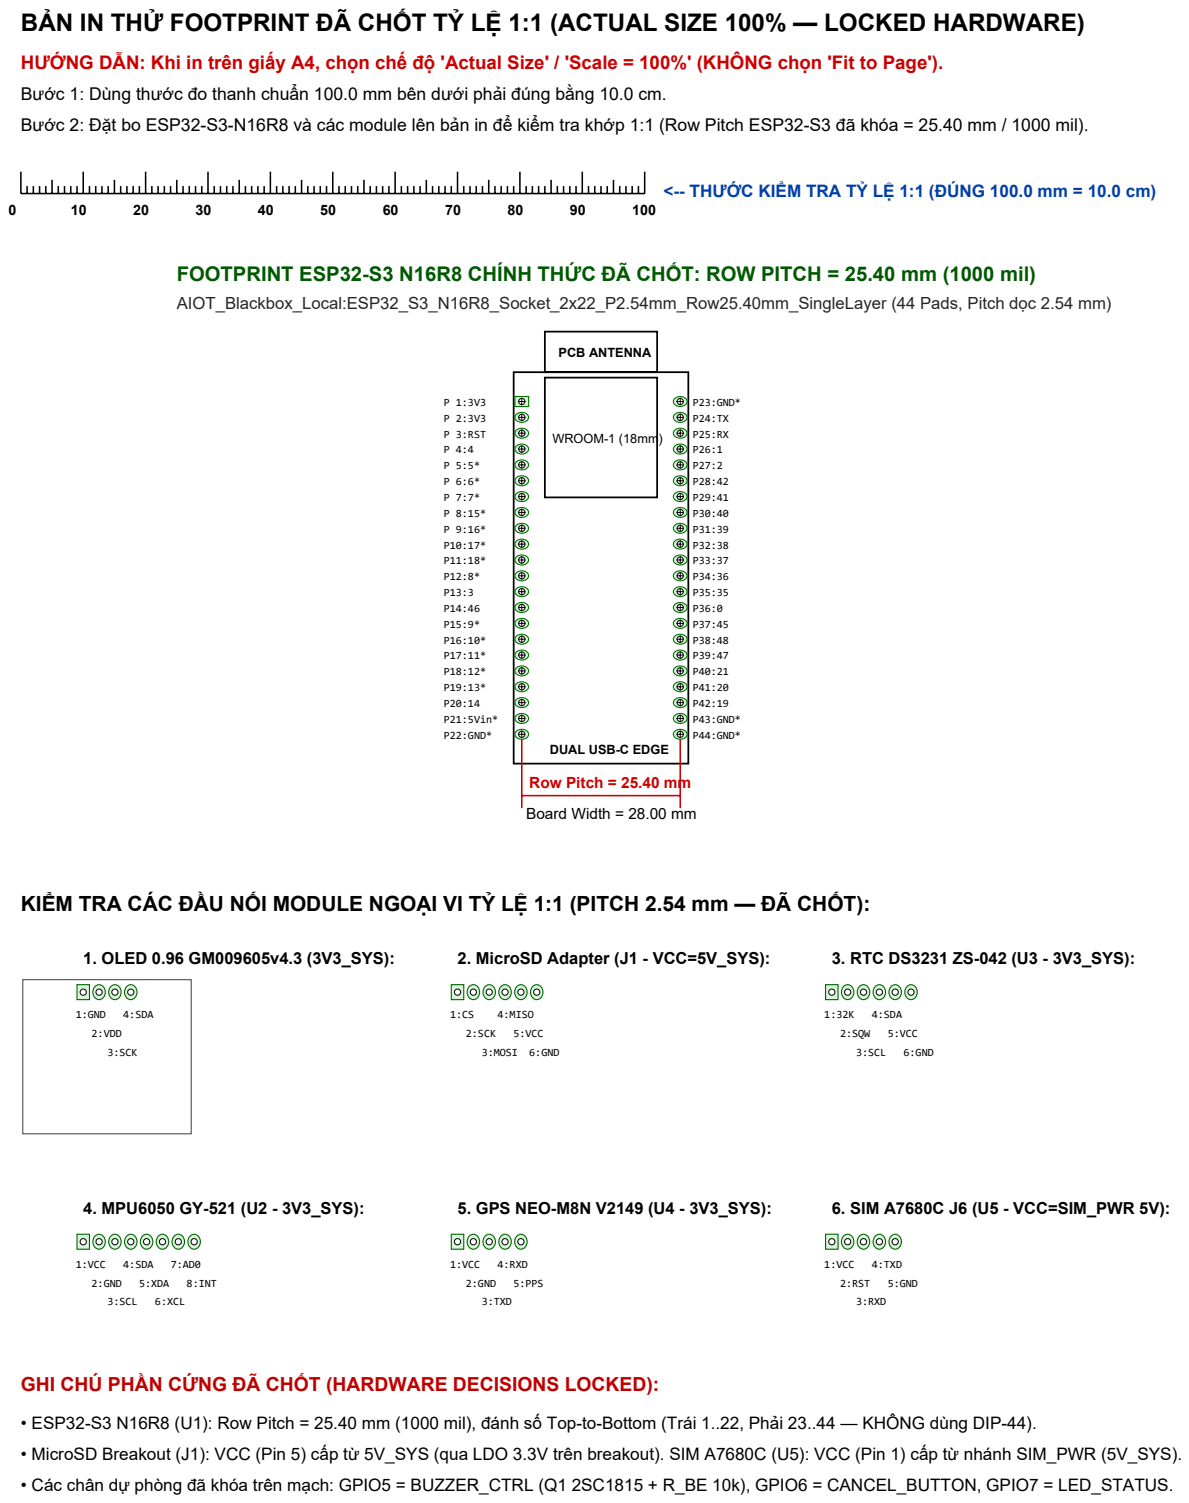
[picture p159: page 1]
PCB ANTENNA; WROOM-1 (18mm); P 1:3V3 P 2:3V3 P 3:RST P 4:4 P 5:5* P 6:6* P 7:7* P 8:15* P 9:16* P10:17* P11:18* P12:8* P13:3 P14:46 P15:9* P16:10* P17:11* P18:12* P19:13* P20:14 P21:5Vin* P22:GND*; P23:GND* P24:TX P25:RX P26:1 P27:2 P28:42 P29:41 P30:40 P31:39 P32:38 P33:37 P34:36 P35:35 P36:0 P37:45 P38:48 P39:47 P40:21 P41:20 P42:19 P43:GND* P44:GND*; 1. OLED 0.96 GM009605v4.3 (3V3_SYS):; 1:GND; 2:VDD; 3:SCK; 4:SDA; 2:SCK; 3:MOSI; 4:MISO; 5:VCC; 6:GND; 3. RTC DS3231 ZS-042 (U3 3V3_SYS):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

HƯỚNG DẪN: Khi in trên giấy A4, chọn chế độ 'Actual Size' / 'Scale = 100%' (KHÔNG chọn 'Fit to Page').
Bước 1: Dùng thước đo thanh chuẩn 100.0 mm bên dưới phải đúng bằng 10.0 cm.
Bước 2: Đặt bo ESP32-S3-N16R8 và các module lên bản in để kiểm tra khớp 1:1 (Row Pitch ESP32-S3 đã khóa = 25.40 mm / 1000 mil).

< THƯỚC KIỂM TRA TỶ LỆ 1:1 (ĐÚNG 100.0 mm = 10.0 cm)

FOOTPRINT ESP32-S3 N16R8 CHÍNH THỨC ĐÃ CHỐT: ROW PITCH = 25.40 mm (1000 mil)
AIOT_Blackbox_Local:ESP32_S3_N16R8_Socket_2x22_P2.54mm_Row25.40mm_SingleLayer (44 Pads, Pitch dọc 2.54 mm)

DUAL USB-C EDGE
Row Pitch = 25.40 mm
Board Width = 28.00 mm

KIỂM TRA CÁC ĐẦU NỐI MODULE NGOẠI VI TỶ LỆ 1:1 (PITCH 2.54 mm — ĐÃ CHỐT):

2. MicroSD Adapter (J1 VCC=5V_SYS):

GHI CHÚ PHẦN CỨNG ĐÃ CHỐT (HARDWARE DECISIONS LOCKED):

• ESP32-S3 N16R8 (U1): Row Pitch = 25.40 mm (1000 mil), đánh số Topto-Bottom (Trái 1..22, Phải 23..44 — KHÔNG dùng DIP-44).
• MicroSD Breakout (J1): VCC (Pin 5) cấp từ 5V_SYS (qua LDO 3.3V trên breakout). SIM A7680C (U5): VCC (Pin 1) cấp từ nhánh SIM_PWR (5V_SYS).
• Các chân dự phòng đã khóa trên mạch: GPIO5 = BUZZER_CTRL (Q1 2SC1815 + R_BE 10k), GPIO6 = CANCEL_BUTTON, GPIO7 = LED_STATUS.
