danhcln/AIOT-BLACK-BOX/PCB_AIOT_BLACKBOX/AIOT_BLACKBOX_MAINBOARD_REV1/GATE_2_PLACEMENT/PCB_PLACEMENT_TOP.pdf

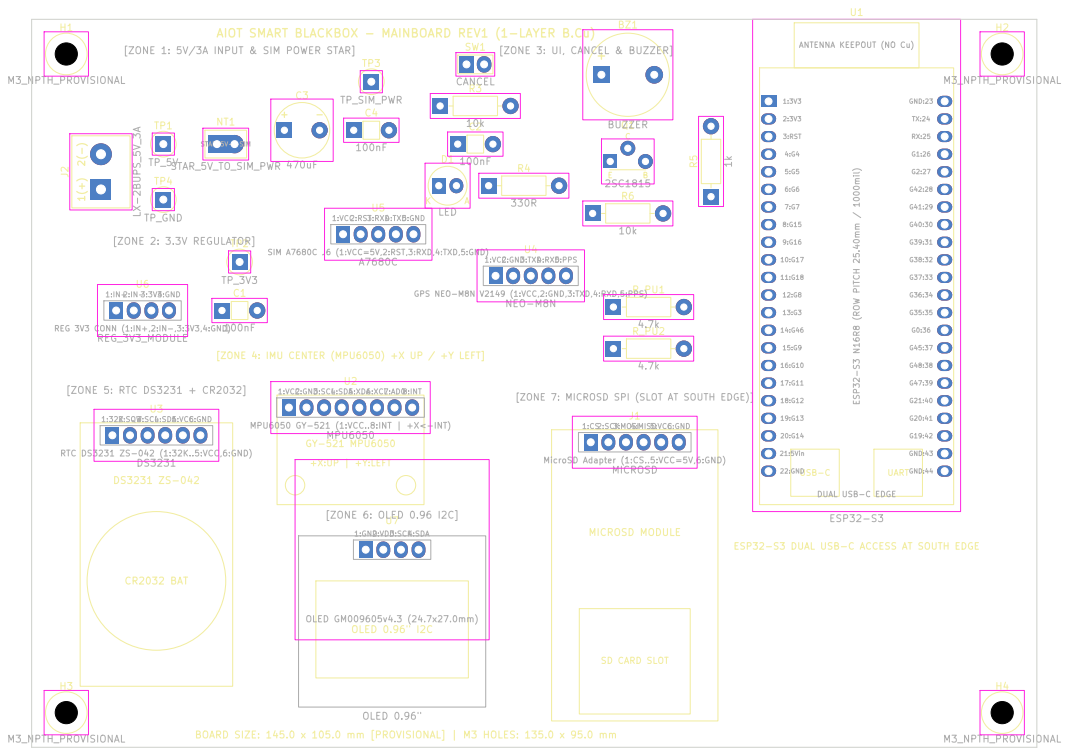
[picture p160: page 1]

AIOT SMART BLACKBOX - MAINBOARD REV1 (1-LAYER B.Cu)

[ZONE 1: 5V/3A INPUT & SIM POWER STAR]

[ZONE 3: UI, CANCEL & BUZZER] TP_SIM_PWR

TX:24 RX:25 G1:26 G2:27 G42:28 G41:29 G40:30 G39:31 G38:32 G37:33 G36:34 G35:35 G0:36 G45:37 G48:38 G47:39 G21:40 G20:41 G19:42 GND:43 GND:44 1k

1:CS2:SCK3:MOSI MicroSD Adapter (1:CS..5:VCC=5V,6:GND) 4:MISO5:VCC6:GND 330R MPU6050

REG 3V3 CONN (1:IN+,2:IN-,3:3V3,4:GND) 3:3V34:GND DS3231

[ZONE 4: IMU CENTER (MPU6050) +X UP / +Y LEFT] GY-521 MPU6050

[ZONE 7: MICROSD SPI (SLOT AT SOUTH EDGE)] [ZONE 5: RTC DS3231 + CR2032]

BOARD SIZE: 145.0 x 105.0 mm [PROVISIONAL] | M3 HOLES: 135.0 x 95.0 mm

Power: J2 5V/3A -> NT1 Star Point -> 5V_SYS & SIM_PWR (470uF+100nF)
MCU: ESP32-S3-DevKitC-1 N16R8 | IMU: MPU6050 at Board Center
Primary Copper Layer: B.Cu ONLY (0 Vias, 0 F.Cu Tracks)
DO AN 2 - SINGLE-LAYER B.Cu CARRIER BOARD (145x105mm PROVISIONAL)
Sheet:
File: AIOT_BLACKBOX_MAINBOARD_REV1.kicad_pcb
Title: AIOT SMART BLACKBOX - 1-LAYER MAINBOARD PCB (GATE 2 PLACEMENT)

Size: A4 | Rev: REV1.0-GATE2
KiCad E.D.A. 10.0.6 | Id: 1/1
