danhcln/AIOT-BLACK-BOX/Mẫu của thầy/Project sample schematic.PDF

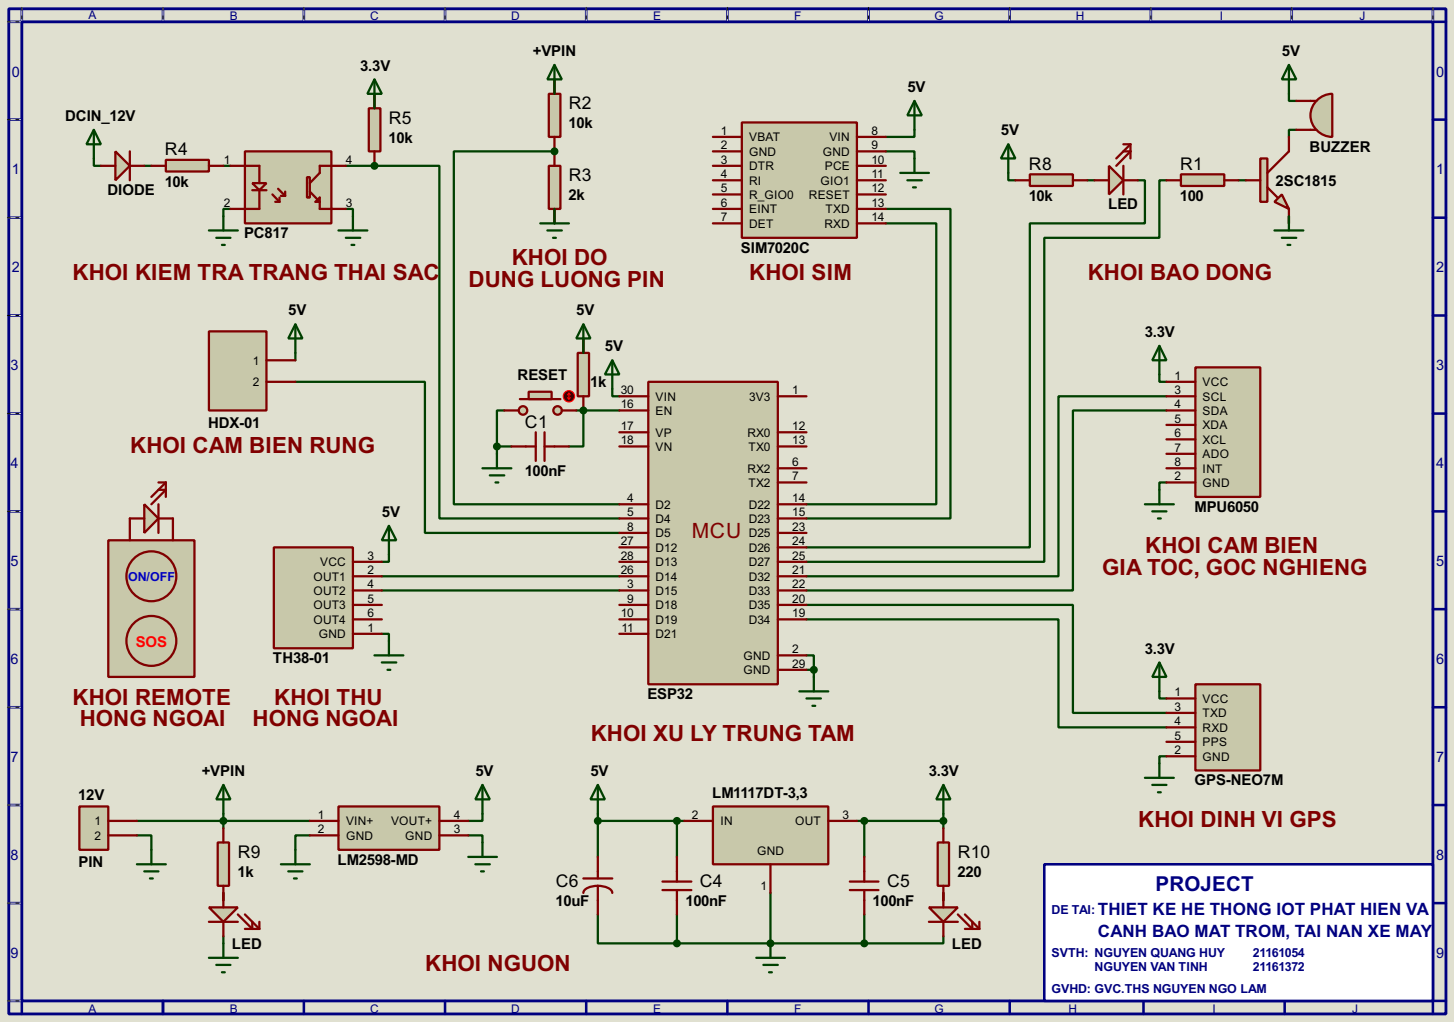
[picture p161: page 1]

KHOI KIEM TRA TRANG THAI SAC

KHOI CAM BIEN RUNG

KHOI XU LY TRUNG TAM

THIET KE HE THONG IOT PHAT HIEN VA
CANH BAO MAT TROM, TAI NAN XE MAY

DE TAI:NGUYEN QUANG HUY

NGUYEN VAN TINH
GVC.THS NGUYEN NGO LAM
