danhcln/AIOT-BLACK-BOX/Schematic_Thay/AIOT_BLACKBOX_PRESENTATION/AIOT_BLACKBOX_PRESENTATION_A4_REV8_FINAL.pdf

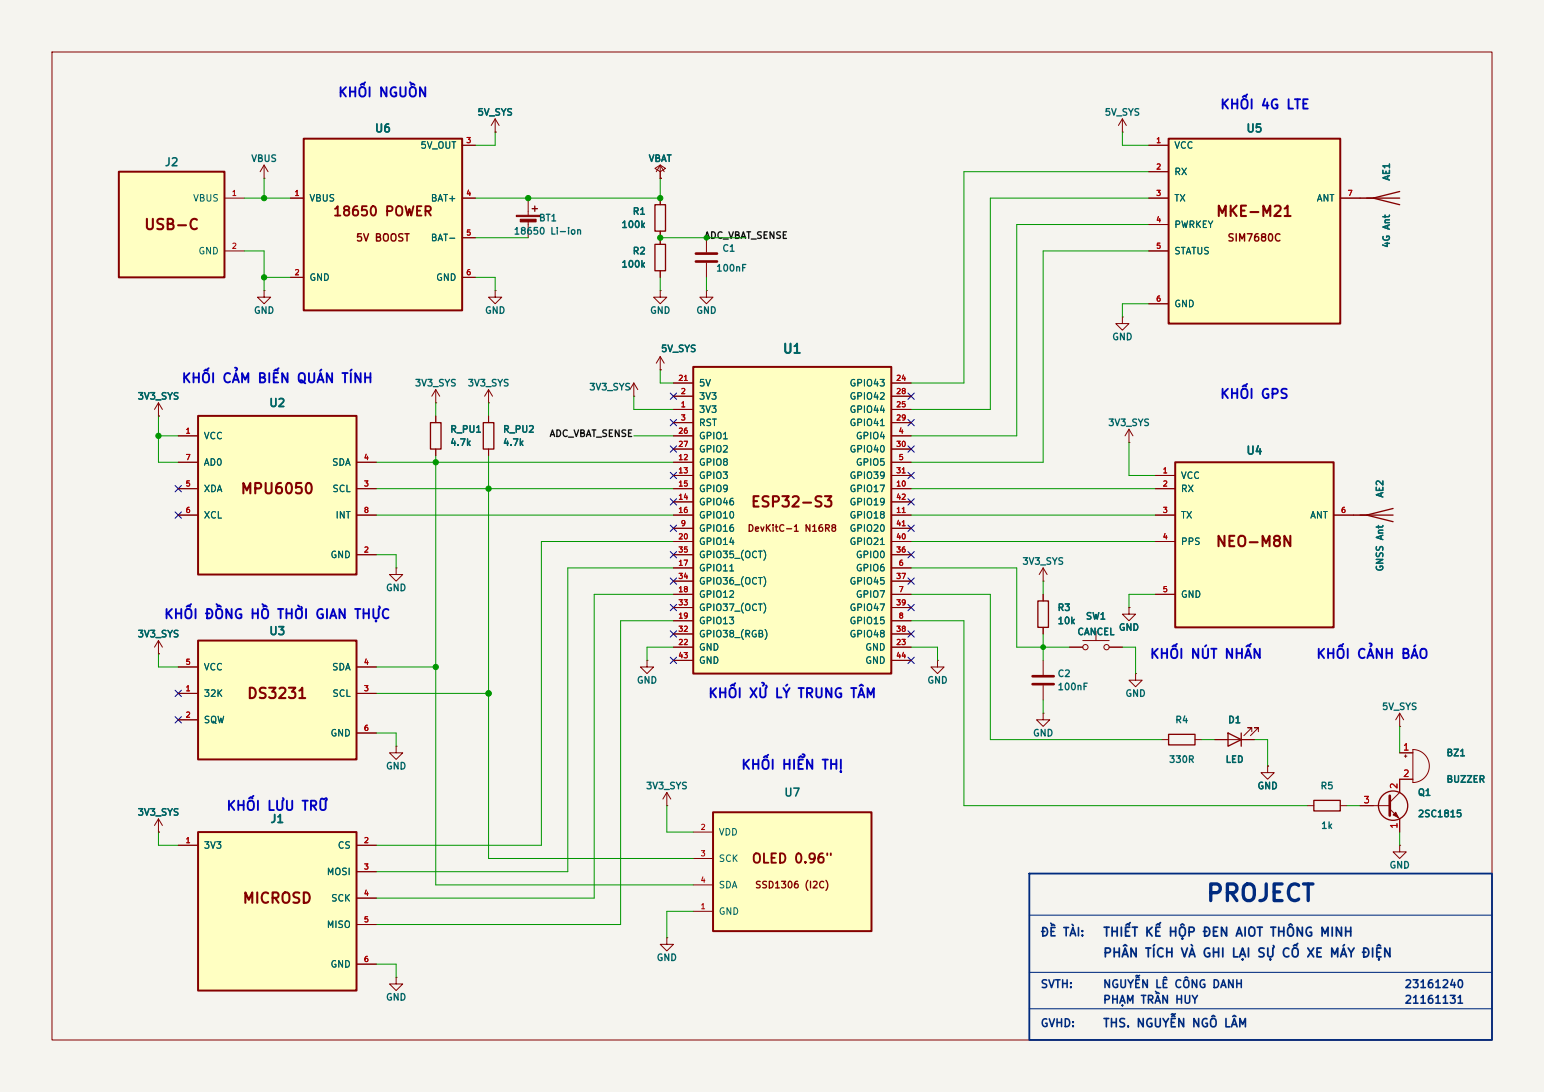
[picture p162: page 1]

KHỐI CẢM BIẾN QUÁN TÍNH

KHỐI ĐỒNG HỒ THỜI GIAN THỰC

KHỐI XỬ LÝ TRUNG TÂM

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

PHẠM TRẦN HUY
THS. NGUYỄN NGÔ LÂM
