danhcln/AIOT-BLACK-BOX/(list of files, drawings)

Other design files:
Mẫu của thầy/Project sample schematic.pdsprj
