danhcln/AIOT-BLACK-BOX/PCB_AIOT_BLACKBOX/AIOT_BLACKBOX_MAINBOARD_REV1/AIOT_BLACKBOX_MAINBOARD_REV1.kicad_pcb

## KiCad design PCB_AIOT_BLACKBOX/AIOT_BLACKBOX_MAINBOARD_REV1/AIOT_BLACKBOX_MAINBOARD_REV1.kicad_pcb (2026-11-11)

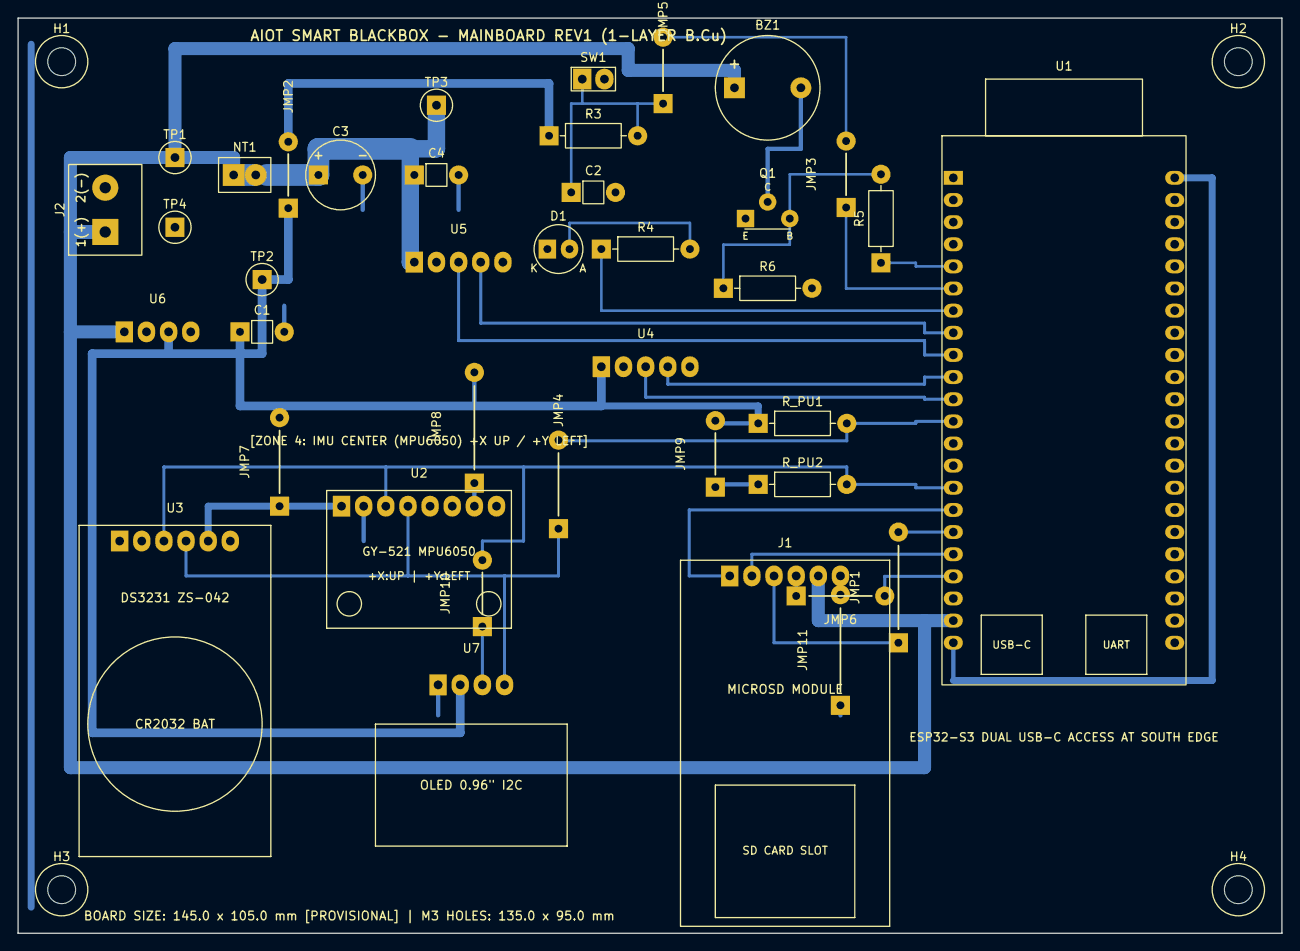
[picture p163: board AIOT_BLACKBOX_MAINBOARD_REV1.kicad_pcb from above]

Board: 2 copper layers, 145.0 x 105.0 mm, 43 parts (0 on the bottom side), 20 nets.

Parts:
BZ1: BUZZER; Buzzer_D12.0mm_P7.62mm_SingleLayer
C1, C2, C4: 100nF; C_Disc_D5.0mm_P5.08mm_SingleLayer
C3: 470uF; CP_Radial_D8.0mm_P5.08mm_SingleLayer
D1: LED; LED_D5.0mm_P2.54mm_SingleLayer
H1, H2, H3, H4: M3_NPTH_PROVISIONAL; MountingHole_3.2mm_M3_NPTH
J1: MICROSD; Module_MicroSD_Adapter_1x06_P2.54mm_SingleLayer
J2: LX-2BUPS_5V_3A; TermBlock_1x02_P5.08mm_SingleLayer
JMP1, JMP8, JMP11: Wire_Jumper_12.70mm; WireJumper_P12.70mm_SingleLayer
JMP2, JMP3, JMP5, JMP9, JMP10: Wire_Jumper_7.62mm; WireJumper_P7.62mm_SingleLayer
JMP4, JMP6, JMP7: Wire_Jumper_10.16mm; WireJumper_P10.16mm_SingleLayer
NT1: STAR_5V_TO_SIM_PWR; NetTie_2_StarPoint_BCu_Width2.5mm
Q1: 2SC1815; TO-92_2SC1815_ECB_Staggered_SingleLayer
R3, R6: 10k; R_Axial_DIN0207_P10.16mm_SingleLayer
R4: 330R; R_Axial_DIN0207_P10.16mm_SingleLayer
R5: 1k; R_Axial_DIN0207_P10.16mm_SingleLayer
R_PU1, R_PU2: 4.7k; R_Axial_DIN0207_P10.16mm_SingleLayer
SW1: CANCEL; PinHeader_1x02_P2.54mm_SingleLayer
TP1: TP_5V; TestPoint_THTPad_D2.2mm_Drill1.0mm_SingleLayer
TP2: TP_3V3; TestPoint_THTPad_D2.2mm_Drill1.0mm_SingleLayer
TP3: TP_SIM_PWR; TestPoint_THTPad_D2.2mm_Drill1.0mm_SingleLayer
TP4: TP_GND; TestPoint_THTPad_D2.2mm_Drill1.0mm_SingleLayer
U1: ESP32-S3; ESP32_S3_N16R8_Socket_2x22_P2.54mm_Row25.40mm_SingleLayer
U2: MPU6050; Module_GY-521_MPU6050_1x08_P2.54mm_SingleLayer
U3: DS3231; Module_DS3231_ZS042_1x06_P2.54mm_SingleLayer
U4: NEO-M8N; Conn_GPS_NEO-M8N_V2149_1x05_P2.54mm_SingleLayer
U5: A7680C; Conn_SIM_Breakout_J6_1x05_P2.54mm_SingleLayer
U6: REG_3V3_MODULE; Conn_Regulator_3V3_1x04_P2.54mm_SingleLayer
U7: OLED 0.96"; OLED_0.96_GM009605v4.3_1x04_P2.54mm_SingleLayer

Connections:
3V3_SYS: C1.1, JMP2.1, JMP2.2, JMP7.1, JMP7.2, JMP8.1, JMP8.2, JMP9.1, JMP9.2, R3.1, R_PU1.1, R_PU2.1, TP2.1, U2.1, U2.7, U3.5, U4.1, U6.3, U7.2
5V_SYS: BZ1.1, J1.5, J2.1, NT1.1, TP1.1, U1.21, U6.1
/BUZZER_CTRL_GPIO5: R5.1, U1.5
/GPS_RX_GPIO18: U1.11, U4.3
/GPS_TX_GPIO17: U1.10, U4.4
/I2C_SCL_GPIO9: JMP10.1, JMP10.2, R_PU2.2, U1.15, U2.3, U3.3, U7.3
/I2C_SDA_GPIO8: JMP4.1, JMP4.2, R_PU1.2, U1.12, U2.4, U3.4, U7.4
/LED_STATUS_GPIO7: R4.1, U1.7
/SD_CS_GPIO10: J1.1, U1.16
/SIM_RX_GPIO15: U1.8, U5.4
/SIM_TX_GPIO16: U1.9, U5.3
GND: C1.2, C2.2, C3.2, C4.2, D1.1, J1.6, J2.2, JMP11.1, JMP11.2, Q1.1, R6.2, SW1.2, TP4.1, U1.22, U1.23, U2.2, U3.6, U4.2, U5.5, U6.2, U6.4, U7.1
unnamed: BZ1.2, Q1.2
unnamed: D1.2, R4.2
unnamed: J1.4, JMP6.1, JMP6.2, U1.19
unnamed: J1.3, JMP1.1, JMP1.2, U1.17
unnamed: J1.2, U1.18
unnamed: Q1.3, R5.2, R6.1
unnamed: C2.1, JMP3.1, JMP3.2, JMP5.1, JMP5.2, R3.2, SW1.1, U1.6
SIM_PWR: C3.1, C4.1, NT1.2, TP3.1, U5.1
