danhcln/AIOT-BLACK-BOX/THIET_KE_KHOI_NGUON/01_INPUT_SELECTION.kicad_sch

## KiCad design THIET_KE_KHOI_NGUON/01_INPUT_SELECTION.kicad_sch (2026-11-11)

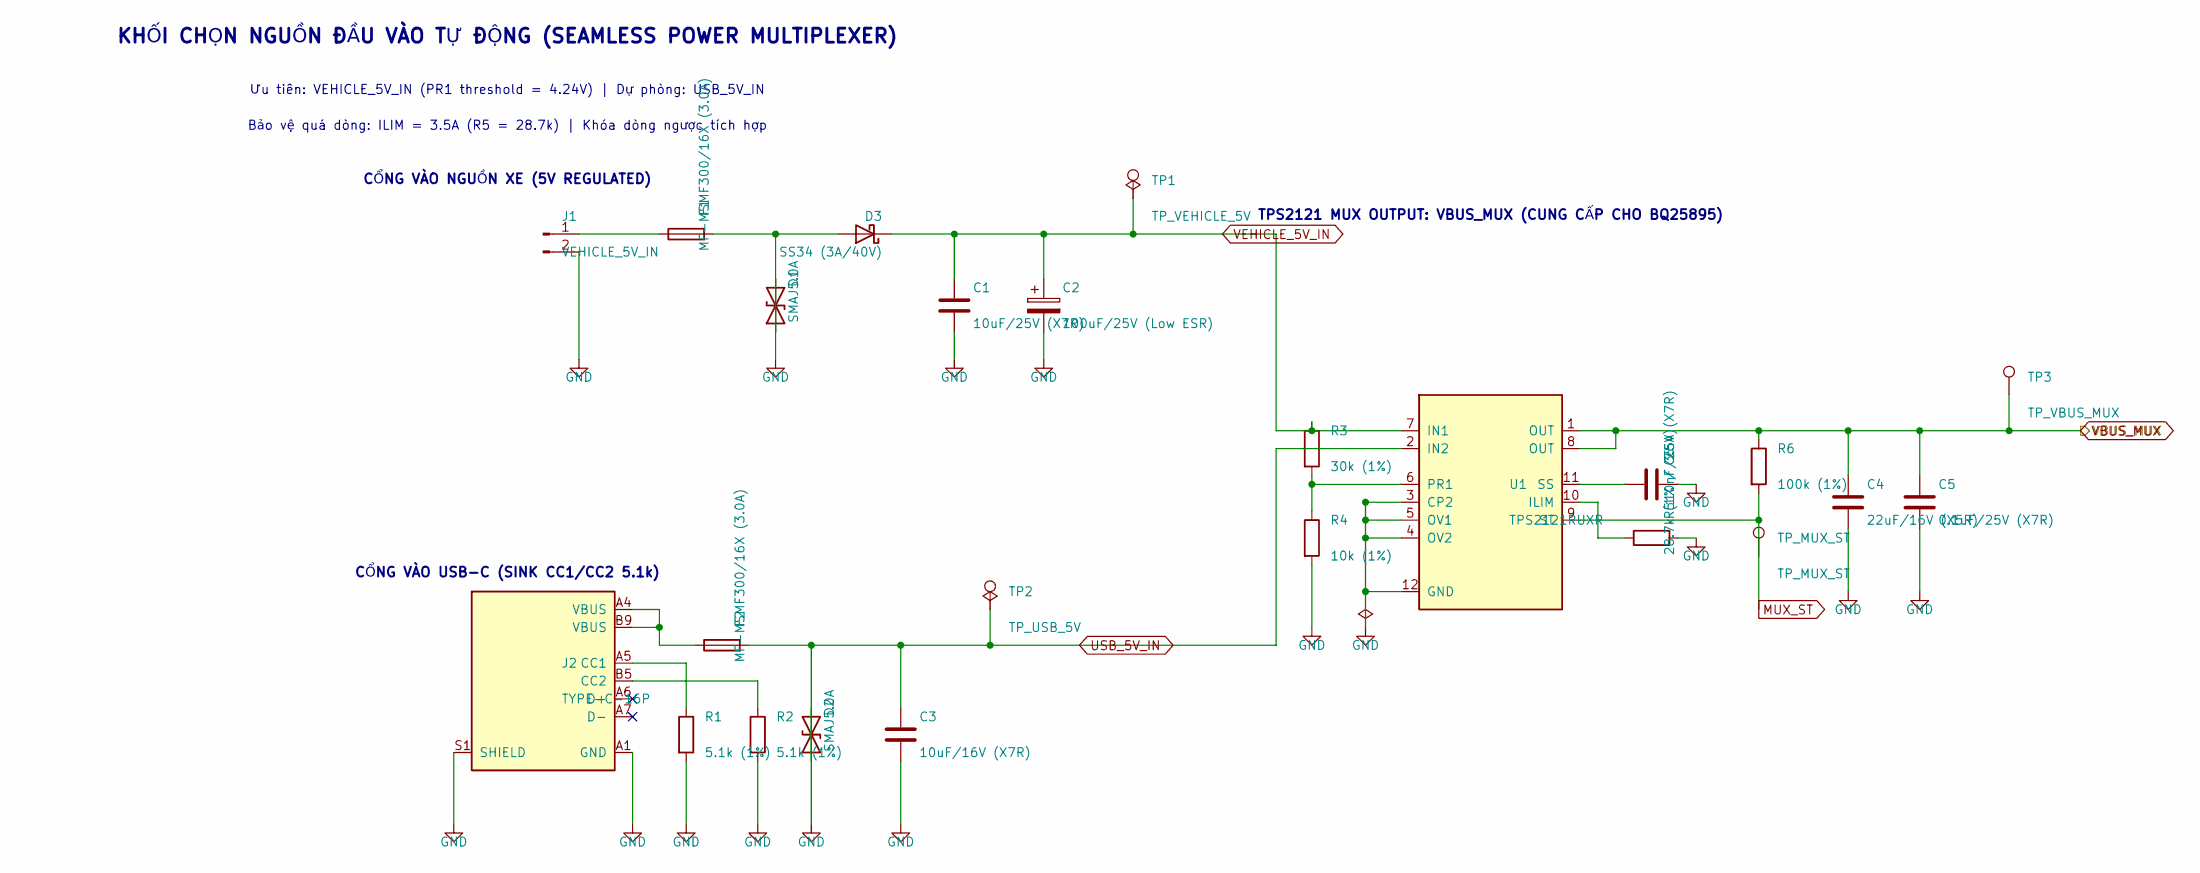
[picture p164: schematic 01_INPUT_SELECTION.kicad_sch]

Parts:
C1: 10uF/25V (X7R); C_0805_2012Metric
C2: 100uF/25V (Low ESR); CP_Elec_6.3x5.4
C3: 10uF/16V (X7R); C_0805_2012Metric
C4: 22uF/16V (X5R); C_0805_2012Metric
C5: 0.1uF/25V (X7R); C_0603_1608Metric
C6: 10nF/25V (X7R); C_0603_1608Metric
D1, D2: SMAJ5.0A; D_SMA
D3: SS34 (3A/40V); D_SMA
F1, F2: MF-MSMF300/16X (3.0A); Fuse_1812_4532Metric
J1: VEHICLE_5V_IN; JST_XH_B2B-XH-A_1x02_P2.50mm_Vertical
J2: TYPE-C-16P; USB_C_Receptacle_HRO_TYPE-C-31-M-12
R1, R2: 5.1k (1%); R_0603_1608Metric
R3: 30k (1%); R_0603_1608Metric
R4: 10k (1%); R_0603_1608Metric
R5: 28.7k (1% / 3.5A); R_0603_1608Metric
R6: 100k (1%); R_0603_1608Metric
TP1: TP_VEHICLE_5V; TestPoint_Pad_D1.5mm
TP2: TP_USB_5V; TestPoint_Pad_D1.5mm
TP3: TP_VBUS_MUX; TestPoint_Pad_D1.5mm
TP_MUX_ST: TP_MUX_ST; TestPoint_Pad_D1.5mm
U1: TPS2121RUXR; Texas_RUX0012A

Connections:
GND: C1.2, C2.2, C3.2, C4.2, C5.2, C6.2, D1.2 (A2), D2.2 (A2), J1.2, J2.A1 (GND), J2.S1 (SHIELD), R1.2, R2.2, R4.2, R5.2, U1.3 (CP2), U1.4 (OV2), U1.5 (OV1), U1.12 (GND)
MUX_ST: R6.2, TP_MUX_ST.1, U1.9 (ST)
unnamed: C6.1, U1.11 (SS)
unnamed: D1.1 (A1), D3.2 (A), F1.2
unnamed: F1.1, J1.1
unnamed: F2.1, J2.A4 (VBUS), J2.B9 (VBUS)
unnamed: J2.A5 (CC1), R1.1
unnamed: J2.B5 (CC2), R2.1
unnamed: R3.2, R4.1, U1.6 (PR1)
unnamed: R5.1, U1.10 (ILIM)
USB_5V_IN: C3.1, D2.1 (A1), F2.2, TP2.1, U1.2 (IN2)
VBUS_MUX: C4.1, C5.1, R6.1, TP3.1, U1.1 (OUT), U1.8 (OUT)
VEHICLE_5V_IN: C1.1, C2.1, D3.1 (K), R3.1, TP1.1, U1.7 (IN1)

Notes on the sheet:
KHỐI CHỌN NGUỒN ĐẦU VÀO TỰ ĐỘNG (SEAMLESS POWER MULTIPLEXER)
Ưu tiên: VEHICLE_5V_IN (PR1 threshold = 4.24V) | Dự phòng: USB_5V_IN
Bảo vệ quá dòng: ILIM = 3.5A (R5 = 28.7k) | Khóa dòng ngược tích hợp
CỔNG VÀO NGUỒN XE (5V REGULATED)
CỔNG VÀO USB-C (SINK CC1/CC2 5.1k)
TPS2121 MUX OUTPUT: VBUS_MUX (CUNG CẤP CHO BQ25895)
