danhcln/AIOT-BLACK-BOX/THIET_KE_KHOI_NGUON/02_CHARGER_BATTERY.kicad_sch

## KiCad design THIET_KE_KHOI_NGUON/02_CHARGER_BATTERY.kicad_sch (2026-11-11)

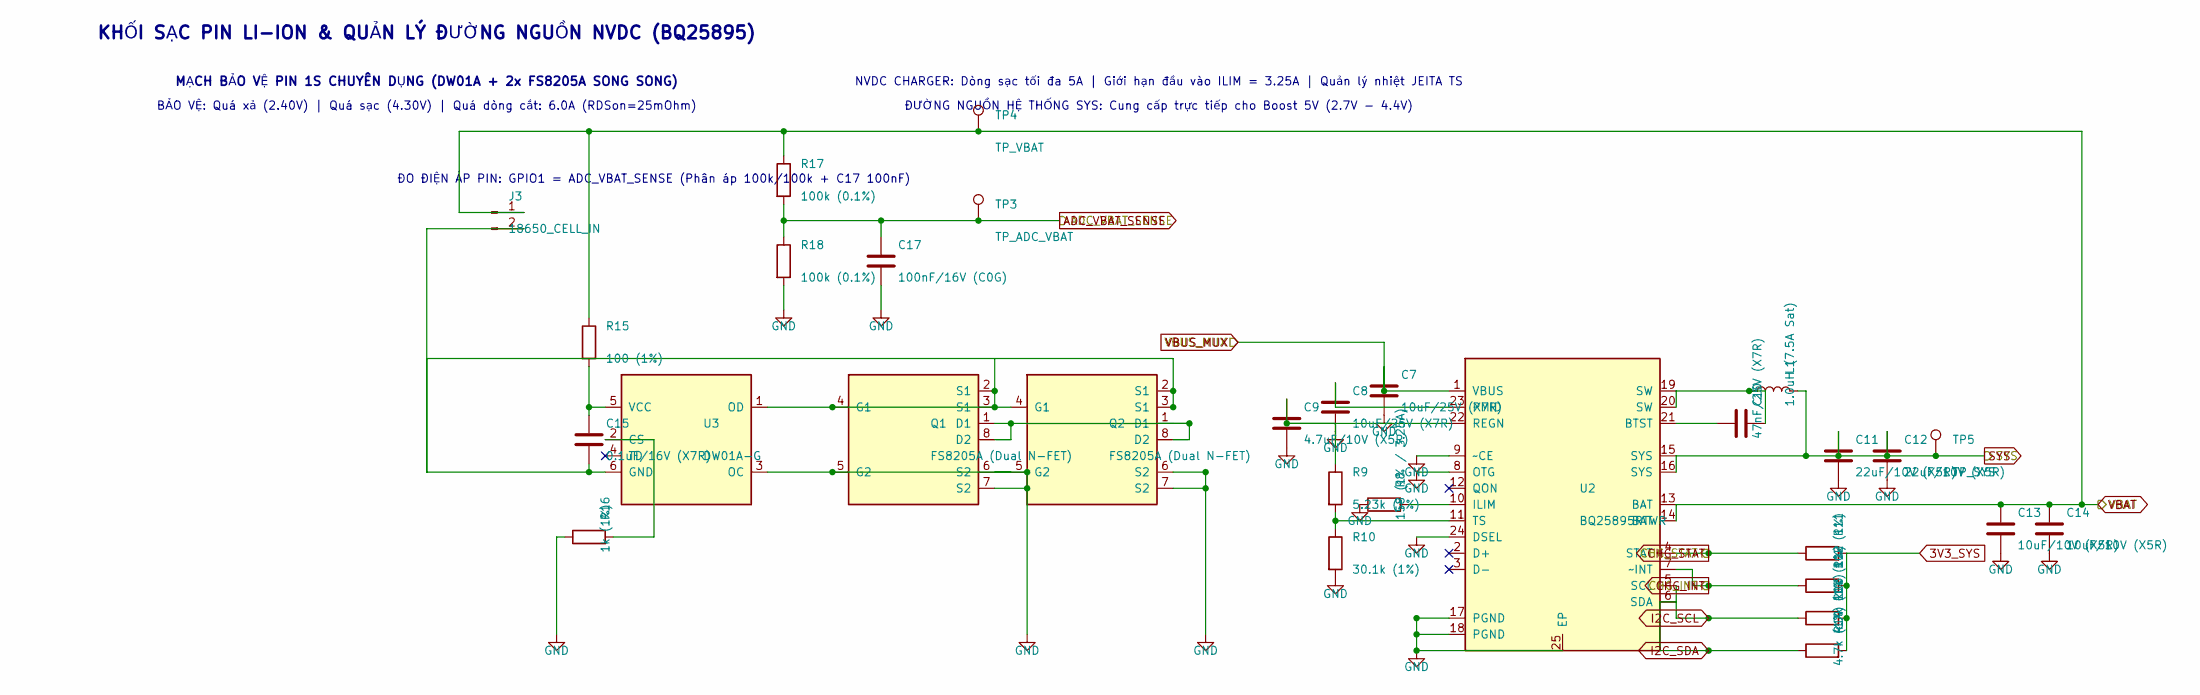
[picture p165: schematic 02_CHARGER_BATTERY.kicad_sch]

Parts:
C7, C8: 10uF/25V (X7R); C_0805_2012Metric
C9: 4.7uF/10V (X5R); C_0603_1608Metric
C10: 47nF/25V (X7R); C_0603_1608Metric
C11, C12: 22uF/10V (X5R); C_0805_2012Metric
C13, C14: 10uF/10V (X5R); C_0805_2012Metric
C15: 0.1uF/16V (X7R); C_0603_1608Metric
C17: 100nF/16V (C0G); C_0603_1608Metric
J3: 18650_CELL_IN; JST_VH_B2P-VH_1x02_P3.96mm_Vertical
L1: 1.0uH (7.5A Sat); L_Bourns_SRP6540
Q1, Q2: FS8205A (Dual N-FET); TSSOP-8_4.4x3mm_P0.65mm
R8: 158 (1% / 3.25A); R_0603_1608Metric
R9: 5.23k (1%); R_0603_1608Metric
R10: 30.1k (1%); R_0603_1608Metric
R11, R12: 10k (1%); R_0603_1608Metric
R13, R14: 4.7k (1%); R_0603_1608Metric
R15: 100 (1%); R_0603_1608Metric
R16: 1k (1%); R_0603_1608Metric
R17, R18: 100k (0.1%); R_0603_1608Metric
TP3: TP_ADC_VBAT; TestPoint_Pad_D1.5mm
TP4: TP_VBAT; TestPoint_Pad_D1.5mm
TP5: TP_SYS; TestPoint_Pad_D1.5mm
U2: BQ25895RTWR; Texas_RTW0024A
U3: DW01A-G; SOT-23-6

Connections:
3V3_SYS: R11.2, R12.2, R13.2, R14.2
ADC_VBAT_SENSE: C17.1, R17.2, R18.1, TP3.1
CHG_INT: R12.1, U2.7 (~INT)
CHG_STAT: R11.1, U2.4 (STAT)
GND: C7.2, C8.2, C9.1, C9.2, C11.2, C12.2, C13.2, C14.2, C17.2, Q1.6 (S2), Q1.7 (S2), Q2.6 (S2), Q2.7 (S2), R8.1, R9.1, R10.2, R16.1, R18.2, U2.8 (OTG), U2.9 (~CE), U2.17 (PGND), U2.18 (PGND), U2.22 (REGN), U2.24 (DSEL), U2.25 (EP)
I2C_SCL: R13.1, U2.5 (SCL)
I2C_SDA: R14.1, U2.6 (SDA)
unnamed: C8.1, U2.23 (PMID)
unnamed: C10.1, U2.21 (BTST)
unnamed: C10.2, L1.1, U2.19 (SW), U2.20 (SW)
unnamed: C15.1, R15.2, U3.5 (VCC)
unnamed: C15.2, J3.2, Q1.2 (S1), Q1.3 (S1), Q1.4 (G1), Q2.2 (S1), Q2.3 (S1), Q2.4 (G1), U3.1 (OD), U3.6 (GND)
unnamed: Q1.1 (D1), Q1.8 (D2), Q2.1 (D1), Q2.8 (D2)
unnamed: Q1.5 (G2), Q2.5 (G2), U3.3 (OC)
unnamed: R8.2, U2.10 (ILIM)
unnamed: R9.2, R10.1, U2.11 (TS)
unnamed: R16.2, U3.2 (CS)
SYS: C11.1, C12.1, L1.2, TP5.1, U2.15 (SYS), U2.16 (SYS)
VBAT: C13.1, C14.1, J3.1, R15.1, R17.1, TP4.1, U2.13 (BAT), U2.14 (BAT)
VBUS_MUX: C7.1, U2.1 (VBUS)

Notes on the sheet:
KHỐI SẠC PIN LI-ION & QUẢN LÝ ĐƯỜNG NGUỒN NVDC (BQ25895)
MẠCH BẢO VỆ PIN 1S CHUYÊN DỤNG (DW01A + 2x FS8205A SONG SONG)
BẢO VỆ: Quá xả (2.40V) | Quá sạc (4.30V) | Quá dòng cắt: 6.0A (RDSon=25mOhm)
ĐO ĐIỆN ÁP PIN: GPIO1 = ADC_VBAT_SENSE (Phân áp 100k/100k + C17 100nF)
NVDC CHARGER: Dòng sạc tối đa 5A | Giới hạn đầu vào ILIM = 3.25A | Quản lý nhiệt JEITA TS
ĐƯỜNG NGUỒN HỆ THỐNG SYS: Cung cấp trực tiếp cho Boost 5V (2.7V - 4.4V)
