danhcln/AIOT-BLACK-BOX/THIET_KE_KHOI_NGUON/03_BOOST_BUCK_RAILS.kicad_sch

## KiCad design THIET_KE_KHOI_NGUON/03_BOOST_BUCK_RAILS.kicad_sch (2026-11-11)

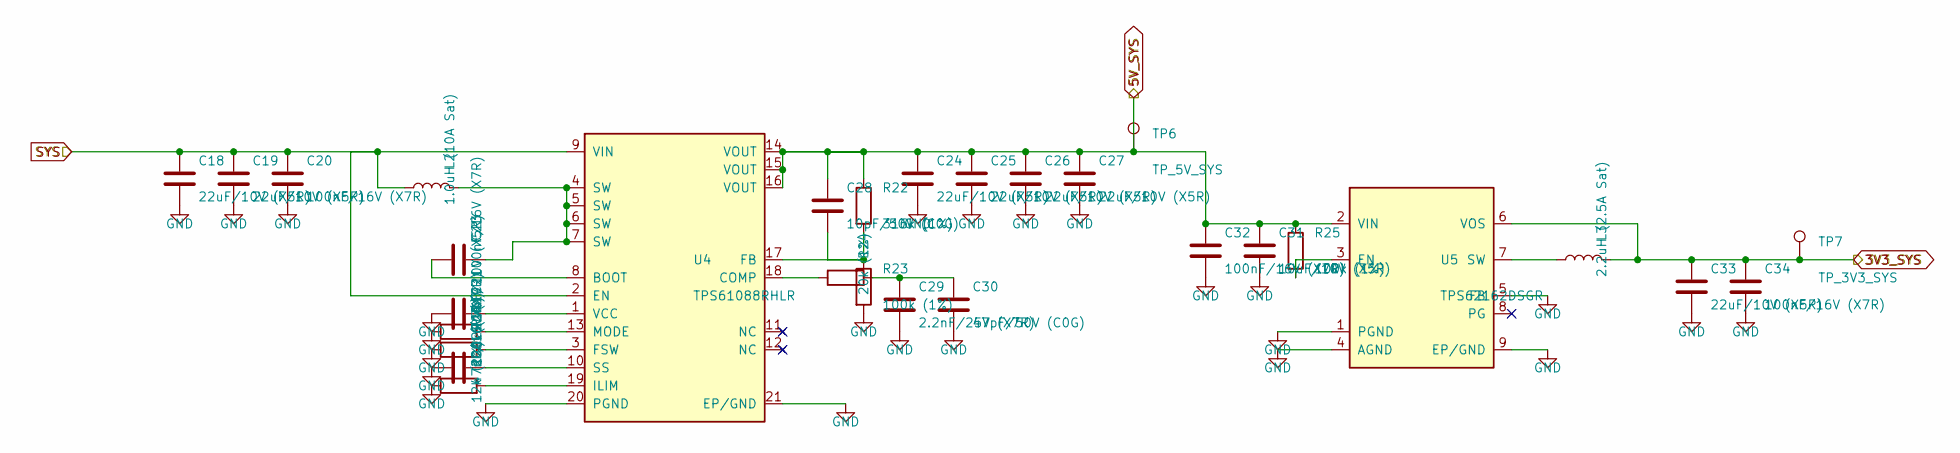
[picture p166: schematic 03_BOOST_BUCK_RAILS.kicad_sch]

Parts:
C18, C19, C24, C25, C26, C27, C33: 22uF/10V (X5R); C_0805_2012Metric
C20, C23, C32, C34: 100nF/16V (X7R); C_0603_1608Metric
C21: 4.7uF/10V (X5R); C_0603_1608Metric
C22: 47nF/16V (X7R); C_0603_1608Metric
C28: 10pF/50V (C0G); C_0603_1608Metric
C29: 2.2nF/25V (X7R); C_0603_1608Metric
C30: 47pF/50V (C0G); C_0603_1608Metric
C31: 10uF/10V (X5R); C_0805_2012Metric
L2: 1.0uH (10A Sat); L_Bourns_SRP6540
L3: 2.2uH (2.5A Sat); L_Bourns_SRP4020TA
R19: 0 (PWM); R_0603_1608Metric
R20: 200k (1%); R_0603_1608Metric
R21: 12k (1%); R_0603_1608Metric
R22: 316k (1%); R_0603_1608Metric
R23, R25: 100k (1%); R_0603_1608Metric
R24: 20k (1%); R_0603_1608Metric
TP6: TP_5V_SYS; TestPoint_Pad_D1.5mm
TP7: TP_3V3_SYS; TestPoint_Pad_D1.5mm
U4: TPS61088RHLR; Texas_RHL0020A
U5: TPS62162DSGR; WSON-8-1EP_2x2mm_P0.5mm_EP0.9x1.6mm

Connections:
3V3_SYS: C33.1, C34.1, L3.2, TP7.1, U5.6 (VOS)
5V_SYS: C24.1, C25.1, C26.1, C27.1, C28.1, C31.1, C32.1, R22.1, R25.1, TP6.1, U4.14 (VOUT), U4.15 (VOUT), U4.16 (VOUT), U5.2 (VIN)
GND: C18.2, C19.2, C20.2, C21.1, C22.1, C24.2, C25.2, C26.2, C27.2, C29.2, C30.2, C31.2, C32.2, C33.2, C34.2, R19.1, R20.1, R21.1, R23.2, U4.20 (PGND), U4.21 (EP/GND), U5.1 (PGND), U5.4 (AGND), U5.5 (FB), U5.9 (EP/GND)
unnamed: C21.2, U4.1 (VCC)
unnamed: C22.2, U4.10 (SS)
unnamed: C23.1, U4.8 (BOOT)
unnamed: C23.2, L2.2, U4.4 (SW), U4.5 (SW), U4.6 (SW), U4.7 (SW)
unnamed: C28.2, R22.2, R23.1, U4.17 (FB)
unnamed: C29.1, C30.1, R24.2
unnamed: L3.1, U5.7 (SW)
unnamed: R19.2, U4.13 (MODE)
unnamed: R20.2, U4.3 (FSW)
unnamed: R21.2, U4.19 (ILIM)
unnamed: R24.1, U4.18 (COMP)
unnamed: R25.2, U5.3 (EN)
SYS: C18.1, C19.1, C20.1, L2.1, U4.2 (EN), U4.9 (VIN)
