danhcln/AIOT-BLACK-BOX/THIET_KE_KHOI_NGUON/04_SIM_POWER_OUTPUTS.kicad_sch

## KiCad design THIET_KE_KHOI_NGUON/04_SIM_POWER_OUTPUTS.kicad_sch (2026-11-11)

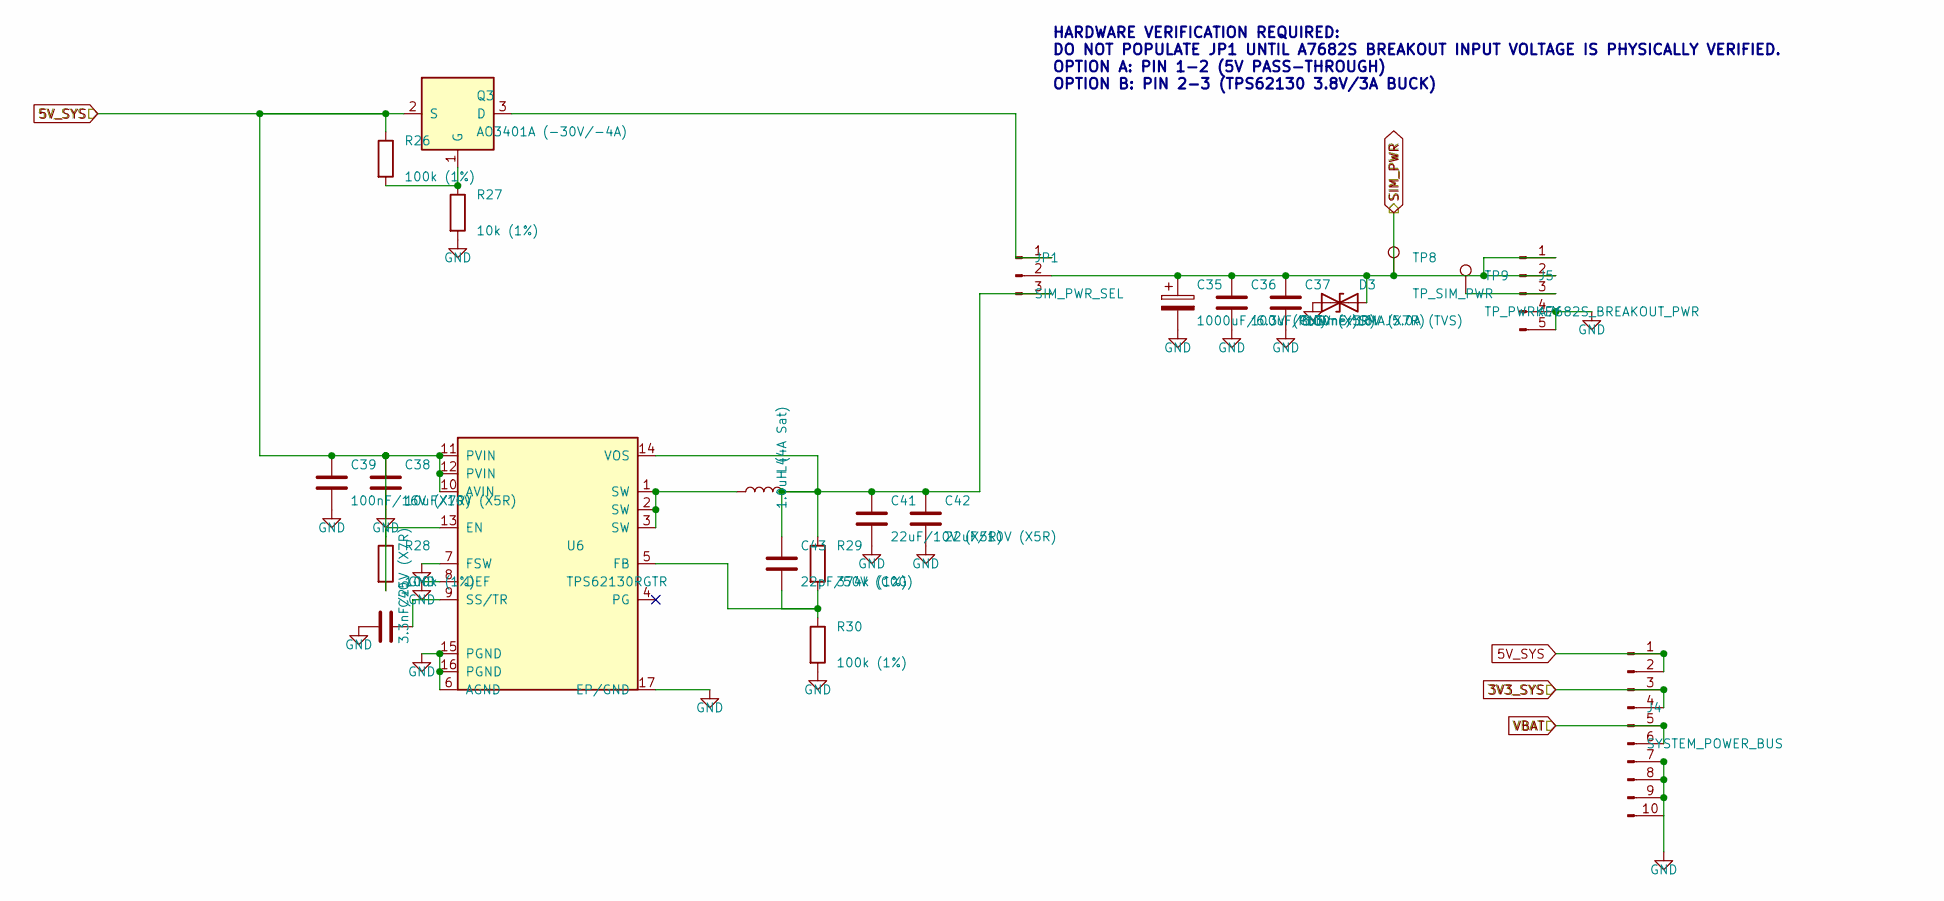
[picture p167: schematic 04_SIM_POWER_OUTPUTS.kicad_sch]

Parts:
C35: 1000uF/6.3V (Polymer); CP_Elec_8x10
C36: 100uF/6.3V (X5R); C_1206_3216Metric
C37, C39: 100nF/16V (X7R); C_0603_1608Metric
C38: 10uF/10V (X5R); C_0805_2012Metric
C40: 3.3nF/25V (X7R); C_0603_1608Metric
C41, C42: 22uF/10V (X5R); C_0805_2012Metric
C43: 22pF/50V (C0G); C_0603_1608Metric
D3: SMAJ5.0A (TVS); D_SMA
J4: SYSTEM_POWER_BUS; PinHeader_1x10_P2.54mm_Vertical
J5: A7682S_BREAKOUT_PWR; PinHeader_1x05_P2.54mm_Vertical
JP1: SIM_PWR_SEL; PinHeader_1x03_P2.54mm_Vertical
L4: 1.0uH (4A Sat); L_Bourns_SRP6540
Q3: AO3401A (-30V/-4A); SOT-23
R26, R28, R30: 100k (1%); R_0603_1608Metric
R27: 10k (1%); R_0603_1608Metric
R29: 374k (1%); R_0603_1608Metric
TP8: TP_SIM_PWR; TestPoint_Pad_D1.5mm
TP9: TP_PWRKEY; TestPoint_Pad_D1.5mm
U6: TPS62130RGTR; Texas_RGT0016A

Connections:
3V3_SYS: J4.3, J4.4
5V_SYS: C35.2, C36.2, C37.2, C38.1, C38.2, C39.1, C39.2, C40.1, C41.2, C42.2, D3.1 (A1), J4.1, J4.2, J4.7, J4.8, J4.9, J4.10, J5.4, J5.5, Q3.2 (S), R26.1, R27.2, R28.1, R30.2, U6.6 (AGND), U6.7 (FSW), U6.8 (DEF), U6.10 (AVIN), U6.11 (PVIN), U6.12 (PVIN), U6.15 (PGND), U6.16 (PGND), U6.17 (EP/GND)
unnamed: C40.2, U6.9 (SS/TR)
unnamed: C41.1, C42.1, C43.1, JP1.3, L4.2, R29.1, U6.14 (VOS)
unnamed: C43.2, R29.2, R30.1, U6.5 (FB)
unnamed: J5.3, TP9.1
unnamed: JP1.1, Q3.3 (D)
unnamed: L4.1, U6.1 (SW), U6.2 (SW), U6.3 (SW)
unnamed: Q3.1 (G), R26.2, R27.1
unnamed: R28.2, U6.13 (EN)
SIM_PWR: C35.1, C36.1, C37.1, D3.2 (A2), J5.1, J5.2, JP1.2, TP8.1
VBAT: J4.5, J4.6

Notes on the sheet:
HARDWARE VERIFICATION REQUIRED: DO NOT POPULATE JP1 UNTIL A7682S BREAKOUT INPUT VOLTAGE IS PHYSICALLY VERIFIED. OPTION A: PIN 1-2 (5V PASS-THROUGH) OPTION B: PIN 2-3 (TPS62130 3.8V/3A BUCK)
