danhcln/AIOT-BLACK-BOX/THIET_KE_KHOI_NGUON/test_asym.kicad_sch

## KiCad design THIET_KE_KHOI_NGUON/test_asym.kicad_sch (2026-11-11)

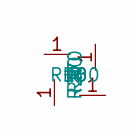
[picture p168: schematic test_asym.kicad_sch]

Parts:
R0, R90, R180, R270: R
