danhcln/AIOT-BLACK-BOX/Schematic_Thay/AIOT_BLACKBOX_PRESENTATION/AIOT_BLACKBOX_PRESENTATION.kicad_sch

## KiCad design Schematic_Thay/AIOT_BLACKBOX_PRESENTATION/AIOT_BLACKBOX_PRESENTATION.kicad_sch (2026-11-11)

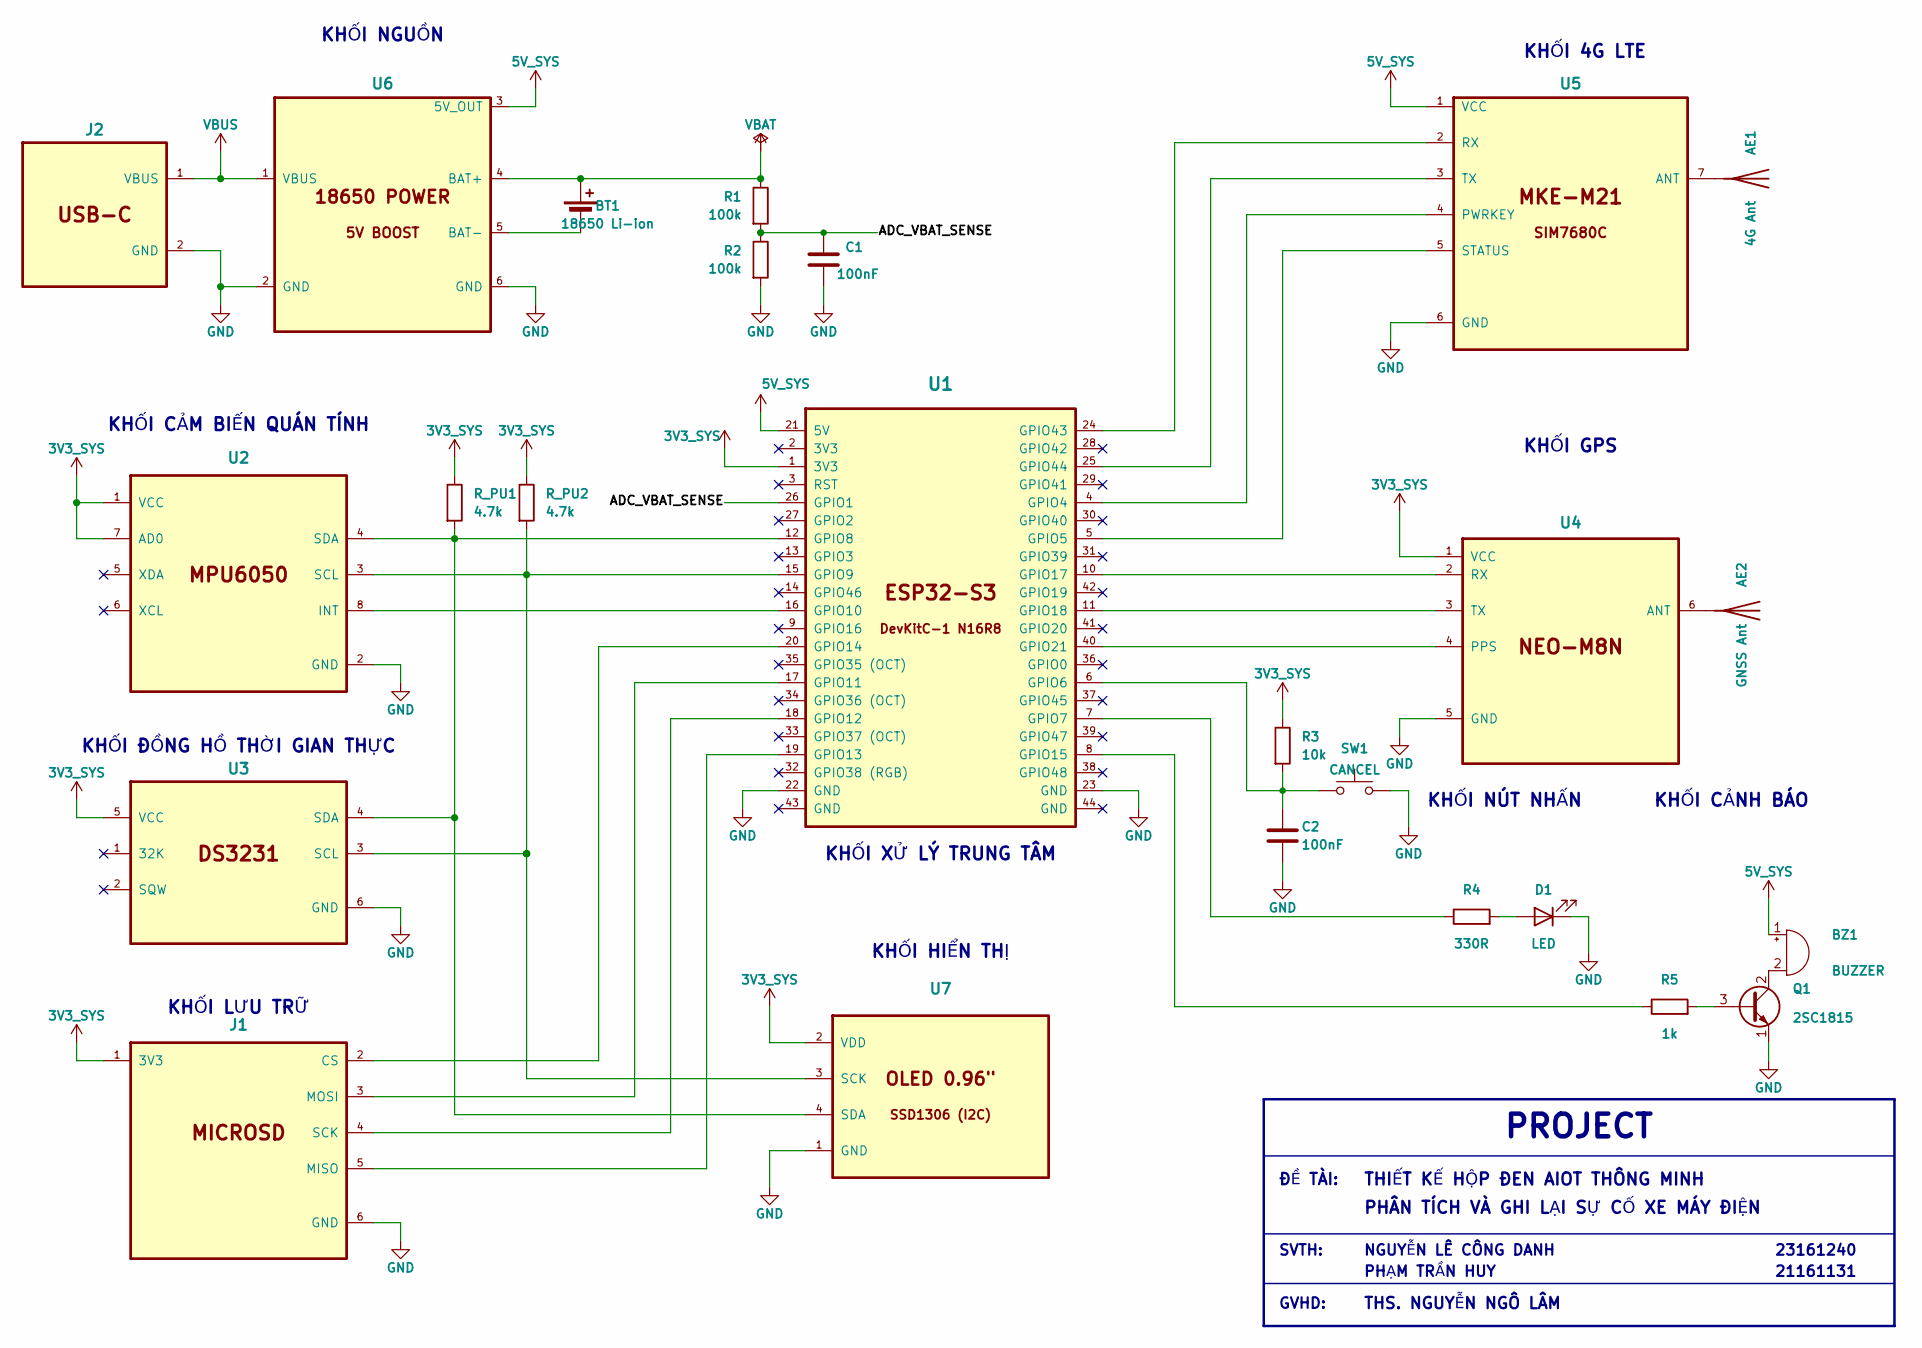
[picture p169: schematic AIOT_BLACKBOX_PRESENTATION.kicad_sch]

Parts:
AE1: 4G Ant
AE2: GNSS Ant
BT1: 18650 Li-ion
BZ1: BUZZER
C1, C2: 100nF
D1: LED
J1: MICROSD
J2: USB-C
Q1: 2SC1815
R1, R2: 100k
R3: 10k
R4: 330R
R5: 1k
R_PU1, R_PU2: 4.7k
SW1: CANCEL
U1: ESP32-S3
U2: MPU6050
U3: DS3231
U4: NEO-M8N
U5: MKE-M21
U6: 18650 POWER
U7: OLED 0.96"

Connections:
ADC_VBAT_SENSE: C1.1, R1.2, R2.1, U1.26 (GPIO1)
unnamed: AE1.1, U5.7 (ANT)
unnamed: AE2.1, U4.6 (ANT)
unnamed: BT1.1 (+), R1.1, U6.4 (BAT+)
unnamed: BT1.2 (-), U6.5 (BAT-)
unnamed: BZ1.2 (-), Q1.2 (C)
unnamed: C2.1, R3.2, SW1.1, U1.6 (GPIO6)
unnamed: D1.2 (A), R4.2
unnamed: J1.2 (CS), U1.20 (GPIO14)
unnamed: J1.3 (MOSI), U1.17 (GPIO11)
unnamed: J1.4 (SCK), U1.18 (GPIO12)
unnamed: J1.5 (MISO), U1.19 (GPIO13)
unnamed: J2.1 (VBUS), U6.1 (VBUS)
unnamed: J2.2 (GND), U6.2 (GND)
unnamed: Q1.3 (B), R5.2
unnamed: R4.1, U1.7 (GPIO7)
unnamed: R5.1, U1.8 (GPIO15)
unnamed: R_PU1.2, U1.12 (GPIO8), U2.4 (SDA), U3.4 (SDA), U7.4 (SDA)
unnamed: R_PU2.2, U1.15 (GPIO9), U2.3 (SCL), U3.3 (SCL), U7.3 (SCK)
unnamed: U1.4 (GPIO4), U5.4 (PWRKEY)
unnamed: U1.5 (GPIO5), U5.5 (STATUS)
unnamed: U1.10 (GPIO17), U4.2 (RX)
unnamed: U1.11 (GPIO18), U4.3 (TX)
unnamed: U1.16 (GPIO10), U2.8 (INT)
unnamed: U1.24 (GPIO43), U5.2 (RX)
unnamed: U1.25 (GPIO44), U5.3 (TX)
unnamed: U1.40 (GPIO21), U4.4 (PPS)
unnamed: U2.1 (VCC), U2.7 (AD0)

Notes on the sheet:
KHỐI GPS
KHỐI 4G LTE
KHỐI LƯU TRỮ
KHỐI CẢM BIẾN QUÁN TÍNH
KHỐI XỬ LÝ TRUNG TÂM
KHỐI ĐỒNG HỒ THỜI GIAN THỰC
KHỐI NGUỒN
KHỐI NÚT NHẤN
KHỐI CẢNH BÁO
PROJECT
ĐỀ TÀI:
THIẾT KẾ HỘP ĐEN AIOT THÔNG MINH
PHÂN TÍCH VÀ GHI LẠI SỰ CỐ XE MÁY ĐIỆN
SVTH:
NGUYỄN LÊ CÔNG DANH
23161240
PHẠM TRẦN HUY
21161131
GVHD:
THS. NGUYỄN NGÔ LÂM
KHỐI HIỂN THỊ
