danhcln/AIOT-BLACK-BOX/Schematic_Thay/AIOT_BLACKBOX_PRESENTATION/AIOT_BLACKBOX_PRESENTATION_A3_backup.kicad_sch

## KiCad design Schematic_Thay/AIOT_BLACKBOX_PRESENTATION/AIOT_BLACKBOX_PRESENTATION_A3_backup.kicad_sch (2026-11-11)

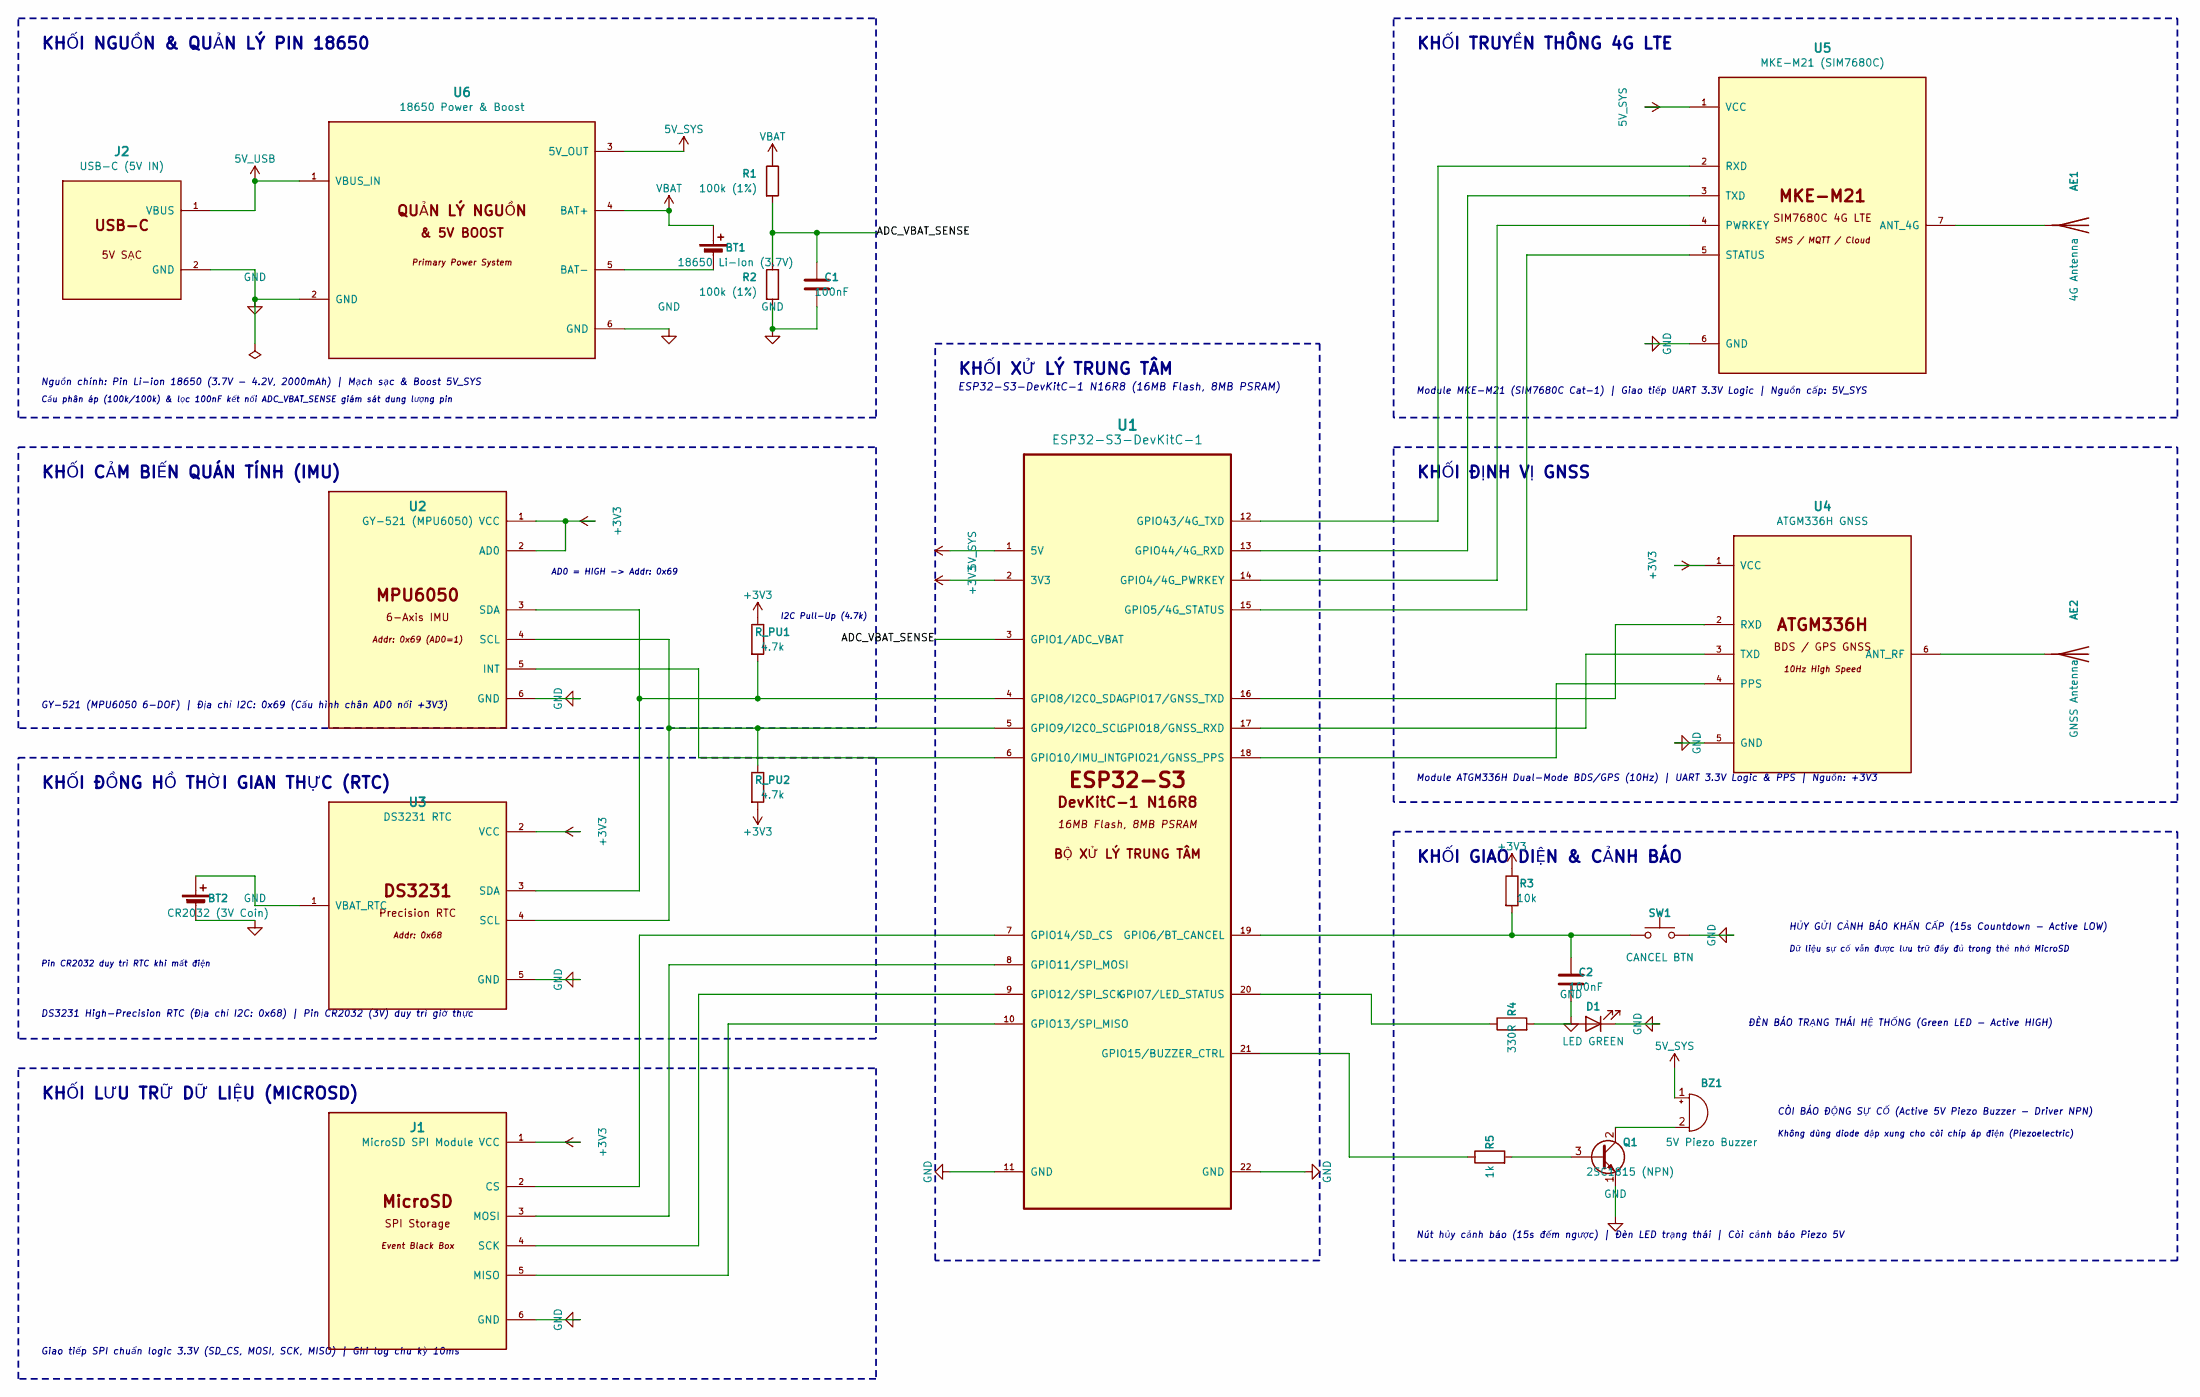
[picture p170: schematic AIOT_BLACKBOX_PRESENTATION_A3_backup.kicad_sch]

Parts:
AE1: 4G Antenna
AE2: GNSS Antenna
BT1: 18650 Li-Ion (3.7V)
BT2: CR2032 (3V Coin)
BZ1: 5V Piezo Buzzer
C1, C2: 100nF
D1: LED GREEN
J1: MicroSD SPI Module
J2: USB-C (5V IN)
Q1: 2SC1815 (NPN)
R1, R2: 100k (1%)
R3: 10k
R4: 330R
R5: 1k
R_PU1, R_PU2: 4.7k
SW1: CANCEL BTN
U1: ESP32-S3-DevKitC-1
U2: GY-521 (MPU6050)
U3: DS3231 RTC
U4: ATGM336H GNSS
U5: MKE-M21 (SIM7680C)
U6: 18650 Power & Boost

Connections:
ADC_VBAT_SENSE: C1.1, R1.2, R2.1, U1.3 (GPIO1/ADC_VBAT)
unnamed: AE1.1, U5.7 (ANT_4G)
unnamed: AE2.1, U4.6 (ANT_RF)
unnamed: BT1.1 (+), U6.4 (BAT+)
unnamed: BT1.2 (-), U6.5 (BAT-)
unnamed: BT2.1 (+), U3.1 (VBAT_RTC)
unnamed: BZ1.2 (-), Q1.2 (C)
unnamed: C1.2, R2.2
unnamed: C2.1, R3.2, SW1.1, U1.19 (GPIO6/BT_CANCEL)
unnamed: D1.2 (A), R4.2
unnamed: J1.2 (CS), U1.7 (GPIO14/SD_CS)
unnamed: J1.3 (MOSI), U1.8 (GPIO11/SPI_MOSI)
unnamed: J1.4 (SCK), U1.9 (GPIO12/SPI_SCK)
unnamed: J1.5 (MISO), U1.10 (GPIO13/SPI_MISO)
unnamed: J2.1 (VBUS), U6.1 (VBUS_IN)
unnamed: J2.2 (GND), U6.2 (GND)
unnamed: Q1.3 (B), R5.2
unnamed: R4.1, U1.20 (GPIO7/LED_STATUS)
unnamed: R5.1, U1.21 (GPIO15/BUZZER_CTRL)
unnamed: R_PU1.2, U1.4 (GPIO8/I2C0_SDA), U2.3 (SDA), U3.3 (SDA)
unnamed: R_PU2.1, U1.5 (GPIO9/I2C0_SCL), U2.4 (SCL), U3.4 (SCL)
unnamed: U1.6 (GPIO10/IMU_INT), U2.5 (INT)
unnamed: U1.12 (GPIO43/4G_TXD), U5.2 (RXD)
unnamed: U1.13 (GPIO44/4G_RXD), U5.3 (TXD)
unnamed: U1.14 (GPIO4/4G_PWRKEY), U5.4 (PWRKEY)
unnamed: U1.15 (GPIO5/4G_STATUS), U5.5 (STATUS)
unnamed: U1.16 (GPIO17/GNSS_TXD), U4.2 (RXD)
unnamed: U1.17 (GPIO18/GNSS_RXD), U4.3 (TXD)
unnamed: U1.18 (GPIO21/GNSS_PPS), U4.4 (PPS)
unnamed: U2.1 (VCC), U2.2 (AD0)

Notes on the sheet:
KHỐI NGUỒN & QUẢN LÝ PIN 18650
Nguồn chính: Pin Li-ion 18650 (3.7V - 4.2V, 2000mAh) | Mạch sạc & Boost 5V_SYS
Cầu phân áp (100k/100k) & lọc 100nF kết nối ADC_VBAT_SENSE giám sát dung lượng pin
KHỐI XỬ LÝ TRUNG TÂM
ESP32-S3-DevKitC-1 N16R8 (16MB Flash, 8MB PSRAM)
KHỐI CẢM BIẾN QUÁN TÍNH (IMU)
GY-521 (MPU6050 6-DOF) | Địa chỉ I2C: 0x69 (Cấu hình chân AD0 nối +3V3)
KHỐI ĐỒNG HỒ THỜI GIAN THỰC (RTC)
DS3231 High-Precision RTC (Địa chỉ I2C: 0x68) | Pin CR2032 (3V) duy trì giờ thực
KHỐI LƯU TRỮ DỮ LIỆU (MICROSD)
Giao tiếp SPI chuẩn logic 3.3V (SD_CS, MOSI, SCK, MISO) | Ghi log chu kỳ 10ms
KHỐI TRUYỀN THÔNG 4G LTE
Module MKE-M21 (SIM7680C Cat-1) | Giao tiếp UART 3.3V Logic | Nguồn cấp: 5V_SYS
KHỐI ĐỊNH VỊ GNSS
Module ATGM336H Dual-Mode BDS/GPS (10Hz) | UART 3.3V Logic & PPS | Nguồn: +3V3
KHỐI GIAO DIỆN & CẢNH BÁO
Nút hủy cảnh báo (15s đếm ngược) | Đèn LED trạng thái | Còi cảnh báo Piezo 5V
AD0 = HIGH -> Addr: 0x69
Pin CR2032 duy trì RTC khi mất điện
I2C Pull-Up (4.7k)
HỦY GỬI CẢNH BÁO KHẨN CẤP (15s Countdown - Active LOW)
Dữ liệu sự cố vẫn được lưu trữ đầy đủ trong thẻ nhớ MicroSD
ĐÈN BÁO TRẠNG THÁI HỆ THỐNG (Green LED - Active HIGH)
CÒI BÁO ĐỘNG SỰ CỐ (Active 5V Piezo Buzzer - Driver NPN)
Không dùng diode dập xung cho còi chíp áp điện (Piezoelectric)
