danhcln/AIOT-BLACK-BOX/Schematic_Thay/AIOT_BLACKBOX_PRESENTATION/AIOT_BLACKBOX_PRESENTATION_A4_pre_backup.kicad_sch

## KiCad design Schematic_Thay/AIOT_BLACKBOX_PRESENTATION/AIOT_BLACKBOX_PRESENTATION_A4_pre_backup.kicad_sch (2026-11-11)

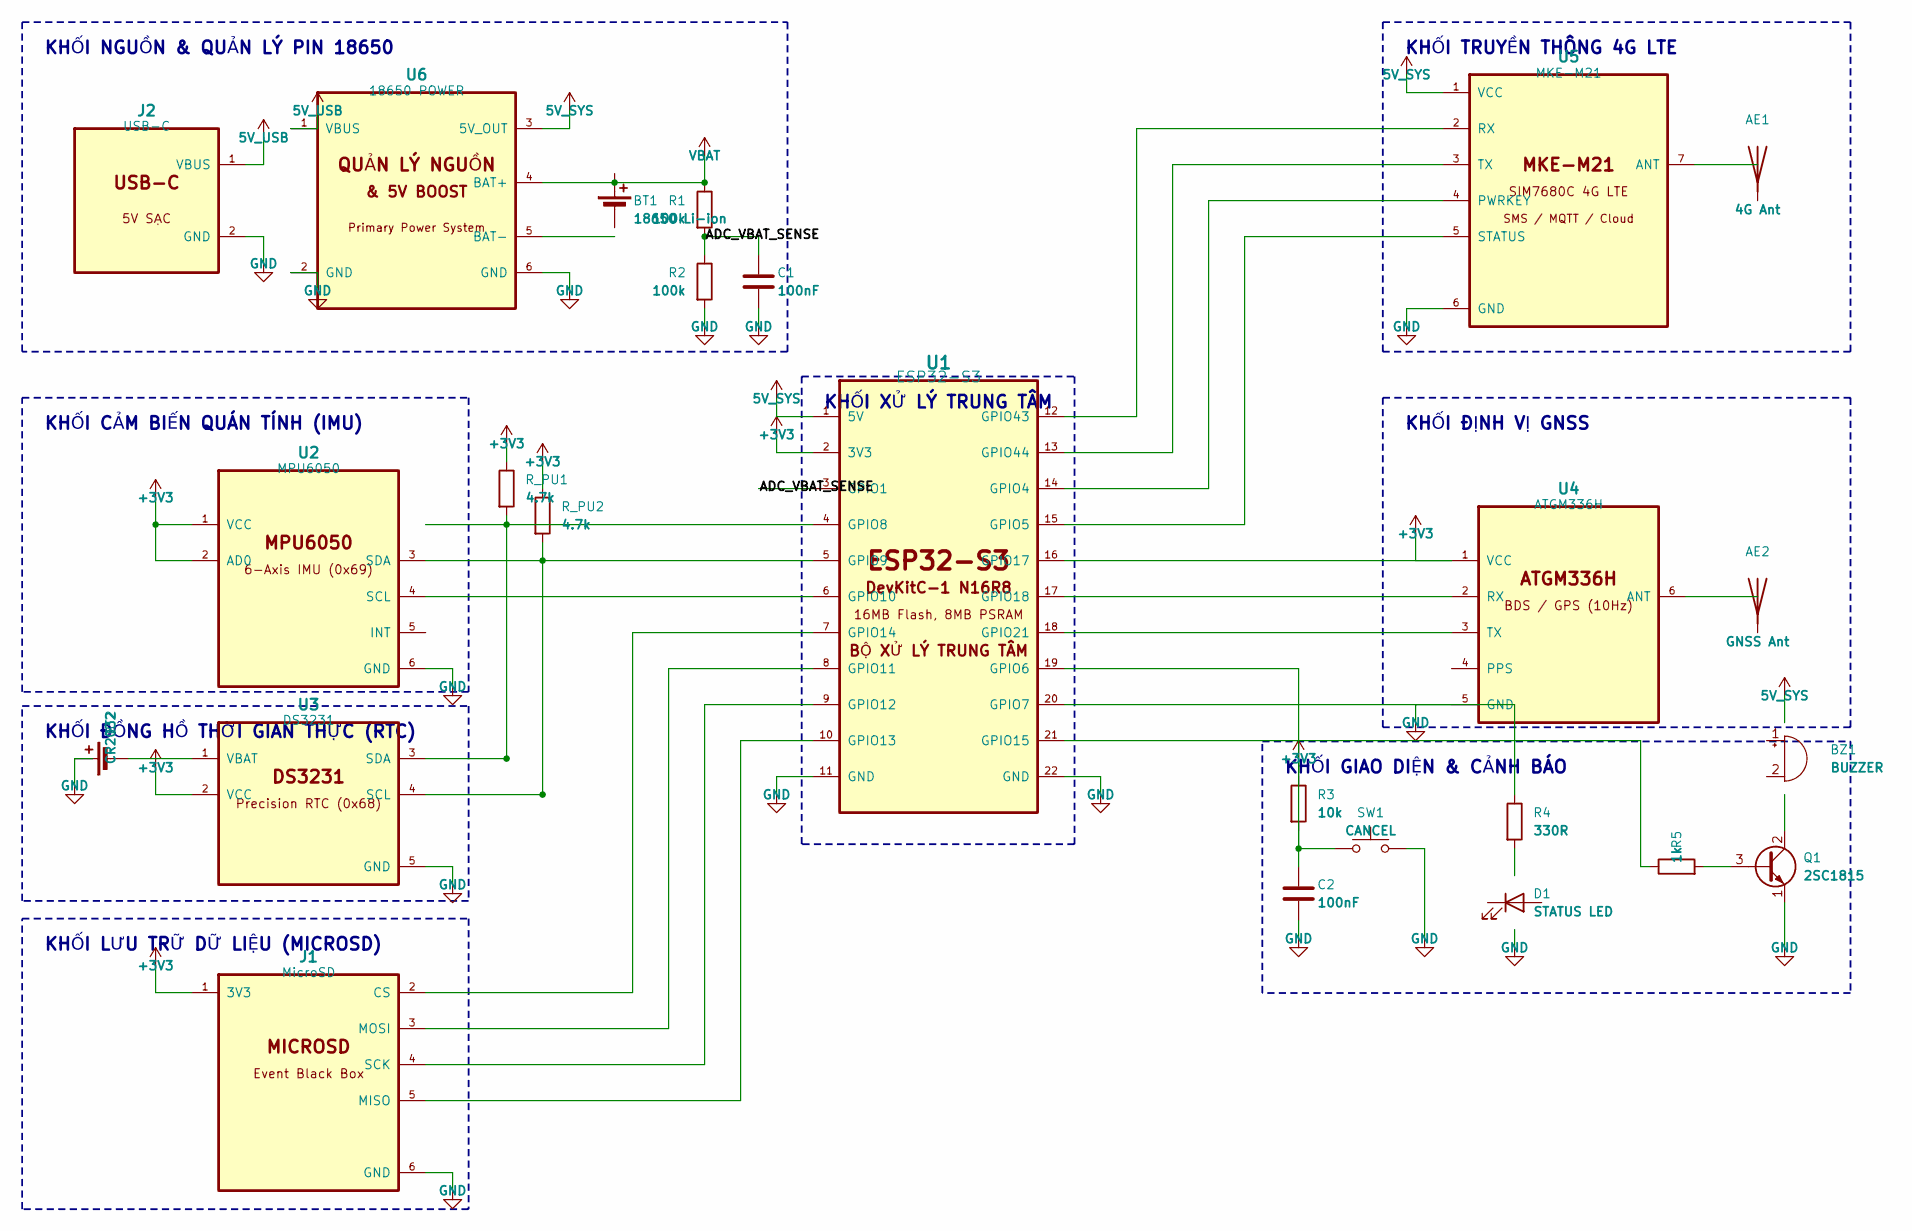
[picture p171: schematic AIOT_BLACKBOX_PRESENTATION_A4_pre_backup.kicad_sch]

Parts:
AE1: 4G Ant
AE2: GNSS Ant
BT1: 18650 Li-ion
BT2: CR2032
BZ1: BUZZER
C1, C2: 100nF
D1: STATUS LED
J1: MicroSD
J2: USB-C
Q1: 2SC1815
R1, R2: 100k
R3: 10k
R4: 330R
R5: 1k
R_PU1, R_PU2: 4.7k
SW1: CANCEL
U1: ESP32-S3
U2: MPU6050
U3: DS3231
U4: ATGM336H
U5: MKE-M21
U6: 18650 POWER

Connections:
ADC_VBAT_SENSE: C1.1, R1.2, R2.1, U1.3 (GPIO1)
unnamed: BT2.2 (-), U3.1 (VBAT)
unnamed: C2.1, R3.2, SW1.1, U1.19 (GPIO6)
unnamed: J1.2 (CS), U1.7 (GPIO14)
unnamed: J1.3 (MOSI), U1.8 (GPIO11)
unnamed: J1.4 (SCK), U1.9 (GPIO12)
unnamed: J1.5 (MISO), U1.10 (GPIO13)
unnamed: Q1.3 (B), R5.2
unnamed: R1.1, U6.4 (BAT+)
unnamed: R4.1, U1.20 (GPIO7)
unnamed: R5.1, U1.21 (GPIO15)
unnamed: R_PU1.2, U1.4 (GPIO8), U3.3 (SDA)
unnamed: R_PU2.2, U1.5 (GPIO9), U2.3 (SDA), U3.4 (SCL)
unnamed: U1.6 (GPIO10), U2.4 (SCL)
unnamed: U1.12 (GPIO43), U5.2 (RX)
unnamed: U1.13 (GPIO44), U5.3 (TX)
unnamed: U1.14 (GPIO4), U5.4 (PWRKEY)
unnamed: U1.15 (GPIO5), U5.5 (STATUS)
unnamed: U1.16 (GPIO17), U4.1 (VCC)
unnamed: U1.17 (GPIO18), U4.2 (RX)
unnamed: U1.18 (GPIO21), U4.3 (TX)
unnamed: U2.1 (VCC), U2.2 (AD0)

Notes on the sheet:
KHỐI NGUỒN & QUẢN LÝ PIN 18650
KHỐI XỬ LÝ TRUNG TÂM
KHỐI CẢM BIẾN QUÁN TÍNH (IMU)
KHỐI ĐỒNG HỒ THỜI GIAN THỰC (RTC)
KHỐI LƯU TRỮ DỮ LIỆU (MICROSD)
KHỐI TRUYỀN THÔNG 4G LTE
KHỐI ĐỊNH VỊ GNSS
KHỐI GIAO DIỆN & CẢNH BÁO
