danhcln/AIOT-BLACK-BOX/Schematic_Thay/AIOT_BLACKBOX_PRESENTATION/temp_test.kicad_sch

## KiCad design Schematic_Thay/AIOT_BLACKBOX_PRESENTATION/temp_test.kicad_sch (2026-11-11)

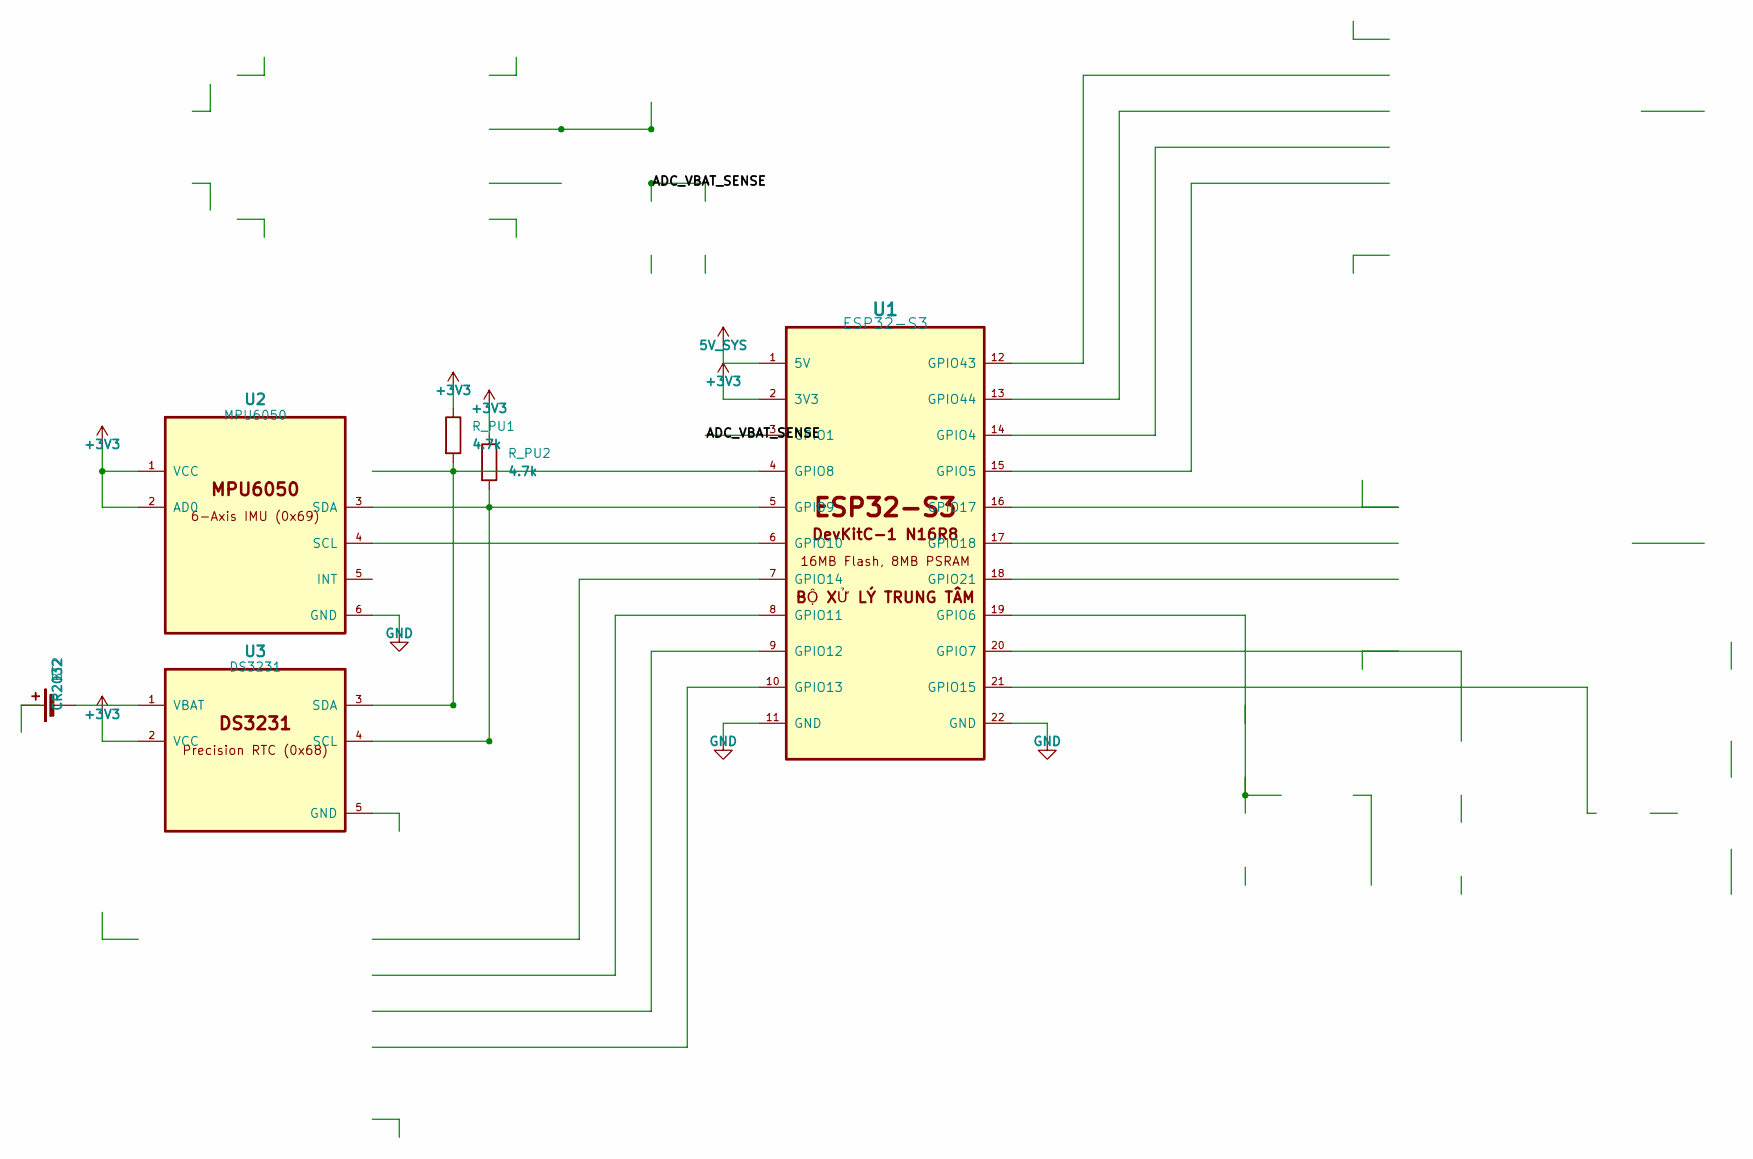
[picture p172: schematic temp_test.kicad_sch]

Parts:
BT2: CR2032
R_PU1, R_PU2: 4.7k
U1: ESP32-S3
U2: MPU6050
U3: DS3231

Connections:
ADC_VBAT_SENSE: U1.3 (GPIO1)
unnamed: BT2.2 (-), U3.1 (VBAT)
unnamed: R_PU1.2, U1.4 (GPIO8), U3.3 (SDA)
unnamed: R_PU2.2, U1.5 (GPIO9), U2.3 (SDA), U3.4 (SCL)
unnamed: U1.6 (GPIO10), U2.4 (SCL)
unnamed: U2.1 (VCC), U2.2 (AD0)
