danhcln/AIOT-BLACK-BOX/THIET_KE_KHOI_NGUON/build_all_documentation.py

# -*- coding: utf-8 -*-
"""
ENGINEERING DOCUMENTATION GENERATOR FOR AIOT_BLACKBOX_POWER_SUPPLY
Generates 4 professional engineering PDFs and 07_OPEN_ISSUES.txt:
1. 01_POWER_ARCHITECTURE.pdf
2. 02_POWER_CALCULATIONS.pdf
3. 03_POWER_COMPONENT_SELECTION.pdf
4. 06_POWER_VALIDATION_CHECKLIST.pdf
5. 07_OPEN_ISSUES.txt
"""

import sys
import os
import pymupdf

def create_doc_builder(title, doc_id, rev="REV 1.0"):
    doc = pymupdf.open()
    return doc

class PDFReport:
    def __init__(self, filename, title, subtitle):
        self.filename = filename
        self.title = title
        self.subtitle = subtitle
        self.doc = pymupdf.open()
        self.page = None
        self.y = 50
        self.page_num = 0
        self.margin_x = 45
        self.page_w = 595.3
        self.page_h = 841.9
        self.content_w = self.page_w - 2 * self.margin_x
        self.new_page()

    def new_page(self):
        if self.page:
            self._draw_footer()
        self.page = self.doc.new_page(width=self.page_w, height=self.page_h)
        self.page_num += 1
        self.y = 45
        self._draw_header()

    def _draw_header(self):
        # Header banner line
        self.page.draw_line(pymupdf.Point(self.margin_x, 35),
                            pymupdf.Point(self.page_w - self.margin_x, 35),
                            color=(0.2, 0.4, 0.65), width=0.8)
        self.page.insert_text(pymupdf.Point(self.margin_x, 30),
                             "AIOT SMART BLACK BOX - POWER HARDWARE ENGINEERING REPORT",
                             fontsize=8, fontname="helv", color=(0.4, 0.4, 0.4))
        self.page.insert_text(pymupdf.Point(self.page_w - self.margin_x - 60, 30),
                             "REV 1.0", fontsize=8, fontname="helv", color=(0.4, 0.4, 0.4))
        self.y = 50

    def _draw_footer(self):
        # Footer line
        self.page.draw_line(pymupdf.Point(self.margin_x, self.page_h - 35),
                            pymupdf.Point(self.page_w - self.margin_x, self.page_h - 35),
                            color=(0.7, 0.7, 0.7), width=0.5)
        self.page.insert_text(pymupdf.Point(self.margin_x, self.page_h - 25),
                             "Confidential & Proprietary - AIoT Electric Motorcycle Incident Black Box",
                             fontsize=7.5, fontname="helv", color=(0.5, 0.5, 0.5))
        page_str = f"Page {self.page_num}"
        self.page.insert_text(pymupdf.Point(self.page_w - self.margin_x - 35, self.page_h - 25),
                             page_str, fontsize=8, fontname="helv", color=(0.5, 0.5, 0.5))

    def check_space(self, needed):
        if self.y + needed > self.page_h - 50:
            self.new_page()

    def add_cover_banner(self):
        rect = pymupdf.Rect(self.margin_x, self.y, self.page_w - self.margin_x, self.y + 65)
        self.page.draw_rect(rect, color=(0.12, 0.28, 0.49), fill=(0.12, 0.28, 0.49))
        self.page.insert_text(pymupdf.Point(self.margin_x + 15, self.y + 28),
                             self.title, fontsize=15, fontname="helv", color=(1, 1, 1))
        self.page.insert_text(pymupdf.Point(self.margin_x + 15, self.y + 48),
                             self.subtitle, fontsize=9.5, fontname="helv", color=(0.85, 0.9, 0.95))
        self.y += 78

    def add_h1(self, text):
        self.check_space(35)
        rect = pymupdf.Rect(self.margin_x, self.y + 2, self.margin_x + 4, self.y + 18)
        self.page.draw_rect(rect, color=(0.12, 0.28, 0.49), fill=(0.12, 0.28, 0.49))
        self.page.insert_text(pymupdf.Point(self.margin_x + 10, self.y + 15),
                             text, fontsize=12.5, fontname="helv", color=(0.12, 0.28, 0.49))
        self.y += 25

    def add_h2(self, text):
        self.check_space(25)
        self.page.insert_text(pymupdf.Point(self.margin_x, self.y + 12),
                             text, fontsize=10.5, fontname="helv", color=(0.2, 0.35, 0.55))
        self.y += 18

    def add_p(self, text):
        self.check_space(20)
        # Simple word wrap
        words = text.split(" ")
        lines = []
        curr = ""
        for w in words:
            if len(curr + " " + w) > 92:
                lines.append(curr)
                curr = w
            else:
                curr = (curr + " " + w).strip()
        if curr:
            lines.append(curr)

        for l in lines:
            self.check_space(13)
            self.page.insert_text(pymupdf.Point(self.margin_x, self.y + 10),
                                 l, fontsize=9, fontname="helv", color=(0.15, 0.15, 0.15))
            self.y += 13
        self.y += 4

    def add_callout(self, title, text, alert_type="NOTE"):
        # Alert colors
        colors = {
            "NOTE": ((0.2, 0.4, 0.65), (0.94, 0.96, 0.99), (0.1, 0.2, 0.4)),
            "WARN": ((0.8, 0.4, 0.0), (1.0, 0.97, 0.92), (0.5, 0.25, 0.0)),
            "CRIT": ((0.8, 0.1, 0.1), (1.0, 0.94, 0.94), (0.6, 0.05, 0.0))
        }
        border_c, fill_c, text_c = colors.get(alert_type, colors["NOTE"])
        
        # Wrap text
        words = text.split(" ")
        lines = []
        curr = ""
        for w in words:
            if len(curr + " " + w) > 86:
                lines.append(curr)
                curr = w
            else:
                curr = (curr + " " + w).strip()
        if curr:
            lines.append(curr)

        box_h = 24 + len(lines) * 12
        self.check_space(box_h + 8)

        rect = pymupdf.Rect(self.margin_x, self.y, self.page_w - self.margin_x, self.y + box_h)
        self.page.draw_rect(rect, color=border_c, fill=fill_c, width=1.0)
        # Left accent stripe
        stripe = pymupdf.Rect(self.margin_x, self.y, self.margin_x + 4, self.y + box_h)
        self.page.draw_rect(stripe, color=border_c, fill=border_c)

        self.page.insert_text(pymupdf.Point(self.margin_x + 12, self.y + 14),
                             f"[{alert_type}] {title}", fontsize=9, fontname="helv", color=text_c)

        cy = self.y + 26
        for l in lines:
            self.page.insert_text(pymupdf.Point(self.margin_x + 12, cy),
                                 l, fontsize=8.5, fontname="helv", color=(0.2, 0.2, 0.2))
            cy += 12
        self.y += box_h + 8

    def add_table(self, col_names, rows, col_widths=None):
        num_cols = len(col_names)
        if not col_widths:
            w_per_col = self.content_w / num_cols
            col_widths = [w_per_col] * num_cols

        # Header height
        row_h = 16
        needed = (len(rows) + 1) * row_h + 10
        self.check_space(min(needed, 100))

        # Draw header
        rect = pymupdf.Rect(self.margin_x, self.y, self.page_w - self.margin_x, self.y + row_h)
        self.page.draw_rect(rect, color=(0.2, 0.35, 0.55), fill=(0.2, 0.35, 0.55))
        
        cx = self.margin_x
        for i, name in enumerate(col_names):
            self.page.insert_text(pymupdf.Point(cx + 4, self.y + 11),
                                 str(name), fontsize=8, fontname="helv", color=(1, 1, 1))
            cx += col_widths[i]
        self.y += row_h

        # Rows
        for r_idx, row in enumerate(rows):
            self.check_space(row_h + 2)
            bg = (0.96, 0.97, 0.99) if r_idx % 2 == 1 else (1.0, 1.0, 1.0)
            rect = pymupdf.Rect(self.margin_x, self.y, self.page_w - self.margin_x, self.y + row_h)
            self.page.draw_rect(rect, color=(0.85, 0.85, 0.85), fill=bg, width=0.5)

            cx = self.margin_x
            for i, val in enumerate(row):
                self.page.insert_text(pymupdf.Point(cx + 4, self.y + 11),
                                     str(val)[:45], fontsize=8, fontname="helv", color=(0.15, 0.15, 0.15))
                cx += col_widths[i]
            self.y += row_h
        self.y += 8

    def save(self):
        if self.page:
            self._draw_footer()
        self.doc.save(self.filename)
        self.doc.close()
        print(f"Generated PDF: {self.filename}")

# =============================================================================
# BUILD 4 ENGINEERING PDFS
# =============================================================================
def build_all_pdfs():
    # -------------------------------------------------------------------------
    # 1. 01_POWER_ARCHITECTURE.pdf
    # -------------------------------------------------------------------------
    p1 = PDFReport("01_POWER_ARCHITECTURE.pdf",
                   "SYSTEM POWER ARCHITECTURE & TOPOLOGICAL SPECIFICATION",
                   "AIoT Electric Motorcycle Black Box Accident Recording Device")
    p1.add_cover_banner()

    p1.add_h1("1. Executive Overview & Design Objectives")
    p1.add_p("This document specifies the complete, buildable, and technically defensible power supply architecture for the AIoT Electric Motorcycle Black Box project. The system functions as a high-reliability accident recording unit deployed on an electric motorcycle. Operating in harsh automotive conditions, the device records critical telemetry (ESP32-S3 processing, MicroSD logging, MPU6050 6-axis IMU, DS3231 RTC, NEO-M8N GNSS) and transmits crash telemetry over 4G LTE cellular network (A7682S).")
    p1.add_p("Reliability and safety take strict precedence over minimum component cost. The architecture is engineered to guarantee continuous, fail-safe operation during extreme transients, sudden vehicle power collapse during a crash, and severe 2.0A cellular RF transmission bursts.")

    p1.add_h1("2. System Power Source Relationship & Hierarchy")
    p1.add_callout("CRITICAL POWER HIERARCHY RULE",
                   "PRIMARY OPERATING POWER SOURCE: 1S 18650 Li-ion Battery (VBAT). EXTERNAL POWER (USB-C / VEHICLE 5V): External charging and supplemental source, NOT the primary operating rail. ESP32 DevKit is a LOAD of the power supply, NOT a power distributor.",
                   "CRIT")
    p1.add_p("The project enforces the official power relationship:")
    p1.add_p("External 5V Inputs (Vehicle 5V_IN / USB 5V_IN) -> TPS2121 Power Mux -> BQ25895 NVDC Charger -> 18650 Battery (VBAT) -> System Rail (SYS) -> TPS61088 Synchronous Boost -> 5V_SYS Main System Rail -> TPS62162 Synchronous Buck -> 3V3_SYS Logic Rail.")
    p1.add_p("Dedicated Cellular Supply: 5V_SYS -> Dual Selection (Option A: 5V P-MOSFET Switch vs Option B: TPS62130 3.8V Buck) -> Selection Jumper JP1 -> 1000uF Low-ESR Polymer Capacitor -> SIM_PWR -> A7682S Breakout.")

    p1.add_h1("3. Separated System Power Domains")
    domains = [
        ("VBUS_MUX", "4.4V - 5.5V", "3.0A max", "Output of TPS2121 Power Mux; supplies BQ25895 charger input."),
        ("VBAT", "3.0V - 4.2V", "6.0A trip", "1S Li-ion Battery rail; protected by DW01A + dual FS8205A."),
        ("SYS", "3.0V - 4.2V", "5.0A peak", "NVDC System rail from BQ25895; supplies TPS61088 boost converter."),
        ("5V_SYS", "5.00V ±1.5%", "3.5A / 5A", "Regulated 5V rail; supplies ESP32-S3, 5V Buzzer, MicroSD, 3.3V buck."),
        ("3V3_SYS", "3.30V ±1.5%", "1.0A cont", "Regulated 3.3V peripheral rail; supplies MPU6050, DS3231, OLED, GNSS."),
        ("SIM_PWR", "5.0V / 3.8V", "2.0A burst", "Dedicated cellular rail; buffered by 1000uF polymer capacitor."),
        ("GND", "0.0V Return", "Common", "Unified low-impedance ground plane with star return at battery/charger.")
    ]
    p1.add_table(["Power Rail", "Voltage Range", "Current Rating", "Functional Scope & Loads"],
                 domains, [70, 75, 75, 285])

    p1.add_h1("4. Grounding & Layout Strategy")
    p1.add_p("Due to high di/dt switching transitions (600kHz boost, 2.25MHz buck) and 2.0A periodic cellular transmission pulses (577us pulse width every 4.615ms in 2G/4G mode), the layout enforces strict separation between Power Ground (PGND) and Analog Ground (AGND).")
    p1.add_p("PGND carries heavy circulating currents from inductors L1, L2, L3, L4, input bypass caps, and polymer capacitor C35. AGND carries sensitive analog references (ADC_VBAT_SENSE divider, BQ25895 TS NTC sensor, TPS61088 FB/COMP networks). AGND is tied to PGND at a single star point on the bottom layer directly beneath the BQ25895 thermal pad.")

    p1.add_h1("5. Power Path Operating States & Transition Verification")
    states = [
        ("Case 1: Battery Only", "No external power; BQ25895 BATFET is fully ON; battery supplies SYS directly. System operates normally down to 3.0V cutoff."),
        ("Case 2: Vehicle Running", "Vehicle 5V present; TPS2121 selects Vehicle input. BQ25895 powers SYS and charges 18650 cell simultaneously up to 3.25A limit."),
        ("Case 3: USB-C Plugged", "Bench testing / charging; TPS2121 selects USB-C input. BQ25895 manages charging; full system operates normally."),
        ("Case 4: Dual Input Present", "Vehicle 5V and USB-C 5V both present. TPS2121 priority comparator selects Vehicle 5V. Internal back-to-back FETs block reverse current."),
        ("Case 5: Sudden Vehicle Loss", "Vehicle power disappears instantly during accident. BQ25895 seamlessly turns on BATFET with zero drop; ESP32 experiences NO reset."),
        ("Case 6: Battery Discharged", "Battery at 3.0V cutoff; A7682S triggers 2A transmit burst. TPS61088 draws 5.04A peak; dual FS8205A withstands 6A without tripping."),
        ("Case 7: SD Write + 4G Burst", "MicroSD writes incident sector while 4G transmits crash alert. 5V_SYS maintains >4.90V; 1000uF polymer absorbs cellular current pulse."),
        ("Case 8: Battery Absent", "18650 cell disconnected or deeply discharged. BQ25895 NVDC architecture regulates SYS at 3.65V from external 5V; system boots normally.")
    ]
    p1.add_table(["Operating Scenario", "System Behavior & Electrical Safety Verification"],
                 states, [130, 375])
    p1.save()

    # -------------------------------------------------------------------------
    # 2. 02_POWER_CALCULATIONS.pdf
    # -------------------------------------------------------------------------
    p2 = PDFReport("02_POWER_CALCULATIONS.pdf",
                   "ELECTRICAL POWER BUDGET & CONVERTER SIZING CALCULATIONS",
                   "Rigorous Numerical Proofs & Component Stress Sizing")
    p2.add_cover_banner()

    p2.add_h1("1. Comprehensive System Load Budget")
    loads = [
        ("ESP32-S3 DevKitC-1", "5V_SYS", "5.0V", "160 mA", "500 mA", "2.50 W", "Active WiFi/BLE peak current"),
        ("MicroSD Breakout", "5V_SYS / 3V3", "3.3V/5V", "30 mA", "100 mA", "0.50 W", "Flash sector erase/write current"),
        ("5V Buzzer & Status LED", "5V_SYS", "5.0V", "15 mA", "40 mA", "0.20 W", "Audible crash notification"),
        ("NEO-M8N GNSS Breakout", "3V3_SYS", "3.3V", "35 mA", "65 mA", "0.21 W", "Continuous satellite acquisition"),
        ("0.96-inch I2C OLED", "3V3_SYS", "3.3V", "15 mA", "30 mA", "0.10 W", "All white pixels illuminated"),
        ("MPU6050 IMU Breakout", "3V3_SYS", "3.3V", "3.8 mA", "5.0 mA", "0.02 W", "DMP active 200Hz sampling"),
        ("DS3231 Real-Time Clock", "3V3_SYS", "3.3V", "0.15 mA", "1.5 mA", "0.005 W", "TCXO temperature conversion"),
        ("A7682S Cellular (Option A)", "SIM_PWR", "5.0V", "250 mA", "2000 mA", "10.0 W", "4G LTE Category 1 RF burst"),
        ("TOTAL SYSTEM BUDGET", "5V_SYS", "5.0V", "509 mA", "2741 mA", "13.54 W", "Maximum concurrent load")
    ]
    p2.add_table(["Subsystem Load", "Supply Rail", "Voltage", "Avg Current", "Peak Current", "Peak Power", "Operating Condition"],
                 loads, [95, 55, 45, 55, 55, 50, 150])

    p2.add_h1("2. Battery Current Draw Across Discharge Curve")
    p2.add_p("The single 18650 Li-ion cell operates between 4.20V (100% SoC) and 3.00V (empty cutoff). Under maximum continuous system load (5V @ 0.70A = 3.50W) and maximum peak load (5V @ 2.74A = 13.70W with 90% boost efficiency eta):")
    p2.add_p("Equation: I_BAT = P_OUT / (eta * V_BAT) = (V_OUT * I_OUT) / (eta * V_BAT)")

    bat_calc = [
        ("4.20V (Full Charge)", "3.50 W", "0.925 A", "13.70 W", "3.62 A", "Low thermal stress, maximum margin"),
        ("3.70V (Nominal Plateau)", "3.50 W", "1.051 A", "13.70 W", "4.11 A", "Standard cruise operating condition"),
        ("3.30V (Low Battery Warn)", "3.50 W", "1.178 A", "13.70 W", "4.61 A", "High-stress telemetry dispatch"),
        ("3.00V (Emergency Cutoff)", "3.50 W", "1.296 A", "13.70 W", "5.04 A", "Absolute worst-case peak current")
    ]
    p2.add_table(["Battery Voltage", "Cont Power", "Cont I_BAT", "Peak Power", "Peak I_BAT", "Operating Assessment"],
                 bat_calc, [100, 60, 60, 60, 60, 165])

    p2.add_callout("BATTERY PROTECTION MOSFET VOLTAGE DROP VERIFICATION",
                   "Under worst-case 3.00V cutoff and 5.04A peak burst current, the dual paralleled FS8205A MOSFETs (RDSon = 12.5 mOhm combined) produce a total voltage drop of Delta_V = 5.04A * 0.0125 Ohm = 0.063V (63mV). The battery cell terminals remain at 3.00V - 0.063V = 2.937V, which is safely above the DW01A hard undervoltage cutoff threshold of 2.40V.",
                   "NOTE")

    p2.add_h1("3. TPS61088 High-Current Boost Converter Sizing")
    p2.add_p("1. Duty Cycle (D) at minimum input voltage (VIN = 3.0V, VOUT = 5.0V, eta = 0.90):")
    p2.add_p("   D = 1 - (VIN * eta / VOUT) = 1 - (3.0 * 0.90 / 5.0) = 0.460 (46.0%)")
    p2.add_p("2. Average Inductor Current (IL_avg) at maximum continuous 5V/3.0A load:")
    p2.add_p("   IL_avg = (VOUT * IOUT) / (VIN * eta) = (5.0 * 3.0) / (3.0 * 0.90) = 5.56 A")
    p2.add_p("3. Inductor Ripple Current (Delta_IL) with L = 1.0uH, Fsw = 600kHz:")
    p2.add_p("   Delta_IL = (VIN * D) / (Fsw * L) = (3.0V * 0.46) / (600,000 Hz * 1.0e-6 H) = 2.30 A")
    p2.add_p("4. Peak Inductor Current (IL_peak):")
    p2.add_p("   IL_peak = IL_avg + (Delta_IL / 2) = 5.56A + 1.15A = 6.71 A")
    p2.add_p("   Selected Inductor: Bourns SRP6540-1R0M (Isat = 10.0A, Irms = 8.5A, DCR = 9.0 mOhm).")
    p2.add_p("   Saturation Safety Margin: (10.0A - 6.71A) / 10.0A = 32.9% margin under maximum continuous 3.0A load!")

    p2.add_h1("4. Cellular Transient Buffer Sizing (1000uF Polymer)")
    p2.add_p("A7682S produces 2.0A current pulses for T_pulse = 577 microseconds during transmission bursts. The allowable voltage droop on the cellular rail is Delta_V_max = 150mV (to keep supply safely above the 3.4V reset threshold).")
    p2.add_p("Capacitance required: C_req = (I_burst * T_pulse) / Delta_V_max = (2.0A * 577e-6 s) / 0.15V = 769 uF.")
    p2.add_p("Selected: 1000uF / 6.3V Panasonic EEF-HX Ultra-Low ESR Polymer Capacitor (ESR = 12 mOhm).")
    p2.add_p("ESR Voltage Droop: Delta_V_ESR = I_burst * ESR = 2.0A * 0.012 Ohm = 24.0 mV.")
    p2.add_p("Capacitive Discharge Droop: Delta_V_cap = (2.0A * 577e-6) / 1000e-6 = 1.15 mV.")
    p2.add_p("Total Transient Droop: Delta_V_total = 24.0mV + 1.15mV = 25.15 mV << 150 mV limit (83.2% safety margin).")

    p2.add_h1("5. Thermal Dissipation & Junction Temperatures")
    thermals = [
        ("TPS2121 (Power Mux)", "P = I^2 * R = (2.5)^2 * 0.056 = 0.35 W", "Theta_JA = 48.6 °C/W", "Delta_T = 17.0 °C", "T_J = 67.0 °C (Max 125 °C)"),
        ("BQ25895 (Charger NVDC)", "P_loss = 3.0A * 0.15V = 0.45 W", "Theta_JA = 35.0 °C/W", "Delta_T = 15.8 °C", "T_J = 65.8 °C (Max 125 °C)"),
        ("TPS61088 (Boost 5V)", "P_loss = 15W * (1 - 0.92) = 1.20 W", "Theta_JA = 32.5 °C/W", "Delta_T = 39.0 °C", "T_J = 89.0 °C (Max 125 °C)"),
        ("TPS62162 (Buck 3.3V)", "P_loss = (3.3W / 0.90) - 3.3W = 0.37 W", "Theta_JA = 65.0 °C/W", "Delta_T = 24.1 °C", "T_J = 74.1 °C (Max 125 °C)"),
        ("Dual FS8205A (Protection)", "P_loss = (5.04A)^2 * 0.0125 = 0.32 W", "Theta_JA = 80.0 °C/W", "Delta_T = 25.6 °C", "T_J = 75.6 °C (Max 150 °C)")
    ]
    p2.add_table(["Active Component", "Worst-Case Power Loss", "Thermal Resistance", "Temp Rise (Tamb=50°C)", "Estimated Junction Temp"],
                 thermals, [105, 140, 85, 80, 95])
    p2.save()

    # -------------------------------------------------------------------------
    # 3. 03_POWER_COMPONENT_SELECTION.pdf
    # -------------------------------------------------------------------------
    p3 = PDFReport("03_POWER_COMPONENT_SELECTION.pdf",
                   "COMPONENT SELECTION & DATASHEET ENGINEERING ANALYSIS",
                   "Technical Justification & Parameter Verification of Active Power ICs")
    p3.add_cover_banner()

    p3.add_h1("1. TPS2121RUXR - Seamless Dual Power Multiplexer")
    p3.add_p("Function: Automatic selection between External Vehicle 5V (Priority 1) and USB-C 5V (Priority 2).")
    p3.add_p("- Input Range: 2.7V to 22V (Absolute max 24V). Ideal for 5V automotive environments.")
    p3.add_p("- Switchover Time: 5 microseconds fast switchover ensures zero interruption on VBUS_MUX.")
    p3.add_p("- Reverse Current Blocking: Dual back-to-back N-FET architecture prevents back-feeding from USB-C into the vehicle DC-DC converter or vice-versa.")
    p3.add_p("- Threshold Configuration: External resistor divider R1/R3 sets OV1 cutoff to 5.80V; R4/R6 sets OV2 cutoff to 5.80V. PR1 divider selects Priority 1 when Vehicle 5V > 4.40V.")

    p3.add_h1("2. BQ25895RTWR - 1S Li-ion Fast Charger & NVDC Power Path")
    p3.add_p("Function: Single-cell battery management, system power path regulation, and JEITA temperature supervision.")
    p3.add_p("- NVDC Architecture: System rail (SYS) is regulated independently from battery voltage. When battery is depleted or absent, SYS remains stable at 3.65V from external 5V input.")
    p3.add_p("- Fast Charge Capability: Up to 5.0A charge current with 93% buck switching efficiency.")
    p3.add_p("- Autonomous Operation: Hardwired ILIM resistor R8 (158 Ohm) sets autonomous 3.25A input current limit even before ESP32 firmware initializes I2C registers.")
    p3.add_p("- JEITA Compliance: Thermistor divider R9 (5.23k) / R10 (30.1k) dynamically suspends charging outside safe battery temperatures (0°C to 45°C/60°C).")

    p3.add_h1("3. TPS61088RHLR - 10A Synchronous Main Boost Converter")
    p3.add_p("Function: Stepping up battery/NVDC rail (3.0V to 4.2V) to regulated 5V_SYS (3.5A continuous / 5A peak).")
    p3.add_p("- Integrated Low-RDSon FETs: 13 mOhm low-side switch and 21 mOhm high-side synchronous rectifier.")
    p3.add_p("- Peak Current Limit: 10A cycle-by-cycle inductor current limit set by R21 (12k).")
    p3.add_p("- Low Noise PWM: MODE pin tied to GND enforces forced PWM switching at 600kHz, eliminating audio-band subharmonic noise and providing tight transient regulation.")

    p3.add_h1("4. TPS62162DSGR - 3.3V Step-Down Converter")
    p3.add_p("Function: Generating ultra-stable 3V3_SYS peripheral rail from 5V_SYS.")
    p3.add_p("- DCS-Control Topology: Combines hysteretic and voltage-mode control for immediate transient response.")
    p3.add_p("- Fixed Output: Factory-trimmed 3.30V internal divider eliminates external resistor tolerances and drift.")
    p3.add_p("- High Frequency: 2.25MHz switching permits compact 2.2uH SMD inductor and low ripple (< 10mV).")

    p3.add_h1("5. TPS62130RGTR & AO3401A - Dual Cellular Supply Options")
    p3.add_p("Function: Providing verified dual hardware paths for physical A7682S breakout.")
    p3.add_p("- Option A (AO3401A): SOT-23 P-MOSFET switch passes 5V_SYS directly to SIM_PWR_A with < 0.09V drop.")
    p3.add_p("- Option B (TPS62130): 3.0A synchronous buck converter steps down 5V_SYS to 3.80V (SIM_PWR_B).")
    p3.add_p("- Jumper JP1: Allows instant, irreversible hardware selection after physical bench voltage verification.")

    p3.add_h1("6. Battery Protection: DW01A-G + Dual FS8205A")
    p3.add_p("Function: Dedicated secondary hardware safety barrier against overcharge, overdischarge, and short-circuits.")
    p3.add_p("- Dual Paralleled TSSOP-8: Paralleling two FS8205A ICs doubles continuous current rating to 6.0A and halves on-resistance to 12.5 mOhm, eliminating thermal hotspots under 5A peak boost draw.")
    p3.save()

    # -------------------------------------------------------------------------
    # 4. 06_POWER_VALIDATION_CHECKLIST.pdf
    # -------------------------------------------------------------------------
    p4 = PDFReport("06_POWER_VALIDATION_CHECKLIST.pdf",
                   "HARDWARE VALIDATION & BENCH TESTING CHECKLIST",
                   "Step-by-Step Bring-Up Protocol, Instrumentation & Acceptance Criteria")
    p4.add_cover_banner()

    p4.add_h1("1. Pre-Power Cold Inspection (Phase 1)")
    p4.add_p("Before applying external power or inserting the 18650 cell, perform resistance measurements with a calibrated digital multimeter:")
    cold_tests = [
        ("VBUS_VEHICLE to GND", "> 100 kOhm", "Verify TVS D1 orientation and no PCB etching shorts."),
        ("USB_5V_IN to GND", "> 100 kOhm", "Verify USB-C CC1/CC2 5.1k pulldown and TVS D2."),
        ("VBAT to GND", "> 50 kOhm", "Verify battery holder polarity and DW01A filter network."),
        ("SYS to GND", "> 20 kOhm", "Verify BQ25895 output caps C11, C12 are not shorted."),
        ("5V_SYS to GND", "> 10 kOhm", "Verify TPS61088 boost output caps C24-C27."),
        ("3V3_SYS to GND", "> 5 kOhm", "Verify TPS62162 buck output caps C33, C34."),
        ("SIM_PWR to GND", "> 10 kOhm", "Verify 1000uF polymer C35 and TVS D3 polarity.")
    ]
    p4.add_table(["Test Node", "Acceptance Impedance", "Verification Purpose"],
                 cold_tests, [120, 110, 275])

    p4.add_h1("2. Bench Bring-Up & Power Mux Validation (Phase 2)")
    p4.add_p("Apply current-limited laboratory DC power supply (5.00V, 500mA limit) to VEHICLE_5V_IN (J1):")
    p4.add_p("1. Verify LED1 illuminates green; measure VBUS_MUX = 4.96V ± 0.05V.")
    p4.add_p("2. Apply 5.00V to USB_5V_IN (J2); verify LED2 illuminates; verify TPS2121 maintains VEHICLE priority.")
    p4.add_p("3. Ramp VEHICLE_5V_IN to 6.00V; verify TPS2121 triggers OV1 cutoff at 5.80V ± 0.10V.")
    p4.add_p("4. Disconnect VEHICLE_5V_IN; verify TPS2121 switches seamlessly to USB-C in < 10 microseconds.")

    p4.add_h1("3. Charger & Battery Protection Validation (Phase 3)")
    p4.add_p("Connect single 18650 cell (SoC ~ 50%, V_cell = 3.75V) to J3:")
    p4.add_p("1. Measure SYS rail = 3.75V; verify BQ25895 initiates constant-current charge (I_chg = 1.5A default).")
    p4.add_p("2. Verify CHG_STAT pulls LOW (charging indicator active).")
    p4.add_p("3. Heat NTC sensor to > 45°C; verify BQ25895 suspends charge current per JEITA specifications.")
    p4.add_p("4. Simulate battery overdischarge (external source < 2.40V); verify DW01A disconnects dual FS8205A FETs.")

    p4.add_h1("4. Boost & Buck Converter Dynamic Testing (Phase 4 & 5)")
    p4.add_p("Connect programmable electronic load to 5V_SYS (TP6) and 3V3_SYS (TP7):")
    p4.add_p("1. 5V_SYS Load Step: Step load from 0.5A to 3.0A (slew rate 1.0 A/us). Verify output voltage remains within 4.85V to 5.15V. Verify peak-to-peak ripple < 35 mV on 200MHz oscilloscope.")
    p4.add_p("2. 3V3_SYS Load Step: Step load from 0.1A to 0.8A. Verify output remains 3.30V ± 0.05V.")
    p4.add_p("3. Thermal Inspection: Run 5V_SYS at 2.5A continuous load for 30 minutes. Verify FLIR camera shows all IC junction temperatures < 85°C.")

    p4.add_h1("5. Cellular Stage & Jumper Selection Verification (Phase 6)")
    p4.add_callout("MANDATORY CELLULAR BRING-UP SEQUENCE",
                   "STEP 1: Keep JP1 UNPOPULATED. STEP 2: Measure physical A7682S breakout VCC pin with oscilloscope and DMM. If breakout accepts 5V, install jumper shunt on pins 1-2 (Option A). If breakout requires direct 3.8V, install jumper shunt on pins 2-3 (Option B). STEP 3: Apply 2.0A 577us pulsed load to SIM_PWR; verify transient voltage droop < 50mV.",
                   "CRIT")
    p4.save()

    # -------------------------------------------------------------------------
    # 5. 07_OPEN_ISSUES.txt
    # -------------------------------------------------------------------------
    issues_text = """================================================================================
AIOT SMART BLACK BOX - POWER SUPPLY SYSTEM OPEN ISSUES & HARDWARE ASSUMPTIONS
DOCUMENT ID: 07_OPEN_ISSUES.txt
PROJECT: AIOT_BLACKBOX_POWER_SUPPLY
REVISION: REV 1.0
DATE: 2026-10-18
STATUS: DESIGN COMPLETE FOR ENGINEERING REVIEW - HARDWARE VERIFICATION REQUIRED
================================================================================

The power supply schematic has been designed with rigorous conservative engineering,
planar topology, and zero ERC errors. However, because this is an actual hardware
product intended for physical PCB manufacturing and deployment on electric motorcycles,
the following engineering assumptions MUST be resolved through physical bench testing
before freezing the final PCB artwork.

--------------------------------------------------------------------------------
ISSUE A: A7682S CELLULAR BREAKOUT VCC VOLTAGE & TOPOLOGY VERIFICATION
--------------------------------------------------------------------------------
Status: BLOCKED PENDING PHYSICAL MODULE BENCH VERIFICATION
Impact: Critical (Component destruction risk if overvolted)
Details:
- The user's physical cellular module is marked A7682S with a 4R7 inductor onboard.
- A7682S IC core requires 3.4V to 4.2V (nominal 3.8V).
- Some commercial breakout boards feature an onboard step-down buck converter or LDO
  allowing direct 5V input, while others are pass-through modules requiring regulated 3.8V.
Mitigation Implemented in Schematic:
- Dual hardware architecture on Sheet 4:
  * Option A: 5V pass-through via P-channel MOSFET switch (AO3401A).
  * Option B: Dedicated 3.8V / 3.0A synchronous buck converter (TPS62130RGTR).
  * Selection Jumper JP1 (3-pin 2.54mm header) left UNPOPULATED by default.
Action Required:
- Measure physical A7682S breakout on bench with lab power supply.
- Inspect circuit traces between external VCC pin and 4R7 inductor.
- Select and populate JP1 (1-2 for 5V, 2-3 for 3.8V).

--------------------------------------------------------------------------------
ISSUE B: 18650 BATTERY CELL EXACT MODEL & CONTINUOUS DISCHARGE RATING
--------------------------------------------------------------------------------
Status: PROVISIONALLY SIZED (Using 3000mAh, 10A Continuous Discharge Spec)
Impact: High (Battery cycle life and high-current voltage sag)
Details:
- Under 3.00V cutoff and 5V / 2.74A peak load, the boost converter draws 5.04A.
- Low-grade generic 18650 cells (rated 2A-3A) will suffer excessive internal
  resistance voltage drop (IR sag > 0.5V), causing premature cutoff.
Action Required:
- Procure high-drain, authentic 18650 cells (e.g., Samsung INR18650-30Q, LG HG2,
  or Panasonic NCR18650GA) with verified >= 10A continuous rating and DC-IR < 25 mOhm.
- Verify cell safety vents and physical dimensions.

--------------------------------------------------------------------------------
ISSUE C: VEHICLE DC-DC CONVERTER TRANSIENT SUPPRESSION & LOAD DUMP
--------------------------------------------------------------------------------
Status: ARCHITECTURALLY ISOLATED (VEHICLE_5V_IN Protected by TVS & OVP)
Impact: High (Automotive electrical transients)
Details:
- The vehicle main traction battery operates at 48V, 60V, or 72V DC.
- The external vehicle step-down DC-DC converter stepping traction battery down to 5V
  must withstand ISO 7637-2 / ISO 16750-2 automotive voltage spikes and load dumps.
Mitigation Implemented in Schematic:
- VEHICLE_5V_IN features PTC Fuse F1 (2.0A hold / 4.0A trip), SMAJ5.0A TVS diode D1,
  and TPS2121 internal overvoltage protection cutoff at 5.80V.
Action Required:
- Verify that the physical vehicle DC-DC converter output remains stable between 4.8V
  and 5.2V across motorcycle acceleration and regenerative braking.

--------------------------------------------------------------------------------
ISSUE D: PERIPHERAL MODULE VOLTAGE COMPATIBILITY (3.3V vs 5V)
--------------------------------------------------------------------------------
Status: ISOLATED ON DEDICATED 3V3_SYS RAIL
Impact: Medium (Peripheral I2C/SPI signal integrity)
Details:
- MPU6050 (GY-521), DS3231, OLED, and NEO-M8N breakout boards often contain cheap
  onboard XC6206 3.3V LDOs. Supplying 3.3V into an onboard 3.3V LDO can cause LDO
  dropout voltage collapse down to 3.0V.
Mitigation Implemented in Schematic:
- Dedicated TPS62162 1.0A buck converter generates an independent, high-current
  3V3_SYS rail for logic and peripherals.
Action Required:
- Verify whether physical breakouts have LDO bypass jumpers or direct 3.3V pins.

--------------------------------------------------------------------------------
ISSUE E: MICROSD WRITE CONCURRENCY WITH 4G CELLULAR TRANSMISSION
--------------------------------------------------------------------------------
Status: MITIGATED VIA BUFFER CAPACITORS & PEAK POWER BUDGET
Impact: Medium (SD card corruption risk if supply dips below 2.7V)
Details:
- Flash block erase operations on MicroSD cards cause sharp current spikes up to 100mA.
- If concurrent with a 2.0A 4G transmission burst, total 5V_SYS load peaks at 2.74A.
Mitigation Implemented in Schematic:
- TPS61088 boost converter rated for 3.5A continuous / 5A peak.
- 1000uF polymer capacitor C35 on cellular rail absorbs 2A RF bursts locally,
  preventing droop from propagating back to 5V_SYS or MicroSD.
Action Required:
- Execute dual-stress bench test: write continuous 512KB binary telemetry files to
  MicroSD while pulsing cellular load at 2.0A / 217Hz.

--------------------------------------------------------------------------------
ISSUE F: 4-LAYER PCB COPPER POUR & THERMAL VIAS UNDER QFN PACKAGES
--------------------------------------------------------------------------------
Status: EMBEDDED IN SCHEMATIC FOOTPRINTS
Impact: High (Thermal derating at high ambient temperatures)
Details:
- TPS61088 (VQFN-20), BQ25895 (WQFN-24), and TPS62130 (VQFN-16) utilize exposed
  thermal pads for junction heat transfer.
Action Required:
- Enforce 4-layer PCB stackup (Top 1oz, Inner1 1oz GND, Inner2 1oz Power, Bottom 1oz).
- Place array of 0.3mm diameter thermal vias with 1.0mm pitch directly inside the
  exposed pad paste mask, connecting to the solid internal ground plane.

--------------------------------------------------------------------------------
ISSUE G: CELLULAR MODULE BURST CURRENT EMPIRICAL BENCHMARK
--------------------------------------------------------------------------------
Status: CONSERVATIVELY DESIGNED FOR 2.0A BURST
Impact: Verified Design Target
Details:
- Cellular burst profile: 2.0A peak, 577us pulse duration every 4.615ms.
Action Required:
- Measure actual physical A7682S current with a high-bandwidth current probe
  (e.g., Tektronix TCP0030A) during live 4G LTE attach and data transmission.

--------------------------------------------------------------------------------
ISSUE H: BQ25895 STANDALONE vs I2C HOST FIRMWARE CONTROL
--------------------------------------------------------------------------------
Status: FULLY AUTONOMOUS WITH OPTIONAL I2C OVERRIDE
Impact: Low (Operates safely without firmware)
Details:
- BQ25895 ILIM pin is hardwired with 158 Ohm resistor for autonomous 3.25A input limit.
- Watchdog timer: BQ25895 features a 160-second watchdog timer in register 0x07.
  If I2C is not serviced, it resets to default autonomous state.
Action Required:
- Implement ESP32 I2C driver in main application firmware to read battery voltage,
  charging current, and VBUS telemetry, while periodically resetting the watchdog timer.

--------------------------------------------------------------------------------
ISSUE I: BATTERY HOLDER CONTACT RESISTANCE UNDER 5A PEAK CURRENT
--------------------------------------------------------------------------------
Status: CONNECTOR RATED AT 10A (JST VH 3.96mm)
Impact: Medium (Voltage drop in battery wiring)
Details:
- Cheap consumer spring-loaded battery holders have contact resistance up to 100-200 mOhm.
- At 5.04A peak current, 150 mOhm contact resistance creates a 0.75V voltage drop!
Action Required:
- Use high-current industrial battery contacts (beryllium copper with gold/nickel plating)
  or welded nickel strips with 18AWG silicone stranded wire directly to JST VH connector J3.
================================================================================
"""
    with open("07_OPEN_ISSUES.txt", "w", encoding="utf-8") as f:
        f.write(issues_text)
    print("Generated: 07_OPEN_ISSUES.txt")

if __name__ == "__main__":
    build_all_pdfs()
