danhcln/AIOT-BLACK-BOX/builder_core.py

# -*- coding: utf-8 -*-
import os
import sys
import docx
from docx import Document
from docx.shared import Inches, Pt, RGBColor, Mm
from docx.enum.text import WD_ALIGN_PARAGRAPH
from docx.enum.table import WD_TABLE_ALIGNMENT
from docx.oxml import OxmlElement, parse_xml
from docx.oxml.ns import qn, nsdecls
from docx.opc.constants import RELATIONSHIP_TYPE

def set_cell_margins(cell, top=120, bottom=120, left=150, right=150):
    tcPr = cell._tc.get_or_add_tcPr()
    tcMar = OxmlElement('w:tcMar')
    for m, val in [('top', top), ('bottom', bottom), ('left', left), ('right', right)]:
        node = OxmlElement(f'w:{m}')
        node.set(qn('w:w'), str(val))
        node.set(qn('w:type'), 'dxa')
        tcMar.append(node)
    tcPr.append(tcMar)

def set_cell_background(cell, fill_hex):
    shading_xml = f'<w:shd {nsdecls("w")} w:fill="{fill_hex}"/>'
    cell._tc.get_or_add_tcPr().append(parse_xml(shading_xml))

def set_table_borders(table, color="D0D5DD", sz="4", val="single"):
    tblPr = table._tbl.tblPr
    borders_xml = f'''
    <w:tblBorders {nsdecls("w")}>
        <w:top w:val="{val}" w:sz="{sz}" w:space="0" w:color="{color}"/>
        <w:bottom w:val="{val}" w:sz="{sz}" w:space="0" w:color="{color}"/>
        <w:insideH w:val="{val}" w:sz="{sz}" w:space="0" w:color="{color}"/>
        <w:insideV w:val="none"/>
        <w:left w:val="none"/>
        <w:right w:val="none"/>
    </w:tblBorders>
    '''
    tblPr.append(parse_xml(borders_xml))

def add_hyperlink(paragraph, url, text, color="004B87", underline=True):
    part = paragraph.part
    r_id = part.relate_to(url, RELATIONSHIP_TYPE.HYPERLINK, is_external=True)
    hyperlink = OxmlElement('w:hyperlink')
    hyperlink.set(qn('r:id'), r_id)
    new_run = OxmlElement('w:r')
    rPr = OxmlElement('w:rPr')
    if color:
        c = OxmlElement('w:color')
        c.set(qn('w:val'), color)
        rPr.append(c)
    if underline:
        u = OxmlElement('w:u')
        u.set(qn('w:val'), 'single')
        rPr.append(u)
    new_run.append(rPr)
    text_elem = OxmlElement('w:t')
    text_elem.text = text
    new_run.append(text_elem)
    hyperlink.append(new_run)
    paragraph._p.append(hyperlink)

def add_para(doc, text="", bold_prefix="", italic=False, indent=True, align=WD_ALIGN_PARAGRAPH.JUSTIFY, space_after=4):
    p = doc.add_paragraph()
    p.alignment = align
    p.paragraph_format.line_spacing = 1.35
    p.paragraph_format.space_before = Pt(0)
    p.paragraph_format.space_after = Pt(space_after)
    if indent:
        p.paragraph_format.first_line_indent = Inches(0.3)
    else:
        p.paragraph_format.first_line_indent = Inches(0)
        
    if bold_prefix:
        r_pre = p.add_run(bold_prefix)
        r_pre.bold = True
        r_pre.font.name = "Times New Roman"
        r_pre.font.size = Pt(13)
        r_pre.font.color.rgb = RGBColor(15, 23, 42)
        
    if text:
        r_txt = p.add_run(text)
        r_txt.italic = italic
        r_txt.font.name = "Times New Roman"
        r_txt.font.size = Pt(13)
        r_txt.font.color.rgb = RGBColor(30, 41, 59)
    return p

def add_h1(doc, text):
    h = doc.add_paragraph()
    h.paragraph_format.space_before = Pt(14)
    h.paragraph_format.space_after = Pt(6)
    h.paragraph_format.keep_with_next = True
    h.paragraph_format.first_line_indent = Inches(0)
    r = h.add_run(text)
    r.bold = True
    r.font.name = "Times New Roman"
    r.font.size = Pt(16)
    r.font.color.rgb = RGBColor(15, 44, 89) # Deep Navy
    return h

def add_h2(doc, text):
    h = doc.add_paragraph()
    h.paragraph_format.space_before = Pt(10)
    h.paragraph_format.space_after = Pt(4)
    h.paragraph_format.keep_with_next = True
    h.paragraph_format.first_line_indent = Inches(0)
    r = h.add_run(text)
    r.bold = True
    r.font.name = "Times New Roman"
    r.font.size = Pt(14)
    r.font.color.rgb = RGBColor(44, 62, 80) # Slate
    return h

def add_h3(doc, text):
    h = doc.add_paragraph()
    h.paragraph_format.space_before = Pt(8)
    h.paragraph_format.space_after = Pt(3)
    h.paragraph_format.keep_with_next = True
    h.paragraph_format.first_line_indent = Inches(0)
    r = h.add_run(text)
    r.bold = True
    r.font.name = "Times New Roman"
    r.font.size = Pt(13)
    r.font.color.rgb = RGBColor(52, 73, 94) # Deep Slate
    return h

def add_bullet(doc, bold_prefix="", text=""):
    p = doc.add_paragraph(style='List Bullet')
    p.paragraph_format.line_spacing = 1.3
    p.paragraph_format.space_before = Pt(0)
    p.paragraph_format.space_after = Pt(3)
    p.paragraph_format.first_line_indent = Inches(0)
    if bold_prefix:
        r_pre = p.add_run(bold_prefix)
        r_pre.bold = True
        r_pre.font.name = "Times New Roman"
        r_pre.font.size = Pt(12.5)
        r_pre.font.color.rgb = RGBColor(15, 23, 42)
    if text:
        r_txt = p.add_run(text)
        r_txt.font.name = "Times New Roman"
        r_txt.font.size = Pt(12.5)
        r_txt.font.color.rgb = RGBColor(30, 41, 59)
    return p

def add_callout(doc, title, text):
    tbl = doc.add_table(rows=1, cols=1)
    tbl.alignment = WD_TABLE_ALIGNMENT.CENTER
    cell = tbl.cell(0, 0)
    set_cell_background(cell, "F0F4F8")
    set_cell_margins(cell, top=120, bottom=120, left=180, right=160)
    
    borders_xml = f'''
    <w:tcBorders {nsdecls("w")}>
        <w:left w:val="single" w:sz="36" w:space="0" w:color="1B365D"/>
        <w:top w:val="none"/>
        <w:bottom w:val="none"/>
        <w:right w:val="none"/>
    </w:tcBorders>
    '''
    cell._tc.get_or_add_tcPr().append(parse_xml(borders_xml))
    
    p = cell.paragraphs[0]
    p.paragraph_format.first_line_indent = Inches(0)
    p.paragraph_format.space_before = Pt(2)
    p.paragraph_format.space_after = Pt(2)
    p.paragraph_format.line_spacing = 1.25
    r_title = p.add_run(f"💡 {title}: ")
    r_title.bold = True
    r_title.font.name = "Times New Roman"
    r_title.font.size = Pt(11.5)
    r_title.font.color.rgb = RGBColor(27, 54, 93)
    
    r_text = p.add_run(text)
    r_text.font.name = "Times New Roman"
    r_text.font.size = Pt(11.5)
    r_text.font.italic = True
    r_text.font.color.rgb = RGBColor(51, 65, 85)
    
    doc.add_paragraph().paragraph_format.space_after = Pt(4)

def create_styled_table(doc, headers, data, col_widths=None):
    tbl = doc.add_table(rows=len(data) + 1, cols=len(headers))
    tbl.alignment = WD_TABLE_ALIGNMENT.CENTER
    set_table_borders(tbl)
    
    hdr_cells = tbl.rows[0].cells
    hdr_tr = tbl.rows[0]._tr.get_or_add_trPr()
    hdr_tr.append(parse_xml(f'<w:tblHeader {nsdecls("w")}/>'))
    hdr_tr.append(parse_xml(f'<w:cantSplit {nsdecls("w")}/>'))
    
    for i, title in enumerate(headers):
        cell = hdr_cells[i]
        set_cell_background(cell, "1B365D")
        set_cell_margins(cell, top=120, bottom=120, left=140, right=140)
        p = cell.paragraphs[0]
        p.alignment = WD_ALIGN_PARAGRAPH.CENTER
        p.paragraph_format.space_before = Pt(0)
        p.paragraph_format.space_after = Pt(0)
        p.paragraph_format.first_line_indent = Inches(0)
        run = p.add_run(title)
        run.bold = True
        run.font.name = "Times New Roman"
        run.font.size = Pt(11)
        run.font.color.rgb = RGBColor(255, 255, 255)
        
    for r_idx, row_data in enumerate(data):
        row_cells = tbl.rows[r_idx + 1].cells
        r_tr = tbl.rows[r_idx + 1]._tr.get_or_add_trPr()
        r_tr.append(parse_xml(f'<w:cantSplit {nsdecls("w")}/>'))
        bg_color = "F8F9FA" if r_idx % 2 == 1 else "FFFFFF"
        for c_idx, val in enumerate(row_data):
            cell = row_cells[c_idx]
            set_cell_background(cell, bg_color)
            set_cell_margins(cell, top=90, bottom=90, left=130, right=130)
            p = cell.paragraphs[0]
            p.paragraph_format.space_before = Pt(0)
            p.paragraph_format.space_after = Pt(0)
            p.paragraph_format.first_line_indent = Inches(0)
            p.paragraph_format.line_spacing = 1.2
            
            if isinstance(val, dict) and "url" in val:
                p.alignment = WD_ALIGN_PARAGRAPH.LEFT
                add_hyperlink(p, val["url"], val["text"])
            else:
                p.alignment = WD_ALIGN_PARAGRAPH.LEFT if c_idx > 0 else WD_ALIGN_PARAGRAPH.CENTER
                run = p.add_run(str(val))
                run.font.name = "Times New Roman"
                run.font.size = Pt(10.5)
                run.font.color.rgb = RGBColor(30, 41, 59)
                
    if col_widths:
        for row in tbl.rows:
            for idx, width in enumerate(col_widths):
                row.cells[idx].width = Inches(width)
                
    doc.add_paragraph().paragraph_format.space_after = Pt(4)
    return tbl

print("Base library ready. Building full document...")
